Hive-RSI-Lab/hifi-receiver/docs/known-unknowns.md

# Known unknowns: every fact the boards rely on

Generated by `python3 tools/known_unknowns.py` from the first-spin
review (docs/review-2/). `--check` fails while any fact that could stop
a board is neither verified nor resolved; run it before ordering.

**0 open** that could stop a board, of 255 facts.

## Open: could stop a board

| Key | Board | Refs | Fact | Status | Source / how | Date | Stops board |
|---|---|---|---|---|---|---|---|

## Closed or not board-stopping

| Key | Board | Refs | Fact | Status | Source / how | Date | Stops board |
|---|---|---|---|---|---|---|---|
| power:0 | both | U1 | CH224Q/A VHV abs max 32 V, OVR 32-34 V, operating 3.3-30 V | verified | WCH CH224 datasheet V2.0 sec 8.1.1/8.2.1 | 2026-10-28 | no |
| power:1 | lite-main | U1 | CH224A VBUS pin tolerant to 32 V (sec 7.1 says 3.8 V, table 8.1.1 says 32 V) | verified | WCH CH224 datasheet V2.0 (done.land mirror, fetched 2026-10-29): table 4-1 pin 8 VBUS 'needs to be shorted to VHV'; table 8.1.1 VIOHV (PG, VBUS) -0.5..32 V; reference schematic 6.1.1 ties VBUS to VHV. The 3.8 V in sect. 7.1 is in the CH224K-substitution notes and repeats the CFG1 figure: a copy error. Lite runs VBUS at 20 V (37 % under 32 V). | 2026-10-28 | yes |
| power:2 | both | U1 | CH224Q/A pinout VHV1 CFG2 2 CFG3 3 DP4 DM5 CC2 6 CC1 7 VBUS8 CFG1 9 PG10 EP GND | verified | WCH CH224 V2.0 table 4-1; netlists match | 2026-10-28 | yes |
| power:3 | both | R1, R2 | Rset 120k=20 V, 210k=28 V | verified | WCH CH224 V2.0 table 5-1 | 2026-10-28 | yes |
| power:4 | both | U1 | CH224 single-resistor mode selected by CFG1 resistor even when CFG2/CFG3 read low at boot (I2C pull-ups to unpowered +3V3) | resolved | CH224 V2.0 reference schematic 6.1.1 is this exact circuit: Rset on CFG1 with an MCU's I2C on CFG2/CFG3. Contingency on both boards: the I2C links are 0R (Lite R2/R3); depopulated, CFG2/CFG3 float on their internal pull-ups, which 6.1.1 names as the plain single-resistor case. | 2026-10-28 | yes |
| power:5 | both | U1 | CH224 behaviour when requested PDO (20 V / 28 V EPR) not offered (fallback voltage) | unverified | not in datasheet | 2026-10-28 | no |
| power:6 | lite-main | U1, Q4 | CH224A PG asserts only after contract voltage reached and deasserts during hard reset / renegotiation; PG sink current >=1 mA | resolved | Fail-safe by direction: if PG never asserts or can't sink Q4's ~0.35 mA (2.6 V/10k base + VBUS/220k), PVDD simply stays off (no amp, no damage) and firmware reports it (GPIO4 reads PG, GPIO39 reads PVDD). Firmware also drops PVDD before any renegotiation (firmware-requirements L4). Rework: short Q4's emitter pad to the adjacent GND pour. | 2026-10-28 | yes |
| power:7 | both | U1 | CH224 needs no external Rd on CC | verified | WCH CH224 V2.0 fig 6.1.1 reference schematic (no Rd) | 2026-10-28 | yes |
| power:8 | core | Q1 | AO4485 VDS -40 V, VGS +-20 V, Vth -1.7/-1.9/-2.5 V, Ciss 2500 pF, SOA fig 9/10 | verified | AOS AO4485 Rev1.1 Mar 2024 p1-4 | 2026-10-28 | yes |
| power:9 | lite-main | Q1 | UMW AO4485 clone (C5125949) matches AOS ratings/SOA | resolved | With R6 220k + C19 4.7 uF the turn-on peak is 5.8 W for a ~28 ms ramp (sim tb_lite_fw_on_20v_FIX), against the AOS AO4485 single-pulse SOA of about 25 W at 5 ms and 20 W at 10 ms that the power review read (POWER-2/4): >3x margin, so a clone with up to a third less SOA still passes. Steady state 5 A x 15 mohm = 0.38 W. | 2026-10-28 | yes |
| power:10 | both | D1 | SMBJ20A VBR 22.2-24.5 V, Vc 32.4 V; SMBJ30A VBR 33.3-36.8 V, Vc 48.4 V (MDD) | verified | Lite D1 is now SMBJ22A (BORN, LCSC C151920; 2026-10-30): BORN SMBJ series datasheet (datasheet.lcsc.com, productCode=C151920) electrical table row SMBJ22A: VRWM 22 V, VBR 24.4-26.9 V @ 1 mA, Vc 35.5 V @ 16.9 A, IR 1 uA @ VRWM. PD 20 V +5 % = 21 V sits 1 V under VRWM. Core D1 SMBJ30A unchanged (MDD table, VBR 33.3-36.8 V, Vc 48.4 V). | 2026-10-28 | no |
| power:11 | lite-main | U2 | TPS54302 VIN abs 30 V rec 28 V, VFB 0.596 V, tmin_on 110 ns, EN float = on, UVLO 4.1 V | verified | TI SLVSDG6C sec 5.1/5.5/5.6 | 2026-10-28 | yes |
| power:12 | lite-main | U2 | TPS54302 pinout GND1 SW2 VIN3 FB4 EN5 BOOT6 | verified | TI SLVSDG6C pin table; netlist matches | 2026-10-28 | yes |
| power:13 | core | U4 | SY8303 IN/EN abs 40 V, VREF 0.6 V, FS 105/R kHz, min on 80 ns, EN must not float; pinout FB1 FS2 GND3,4 IN5 LX6 BS7 EN8 | verified | Silergy AN_SY8303 Rev0.9A p2-3; netlist matches | 2026-10-28 | yes |
| power:14 | both | U3, U5 | SY8089A1 abs 6 V, rec 2.5-5.5 V, VREF 0.6 V, pinout EN1 GND2 LX3 IN4 FB5 | verified | Silergy AN_SY8089A1 Rev0.0 p2-3 | 2026-10-28 | yes |
| power:15 | both | U4, U6 | LP5907 VIN abs 6 V rec 5.5 V, Cout 0.7-10 uF, SOT-23-5 IN1 GND2 EN3 NC4 OUT5 | verified | TI SNVS798Q sec 6 | 2026-10-28 | yes |
| power:16 | lite-main | U8 | TPA3118 PVCC abs 30 V, rec 4.5-26 V | verified | TI SLOS708G (per LCSC/TI); not re-read in this pass beyond rating | 2026-10-28 | no |
| power:17 | core | U15, U16 | TPA3221 PVDD abs 37 V rec 7-32 V, UVP 6.4 V, no OVP, VDD 5 V bypass mode, no sequencing needed | verified | TI SLASEE9C sec 6.1/6.3/6.5/8.4.1 | 2026-10-28 | yes |
| power:18 | core | U3 | INA186 VCM -0.2..40 V, IN abs 42 V, VS 1.7-5.5 V, DCK pinout REF1 GND2 VS3 IN+4 IN-5 OUT6 | verified | TI SBOS318B sec 5/6.1/6.3 | 2026-10-28 | yes |
| power:19 | core | U17 | TCA9555 had internal I/O pull-ups (IIL -100 uA max); U17 is now a TCA9539 (no pull-ups, 0x74) | verified | TI SCPS200E sec 5, 7.5; SCPS202C | 2026-10-28 | yes |
| power:20 | core | Q2 | 2N7002 (JSCJ) Vth 1.0-2.5 V | verified | JSCJ 2N7002 datasheet | 2026-10-28 | no |
| power:21 | core | D2 | BZT52C33 (BORN) Vz 31-35 V @2 mA; pad 1 = cathode in SOD-123 footprint | verified | BORN BZT52 datasheet table; aiee.pretty SOD-123 silk bar at pad 1 | 2026-10-28 | no |
| power:22 | both | L5, L6, L9, L10 | SWPA4030S4R7MT Isat 2.9 A Irms 2.0 A; SWPA6045S100MT Isat 3.2 A Irms 2.45 A; SWPA4020S2R2NT Isat 3.4 A Irms 1.85 A | verified | Sunlord SWPA4030S spec Rev11 app. A; Sunlord SWPA catalog | 2026-10-28 | no |
| power:23 | both | C7, C8, C13, C14, C10, C3 | MLCC DC-bias: CL21A226MAQNNNE ~50 % at 5 V; CL31A106KBHNNNE ~35-40 % of nominal at 28 V | unverified | engineering estimate; Samsung curves not retrieved | 2026-10-28 | no |
| power:24 | core | C18 | 1 uF 0402 C52923 voltage rating on +5V | unverified | not checked | 2026-10-28 | no |
| power:25 | lite-main | J1 | HRO TYPE-C-31-M-12 rated 20 V / 5 A total VBUS | unverified | LCSC attributes only (datasheet stubbed) | 2026-10-28 | no |
| power:26 | core | J1 | GCT USB4085-GF-A rated 48 V / 5 A, VBUS pins THT | verified | GCT USB4085 drawing rev B (gct.co/files/drawings/usb4085.pdf, fetched 2026-10-30) sheet 1: 48 V DC, 5.00 A collectively for the VBUS pins, 6.25 A for GND, 1.25 A for A5/B5, 240 W. At 28 V / 5 A: 42 % voltage margin, 0 % current margin at the full 5 A PD contract (the governor holds about 1.1 A average). | 2026-10-28 | no |
| power:27 | both |  | USB PD source slew <=30 mV/us; sink cSnkBulkPd <=100 uF; attach always at vSafe5V | unverified | USB PD spec values from memory, not re-read | 2026-10-28 | no |
| power:28 | both |  | 0.3 mm via current ~1-1.5 A; IPC-2152 10 mil 1 oz external ~1 A at 10 C | unverified | brief guideline / IPC-2152 charts from memory | 2026-10-28 | no |
| power:29 | core |  | Core is ordered with 1 oz inner copper, not JLC's 0.5 oz default (35 um in the stackup; R6-M1, fab/ORDERING.md) | verified | core.kicad_pcb stackup | 2026-10-28 | no |
| power:30 | core | Q1, Q3, D5, R404 | PVDD switch Q1 turns off in ~2 ms when Q2 releases (Q3 unit 2 follower + D5 + R404), so a PD hard reset no longer sees PVDD's 940 uF through a still-on Q1: hard_reset source peak 0.7 A (was 14 A), Q1 Tj 120 C (was 426 C) | verified | hwde sim_inrush (branch 261029-050227, 311fc6d) on an electrically equal two-SOT-23 copy of the circuit: hwde's sim reads a dual transistor as unknown, so it can't model the SOT-363 itself | 2026-10-29 | yes |
| audio:0 | lite-main | U8 | TPA3118D2 DAP pin map (MODSEL1 SDZ2 FAULTZ3 RINP4 RINN5 PLIMIT6 GVDD7 GAIN8 ... BSPR30 OUTPR29) matches netlist | verified | TI SLOS708G pin functions p.3-4 | 2026-10-29 | yes |
| audio:1 | lite-main | U8, R50, R51 | TPA3118D2 gain 26 dB master = 20k to GND, 100k to GVDD; Zi 30 kohm +/-20 % | verified | SLOS708G table 1 p.14, 7.3.2 | 2026-10-29 | yes |
| audio:2 | lite-main | U8 | TPA3118D2 MODSEL low = BD, AM2..0=000 = 400 kHz, MUTE low = enabled, PLIMIT=GVDD no limit | verified | SLOS708G pin table, 6.6, 7.3.4 | 2026-10-29 | yes |
| audio:3 | lite-main | U8, R54 | TPA3118D2 SDZ input current at 3.3 V drive (only 50 uA max given) | resolved | R54 100k -> 10k: SDZ sits at 3.2 V - 50 uA x 10k = 2.7 V worst case (TI SLOS708G IIH max 50 uA) against VIH 2.0 V: 0.7 V margin. | 2026-10-29 | yes |
| audio:4 | lite-main | U8, J4 | TPA3118D2 is non-inverting INP->OUTP (absolute polarity at J4) | unverified | SLOS708G does not state polarity | 2026-10-29 | no |
| audio:5 | lite-main | U8, L1, L2, L3, L4 | TPA3118D2 OCP 7.5 A typ; min filter L under short 1 uH | verified | SLOS708G 6.3, 6.6 | 2026-10-29 | yes |
| audio:6 | lite-main | L1, L2, L3, L4 | XR0850-100M: 10 uH, 30 mohm, Isat 8 A, Irated 6.5 A; Isat definition (% drop) unknown | unverified | LCSC C48391614 listing; maker datasheet not read | 2026-10-29 | no |
| audio:7 | lite-main | C68, C69, C70, C71 | CL31B105KBHNNNE 1 uF 50 V X7R 1206 capacitance at 10 V DC (assumed -15 %) | unverified | LCSC C1848 listing; DC-bias curve not read | 2026-10-29 | no |
| audio:8 | lite-main | U7 | ES8388 QFN-28 pin map (LOUT1 12, ROUT1 11, LOUT2 15, ROUT2 14, LIN1 24, RIN1 23, LIN2 22, RIN2 21, VMID 20, ADCVREF 19, VREF 10, CE 26) matches netlist | verified | Everest ES8388 rev 5.0 p.5-6 | 2026-10-29 | yes |
| audio:9 | lite-main | U7 | ES8388 I2C address 0x10 with CE=GND | verified | ES8388 rev 5.0 sec. 5.2 (001000x) | 2026-10-29 | yes |
| audio:10 | lite-main | U7 | ES8388 ADC full scale AVDD/3.3 Vrms, input impedance 20 kohm; DAC out full scale AVDD/3.3 Vrms | verified | ES8388 rev 5.0 analog tables | 2026-10-29 | no |
| audio:11 | lite-main | U7 | ES8388 ADC input select (Reg10 LINSEL) independent of output-mix select (Reg38 LMIXSEL) | verified | ES8388 rev 5.0 6.2.2, 6.3.16 | 2026-10-29 | no |
| audio:12 | lite-main | U7 | ES8388 input pin abs-max and internal bias voltage of LIN2/RIN2 | unverified | not in rev 5.0 text | 2026-10-29 | no |
| audio:13 | both | J2, J5 | Pioneer DDJ-FLX4 MASTER out 2.1 Vrms rated into 10 kohm, output impedance <=1 kohm; true max level above rated unknown | verified | Pioneer DJ launch spec / B&H listing (web, 2026-10-29) | 2026-10-29 | no |
| audio:14 | core | U15, U16 | TPA3221 DDV pin map (VDD1 GAIN2 OTW3 FAULT4 IN1P8 IN1M9 RESET10 HEAD11 OSCM12 OSCP13 FREQ14 IN2P15 IN2M16 CMUTE17 AVDD21 GVDD22 BST/OUT/PVDD) matches symbol names | verified | TI SLASEE9C fig 5-1, table 5-1 | 2026-10-29 | yes |
| audio:15 | core | U15, U16 | TPA3221 gain/controller table: 20k/100k controller 24 dB, 75k/47k peripheral 24 dB; RIN 24 kohm | verified | SLASEE9C table 8-1, 6.5 | 2026-10-29 | yes |
| audio:16 | core | U15, U16, R216, R217, R315 | TPA3221 controller needs 47k pull-up OSCM to AVDD and 47k pull-down OSCP; peripheral FREQ_ADJ to AVDD; same-polarity OSC = peripheral 1 | verified | SLASEE9C 8.3.2, 8.3.4, 6.3 | 2026-10-29 | yes |
| audio:17 | core | U15, U16, U11 | TPA3221 inverts input to output | verified | SLASEE9C 9.2.1.2, 6.5 | 2026-10-29 | no |
| audio:18 | core | U15, U16 | TPA3221 LDO-bypass VDD/AVDD/GVDD 4.5-5.5 V; IGVDD 16 mA | verified | SLASEE9C 6.3, 6.5 | 2026-10-29 | yes |
| audio:19 | core | U15, U16 | TPA3221 OC limit 10 A typ (no min/max); min L at IOC 5 uH | verified | SLASEE9C 6.5, 6.3 | 2026-10-29 | yes |
| audio:20 | core | U15, U16 | TPA3221 thermal pad location for DDV (datasheet text says both top and bottom) | verified | TI SLASEE9C (rev. May 2025) section 5 and the pin table: the DDV PowerPAD is on the top side, 'connect to grounded heatsink'; RthJA 44.8 C/W without one (DFM-3, THERMAL-1). The 'pad on bottom' feature bullet contradicts the drawing and pin table. Handled by the lid-pressed heatsink (docs/review-2/dispositions.json THERMAL-1). | 2026-10-29 | yes |
| audio:21 | core | U15, U16 | TPA3221 single-ended gain equals differential gain (IN_M AC-grounded) | unverified | SLASEE9C table 8-1 input-level columns are inconsistent | 2026-10-29 | no |
| audio:22 | core | L1, L2, L3, L4, L5, L6, L7, L8 | PSPMAA0805-100M-ANP: 10 uH, 30 mohm, Isat 10 A, Irated 6 A; Isat definition unknown | unverified | LCSC C2962885 listing | 2026-10-29 | no |
| audio:23 | core |  | CL21B105KBFNNNE 1 uF 50 V X7R 0805 at 14 V DC (assumed -40 %) | unverified | LCSC C28323 listing; DC-bias curve not read | 2026-10-29 | no |
| audio:24 | core | U10 | ES9018K2M package QFN-28 5x5 0.5 mm, EP 3.25; PCB footprint matches | verified | ESS ES9018K2M ds v3.7 p.36-37; core.kicad_pcb U10 pads | 2026-10-29 | yes |
| audio:25 | core | U10 | ES9018K2M pin map (DACR 9, DACRB 10, DACL 13, DACLB 14, AVCC 15/16, VCCA 17, DVCC 18, DVDD 21, DATA2/1/CLK 25/26/27, RESETB 28) matches netlist | verified | ES9018K2M v3.7 p.4 | 2026-10-29 | yes |
| audio:26 | core | U10 | ES9018K2M I2C 0x48 (ADDR=0) | verified | ES9018K2M v3.7 p.27 | 2026-10-29 | yes |
| audio:27 | core | U10, Y1 | ES9018K2M max MCLK 50 MHz with internal DVDD | verified | ES9018K2M v3.7 p.9, p.31 note 2 | 2026-10-29 | no |
| audio:28 | core | U10, U11 | ES9018K2M voltage-mode output: 3.05 Vpp/leg, 1.65 V offset, 806 ohm +/-11 % | verified | ES9018K2M v3.7 p.31 | 2026-10-29 | yes |
| audio:29 | core | U10 | ES9018K2M register setup (I2S 32-bit, ASRC, soft_start, volume) works with ESP32 I2S at 50 MHz MCLK | resolved | Firmware's (C7): the register set is written over I2C after boot and can be changed by OTA; the hardware (I2S at 49.152 MHz MCLK, 1.7 % under the limit) fits ESS's documented modes. | 2026-10-29 | yes |
| audio:30 | core | U11 | OPA1678 single-supply 4.5-36 V, VCM (V-)+0.5..(V+)-2, VO within 0.8 V of rails | verified | TI SBOS855E 6.3, 6.7 | 2026-10-29 | no |
| audio:31 | core | U12 | PCM5102A pins FLT/DEMP/FMT low, SCK=GND 3-wire PLL, XSMT mute, caps 2.2 uF | verified | TI SLAS859C pin table, fig 33 | 2026-10-29 | yes |
| audio:32 | core | U12 | PCM5102A DIN on ESP32 IO12 (MTDI strap) is not pulled high at boot | resolved | PCM5102A DIN is a plain high-impedance CMOS input (TI SLAS859 pin table: no internal pull); with its +-10 uA max leakage against the ESP32's ~45k IO12 pull-down at reset, IO12 sits at <=0.45 V, under VIL 0.825 V: the strap reads low (3.3 V flash). | 2026-10-29 | yes |
| audio:33 | core | U13 | ES7243E pin map and I2C address 0x10 (0010 AD2 AD1 AD0) | verified | Everest ES7243E rev 5.0 pin table, I2C section | 2026-10-29 | yes |
| audio:34 | core | U13 | ES7243E can run with MCLK pin grounded, clock from SCLK (MCLK_SEL) | resolved | ES7243E BCLK-as-MCLK (register 0x02 bit 7) is set by firmware (C10). If it didn't work, only the line-in/self-measurement ADC would be lost; streaming to the DAC and amps doesn't use it. Bring-up checks the ADC first thing. | 2026-10-29 | yes |
| audio:35 | core | U13 | ES7243E full scale 1 Vrms, input 8 kohm at 0 dB PGA (per pin vs differential unclear) | unverified | ES7243E rev 5.0 analog table | 2026-10-29 | no |
| audio:36 | core | U14 | TS5A23157 pin map, function table (IN H = NO), VIH 0.7*V+, range 0..V+ | verified | TI SCDS165F pin functions, 6.5, table 1 | 2026-10-29 | yes |
| audio:37 | core | Q6 | S8050 Q6 SOT-23 pin order B/E/C matches symbol | verified | Parts review (docs/review-2/parts.md, 2026-10-29): every SOT-23 transistor checked datasheet pin -> symbol -> pad; S8050 (C2146) B=1, E=2, C=3 matches. | 2026-10-29 | yes |
| audio:38 | core | U1 | CH224 PD fallback to 20 V when 28 V EPR is unavailable (sets amp headroom) | unverified | power reviewer | 2026-10-29 | no |
| audio:39 | both |  | Loopback taps not yet in the schematics (reviewed from remote.md design text) | unverified | remote.md 'The board measures its own output' | 2026-10-29 | no |
| digital:0 | core | U17 | TCA9555 has 100k internal pull-ups and all P-ports are inputs at POR; no RESET pin | verified | TI SCPS200E s5, Fig 23, pin table | 2026-10-28 | yes |
| digital:1 | core | U17 | TCA9539 is pin-compatible with TCA9555 except pin 3 = RESET; no pull-ups; address 0x74-0x77 | verified | TI SCPS202C pin table, s8.3.2, Table 2 | 2026-10-28 | no |
| digital:2 | core | Y1, Y2 | YSO110TR OE: enable >=70% VDD or floating, disable <=30% VDD, start-up 3 ms max; internal OE pull-up value | resolved | R45 is now 2.2k: OE stays under 30 % VDD (0.99 V) against any internal OE pull-up of 5.1k or more (oscillator OE pull-ups are typically ~100k); the TCA9539 that drives it has no pull-up and resets with EN. Bring-up scopes IO0 at EN rise. | 2026-10-28 | yes |
| digital:3 | both | U5, U7 | ESP32 straps latched at system reset; GPIO0=0 & GPIO2=0 = download; tH >= 1 ms | verified | ESP32-WROVER-E datasheet v2.4 s4 Tables 4-6 | 2026-10-28 | yes |
| digital:4 | core | U13 | ES7243E default slave (reg0x00 MSC=0); MCLK can be derived from BCLK (reg0x02 bit7); I2C address 0x10 with AD2..0 = 0 | verified | Everest ES7243E datasheet rev 2.0 (June 2019) s4, s7 reg 0x00/0x02 | 2026-10-28 | no |
| digital:5 | core | U10 | ES9018K2M I2C address 0x48 (ADDR=0), DATA_CLK=BCK, DATA1=LRCK, DATA2=SDATA, MCLK > 192*FSR | verified | ESS ES9018K2M datasheet v3.7 (2021-04-22) | 2026-10-28 | yes |
| digital:6 | both | U1 | CH224Q/CH224A 7-bit I2C address 0x22 or 0x23; I2C active in single-resistor (CFG1) mode; CFG2/CFG3 internal pull-ups, 3.3/5 V tolerant | verified | WCH CH224 datasheet v2.1 s5.2.3, pin table | 2026-10-28 | no |
| digital:7 | both | U6, U8 | CH340C at 3.3 V: V3 tied to VCC; D+/D- direct, no series resistor | verified | WCH CH340 datasheet V3D pin table and s5 | 2026-10-28 | no |
| digital:8 | core | U9 | LAN8720A straps: PHYAD0 PD (addr 0), REGOFF PD (regulator on), nINTSEL PU (REF_CLK in), MODE[2:0] PU = 111; tpurstd 25 ms; CLKIN +/-50 ppm, 150 ps p-p jitter | verified | Microchip DS00002165B pin tables, Table 5-8, REF_CLK IN timing | 2026-10-28 | yes |
| digital:9 | both | U5, U7 | ESP32 GPIO36/39 80 ns pull-down glitch on ADC power-up | verified | ESP32 errata v3.1 s3.12 [GPIO-3.11] | 2026-10-28 | no |
| digital:10 | core | U15, U16 | TPA3221 RESET VIH 1.9 V / VIL 0.8 V, so the 1.65 V TCA9555 divider is undefined | verified | TI SLASEE9C (May 2025) electrical characteristics | 2026-10-28 | no |
| digital:11 | core | U17 | LCSC part number for TCA9539PWR | unverified |  | 2026-10-28 | no |
| digital:12 | both | U5, U7 | squeezelite.bin 2.69 MB / recovery.bin 1.38 MB (IDF 4.4.8 build) image sizes | unverified | firmware/README.md l.65 on origin/hive/261028-165619-70c34f28b3 (claim, not rebuilt by me) | 2026-10-28 | no |
| digital:13 | core | U10 | ES9018K2M GPIO2 can be a static output (reg 8 gpio2_cfg 4'd7/4'd15), tri-stated while RESETB low; VOH >= DVCC-0.2 at 100 uA | verified | ESS ES9018K2M datasheet v3.7 (2021-04-22) Register #8, Standby Mode, DC characteristics | 2026-10-28 | no |
| digital:14 | core | U14 | TS5A23157 VIH = 0.7*V+ (3.5 V at 5 V supply) | verified | TI SCDS165F (Jan 2019) electrical characteristics, 5-V supply | 2026-10-28 | no |
| digital:15 | core | U10 | ES9018K2M register access over I2C requires MCLK running | unverified | community reports; not stated in ds v3.7 | 2026-10-28 | no |
| digital:16 | both | U6, U8 | CH340B SOP-16 pinout: 7 = RST# (internal pull-up), 8 = NC, 15 = TNOW output; otherwise = CH340C; no crystal | verified | WCH CH340 datasheet V3D s4, s5.1 | 2026-10-28 | yes |
| digital:17 | both | U6, U8 | C81010 is CH340B SOP-16 (stock 4627); C84681 CH340C stock 109248 | verified | LCSC wmsc product API 2026-10-28 | 2026-10-28 | no |
| digital:18 | both | Q2, Q3, Q4, Q5 | Auto-program circuit (DevKitC cross-coupled NPNs) wired correctly on both boards | verified | lite-main.net, core.net vs Espressif DevKitC schematic topology | 2026-10-28 | yes |
| digital:19 | both | C22, C32 | ESP32 EN recommended RC 10k/1uF; VIL_nRST 0.6 V, VIH_nRST 0.75 VDD, tSTBL/tRST 50 us | verified | ESP32 Series datasheet v5.3 Table 2-4, Table 5-3 | 2026-10-28 | no |
| digital:20 | lite-main | U5 | Lite firmware pin map (dac_config, buttons, IR, LED, PD_PG 4, PVDD_EN 18, SDZ 21, FAULTZ 23, ADC GPIO34) matches lite-main.net | verified | firmware branch 261028-165619 hifi_board.h + patch Kconfig vs lite-main.net | 2026-10-29 | yes |
| digital:21 | lite-main | U7, U5 | squeezelite-esp32 ee1720c supports ES8388 model and MCLK on GPIO0 from APLL (use_apll=true) | verified | github sle118/squeezelite-esp32@ee1720c components/squeezelite/output_i2s.c l.302, l.363-370; README l.206-210 | 2026-10-29 | yes |
| digital:22 | lite-main | U7 | ES8388 7-bit I2C address 0x10 with CE=GND | verified | Everest ES8388 datasheet rev 5.0 (July 2018) sect. 5.2: 2-wire chip address 001000x, x = AD0 (the CE pin): 0x10 with CE (pin 26) on GND, as Lite wires it. Fetched 2026-10-29. | 2026-10-29 | yes |
| digital:23 | lite-main | U8 | TPA3118 SDZ VIH 2 V, IIH <= 50 uA, slew <= 10 V/ms | verified | TI SLOS708G s6.1, s6.3 | 2026-10-29 | yes |
| digital:24 | lite-main | U9 | IRM-3638T supply range 2.7-5.5 V | unverified | LCSC C42421366 has no datasheet link; inferred from IRM-H638T (C91447, 2.7-5.5 V) | 2026-10-29 | no |
| digital:25 | both | U5, U7 | WROVER-E N8R8 flash/PSRAM 3.3 V; MTDI internal pull-down, so VDD_SDIO 3.3 V | verified | ESP32-WROVER-E ds v2.4 Table 1, Table 4; ESP32 ds v5.3 s3.2 | 2026-10-29 | yes |
| digital:26 | core | U7, U9 | ESP32 EMAC fixed pins TXD0 19, TX_EN 21, TXD1 22, RXD0 25, RXD1 26, CRS_DV 27, REF_CLK GPIO0 (in) match core.net | verified | squeezelite README@ee1720c l.506-518; ESP32-WROVER-E ds v2.4 pin table (EMAC_RX_DV on IO27) | 2026-10-29 | yes |
| digital:27 | core | U7 | squeezelite-esp32 supports LAN8720 RMII, pca9535-class expanders (buttons, rotary, outputs), generic I2S + dac_controlset; no line-in capture; one I2S data output | verified | squeezelite-esp32@ee1720c README l.21-23, 204-228, 323-341, 504-526; output_i2s.c; gpio_exp.c l.114 | 2026-10-29 | no |
| digital:28 | core | J3 | squeezelite display_config accepts cs=-1 | unverified | README l.261 shows cs as mandatory | 2026-10-29 | no |
| digital:29 | core | U17 | squeezelite eth rst on an expander GPIO is not supported | verified | README@ee1720c l.341 | 2026-10-29 | no |
| digital:30 | core | J3 | Front-panel FFC carries IR_IN, I2C, EXP_INT, ENC_A/B: panel contents (extra IR receiver, I2C devices/pull-ups) unknown | verified | boards/ultra-front/README.md: the panel carries one TCA9535 (0x27) for the knob, buttons, LCD reset and RGB LED, its own IR receiver on IR_OUT (10 k pull-up there), INT open-drain with a 10 k pull-up there, ENC_A/B with 10 k + 10 nF; I2C pull-ups are on the core. | 2026-10-29 | no |
| digital:31 | core | U12 | PCM5102A PLL BCK ratios 32/48/64 fs with SCK grounded | unverified | TI SLAS859 (not re-read this session) | 2026-10-29 | no |
| digital:32 | both | U5, U7 | WROVER-E antenna region about 7 mm at the pin-1 end of the 31.4 mm module; Espressif clearance rules (overhang, or <=1 mm inset and >=15 mm cleared along the edge; 15 mm to the housing) | verified | ESP32-WROVER-E ds v2.4 Fig 5/s10.1; ESP Hardware Design Guidelines ESP32 (release master) s1.4.8 Fig 23, 25 | 2026-10-29 | yes |
| digital:33 | both | U5, U7 | core has copper under the antenna on all 4 layers; lite has none (ANT_KEEPOUT) | verified | pcbnew 10.0.6 zone-fill sampling of lite-main.kicad_pcb and core.kicad_pcb | 2026-10-29 | yes |
| digital:34 | core | U7 | ESP32 EMAC RMII input setup/hold times | unverified | not published in ESP32 datasheet v5.3 | 2026-10-29 | no |
| digital:35 | core | U9 | LAN8720A RMII output clock-to-out min about 2 ns | unverified | DS00002165B RMII timing table (not re-extracted) | 2026-10-29 | no |
| digital:36 | core | J3 | Front-panel I2C load (devices, pull-ups, capacitance) on J3 | verified | boards/ultra-front/README.md: one I2C device on the panel (TCA9535 at 0x27), no pull-ups there (the core's), over a 30-50 mm FFC: a few pF added to the bus. | 2026-10-29 | no |
| digital:37 | both | U1 | CH224 CFG2/CFG3 internal pull-up rail voltage | unverified | CH224 ds v2.1 says 3.3/5 V input tolerant, rail not stated | 2026-10-29 | no |
| digital:38 | core | U19 | PLR237/T8BK supply range and output level at 3.3 V | verified | Everlight PLR237/T8BK DPL-0000262/263 Rev.1 (everlighteurope.com, fetched 2026-10-30) p1-2: operates at 2.4-5.5 V, recommended Vcc 3.0-5.5 V, TTL-compatible output (Vout max Vcc+0.3), so at OPT_VCC = 3.3 V the output swings to 3.3 V into the ES9018K2M GPIO; 10 % margin at the 3.0 V floor. | 2026-10-29 | no |
| digital:39 | core | U18 | IRM-H638T 2.7-5.5 V, 1.2 mA | verified | LCSC C91447 product data (Everlight DMO-0000008) | 2026-10-29 | no |
| digital:40 | core | U2 | USBLC6-2SC6 pinout 1/6 I/O1, 3/4 I/O2, 2 GND, 5 VBUS | unverified | ST USBLC6-2 datasheet (not re-read; matches the common pinout) | 2026-10-29 | no |
| digital:41 | core | Y1, Y2 | YXC OT322550MJBA4SL 50 MHz +/-10 ppm CMOS 1.8-3.3 V, pin 1 OE, pin 3 OUT | verified | LCSC C717684 + YXC YSO110TR datasheet p1-2 | 2026-10-29 | yes |
| thermal:0 | core | U15, U16 | TPA3221DDV (C475500) thermal slug is on the TOP of the package | verified | True of the TPA3221 (SLASEE9C sec 5). The board now carries the TPA3220DDW (C2879306), whose pad is on the bottom (SLASEN3B sec 6, pin table), so the top-slug problem is gone (task 261029-075354). | 2026-10-28 | yes |
| thermal:1 | core | U15 | TPA3221 RthetaJA 44.8 C/W (JEDEC 2s2p, no heatsink), RthetaJC(top) 1.1, psiJB 14.7, 5.5 C/W to 85 C heatsink | verified | TI SLASEE9C 6.4 p6 | 2026-10-28 | yes |
| thermal:2 | core | U15 | TPA3221 OTW 115/125/135 C, OTE 145/155/165 C, OTE latched (RESET toggle) | verified | TI SLASEE9C 6.5 p9, 8.4.5.5 | 2026-10-28 | yes |
| thermal:3 | core | U15, U16 | Thermal resistance of a 19x12x25 mm finned heatsink in the (not yet designed) core enclosure ~20-25 C/W | resolved | Moot: there is no heatsink since the TPA3220 swap (task 261029-075354). The board's ~26 C/W is the figure, and bring-up C3 measures it. OTW (P11), FAULT (P10) and the ISENSE governor (C2) still bound a hot amp. | 2026-10-28 | yes |
| thermal:4 | core | U15, L1, L2, L3, L4 | TPA3221 chip loss split from fig 6-9 system loss (inductor share ~1.5 W at 20 W out) | resolved | Covered by the same OTW/governor backstop (thermal:3); the governor limit (30 W in per chip) holds chip loss to ~3 W whatever the split. | 2026-10-28 | yes |
| thermal:5 | lite-main | U8 | TPA3118D2 DAP RthetaJA 22 C/W on TPA3118D2EVM; psiJB 4.7; thermal trip 150+ C, 15 C hysteresis, OTP latched | verified | TI SLOS708G 6.4, 6.6, 7.3.8 table | 2026-10-29 | yes |
| thermal:6 | lite-main | U8 | TPA3118D2EVM is a 2-layer board with ~32 thermal vias | verified | TI SLOU342A sec 3.2 figs 4-5 (layer count); via count read from the image, approximate | 2026-10-29 | no |
| thermal:7 | lite-main | U8 | TPA3118D2 DAP exposed pad 2.46-3.04 x 3.16-3.74 mm fits the 3.81x3.71 land; paste 4x1.4x1.4 mm | verified | TI SLOS708G DAP0032C drawing; lite-main.kicad_pcb | 2026-10-29 | yes |
| thermal:8 | lite-main | U8 | Lite U8 thetaJA in the box 25-30 C/W (16 vias, 1 oz 2-layer) | resolved | Margin holds even at hwde's pessimistic 47 C/W: 1.75 W at 1/8 power into 4 ohm gives Tj = 45 + 82 = 127 C, 23 K under the 150 C trip (reviewer's own estimate 94-106 C). Above that, the firmware governor (firmware-requirements L1) and the chip's own latched OTP with FAULTZ recovery (L2) protect it: the failure mode is a mute, not damage. Bring-up measures the case temperature at 1/8 power. | 2026-10-29 | yes |
| thermal:9 | lite-main | U8 | TPA3118D2 chip loss 1.75 W at 1/8 P 4 ohm, 20 V | unverified | SLOS708G fig 16 is at 24 V; 20 V interpolated | 2026-10-29 | no |
| thermal:10 | core | U15 | TPA3221 idle: PVDD 11 mA AD at 28 V, GVDD 16 mA, AVDD 10 mA | verified | SLASEE9C 6.5 p7, fig 6-16 | 2026-10-29 | no |
| thermal:11 | core | U15, U16 | Core box air temperature (enclosure not designed) | resolved | The Plus/Ultra enclosure is designed (enclosure/, vents over and under each amp). With the TPA3220 the board sheds the amps' heat into that air. 45 C box air is the design case, and bring-up C3 measures it. The OTW/governor backstop applies. | 2026-10-29 | yes |
| thermal:12 | lite-main |  | Lite box internal air rise 22 K at 1/8 P (G = 0.16 W/K) | unverified | my wall/vent model, +/-30 %; measure with a probe | 2026-10-29 | no |
| thermal:13 | lite-main | U2 | TPS54302 RthetaJA 118.9 C/W, TJ 125 C | verified | TI SLVSDG6C 5.4 | 2026-10-29 | no |
| thermal:14 | core | U4 | SY8303 thetaJA 60.2 C/W, TJ 150 C, Vin 4.5-40 V, RDS 110/70 mohm | verified | Silergy SY8303 datasheet (LCSC C97054) abs max, elec. char. | 2026-10-29 | no |
| thermal:15 | both | U3, U5 | SY8089 thetaJA 120 C/W, TJ op 125 C | verified | Silergy SY8089A1 datasheet (LCSC C479074) | 2026-10-29 | no |
| thermal:16 | both | U4, U6 | LP5907 DBV RthetaJA 193.4 C/W, TJ op 125 C | verified | TI SNVS798Q 5.4 | 2026-10-29 | no |
| thermal:17 | both | U4, U6 | LP5907 +3V3A load currents (ES8388 ~25 mA; ES9018K2M/ES7243E ~50 mA) | unverified | not computed from codec datasheets in this review | 2026-10-29 | no |
| thermal:18 | core | U4 | SY8303 5 V load 0.35 A avg / 0.6 A peak | unverified | my estimate; power reviewer's budget | 2026-10-29 | no |
| thermal:19 | both | Q1 | AO4485 RDS(on) 12.5 mohm @-10 V (UMW C5125949); 15 max @25 C, 23 max @125 C (AOS C51499); RthetaJA 75 C/W steady | verified | LCSC C5125949 record; AOS AO4485 DS | 2026-10-29 | no |
| thermal:20 | lite-main | Q1 | Lite Q1 VGS = -6.25 V at 20 V (R5 100k / R6 220k) | verified | root.py values, divider calc | 2026-10-29 | no |
| thermal:21 | core | Q1 | Core Q1 VGS = -14 V at 28 V (R4/R5 100k, D4 15 V) | verified | blocks.py values | 2026-10-29 | no |
| thermal:22 | core | R1 | R1 RLP25FEGR010 2512 rated 3 W | verified | LCSC C393070 (TA-I) | 2026-10-29 | no |
| thermal:23 | lite-main | L1, L2, L3, L4 | XR0850-100M Irms 6.5 A at dT~40 C, Isat 8 A, DCR 30 mohm, part temp <=125 C | verified | XR XR0850 DS notes 3,5 (LCSC C48391614) | 2026-10-29 | no |
| thermal:24 | core | L1, L2, L3, L4 | PSPMAA0805-100M Irms 6 A at dT~40 C, Isat 10 A, DCR 30 mohm | verified | PROD PSPMAA DS / LCSC C2962885 | 2026-10-29 | no |
| thermal:25 | core | L1, L2, L3, L4 | Output inductor core loss at 600 kHz AD-mode ripple | unverified | not in datasheet | 2026-10-29 | no |
| thermal:26 | lite-main | C58 | C58 MA35V470M10X13 3.8 A@100 kHz, 16 mohm, 2000 h@105 C | verified | JIERR DS / LCSC C46550472 | 2026-10-29 | no |
| thermal:27 | lite-main | C59 | C59 RVT 220 uF 35 V 195 mA@120 Hz, 2000 h@105 C, ESR not specified | verified | KNSCHA RVT spec (LCSC C2836441) | 2026-10-29 | no |
| thermal:28 | core | C5, C6, C311 | C5/C6 Rubycon 50PX470MEFC10X20: 600 mA@120 Hz, x1.20 at >=10 kHz, tan d 0.10, 2000 h@105 C | verified | Rubycon PX DS (LCSC C88733) | 2026-10-29 | no |
| thermal:29 | both | C58, C5, C6 | PVDD ripple current estimate (Iout,rms x sqrt(1-0.75 m^2) per BTL channel; 0.5 only at full swing) and its split between ceramics and bulk (docs/review-6/c5c6_ripple.py) | unverified | approximation; SPICE of the amp's PVDD current not run | 2026-10-29 | no |
| thermal:30 | lite-main | D1 | SMBJ20A leakage at 21 V and 60 C | resolved | Fixed in the design 2026-10-30: D1 SMBJ22A (VRWM 22 V), so the 21 V worst-case rail is below standoff and IR <= 1 uA at 25 C (BORN table); the SMBJ20A's above-VRWM leakage question no longer arises. | 2026-10-29 | no |
| thermal:31 | both | U5, U7 | ESP32-WROVER-E-N8R8 -40..85 C ambient | verified | LCSC C2973667 record (Espressif) | 2026-10-29 | no |
| thermal:32 | both | U6, U8 | CH340C operating -20..70 C | verified | WCH CH340 DS operating temperature table (LCSC C84681) | 2026-10-29 | no |
| thermal:33 | lite-main |  | PETG Tg ~80 C, PLA softening 55-60 C | unverified | general material data, not a filament datasheet | 2026-10-29 | no |
| thermal:34 | core | U15, U16 | Heatsink part fitting 19x12 mm with RthetaSA <=20 C/W | resolved | Resolved (task 261029-075354, issue #47): U15/U16 are now the pin-identical pad-down TPA3220DDW (C2879306; TI SLASEN3B table 5 'TPA3221 ... Top ... Y'). Its EP is soldered to GND on a 7.3 x 4.43 mm land with 15 x 0.3 mm vias into In1/B.Cu, so nothing is fitted by hand. On-board RthJA is about 26 C/W (JEDEC 23.5), so 1/8 power into 8 ohm runs at Tj about 84 C. Into 4 ohm, the C2 governor holds the chip near 2.5 W (16 W in, 60 s). LCSC stock is 0, so it is bought into the JLC inventory from Mouser/DigiKey (fab/prebuy.csv). See docs/review-2/heatsink-options.md. | 2026-10-29 | yes |
| thermal:35 | core | U15 | TPA3220DDW pin-compatible pad-down alternative | verified | SLASEE9C table 4 (pin-compatible Y, pad bottom); LCSC C2879306 stock 0 on 2026-10-28 | 2026-10-29 | no |
| thermal:36 | core | U15, U16 | TPA3220 RthetaJA 23.5 C/W (JEDEC 2s2p, pad soldered), RthetaJC(bot) 1.1, RthetaJB 4.5, psiJB 4.5; OTW 115/125/135 C, OTE 145/155/165 C | verified | TI SLASEN3B 7.4, 7.5 | 2026-10-29 | yes |
| thermal:37 | core | U15, U16 | On core (1 oz / 0.5 oz) the TPA3220's RthetaJA is about 26 C/W. In the vented Plus/Ultra box (air ~58 C at 30 C room, hwde check_thermal) each chip holds ~2.0 W at Tj 110 C: Plus (one channel per chip) 9.6 W/ch into 4 ohm and 14.8 W/ch into 6 ohm sustained, Ultra both zones 4.4 W/ch into 4 ohm; the C2 governor holds it (Plus 19 W, Ultra 9/17 W over 60 s) | unverified | estimate: JEDEC 23.5 C/W +10 % for thinner copper and a shared board (docs/review-2/heatsink-options.md); bring-up C3 measures it; OTW/FAULT and the governor backstop it | 2026-10-29 | no |
| dfm:0 | both | J2, J3, J4, J5 | XDJK-0271-1650 pin hole positions match EasyEDA land pattern (pins 1/3 rows 0.8 mm apart) | resolved | Pins 1/3 are now 1.6 x 2.4 mm plated slots centred between the two readings of the drawing (0.28 mm to spare at the pin corners either way), legs 2.0 x 3.0 as drawn, on both boards. | 2026-10-28 | yes |
| dfm:1 | both | J2, J3, J4, J5 | XDJK-0271-1650 needs 2 post holes 2.0x3.0 | verified | Lian Xin A-AV2-7A1 '2-2X3' | 2026-10-28 | yes |
| dfm:2 | core | U15, U16 | TPA3221 DDV thermal pad is on top and needs a grounded heatsink | verified | True of the TPA3221, which the board no longer uses. U15/U16 are the TPA3220DDW, with the pad on the bottom (SLASEN3B pin table: 'PowerPad ... Placed on bottom side of device'). It is soldered to GND with no heatsink (task 261029-075354). | 2026-10-28 | yes |
| dfm:3 | core | U18 | IRM-H638T pinout 1 GND,2 GND,3 OUT,4 Vcc; top-looking lens | verified | Everlight DMO-0000008 rev3 p1,p6 | 2026-10-28 | no |
| dfm:4 | core | U18 | Plus enclosure lid height above U18 | unverified | no core enclosure in enclosure/ | 2026-10-28 | no |
| dfm:5 | both | J1 | USB4105 footprint matches GCT USB4105 rev B4 layout (pegs, tabs, pads, 4.18/3.68) | verified | GCT USB4105 drawing rev B4 18/12/23 + KiCad lib | 2026-10-28 | yes |
| dfm:6 | core | J1 | USB4085 recommended layout: 0.40 drill/0.65 pad, 0.85 pitch, rows 1.35, shell 8.65, edge 1.74 from rear slots | verified | GCT USB4085 rev B 28/02/23 sheet 2 | 2026-10-28 | yes |
| dfm:7 | core | J1 | USB4085 new footprint as drawn by the worker | verified | GCT USB4085 drawing rev B (gct.co/files/drawings/usb4085.pdf, fetched 2026-10-30) sheet 2 against core.kicad_pcb J1, pad by pad: A row A1 A4..A9 A12 and B row B12 B9..B4 B1 (B12 under A1) 1.35 apart at 0.85 pitch, within 0.005 mm of the drawing; shell slots 0.6x2.1 / 0.6x1.4 in 0.9x2.4 / 0.9x1.7 at +-4.325, the long pair 0.98 from the A row and the short pair 3.38 behind it; the board edge (x 34.587) sits exactly 1.74 mm from the short pair's centres (x 36.327), as drawn. Not mirrored: A1 left with the mouth down, as the drawing's component-side view. Nets as sheet 1: VBUS A4 A9 B4 B9, GND A1 A12 B1 B12 and shell, CC1 A5, CC2 B5, D+ A6 B6, D- A7 B7, SBU open. Only the pads differ, 0.70 for 0.65, on purpose (DFM-6). | 2026-10-28 | yes |
| dfm:8 | lite-main | J1 | HRO TYPE-C-31-M-12 layout: pads 1.15 long y-1.64..-0.50 from pegs, pegs 0.60 at +-2.89, slots 0.6x1.7/0.6x1.4 4.18 apart, edge 5.79 from pegs | verified | HRO drawing rev A 2020-12-08 | 2026-10-28 | yes |
| dfm:9 | lite-main | J1 | HRO TYPE-C-31-M-12 new footprint as drawn by the worker, and its CPL rotation | resolved | Lite J1 HRO TYPE-C-31-M-12 (C165948): footprint from EasyEDA (lib_pull 2026-10-29), its VBUS/GND pads redrawn as plain 0.6 x 1.3 mm rectangles (EasyEDA's 0.1 mm stroke left a 0.1 mm VBUS-GND gap) and its signal pads trimmed to 1.13 mm at the tail end (the USB4105's inner edge); shell legs 0.8 mm slots as HRO draws them. CPL: hwde cpl_verify against the LCSC model passes in the dfm gate (2026-10-29), no offset warning. | 2026-10-28 | yes |
| dfm:10 | core | J1 | JLC can assemble USB4085 (THT) - hand/selective solder, per-joint fee | unverified | JLC THT assembly service; part listed Plugin/Extended stock 2623 (parts_search 2026-10-29) | 2026-10-28 | no |
| dfm:11 | both | U6, U8 | CH340B EasyEDA model pin1/centre same as CH340C -> CPL rotation unchanged | verified | EasyEDA C81010 vs C84681 models fetched 2026-10-29 | 2026-10-28 | yes |
| dfm:12 | both |  | JLC capabilities (via, annulus, slot, mask bridge, silk, edge, panel) | verified | jlcpcb.com/capabilities/pcb-capabilities fetched 2026-10-28 | 2026-10-28 | no |
| dfm:13 | both |  | Min mask web Lite 0.20 / core 0.176 vs JLC 0.10 | verified | own Gerber read sims/dfm/gerb.py | 2026-10-28 | no |
| dfm:14 | both |  | ENIG surcharge for these sizes | unverified | JLC quote page not fetched | 2026-10-28 | no |
| dfm:15 | core | U19 | PLR237/T8BK footprint: 3x0.80 at 2.54, 2x1.10 at 5.08 (2.63), 2x1.70 posts at 5.60 (2.61) | verified | Everlight DPL-0000263 rev1 p5 | 2026-10-28 | yes |
| dfm:16 | core | U19 | TOSLINK port faces the top edge and NC row is nearer the front (physical pin orientation) | verified | Everlight PLR237/T8BK DPL-0000262/263 Rev.1 (everlighteurope.com, fetched 2026-10-30) p5 (third-angle views: the top view above, the port at the left of the right view): the posts are 5.88 from the port face, then 2.61 to the NC row and 2.63 to the signal row. On core U19 (rot 180) the port faces the top edge (the rear panel), the post holes and NC row sit between it and the signal row, and the port face lands at y 121.397, 0.70 mm inside the edge, as enclosure/core.board.json has it. | 2026-10-28 | yes |
| dfm:17 | core | J2 | HR911105A footprint matches HanRun layout (pegs 3.25, shield 1.63, signal 0.89, LED 1.02, 11.43/15.49/13.25 spacing) | verified | HanRun HR911105A rev A/2 p3 | 2026-10-28 | yes |
| dfm:18 | core | J6 | KF301-5.0 rating 300V/16A UL, 22-14 AWG | verified | KEFA KF301-5.0 rev A | 2026-10-28 | no |
| dfm:19 | both | J4 | DB128V-5.08 rating 300V/16A UL, 12-22AWG, hole 1.6 | verified | Dorabo DB128V-5.08 T0-1 | 2026-10-28 | no |
| dfm:20 | both | U9 | IRM-3638T pinout 1 OUT 2 GND 3 Vcc | verified | Everlight DMO-0000371 rev4 p1 | 2026-10-28 | yes |
| dfm:21 | both | SW1 | TS-1187A pad pattern x+-3.0 y+-1.875, A-B and C-D common, H1.5 | verified | XKB TS-1187A-X-X-X A0 | 2026-10-28 | yes |
| dfm:22 | both | SW1 | EC11 layout A-C-B 2.5 pitch, D-E 5.0, rows 7.5/7.0 from shaft | verified | Alps EC11 catalogue p279 | 2026-10-28 | no |
| dfm:23 | lite-main | U9 | IRM-3638T lens faces the front edge on Lite | unverified | enclosure README claim; no dimension page | 2026-10-28 | no |
| dfm:24 | core | J3 | FFC FPC-05F-20PH20 land pattern vs maker drawing and pin-1/contact side | verified | XunPu drawing FPC-05F-NPH20 rev A (file.huaqiu.com/web2/M00/4C/A2/pYYBAGKwU4iATiB-AADmFDwz97g598.pdf, the series drawing for this part, fetched 2026-11-02) recommended land pattern against core J3 and ultra-front J1, which are the same footprint: pads 0.30 x 1.25 at 0.50 pitch (board 0.3 x 1.25, 0.5); tabs 2.00 x 2.50 (board 2 x 2.5); outer tab edge to pad 1's centre 2.69 (board 7.44 - 4.75); 0.70 from the pad row to the tabs (board 0.705). The drawing numbers the FFC's circuit 1 only, not the socket's pins, but the socket has no polarity of its own: pin N is position N, and parts:64 covers the mapping through the cable. | 2026-10-28 | no |
| dfm:25 | both |  | JLC THT per-joint fee and extended-part loading fee | unverified | not fetched | 2026-10-28 | no |
| dfm:26 | core | U10, U19 | ES9018K2M stock 706, PLR237/T8BK stock 236 (2026-10-29) | verified | parts_search live 2026-10-29 | 2026-10-28 | no |
| dfm:27 | lite-main | H1, H2, H3, H4, J1, J2, J3, J4, U9, SW1, SW2, SW3, D2 | Enclosure board snapshot matches current Lite PCB for holes/connectors/switches/LED/IR | verified | own diff of enclosure/lite-main.board.json vs lite-main.kicad_pcb, 2026-10-29 | 2026-10-28 | no |
| dfm:28 | lite-main | J2, J3 | RCA barrel axes 6.5/20.5 mm above board | unverified | enclosure hand correction; drawing gives 14 between axes only | 2026-10-28 | no |
| dfm:29 | lite-main | J2, J3 | Lid clearance over tallest part (RCA 27 mm vs 36 mm) | verified | enclosure README + Lian Xin drawing 27 mm | 2026-10-28 | no |
| dfm:30 | core |  | Plus/Ultra DNP sets consistent between BOM.csv and CPL.csv | verified | own diff of core/fab and core/fab/ultra BOM/CPL | 2026-10-28 | yes |
| dfm:31 | lite-main |  | Lite CPL rotations/pin1 match JLC EasyEDA models (134/134, incl. D1,D2,C58,C59 by role) | verified | hwde cpl_verify 2026-10-29, sims/dfm/cpl_lite.json | 2026-10-28 | yes |
| dfm:32 | core |  | core CPL rotations/pin1 match JLC EasyEDA models: Plus 230/230, Ultra 271/272 (U19 no model) | verified | hwde cpl_verify offline 2026-10-29, sims/dfm/cpl_plus.json, cpl_ultra.json | 2026-10-28 | yes |
| dfm:33 | core | U19 | U19 PLR237/T8BK CPL rotation | resolved | U19 is a through-hole part, so a wrong CPL rotation can't change how it's fitted: its footprint isn't symmetric (three 0.91 mm pins in one row, two 1.10 mm pins in the other, 1.70 mm posts on one side only), and the part goes in one way. dfm:16 covers that way against Everlight's drawing. CPL has rotation 180, the same as the board. In JLC's preview it may still draw wrong, as there's no EasyEDA model for C17223620; that's a preview matter only. | 2026-10-28 | no |
| dfm:34 | both | J1, U6, U8 | CPL for new J1 (C165948 / C7095263) and CH340B after the swap | verified | hwde dfm gate's cpl_verify against each part's LCSC/EasyEDA model passes on both boards after the swaps (2026-10-29): Lite J1 C165948, U6 C81010; core J1 C7095263, U8 C81010, U17 C131972, U18 C42421366, Y1 C7431354. | 2026-10-28 | yes |
| dfm:35 | core | J1, U15, U16 | JLC POFV on core: fills the 0.2 and 0.3 mm holes (vias and U15/U16's thermal-pad holes) and leaves J1's 0.4 mm pin holes open | resolved | fab/ORDERING.md gives the order remark that names the diameters to fill and says to leave J1's 0.4 mm pin holes open; all 910 vias measure over 0.45 mm from other holes and within JLC's 0.2-0.5 mm range. JLC's engineering review confirms at order time; a filled J1 hole would show there, not after the build. | 2026-11-01 | yes |
| parts:0 | lite-main | Q2, Q3, Q4 | MMBT3904 C20526 (JSCJ) SOT-23 pinout B=1 E=2 C=3 matches symbol and footprint pad positions (not mirrored) | verified | JSCJ MMBT3904 datasheet Rev 2.1 p1 (pin list), p3 (pad layout 0.6x0.8, 1.9 pitch, 2.02 rows) | 2026-10-28 | yes |
| parts:1 | core | Q3, Q4, Q5, Q6 | S8050 C2146 (JSCJ J3Y) SOT-23 pinout B=1 E=2 C=3 matches symbol and footprint | verified | JSCJ S8050 datasheet Rev 2.0 p1, p3 | 2026-10-28 | yes |
| parts:2 | core | Q2 | 2N7002 C8545 (JSCJ) SOT-23 pinout G=1 S=2 D=3 matches symbol and footprint | verified | JSCJ 2N7002 datasheet (J, Sep 2016) p1 | 2026-10-28 | yes |
| parts:3 | lite-main | Q1 | AO4485 C5125949 (UMW) SOP-8 S=1-3 G=4 D=5-8 matches symbol/footprint; pads CCW from top | verified | UMW AO4485 datasheet sect. 3 Pinning information p1 | 2026-10-28 | yes |
| parts:4 | core | Q1 | AO4485 C51499 (AOS) SOIC-8 S=1-3 G=4 D=5-8 matches symbol/footprint | verified | Alpha & Omega AO4485 datasheet p1 (SOIC-8 top view) | 2026-10-28 | yes |
| parts:5 | both | Q1, Q2, Q3, Q4, Q5, Q6 | LCSC numbers C20526/C2146/C8545/C5125949/C51499 are the intended parts in SOT-23 / SOIC-8 | verified | JLC/LCSC live search via hwde parts_search.py, MPN+package fields | 2026-10-28 | yes |
| parts:6 | lite-main | U2 | TPS54302DDCR (C311983) pinout 1 GND 2 SW 3 VIN 4 FB 5 EN 6 BOOT matches symbol/nets; EN may float (internal pull-up current) | verified | TI SLVSDG6C (rev Mar 2026) Table 4-1 p3, sect 7.3 | 2026-10-28 | yes |
| parts:7 | lite-main | U2 | TPS54302 footprint pads cover the DDC leads (rows 2.3 vs TI 2.7) | verified | TI SLVSDG6C p30 DDC0006A land pattern vs lite-main.kicad_pcb | 2026-10-28 | no |
| parts:8 | both | U3, U5 | SY8089A1AAC (C479074) pinout 1 EN 2 GND 3 LX 4 IN 5 FB matches; footprint = Silergy recommended pad layout | verified | Silergy AN_SY8089A1 Rev 0.0 p2 pinout, p9 recommended pad layout | 2026-10-28 | yes |
| parts:9 | both | U4, U6 | LP5907MFX-3.3/NOPB (C80670) is the 3.3 V DBV part; pinout 1 IN 2 GND 3 EN 4 N/C 5 OUT matches; footprint = DBV0005A land | verified | TI SNVS798Q Table 4-2 p3; orderable addendum (LP5907MFX-3.3/NOPB SOT-23 DBV); DBV0005A land p49 | 2026-10-28 | yes |
| parts:10 | core | U4 | SY8303AIC (C97054) pinout 1 FB 2 FS 3,4 GND 5 IN 6 LX 7 BS 8 EN matches; EN driven (not floating); FS 100k ~1.05 MHz | verified | Silergy AN_SY8303 Rev 0.9A p2 | 2026-10-28 | yes |
| parts:11 | core | U4 | SY8303 TSOT23-8 footprint vs vendor land pattern | unverified | Silergy gives outline only (AN_SY8303 p8); footprint checked against outline + IPC nominal, pads cover leads | 2026-10-28 | no |
| parts:12 | both | U1 | CH224A (ESSOP10) and CH224Q (DFN10) share pin numbers 0 GND,1 VHV,2 CFG2/SCL,3 CFG3/SDA,4 DP,5 DM,6 CC2,7 CC1,8 VBUS,9 CFG1,10 PG; symbol and nets match | verified | WCH CH224DS1-EN V2.0 Table 4-1 p3 | 2026-10-28 | yes |
| parts:13 | core | U1 | CH224Q DFN10 footprint pad positions/numbering and EP match package drawing (pitch 0.4, EP 1.5x0.9 vs 1.4x0.9) | verified | WCH CH224DS1-EN V2.0 sect 9.2 p18 | 2026-10-28 | yes |
| parts:14 | lite-main | U1 | CH224A ESSOP10 footprint rows/pitch/numbering match; EP size not dimensioned by WCH | verified | WCH CH224DS1-EN V2.0 sect 9.1 p17 | 2026-10-28 | no |
| parts:15 | both | U1 | CH224 VBUS pin tolerates VHV-level voltage (32 V) when shorted to VHV - datasheet sect 7.1 contradicts with 3.8 V | verified | Same as power:1: CH224 V2.0 table 4-1 and table 8.1.1 rate VBUS to 32 V; sect. 7.1's 3.8 V is a copy error in the CH224K-substitution notes. | 2026-10-28 | yes |
| parts:16 | both | R1, R2, U1 | CH224 Rset: 120k -> 20 V (Lite), 210k -> 28 V (core) | verified | WCH CH224DS1-EN V2.0 Table 5-1 p5 | 2026-10-28 | yes |
| parts:17 | both | U1 | LCSC C42459160 = CH224A ESSOP-10; C46061833 = CH224Q DFN-10-EP(2x2) | verified | LCSC search cache + live parts_search 2026-10-29 | 2026-10-28 | yes |
| parts:18 | lite-main | U8, C64, C65, C66, C67 | TPA3118D2DAPR (C46497) 32 pins + PowerPAD match symbol/nets; bootstrap caps on correct BS/OUT pairs (20-21, 24-23, 26-27, 30-29) | verified | TI SLOS708G Pin Functions p3-4 | 2026-10-28 | yes |
| parts:19 | lite-main | U8 | TPA3118 DAP footprint pads/rows/EP vs DAP0032C land (rows 7.44 vs 7.5, EP 3.81x3.71 vs 3.04x3.74 SMD opening) | verified | TI SLOS708G p46-47 (4223691/A) | 2026-10-28 | yes |
| parts:20 | lite-main | U8, R50, R51 | TPA3118 gain strap R51 100k to GVDD / R50 20k to GND = master 26 dB | verified | TI SLOS708G Table 1 | 2026-10-28 | no |
| parts:21 | core | U15, U16 | TPA3221DDVR (C475500) 44 pins match symbol/nets; 33 nF bootstraps on correct BST/OUT pairs | verified | TI SLASEE9C Table 5-1 p3-4 | 2026-10-28 | yes |
| parts:22 | core | U15, U16 | TPA3221 DDV footprint vs DDV0044D land (1.6x0.4 rows 7.6 vs 1.45x0.4 rows 7.5; pitch 0.635) | verified | The TPA3220DDW footprint keeps the same 44 pads (1.6 x 0.4 mm, rows 7.6 mm, 0.635 mm pitch). It adds pad 45, a 7.3 x 4.43 mm EP, which matches TI's DDW0044D land (SLASEN3B p42 example board layout), with 15 x 0.3 mm vias and 63 % paste in 4 windows (task 261029-075354). | 2026-10-28 | yes |
| parts:23 | core | U15, U16 | TPA3221 DDV PowerPAD is on top and must be attached to a grounded heatsink; no heatsink appears in core BOM/BOM-full | resolved | Resolved (task 261029-075354, issue #47): U15/U16 are now the pin-identical pad-down TPA3220DDW (C2879306; TI SLASEN3B table 5 'TPA3221 ... Top ... Y'). Its EP is soldered to GND on a 7.3 x 4.43 mm land with 15 x 0.3 mm vias into In1/B.Cu, so nothing is fitted by hand. On-board RthJA is about 26 C/W (JEDEC 23.5), so 1/8 power into 8 ohm runs at Tj about 84 C. Into 4 ohm, the C2 governor holds the chip near 2.5 W (16 W in, 60 s). LCSC stock is 0, so it is bought into the JLC inventory from Mouser/DigiKey (fab/prebuy.csv). See docs/review-2/heatsink-options.md. | 2026-10-28 | yes |
| parts:24 | lite-main | U7 | ES8388 (C365736) 28 pins + EP match symbol; QFN 4x4 pitch 0.45 matches footprint | verified | Everest ES8388 Rev 5.0 (Jul 2018) p5-6 pin table, p35 package | 2026-10-28 | yes |
| parts:25 | core | U10 | ES9018K2M (C2688377) 28 pins + EP match symbol; footprint = ESS example land; ADDR=GND -> 0x48; GPIO1 is a valid SPDIF input | verified | ESS ES9018K2M datasheet v3.7 (2021-04-22) p3-4, p9, p17, p36-37 | 2026-10-28 | yes |
| parts:26 | core | U13 | ES7243E (C2929446) 20 pins + EP match symbol; footprint fits 3x3 0.4 package | verified | Everest ES7243E Rev 2.0 (Jun 2019) p4, p28 | 2026-10-28 | yes |
| parts:27 | core | U13 | ES7243E with MCLK pin grounded works only after firmware sets reg 0x02 bit7 MCLK_SEL=1 (BCLK as MCLK) | unverified | Everest ES7243E Rev 2.0 p13 (register 0x02); firmware not reviewed here | 2026-10-28 | no |
| parts:28 | core | U13 | ES7243E I2C address: AD2 shares the SDOUT pin, so address is 0x10 or 0x14 depending on undocumented power-up state | unverified | Everest ES7243E Rev 2.0 p6 (chip address 0010 AD2 AD1 AD0); firmware should probe both | 2026-10-28 | no |
| parts:29 | core | U12 | PCM5102APWR (C107671) 20 pins match; SCK grounded selects BCK PLL; footprint vs PW0020A land | verified | TI SLAS859C Pin Functions p5, sect 9.3.5.3, PW0020A land | 2026-10-28 | yes |
| parts:30 | core | U9 | LAN8720A-CP-TR (C45223) 24 pins + EP match; floating straps give REF_CLK-in, regulator on, PHYAD 0 | verified | Microchip/SMSC LAN8720A Rev 1.4 Table 2.8, strap sections 3.7.4/3.8.1 (REGOFF/nINTSEL), ch 6 package | 2026-10-28 | yes |
| parts:31 | core | U10, Y1 | ES9018K2M internal DVDD is legal at MCLK = 50.000 MHz (limit stated as > 50 MHz) | unverified | ESS ES9018K2M v3.7 p7; 0 % margin - see PARTS-3 | 2026-10-28 | no |
| parts:32 | core | U17 | TCA9555PWR (C465732) 24-pin PW pinout matches symbol; footprint fits PW land | verified | TI SCPS200E Pin Functions p3 | 2026-10-28 | no |
| parts:33 | core | U17 | TCA9555 P-ports have internal ~100k pull-ups at power-on (inputs); TCA9535 is the same part without them | verified | TI SCPS200E sect 5, p6 IIL, p16 Figure | 2026-10-28 | yes |
| parts:34 | core | U17 | TCA9535PWR C130204 is pin/footprint/address compatible with TCA9555PWR | verified | TI SCPS200E sect 5 (identical except pull-ups); LCSC search 2026-10-29 TSSOP-24, 12371 in stock | 2026-10-28 | no |
| parts:35 | core | Y1, Y2 | 50 MHz oscillator C717684 pinout 1 OE/Tri-state, 2 GND, 3 OUT, 4 VDD and 3225 land | verified | YXC YSO110TR datasheet (LCSC copy for C717684) p2-3 | 2026-10-28 | yes |
| parts:36 | core | Y2, R45 | Y2 OE internal pull-up value (enable when floating) and whether 10k pull-down holds it below 30 % VDD | resolved | See digital:2 (R45 2.2k). | 2026-10-28 | yes |
| parts:37 | core | Y1, Y2 | OT322550MJBA4SL suffix = 3.3 V CMOS with OE on pin 1 | unverified | YXC series datasheet has no P/N decoder; relying on LCSC description | 2026-10-28 | no |
| parts:38 | both | U5, U7 | ESP32-WROVER-E-N8R8 38 pins + GND pad match symbol and footprint; land = Espressif Fig 15 (inner pad edge, EP position 7.5/16.16 mm) | verified | Espressif ESP32-WROVER-E/IE datasheet v2.4 Table 3 p11-12, Fig 15 p44 | 2026-10-28 | yes |
| parts:39 | both | U5, U7 | ESP32 strapping pins IO2/IO5/IO12/IO15 are not driven at reset on either board; IO0 on core is (PARTS-4) | verified | Espressif v2.4 sect 4 Table 4; netlists | 2026-10-28 | yes |
| parts:40 | both | U6, U8 | CH340C (C84681) 16 pins match; V3 tied to VCC at 3.3 V; NC pin 7 floating as required | verified | WCH CH340DS1 V3C sect 4 p3-4 | 2026-10-28 | yes |
| parts:41 | both | U6, U8 | CH340B (C81010) is a drop-in for CH340C with current nets (pins 7 RST# PU, 8 NC, 15 TNOW all unconnected) | verified | WCH CH340DS1 V3C and CN ed. 3D pin table | 2026-10-28 | yes |
| parts:42 | both | J1 | USB4105-GF-A-120 (C5184243) footprint pads/slots/pegs and pin order match GCT recommended layout | verified | GCT USB4105 drawing rev B3 sheet 1 | 2026-10-28 | yes |
| parts:43 | lite-main | J1 | HRO TYPE-C-31-M-12 (C165948) fits the existing USB-C footprint with identical pin order; rated 20 V | verified | HRO TYPE-C-31-M-12 drawing rev A (2020-12-08) | 2026-10-28 | no |
| parts:44 | core | J1 | GCT USB4085-GF-A (C7095263) needs a new THT footprint and 16-pin symbol | verified | GCT USB4085 drawing rev B sheets 1-2 | 2026-10-28 | yes |
| parts:45 | both | D1, D2, D4 | SMBJ20A/SMBJ30A/BZT52C33/BZT52C15 pad 1 = cathode, on the higher-potential net | verified | Lite D1 now SMBJ22A C151920: its EasyEDA model (parts/easyeda/C151920.json) has the same SMB_L4.6-W3.6-LS5.3-RD pads as C364296 with pin 1 = K, so the footprint, the cathode-bar silk and pad 1 on VBUS are unchanged. Core D1 SMBJ30A, D2/D4 BZT52C33/C15 as before (MDD SMBJ30A p1, BORN BZT52Cxx p1). | 2026-10-28 | yes |
| parts:46 | both | D2, D3 | KT-0603R LED pin 1 = anode, pin 2 = cathode; footprint and symbol agree | verified | Kento KT-0603R datasheet p2; EasyEDA C2286 | 2026-10-28 | no |
| parts:47 | core | U2 | USBLC6-2SC6 (UMW C2687116) pinout 1 IO1 2 GND 3 IO2 4 IO2 5 VBUS 6 IO1 | verified | UMW USBLC6-2SC6 datasheet sect 4 | 2026-10-28 | yes |
| parts:48 | core | U3 | INA186A1 DCK pinout 1 REF 2 GND 3 VS 4 IN+ 5 IN- 6 OUT; IN+ on bus side of R1 | verified | TI SBOS318B Table 5-1 | 2026-10-28 | no |
| parts:49 | lite-main | U9 | IRM-3638T pinout 1 OUT 2 GND 3 Vcc | verified | Everlight IRM-36xxT DMO-0000371 Rev.4 p1 (LCSC has no datasheet for C42421366) | 2026-10-28 | no |
| parts:50 | core | U18 | IRM-H638T/TR2 pin numbers 1 GND 2 GND 3 OUT 4 Vcc match; physical side of OUT vs Vcc relative to lens not given in drawing | unverified | Everlight DMO-0000008 Rev 3 p6 | 2026-10-28 | no |
| parts:51 | core | U19 | PLR237 symbol/footprint pad-1 physical position vs Everlight pin 1 (Vout) | verified | Everlight PLR237/T8BK DPL-0000262/263 Rev.1 (everlighteurope.com, fetched 2026-10-30) p5 bottom view, port at the top: 3-2-1 left to right, so facing the port pin 1 (Vout) is on the right. On the board, port up, that is the left-hand pad (x 137.447), footprint pad 3 = /OPT_SPDIF; the right-hand pad (x 142.527), footprint pad 1 = OPT_VCC, sits under Everlight pin 3 (Vcc). The symbol's numbering is the reverse of Everlight's, and so is the footprint's: the copper is right. | 2026-10-28 | yes |
| parts:52 | core | U19 | PLR237/T8BK fits the T10BK footprint | resolved | The library footprint had the T8BK's two 1.70 mm post holes, but the routed board still carried the old T10BK copy without them (0 NPTH on U19 in core.kicad_pcb). kicad/gen/u19_posts.py (2026-10-30) adds them as NPTH 1.70 at (+-2.80, +3.92) per Everlight PLR237/T8BK DPL-0000262/263 Rev.1 (everlighteurope.com, fetched 2026-10-30) p5, moves the GND via that sat in one, and refills the zones; DRC 0. The front offset is the T8BK's: 5.88 from the posts puts the port face at local +9.80, the courtyard's edge, and enclosure/core.board.json already places it there. | 2026-10-28 | yes |
| parts:53 | core | U11 | OPA1678IDR (C192421) SOIC-8 pinout matches | verified | TI SBOS855E Pin Functions: OPA1678 p4 | 2026-10-28 | no |
| parts:54 | core | U14 | TS5A23157DGSR (C11133) MSOP-10 pinout matches; footprint fits DGS | verified | TI SCDS165F Pin Functions p3 | 2026-10-28 | no |
| parts:55 | core | J2 | HR911105A (C12074) pin functions (TD+/-, RD+/-, CTs 4/5, NC 7, CHS 8, LEDs 9-12) and row orientation match | verified | HanRun HR911105A REV A/2 p1-2 | 2026-10-28 | yes |
| parts:56 | core | SW1 | EC11E1834403 (C361165) fits the 2.54-pitch EC11E1820402 footprint (Alps pitch 2.5, holes 1.2 vs 1.0) | verified | Alps EC11 catalogue (LCSC copy) EC11E vertical drawing | 2026-10-28 | no |
| parts:57 | core | SW1 | EC11 mounting-tab slot positions (footprint +/-6.25, 1.7x2.8 drill) vs Alps bracket | verified | Alps EC11E catalogue, update 2510, drawing 3 (tech.alpsalpine.com/cms.media/product_catalog_ec_01_ec11e_en_611f078659.pdf, fetched 2026-11-02), mounting holes against core SW1 and ultra-front SW4, the same footprint: tabs 12.5 apart (board +-6.25); tab holes 1.5 x 2.6 (board 1.70 x 2.80 slots, 0.2 larger); rows 7.5 and 7 from the tab line (board 7.5 and 7.0, tabs at local y -0.25); pins 1 mm holes at 2.5 pitch (board 1.2 holes at 2.54, 5.08 against 5). A C B order matches. The shaft is on the tab line, so it's at local (0, -0.25), not the footprint origin; the library model agrees. | 2026-10-28 | no |
| parts:58 | both | SW1, SW2, SW3 | TS-1187A (C318884) A-B and C-D internally joined; footprint pads 1-4 = A-D at exact vendor positions | verified | XKB TS-1187A-X-X-X drawing rev A0 (LCSC copy) | 2026-10-28 | no |
| parts:59 | both | L1, L2, L3, L4, L5, L6, L7, L8, L9, L10 | Inductor footprints cover the electrodes of XR0850, PSPMAA0805, SWPA6045S, SWPA4020S, SWPA4030S | verified | Xiangru XR0850 SFA 2024-06-21; PROD PSPMAA catalogue land table; Sunlord SWPA catalogue p2 | 2026-10-28 | no |
| parts:60 | both | C58, C59, C5, C6, C311 | Polarized caps C58/C59 (Lite) and C5/C6/C311 (core) have + pad on PVDD | verified | footprint silk (chamfer / + mark) vs netlist | 2026-10-28 | yes |
| parts:61 | core | R1, R18, R19, U3 | R1 10 mOhm shunt sense traces are Kelvin (R18/R19 tap at R1 pads) | unverified | not traced in core.kicad_pcb; power/layout review | 2026-10-28 | no |
| parts:62 | both | J2, J3, J4, J5 | XDJK-0271-1650 RCA footprint hole pattern (asymmetric signal pins) matches vendor drawing | verified | Lianxin A-AV2-7A1 drawing (LCSC copy C7527522); EasyEDA C7527522 | 2026-10-28 | yes |
| parts:63 | both | J2, J3, J4, J5 | Which RCA signal pin feeds the upper vs lower jack | unverified | Lianxin drawing does not label it | 2026-10-28 | no |
| parts:64 | core | J3 | FFC J3 contact side and cable type vs the (absent) front board | resolved | boards/ultra-front (on main 2026-10-30) has the same FPC-05F-20PH20 (C2856803) as its J1, at rotation 0, pin N on the same signal as core J3 pin N (checked pad by pad in both .kicad_pcb). In the Ultra box J3 (core x 20) and J1 (front-board X 14 + 6) line up, and the cable leaves J3 forward, turns down, runs forward under the front board and up into J1: three bends about the same axis keep the conductor order and turn the contact face from J3's side to the side away from J1's contacts. With the same part at both ends that holds whichever side the part's contacts are on, so the cable is a 20-pin 0.5 mm type B (opposite-side contacts), pin N to pin N, as enclosure/README.md and boards/ultra-front/README.md say. | 2026-10-28 | yes |
| parts:65 | core | U15, U16 | Correction: a pad-down TPA3221 exists at 28 V. heatsink-options.md's first pass said the pad-down relatives stop at 26 V (TPA3116/3118). TI's TPA3220 is the TPA3221 with its pad on the bottom, rated 7-32 V (37 V abs), 89 W into 4 ohm at 1 % | verified | TI SLASEN3B rev B (Aug 2018) sec 1, 5 (device comparison: TPA3221, top pad, pin-compatible Y), 7.1, 7.3, 7.6 | 2026-10-29 | no |
| parts:66 | core | U15, U16 | TPA3220DDW pins 1-44 match the TPA3221DDV's one for one; the bottom PowerPAD is GND (pad 45 on the EP land, DDW0044D 7.3 x 4.43 mm) | verified | TI SLASEN3B pin table p3-4 vs SLASEE9C table 5-1; DDW0044D example board layout p42; EasyEDA C2879306 model EP 4.43 x 7.30 | 2026-10-29 | yes |
| parts:67 | core | U15, U16 | TPA3220DDWR (C2879306) stock on 2026-10-29: LCSC 0, JLC 0 (free -2); Mouser 595-TPA3220DDWR 6,566 ($3.74 at 100); DigiKey 296-51851-1-ND 2,032. Needs a pre-buy into the JLC inventory (fab/ORDERING.md) | verified | JLC selectSmtComponentList and LCSC product detail APIs, Octopart listing, 2026-10-29 | 2026-10-29 | yes |
