Hive-RSI-Lab/hifi-receiver/.hive/goals.md

# Goals

The person, posted in #ai-ee at 2026-10-14 04:49Z (relayed by autobox 2026-10-28), verbatim:

"i want a new board: something similar to the Wiim ultra where it has a really good DAC like i think it has  some sabre dac or something, and then RCA outputs for two subs, and banana plugs for L and R for the two Vienna acoustics speakers. It should  have a really high output power to be able to drive the speakers really hard, way higher power than this version so we can add more speakers too. It should have RCA input so  i can connect my FLX4 DJ deck as an input. I want to be able to control it via a mobile or maybe a website app or something, and stream to it via spotify and other services over WIFI. I want to be able to connect it to the wifi and ethernet also. So it needs to be an all in one, hi-fi high res system, configurable via app/web app and then also with maybe a remote and buttons for easy use. I want ease of use maximized, and it to be fully supported by JLC assembly. This is meant to be a product where it arrives, i plug it in, and then connect it to a laptop or the network ideally or something so it can talk to the server for bringup and internal testing, and then plug in the speakers and it just works. This is a test of the fully autonomous full pipeline AI design, bringup, test and all system. Also work with the onshape session to make an enclosure for it that can be 3D printed and make user manuals, etc. Should be a complete product. Add any other functionality you deem useful. Keep the cost at a minimum. It's meant to be a cheap Hi-Fi option. Cut functions you dont think we need like if we dont need ethernet, etc. Also, maybe it can be USB-C powered? Is 140W enough? Idk you figure it out. USB-C power would be cool though so you dont need to worry about the AC side of things. Also bluetooth streaming. Devise core functionalities and various expected prices and go for there. I'm targetting quite cheap BOM, so ideally max cheapness. You can also made several ones actually with increasing number of features, so a super cheap barebones version, and then a medium and then a fully fledged one that's like the WiiM ultra or something. I think you have enough info at this point, it's all over to you. Take care of everything yourself."

The person, Slack 2026-10-28 13:05Z: "H0 and i decided it would be good to move hwde onto H0.  I want it to get and design the whole audio amp system thing remember? You can give justthe original briefs i gave ai-ee"
13:06Z: "its the most recent thing. not the amp we manufactured, it's the receiver WiiM copy thing with different tiersetc"

The person, Hive chat 2026-10-28, verbatim:

14:55Z: "no need to wait for stuff like that to merge we just build no need to follow protocols"
14:56Z: "Done = fab files complete. We can build a fw module later or whatever and do those and figure out spotify etc access"
15:43Z: "OK. Make sure as new fixes land in the hwde module, that the  boards get updated etc"
16:55Z (supersedes 14:56Z on firmware): "you know what, resume all the fw stuff etc the board design needs to happen in tandem and be informed by fw and sw constraints. Build the whole product go"
16:57Z: "remember how the hive works: you and agents etc can build and file new modules, spawn other agents recursively to build those out etc"

The person, Hive chat 2026-10-29 (10-28 evening, their time), verbatim, on their part in bring-up:

01:47Z: "it should all be autonomous without me mind you (except obviously plugging it in etc)"
02:04Z: "Like essentially the flow on my end has to ideally be plug it in to power, connect some diagnostic USB or something to a laptop, or just have it connect to the internet, run some script on my laptop that configures wifi etc, and then i just leave it plugged in at home and the hive talks to it, brings it up, revs the FW, tests things, etc, all on its own. Like yea at some point i will proob need to use a scope etc, but whatever can be done for minimal increased cost and complexity to have the board monitor irself and its waveforms is best"
02:05Z: "Like my involvement is literally: i give the spec, you design a product that will def work with appropriate contingencies, etc, as needed, then i order it, it arrives, i plug it in, do the minimal possible on my end, and leave it and then you ping me when it's ready for use"
02:06Z: "This should be the flow for all board designs"

The person, Hive chat 2026-10-29 (thread 261029-172840, after asking "what is done and what still needs to get done" and hearing Lite would likely be ready to order first), verbatim:

17:41Z: "Donesnt matter they all need to be done and working"
17:45Z: "Vienna acoustics Mozart or something but it needs to work with speakers in general i think these are 6OHM."
17:45Z: "Not sure which ill order and when but well see"
