Hive-RSI-Lab/hifi-receiver/docs/review-3/layout.md

# Review round 2 (review-3): LAYOUT (layout, EMC, thermal, JLC manufacturability)

Boards: lite-main (2-layer), core (4-layer, Plus and Ultra placements), ultra-front. Machine-readable findings: `layout.json`, generated by `sims/layout/build_report.py` from `sims/layout/findings.py`. Tests: `sims/layout/` (start with `refill.sh`; it makes refilled copies in /tmp and never writes to boards/).

Count: 1 blocker (repeat), 1 major (new), 9 minor (5 new, 4 repeat), 5 notes.

## Findings

| id | board | sev | repeat of | finding | fix |
|---|---|---|---|---|---|
| R3-LAYOUT-12 | core | **blocker** | DFM-1/DFM-2 | Round 1's RCA fix never reached the board. J4 (SUB OUT) and J5 (LINE IN, where the FLX4 plugs in) are the old instance: 3 round 1.6 mm holes on the -1.95/-1.15 rows, no 2.0 x 3.0 leg holes. The library `.kicad_mod` was fixed. `core.drl` has no 2.0 mm tool. Unchanged since 9da177c. The jack cannot be inserted. | Update J4/J5 from the library (legs at ±7.65/+1.60, 1.6 x 2.4 slots at y -1.55), re-route, regenerate Gerbers/drill. Set `lib_footprint_mismatch` to error. `fp_vs_lib.py` now catches this. |
| R3-LAYOUT-1 | core | **major** | new | The TPA3220 input nodes after the DC-blocking caps are 45-56 mm long and single-ended (U15's caps C218/C220 sit next to U16, at x≈80). They run 7-31 mm over the PVDD plane 0.24 mm away and pass 3 mm from U16's OUT/BST pads. The M partners are 7-10 mm long, so the pair does not cancel pickup. ~2 pF to switching copper sits at a ~10-20 kohm node with 18-24 dB gain behind it. | Move C218/C220 (and C316/C318) to ≤5 mm from the IN pins, beside C219/C221, so the long run is the low-impedance AMP_IN_L/R side. Route P/M as a pair on F.Cu over In1 GND, ≥3 mm from OUT/BST, off the PVDD area. Bench: idle noise ≤100 uV A-wt. |
| R3-LAYOUT-2 | core | minor | new | I2S, RMII and analog lines on B.Cu reference In2's split +3V3/PVDD/VBUS plane, not GND (BCK 79 of 105 mm over +3V3, 3-15 plane-edge crossings; LIN_L/R, DACL_N, MAIN_R 13-25 mm over +3V3). EMI and Wi-Fi-burst coupling. | Make In2 GND under the x 100-140 / y 130-180 corridor, or add +3V3-GND stitching caps at the crossings; move the analog lines to F.Cu. |
| R3-LAYOUT-13 | lite | minor | THERMAL-3 | TPA3118 at the governor ceiling (13 W/ch, 4 ohm, 62 C box): chip loss ~2.9 W, Tj 126-149 C against the 150 C latched OTE (theta 22-30 C/W). Music power: Tj 76-84 C. | Firmware: 4 ohm governor 13 -> 9 W/ch. Layout (next touch): ~30 EP vias. Bench: 30 min pink noise at the limit, case ≤ 123 C. |
| R3-LAYOUT-14 | both | minor | new | USB-C ESD: Lite D+/D- have no TVS (54 mm to the CH340B); CC1/CC2 go direct to the CH224A/Q on both boards. VBUS TVS present. | Lite: USBLC6-2SC6 (C2687116) at J1, as core has. CC: accept, or DNP TVS footprints. |
| R3-LAYOUT-15 | core | minor | new | SY8303 input loop goes through In2 (pin 5 via, C10 4.0 mm away), ~3-5 nH; estimated 33 V IN spike vs 40 V abs max. | 100 nF ≥50 V cap directly across pins 5/4 on F.Cu. Bench: IN spike ≤35 V at 28 V/2 A. |
| R3-LAYOUT-7 | lite | minor | new | TPS54302 Cin loop: C5 100 nF 1.9 mm from VIN, its GND return through 2 vias (4.4 mm); C3 10 µF at 3.6/6.1 mm. TI EVM: same-layer loop. | Optional F.Cu GND bridge from C5 to pin 1. |
| R3-LAYOUT-6 | lite | minor | new | I2S on B.Cu has 10-12 mm runs with no F.Cu GND above; USB D± 74 mm. Amp inputs 100 % referenced. | Optional F.Cu GND stitching over the run. |
| R3-LAYOUT-8 | lite | minor | THERMAL-4/DFM-9 | TPA3118 EP paste windows sit over the 16 open 0.3 mm vias (wicking, voids). | Filled/capped vias at order, or windows off the via grid. |
| R3-LAYOUT-16 | core | minor | DFM-9 | TPA3220 EP: 63 % paste, windows over the open vias. | As above; thermal margin covers it. |
| R3-LAYOUT-9 | both | minor | DIGITAL-18/19 | The antenna keep-outs are clean, but the side clearance is 2.25 mm (Lite) and 0.85 mm (core) against Espressif's 15 mm. | Accept; WROVER-IE contingency. |
| R3-LAYOUT-3 | core | note | THERMAL-1 | TPA3220 pad-down passes: ~1.0 W/chip at the governed limit gives Tj 92-93 C (≤100 C upper bound) against OTW 115 C min. | None (optional: more EP vias). |
| R3-LAYOUT-4 | core | note | AMP-9 | TPA3220 C2879306 stock 0 (need 10). All other lines are in stock. | Keep the pre-buy; re-run `jlc_stock.py` on the order day. |
| R3-LAYOUT-5 | all | note | new | CPL rotation and pin 1: 0 failures over 766 rows, by two independent fits. U19 has no EasyEDA model (hand-placed THT). | None. |
| R3-LAYOUT-10 | all | note | new | DRC with refill and schematic parity is clean on all 3 boards, but the courtyard and library-mismatch checks are set to ignore (that is how R3-LAYOUT-12 slipped through). | Set `lib_footprint_mismatch` to error. |
| R3-LAYOUT-11 | lite | note | new | hwde check_current passes on constraints that understate the currents (PVDD 0.8 A, VBUS 0.4 A, outputs 1 A; real ~2.4/2.7/2.2 A). | Raise them and re-run. |

## Blocks checked, against the reference, with margin

**JLC placement (CPL).** `cpl_pin1.py` is independent of hwde's `cpl_verify.py`. It fits the LCSC EasyEDA model pads, turned by the CPL rotation, onto same-numbered board pads.
- Results: Lite 145/145, Plus 293/293, Ultra 292/293 (U19: no model, THT), front 36/36. Worst pad error 0.135 mm (Lite U6 SOP-16).
- hwde `cpl_verify` agrees where it was not rate-limited (Lite 145/145, Plus 293/293).
- Pin-name check: no vendor GND pin lands on a non-GND net. The flagged pins are intentional straps: MODSEL/AMx (U8), ADDR, HEAD, V-, PCM5102A/ES7243E config pins.
- All parts are top-side and there are no bottom placements. Margin: 0 failures.

**JLC stock (`jlc_stock.py`, JLC API, 2026-10-30).**
- Lite: 53 lines, 19 extended, all in stock (tightest: L1-L4 C48391614, 1676 against 21 needed).
- Plus/Ultra: 82/80 lines, 39 extended. One fails: TPA3220 0 (R3-LAYOUT-4). Thinnest otherwise: ES9018K2M 705, Y1 49.152 MHz 497, PLR237/T8BK 236.
- Front: 18 lines, 6 extended, all in stock.

**DRC.** kicad-cli 10.0.6 with `--refill-zones --schematic-parity --severity-all`: 0/0/0 on all three boards.

**Footprint vs library (`fp_vs_lib.py`).** Lite 30/30 and front 36/36 match. On core, J4/J5 mismatch (R3-LAYOUT-12).

**Land patterns vs TI.**

| Part | TI reference | Ours | Verdict |
|---|---|---|---|
| TPA3118 DAP0032C | EP 3.74 x 3.04, pads 1.5 x 0.45, 7.5 span | EP 3.81 x 3.71; pads 1.73 x 0.343 (narrower), 7.44 span; EP-to-pin gap 1.0 mm | OK |
| TPA3220 DDW0044D | EP 7.3 x 4.43, pads 1.45 x 0.4, pitch 0.635, 7.5 span | EP 7.30 x 4.43, pads 1.6 x 0.4, 7.6 span | Matches |

**Thermal (`thermal_calc.py`).**
- Lite TPA3118, theta 22 (TI 2-layer EVM, SLOS708G 6.4) to 30 C/W:
  - 1/8 clip, 6 ohm, 52 C box: 1.07 W, Tj 76-84 C. Margin 66 K to the 150 C OTE.
  - Governed limit: see R3-LAYOUT-13.
- core TPA3220, theta 30 C/W (23.5 JEDEC 2s2p x1.1 for 0.5 oz inner x1.15 for the second chip):
  - Governed limit: ≤1.05 W, Tj 93 C. Margin 22 K to OTW min 115 C (SLASEN3B 7.5). The 4-layer In1 GND plane covers 93 % of the board.
- core Q1 AO4485: F.Cu PVDD patch plus 12 vias into the 2833 mm² In2 PVDD pour (round-1 THERMAL-7 fix holds).

**Buck hot loops.** See R3-LAYOUT-7 and R3-LAYOUT-15.
- Lite SY8089: C11 100 nF at 1.7/2.6 mm and C10 10 uF at 3.5/4.4 mm from IN/GND. Within the datasheet's "close to IN and GND".
- core SY8089 U5: C15 10 uF at 5.2/3.7 mm. Acceptable at 5 V in.
- SW nodes are short on all bucks.

**Amp decoupling and bootstrap.** Not redone here; see R3-AMP-1/2 (core) in amp.md. On Lite, the amp inputs are 4-12 mm long and 100 % over GND (`gnd_ref.py`).

**Ground strategy.**
- Lite (2-layer): B.Cu GND covers 82 % and F.Cu 68 %. The amp/power section (right) and the codec/ESP32 (left) are separated by B.Cu track channels and join near J1 (top) and at the bottom, so class-D return current does not cross under the ES8388. The amp inputs are differential.
- core: In1 is a solid GND plane (93 %). F.Cu signals are well referenced. B.Cu signals reference the split In2 (R3-LAYOUT-2).

**ESD (`esd_scan.py`).**
- VBUS TVS ≤5.6 mm from the jack on both boards. core D± has a USBLC6.
- RCA inputs have 15k (Lite) and 4.7k (core) series resistors. Speakers go through the LC filter. Ethernet goes through HR911105A magnetics.
- Gaps: R3-LAYOUT-14.

**Antenna.** Keep-out clean on both boards. See R3-LAYOUT-9.

**Enclosure.** `enclosure/core.board.json` holes are derived from the board (H3 116.45/3.55 = board 151.04/217.15). They match.

## Round-1 fixes checked

| id | holds | how |
|---|---|---|
| DFM-1 | **no** | core J4/J5 stale footprint → R3-LAYOUT-12 |
| DFM-2 | **no** (core) / yes (Lite) | same |
| DFM-4, DFM-6, DFM-12 | yes | IRM-3638T 3.0 mm from the edge; USB4085 0.70/0.40; U19 posts at ±2.8 |
| DFM-9, DFM-10 | no (accepted) | EP paste over vias; no fiducials (JLC accepts single boards) |
| THERMAL-1 | yes | superseded by the pad-down TPA3220, R3-LAYOUT-3 |
| THERMAL-3 | partly | marginal at the 4 ohm governed ceiling, R3-LAYOUT-13 |
| THERMAL-4, -7, -9 | yes | see json |
| DIGITAL-18, -19 | yes | keep-outs clean |

## Field issues searched and what our boards do

- **JLC CPL rotation flips (SOT-23/SOIC):** immune. EasyEDA-imported footprints; 0/766 failures.
- **PowerPAD/QFN voiding with open vias under the paste:** has it (minor, R3-LAYOUT-8/16). The thermal margin absorbs it.
- **Class-D noise and EMI from long inputs near the power stage (TI SLASEN3B 11.1):** core has it (R3-LAYOUT-1). Lite is immune.
- **TPA3118 thermal shutdown on 2-layer boards at sustained power:** Lite is marginal only at the 4 ohm governed limit (R3-LAYOUT-13).
- **ESP32 antenna detuned by copper beside it:** mild on both boards (R3-LAYOUT-9).
- **Library fix not pushed to the board:** core has it (R3-LAYOUT-12).
- Known unknown: the forum and GitHub search (E2E, Louder-ESP32, squeezelite-esp32 boards) was not completed this round. The issues above come from vendor documents and our own measurements.
