Hive-RSI-Lab/hifi-receiver/docs/review-2/dfm.md

# DFM / mechanical / JLC assembly review (domain `dfm`)

Reviewer: independent DFM/assembly pass, 2026-10-28. Both boards. Read-only on `boards/`.
Scripts used are kept in `docs/review-2/sims/dfm/` (footprint dump, Gerber read, EP/via check).
JLC capability numbers below are from https://jlcpcb.com/capabilities/pcb-capabilities fetched 2026-10-28.
Written block by block; complete as of 2026-10-29.

## Summary

| ID | Sev | Board | What |
|---|---|---|---|
| DFM-1 | **blocker** | core | J4/J5 stacked-RCA footprint has no holes for the jack's two body posts (Lite's copy has them). The jack can't seat and its pins can't reach through. |
| DFM-2 | major | both | RCA post holes are 1.7 x 2.4 against the drawing's 2.0 x 3.0, and the EasyEDA pin rows (0.8 mm offset between pins 1 and 3) don't match my reading of the drawing. Check against a sample before ordering. |
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
