Hive-RSI-Lab/hifi-receiver/boards/core/renders/place1/core_top.png

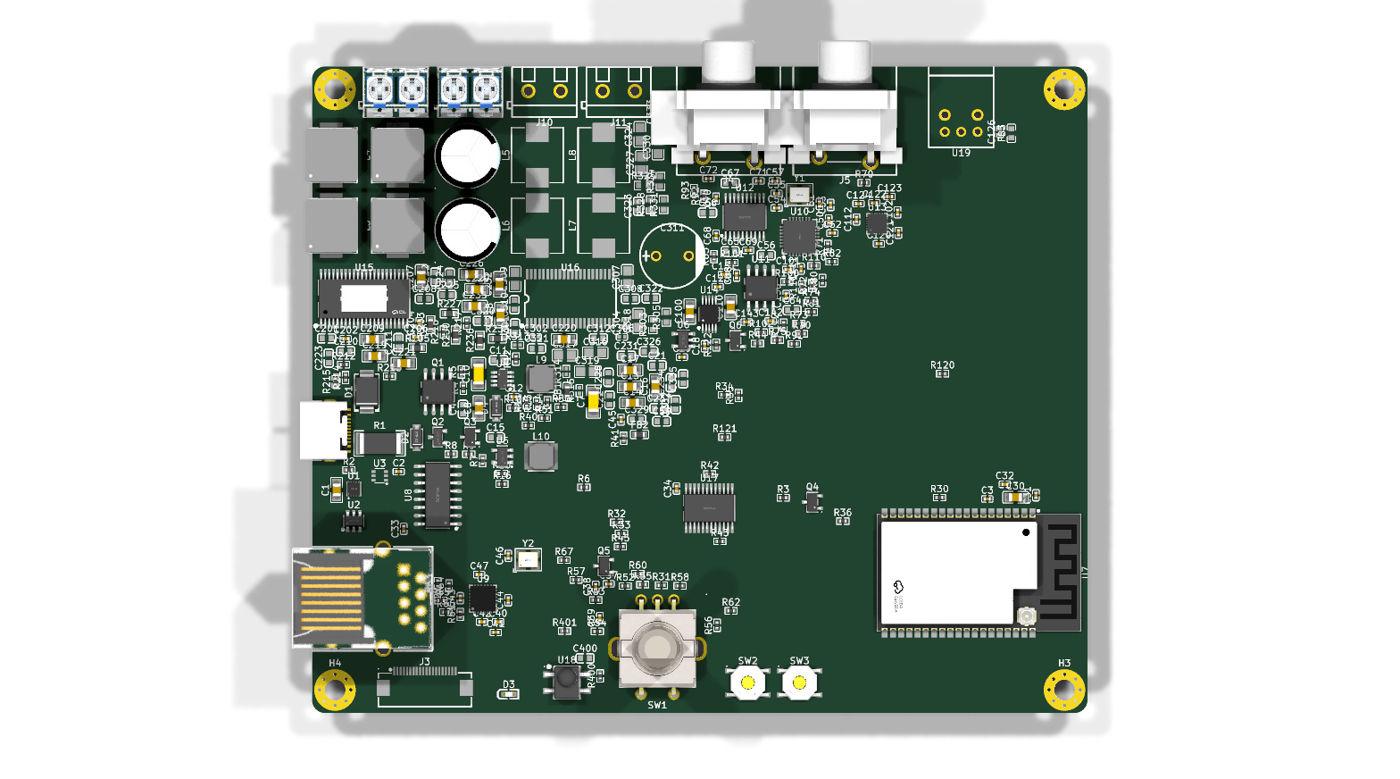
boards/core/renders/place1/core_top.png
