Hive-RSI-Lab/hifi-receiver/boards/core/renders/seed/core_top.png

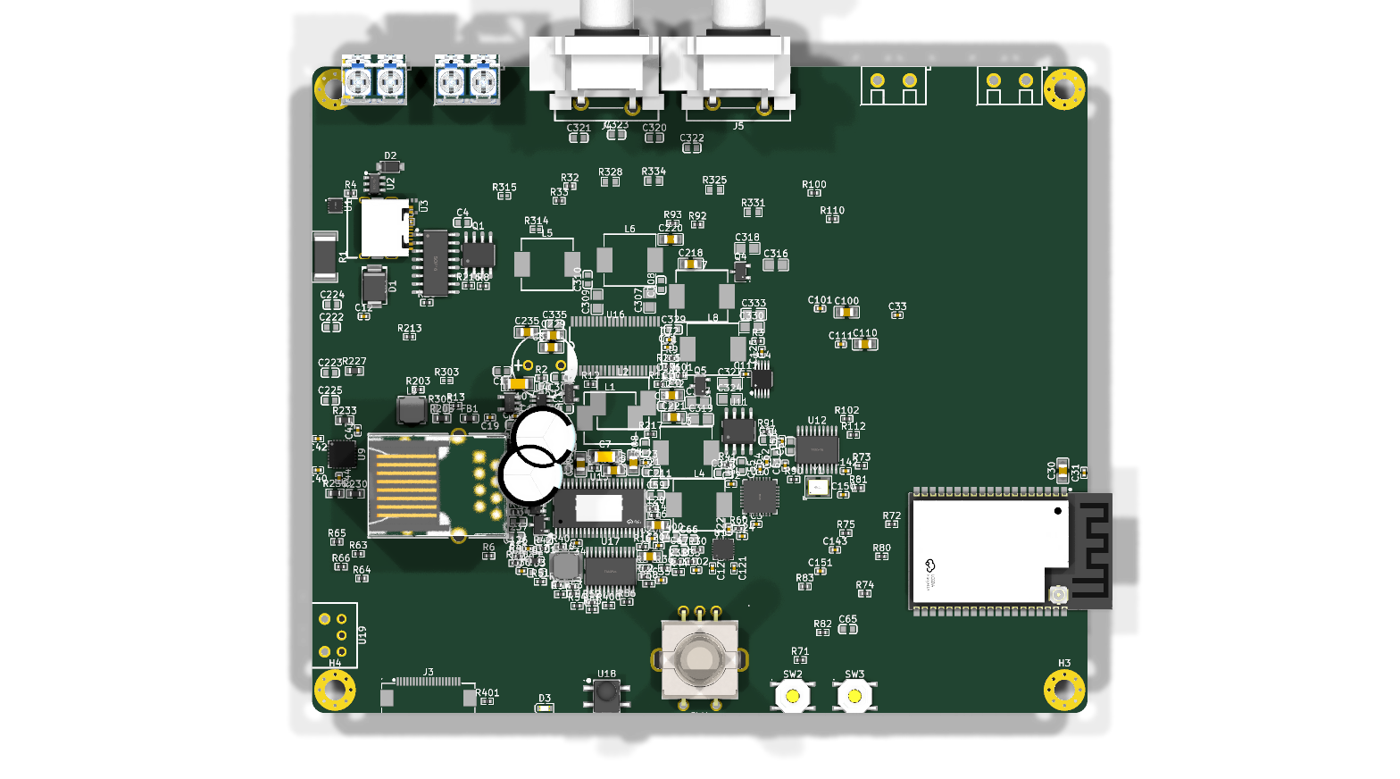
boards/core/renders/seed/core_top.png
