Hive-RSI-Lab/hifi-receiver/boards/core/reports/renders/core_bottom.png

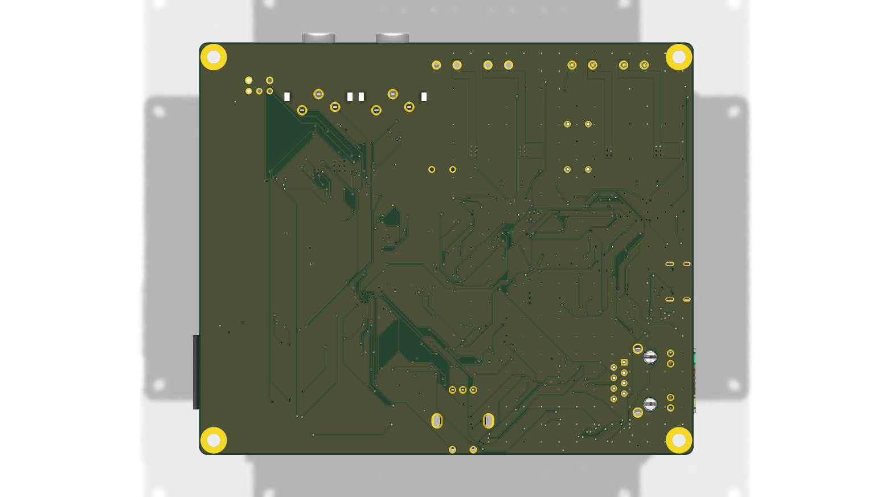
boards/core/reports/renders/core_bottom.png
