Hive-RSI-Lab/hifi-receiver/boards/lite-main/reports/renders/review-bottom-mid.png

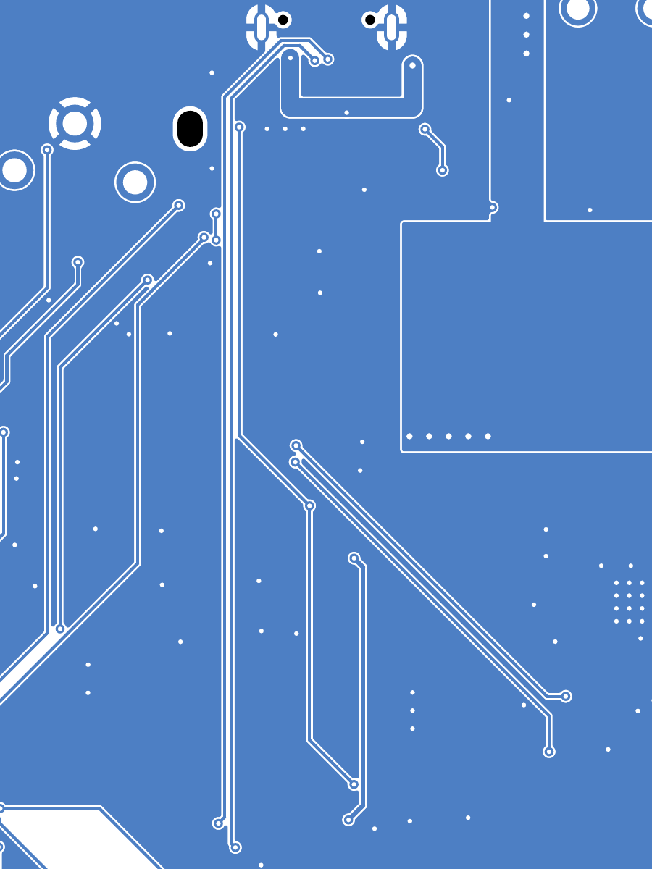
boards/lite-main/reports/renders/review-bottom-mid.png
