Hive-RSI-Lab/hifi-receiver/boards/lite-main/reports/renders/review-bottom.png

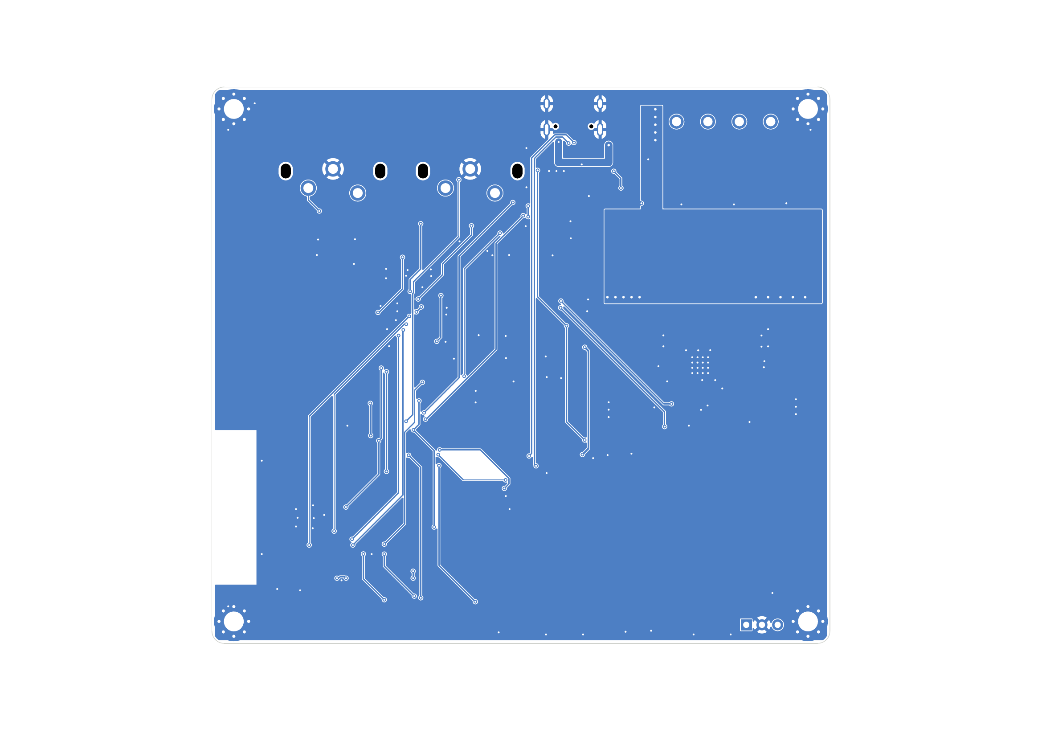
boards/lite-main/reports/renders/review-bottom.png
