Hive-RSI-Lab/hifi-receiver/boards/lite-main/reports/renders/review-top-amp.png

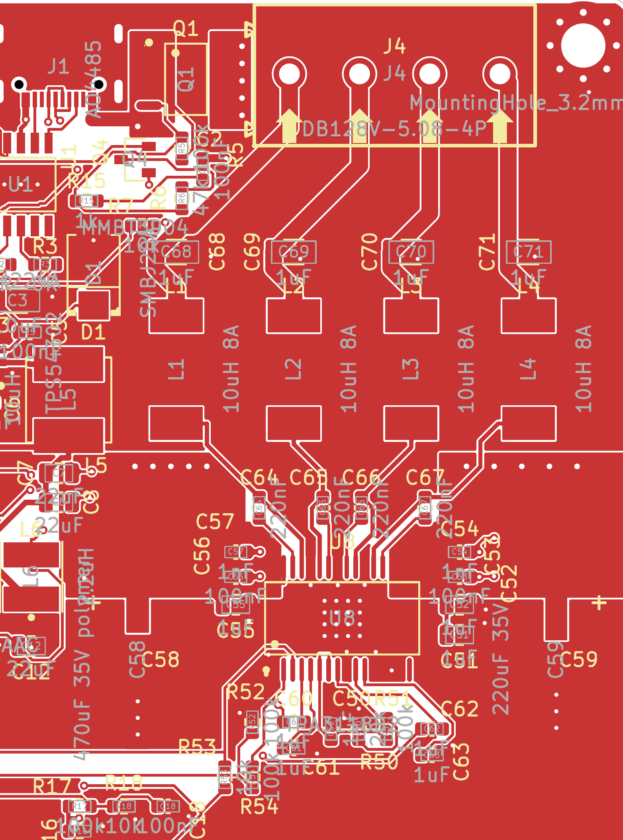
boards/lite-main/reports/renders/review-top-amp.png
