Hive-RSI-Lab/hifi-receiver/boards/lite-main/reports/renders/review-top-antenna.png

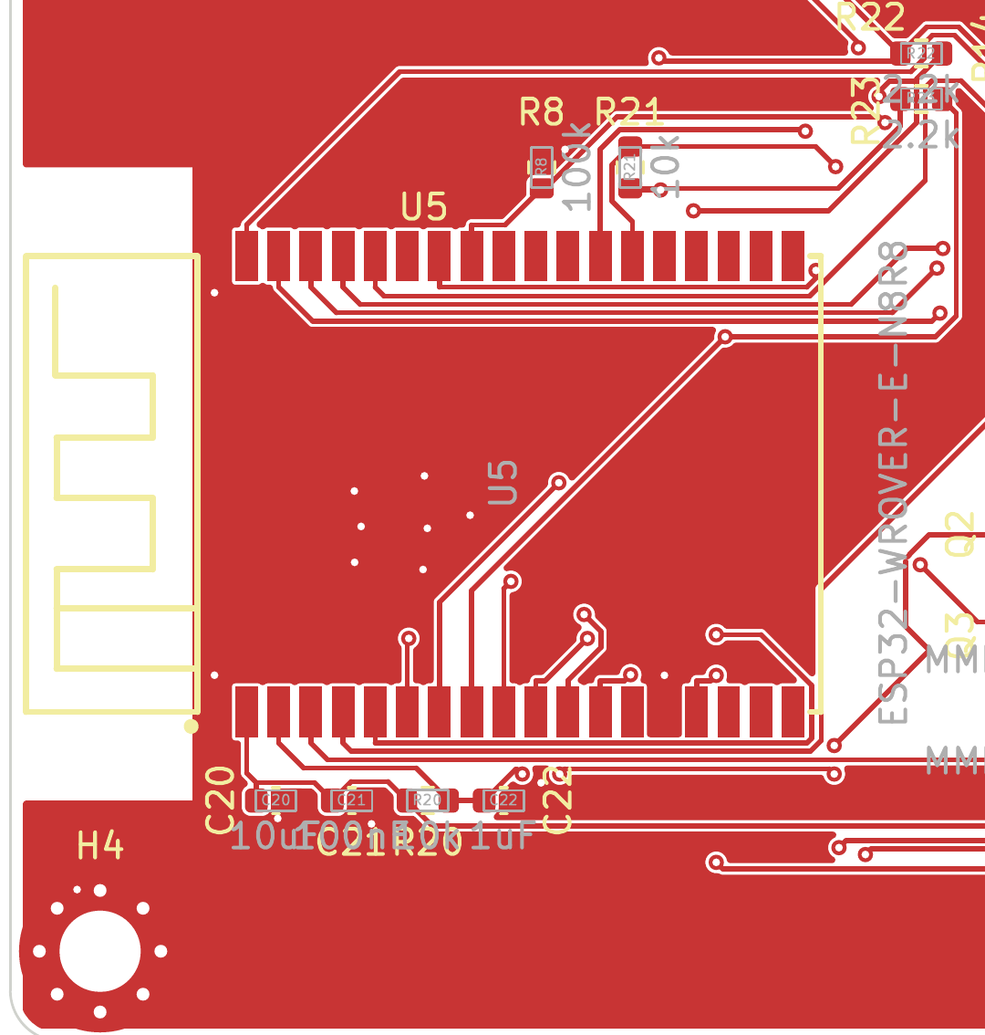
boards/lite-main/reports/renders/review-top-antenna.png
