Hive-RSI-Lab/hifi-receiver/boards/ultra-front/reports/renders/ultra-front_bottom.png

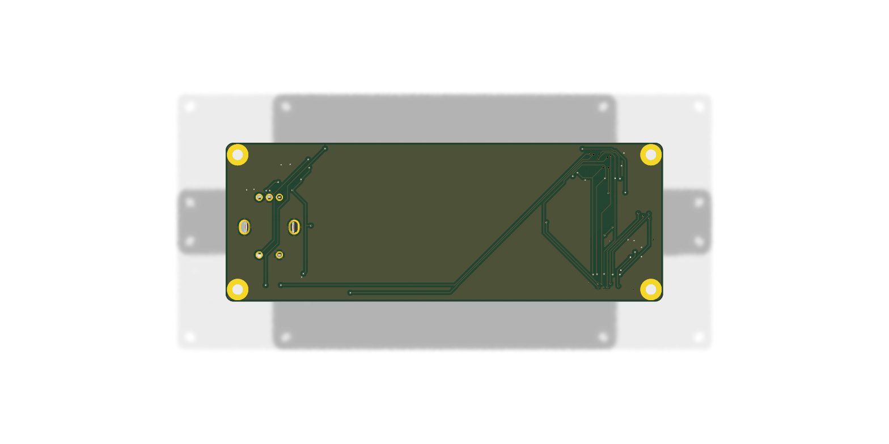
boards/ultra-front/reports/renders/ultra-front_bottom.png
