Hive-RSI-Lab/hifi-receiver/boards/ultra-front/reports/renders/ultra-front_iso.png

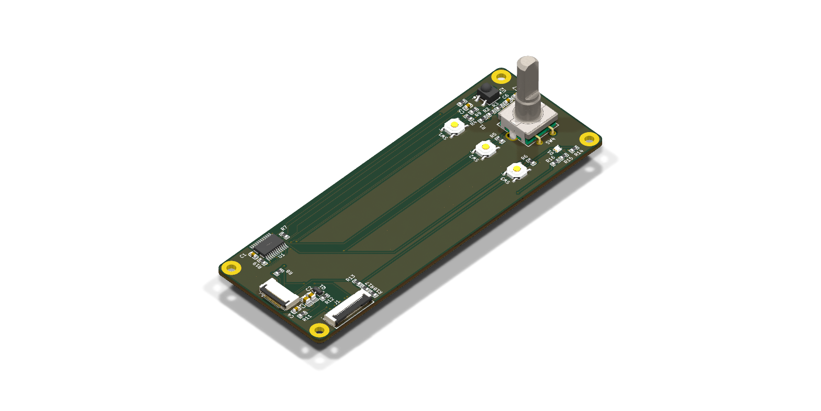
boards/ultra-front/reports/renders/ultra-front_iso.png
