Hive-RSI-Lab/hifi-receiver/enclosure/out/lite/port-N.png

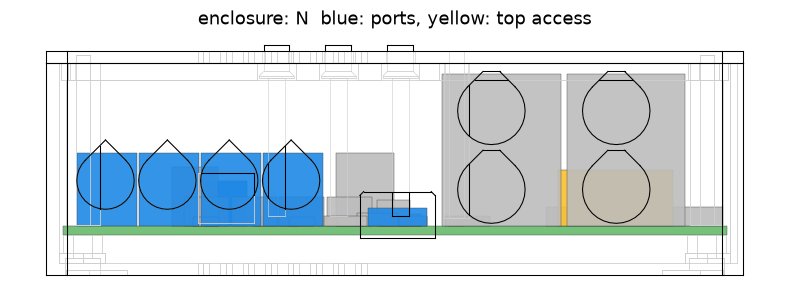
enclosure/out/lite/port-N.png
