Hive-RSI-Lab/hifi-receiver/enclosure/out/lite/port-S.png

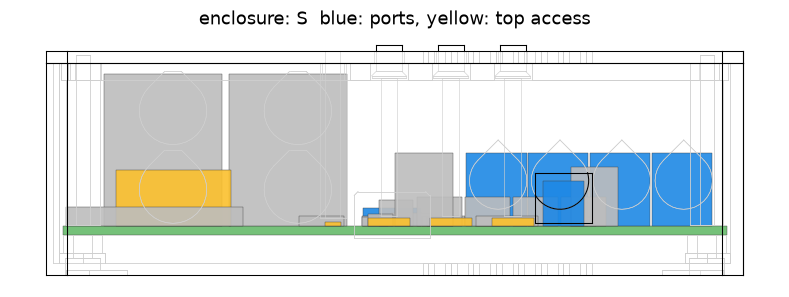
enclosure/out/lite/port-S.png
