Hive-RSI-Lab/hifi-receiver/enclosure/out/lite/top.png

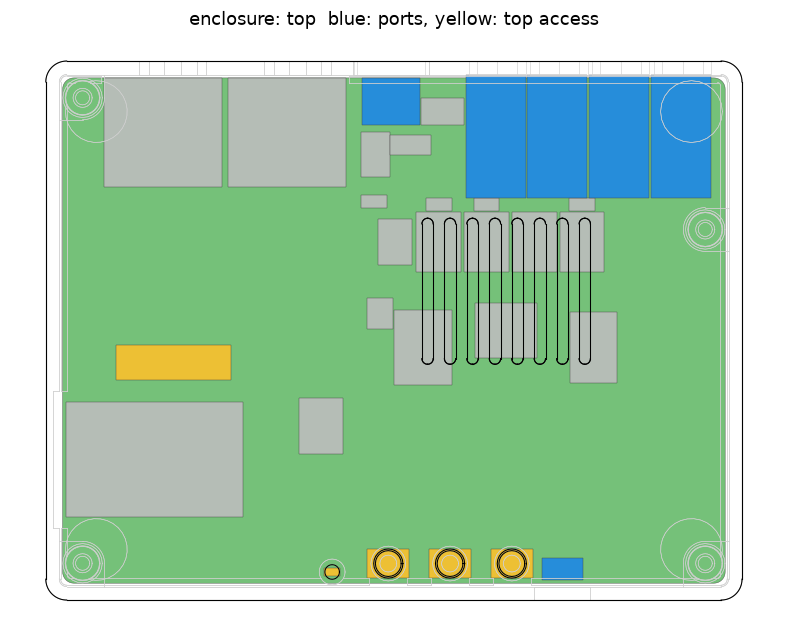
enclosure/out/lite/top.png
