Hive-RSI-Lab/hifi-receiver/enclosure/out/plus/iso.png

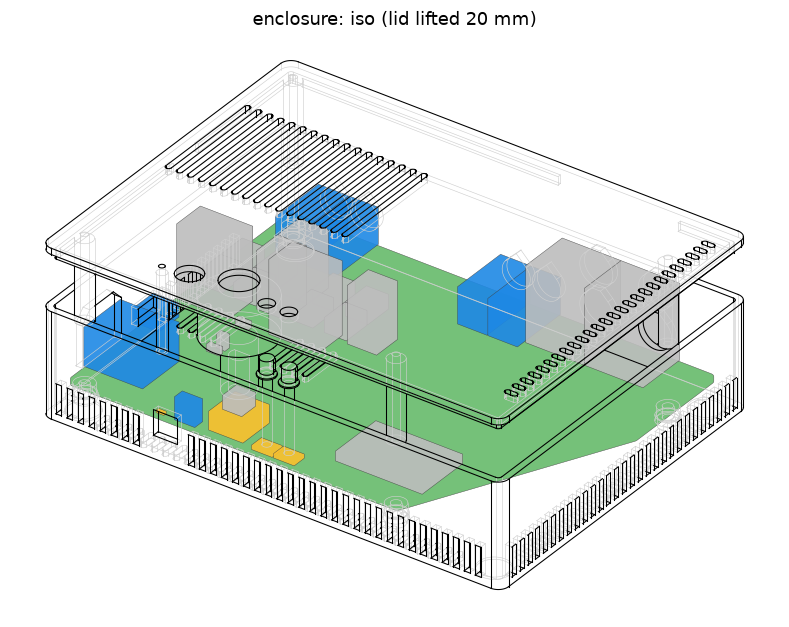
enclosure/out/plus/iso.png
