Hive-RSI-Lab/hifi-receiver/enclosure/out/plus/port-N.png

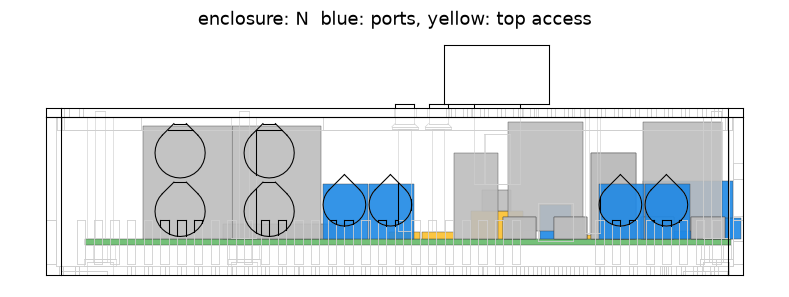
enclosure/out/plus/port-N.png
