Hive-RSI-Lab/hifi-receiver/enclosure/out/plus/port-S.png

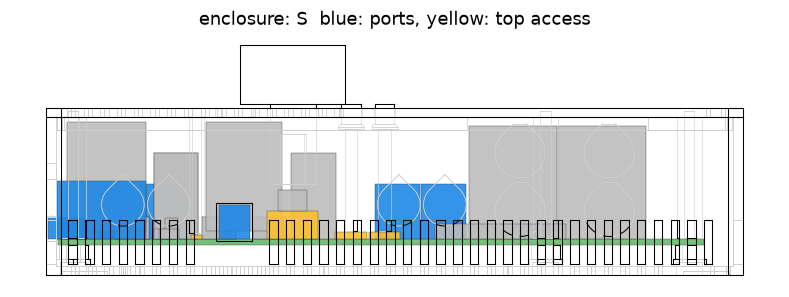
enclosure/out/plus/port-S.png
