Hive-RSI-Lab/hifi-receiver/enclosure/out/plus/port-W.png

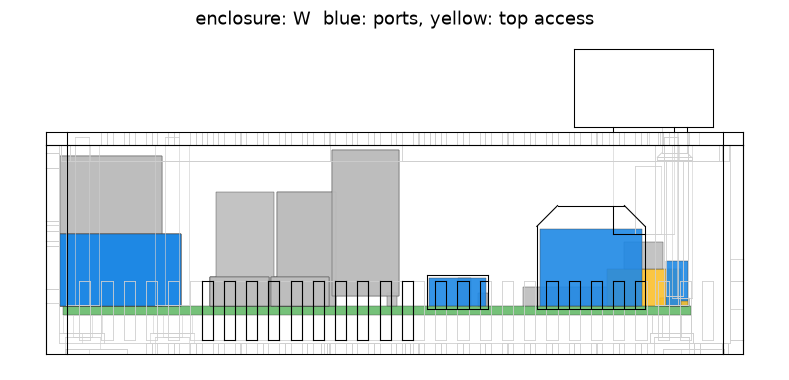
enclosure/out/plus/port-W.png
