Hive-RSI-Lab/hifi-receiver/enclosure/out/plus/top.png

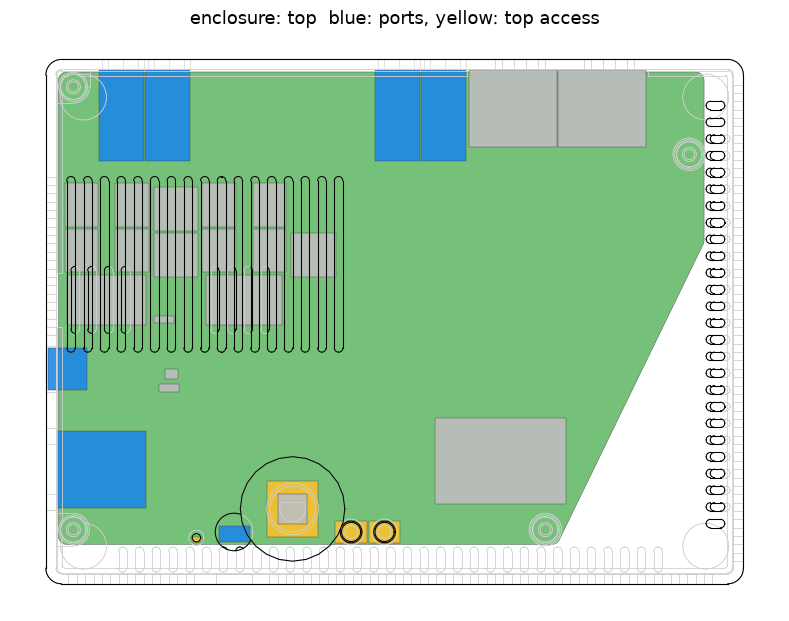
enclosure/out/plus/top.png
