Hive-RSI-Lab/hifi-receiver/enclosure/out/ultra/iso.png

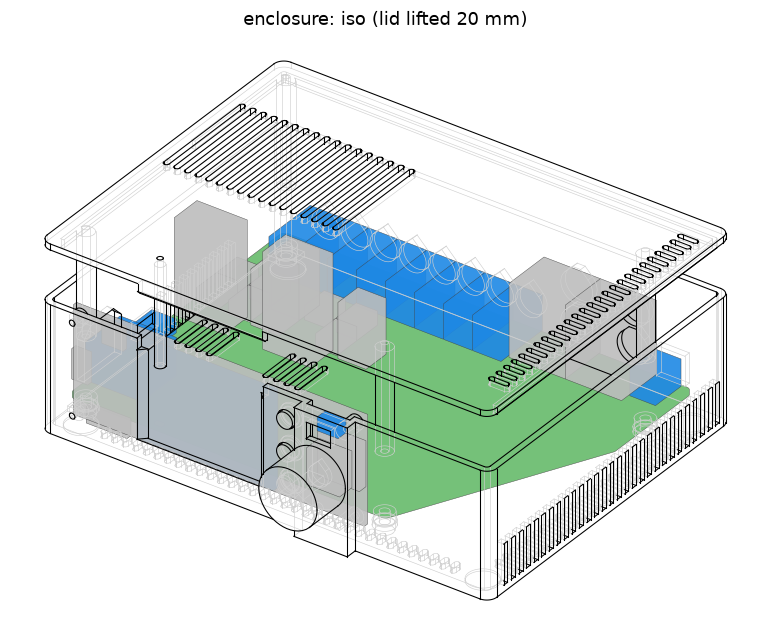
enclosure/out/ultra/iso.png
