Hive-RSI-Lab/hifi-receiver/enclosure/out/ultra/port-N.png

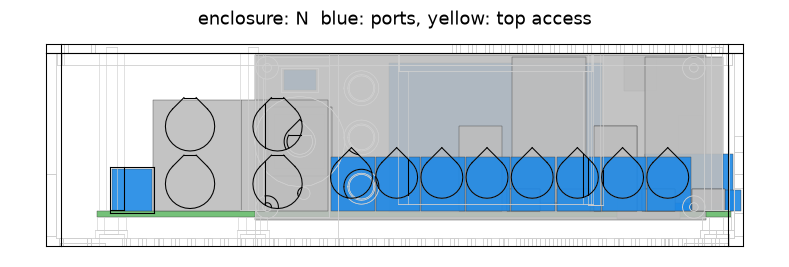
enclosure/out/ultra/port-N.png
