Hive-RSI-Lab/hifi-receiver/enclosure/out/ultra/port-S.png

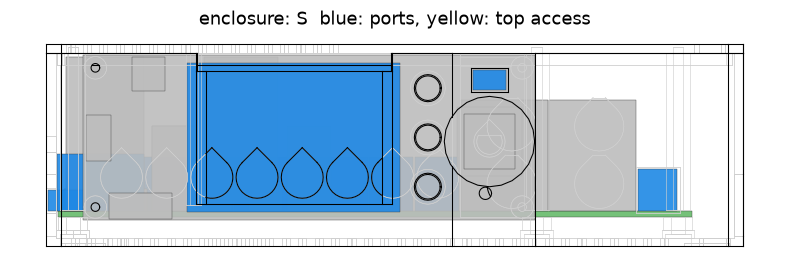
enclosure/out/ultra/port-S.png
