Hive-RSI-Lab/hifi-receiver/enclosure/out/ultra/port-W.png

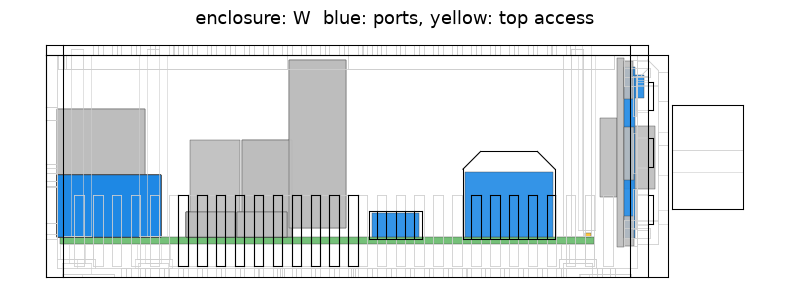
enclosure/out/ultra/port-W.png
