Hive-RSI-Lab/hifi-receiver/enclosure/out/ultra/top.png

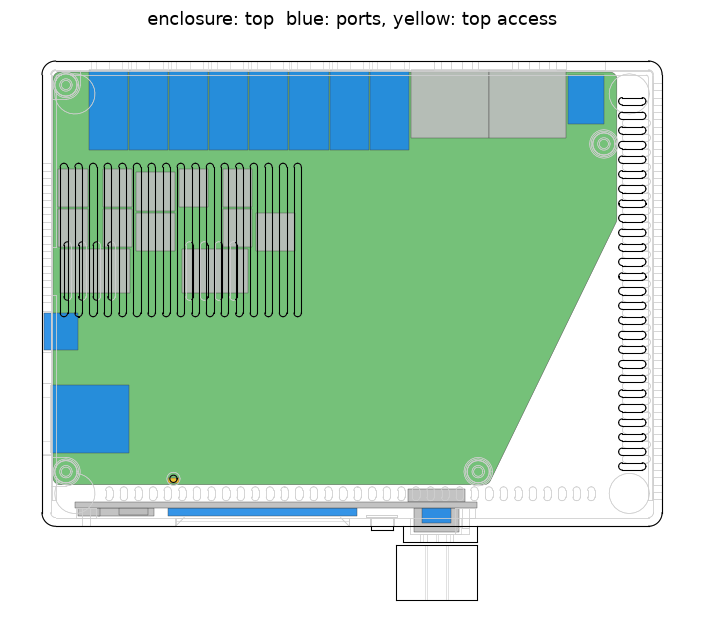
enclosure/out/ultra/top.png
