Hive-RSI-Lab/hifi-receiver/boards/ultra-front/fab/BOM-full.csv

Comment | Designator | Qty Per Board | Footprint | MPN | LCSC | Assembly Class | Instructions
100nF | C1,C4 | 2 | C0603 | CC0603KRX7R9BB104 | C14663 | smt_placed
10uF | C2,C3 | 2 | C0805 | CL21A106KAYNNNE | C15850 | smt_placed
4.7uF | C5 | 1 | C0603 | CL10A475KO8NNNC | C19666 | smt_placed
10nF | C6,C7 | 2 | C0603 | 0603B103K500NT | C57112 | smt_placed
TJ-S1615SW6TGLCCYRGB-A5 | D1 | 1 | LED-SMD_4P-L1.6-W1.5-TR | TJ-S1615SW6TGLCCYRGB-A5 | C273610 | smt_placed
PESD5V0S2BT | D2,D3 | 2 | SOT-23_L2.9-W1.3-P1.90-LS2.4-BR | PESD5V0S2BT,215 | C49338 | smt_placed
FPC-05F-20PH20 | J1 | 1 | FPC-SMD_20P-P0.50_XUNPU_FPC-05F-20PH20 | FPC-05F-20PH20 | C2856803 | smt_placed
FPC-05FB-12PH20 | J2 | 1 | FPC-SMD_12P-P0.50_XUNPU_FPC-05FB-12PH20 | FPC-05FB-12PH20 | C2856829 | smt_placed
AO3400A | Q1 | 1 | SOT-23-3_L2.9-W1.3-P1.90-LS2.4-BR | AO3400A | C20917 | smt_placed
10k | R1,R2,R3,R4,R5,R6,R7,R8,R9,R19 | 10 | R0603 | 0603WAF1002T5E | C25804 | smt_placed
100R | R10,R12 | 2 | R0603 | 0603WAF1000T5E | C22775 | smt_placed
100k | R11 | 1 | R0603 | 0603WAF1003T5E | C25803 | smt_placed
120R | R13,R17,R18 | 3 | R0603 | 0603WAF1200T5E | C22787 | smt_placed
1k | R14 | 1 | R0603 | 0603WAF1001T5E | C21190 | smt_placed
680R | R15,R16 | 2 | R0603 | 0603WAF6800T5E | C23228 | smt_placed
TS-1187A-B-A-B | SW1,SW2,SW3 | 3 | SW-SMD_4P-L5.1-W5.1-P3.70-LS6.5-TL_H1.5 | TS-1187A-B-A-B | C318884 | smt_placed
TCA9535PWR | U1 | 1 | TSSOP-24_L7.8-W4.4-P0.65-LS6.4-BL | TCA9535PWR(UMW) | C22396388 | smt_placed
IRM-H638T/TR2 | U2 | 1 | SENSOR-SMD_IRM-H638T-TR2-TL | IRM-H638T/TR2 | C91447 | smt_placed
EC11E1834403 | SW4 | 1 | SW-TH_EC11E1820402 | EC11E1834403 | C361165 | tht | Through-hole - JLC THT assembly (or hand-solder after reflow); not on the SMT line.
 | H1,H2,H3,H4 | 4 |  |  |  | board_feature | Realised in copper - nothing to buy or place.
