Hive-RSI-Lab/hifi-receiver/docs/review-4/sims/als/out/bom_mute.csv

Comment | Designator | Footprint | LCSC Part #
22uF | C7,C8,C12,C25,C90 | C_0805_2012Metric | C45783
MMBT3904 | Q2,Q3,Q4,Q11,Q12 | SOT-23-3_L2.9-W1.3-P1.90-LS2.4-BR | C20526
2N7002 | Q13,Q14,Q15 | SOT-23-3_L2.9-W1.3-P1.90-LS2.4-BR | C8545
120k | R1,R80 | R_0603_1608Metric | C25808
22k | R16,R81 | R_0603_1608Metric | C31850
47k | R37,R39,R82 | R_0603_1608Metric | C25819
