Hive-RSI-Lab/hifi-receiver/boards/core/fab/BOM-full.csv

Comment | Designator | Qty Per Board | Footprint | MPN | LCSC | Assembly Class | Instructions
1uF | C1,C226,C229,C232,C235,C324,C327,C330,C333 | 9 | C0805 | 1uF | C28323 | smt_placed
100nF | C2,C31,C33,C34,C41,C42,C43,C44,C45,C46,C51,C53,C54,C55,C57,C58,C120,C121,C125,C132,C202,C302 | 22 | C0402 | 100nF | C1525 | smt_placed
10nF | C3,C12,C37,C38,C39 | 5 | C0402 | 10nF | C15195 | smt_placed
220nF | C4 | 1 | C0603 | TCC0603X7R224K500CT | C344195 | smt_placed
470uF/50V | C5,C6,C311 | 3 | CAP-TH_BD10.0-P5.00-D1.0-FD | 470uF/50V | C88733 | smt_placed
10uF | C7,C10 | 2 | C1206 | 10uF | C13585 | smt_placed
4.7uF | C8,C100,C110 | 3 | C0805 | 4.7uF | C1779 | smt_placed
100nF | C9 | 1 | C0402 | 100nF | C307331 | smt_placed
100nF | C11,C208,C210,C308,C310 | 5 | C0603 | 100nF | C14663 | smt_placed
22uF | C13,C14,C16,C17,C30 | 5 | C0805 | 22uF | C45783 | smt_placed
10uF | C15,C21,C22,C59,C201,C301 | 6 | C0603 | 10uF | C19702 | smt_placed
1uF | C18,C19,C32,C40,C47,C50,C52,C68,C69,C70,C122,C123,C124,C131,C137,C204,C206,C304,C306 | 19 | C0402 | 1uF | C52923 | smt_placed
4.7uF | C56,C101,C102,C111,C112,C400 | 6 | C0603 | 4.7uF | C19666 | smt_placed
100uF | C64 | 1 | C1206 | 100uF | C15008 | smt_placed
2.2uF | C65,C66,C67 | 3 | C0603 | 2.2uF | C23630 | smt_placed
1nF | C71,C72,C142,C143,C150,C151 | 6 | C0402 | 1nF | C1523 | smt_placed
470pF | C130,C136 | 2 | C0603 | 470pF | C1620 | smt_placed
1uF | C207,C209,C307,C309 | 4 | C1206 | TCC1206X7R105K101HT | C282823 | smt_placed
33nF | C211,C222,C223,C224,C225,C312,C320,C321,C322,C323 | 10 | C0603 | 33nF | C21117 | smt_placed
10uF | C218,C219,C220,C221,C316,C317,C318,C319 | 8 | C0805 | 10uF | C15850 | smt_placed
470nF | C228,C231,C234,C237,C326,C329,C332,C335 | 8 | C0603 | CC0603KRX7R9BB474 | C513577 | smt_placed
SMBJ30A | D1 | 1 | SMB_L4.6-W3.6-LS5.3-RD | SMBJ30A | C113998 | smt_placed
BZT52C33 | D2 | 1 | SOD-123_L2.7-W1.6-LS3.7-RD | BZT52C33 | C266574 | smt_placed
KT-0603R | D3 | 1 | LED-SMD_L1.6-W0.8-R-RD | KT-0603R | C2286 | smt_placed
BZT52C15 | D4 | 1 | SOD-123_L2.7-W1.6-LS3.7-RD | BZT52C15 | C173427 | smt_placed
BAS16L | D5 | 1 | SOD-882_L1.0-W0.6-RD | BAS16L | C99382 | smt_placed
NUP2105L | D6,D9 | 2 | SOT-23-3_L2.9-W1.3-P1.90-LS2.4-BL-2 | NUP2105LT1G | C14486 | smt_placed
PESD5V0S2BT | D7,D8 | 2 | SOT-23_L2.9-W1.3-P1.90-LS2.4-BR | PESD5V0S2BT,215 | C49338 | smt_placed
120R | FB1,FB2 | 2 | L0603 | 120R | C14709 | smt_placed
USB4085-GF-A | J1 | 1 | USC-C-SMD_USB4085-GF-A | USB4085-GF-A | C7095263 | smt_placed
HR911105A | J2 | 1 | RJ45-TH_HR911105A | HR911105A | C12074 | smt_placed
SUB OUT | J4 | 1 | CONN-TH_XDJK-0271-1650 | XDJK-0271-1650 | C7527522 | smt_placed
LINE IN | J5 | 1 | CONN-TH_XDJK-0271-1650 | XDJK-0271-1650 | C7527522 | smt_placed
24.243 red | J20,J26 | 2 | CONN-TH_24.243.1_RED | 24.243.1 | C7437321 | smt_placed
24.243 black | J21,J27 | 2 | CONN-TH_24.243.2 | 24.243.2 | C7437322 | smt_placed
10uH | L1,L2,L3,L4,L5,L6,L7,L8 | 8 | IND-SMD_L8.5-W8.0_PCC-M0854M | 10uH | C2962885 | smt_placed
4.7uH | L9 | 1 | IND-SMD_L4.0-W4.0 | 4.7uH | C57269 | smt_placed
2.2uH | L10 | 1 | IND-SMD_L4.0-W4.0_LQH44PN2R2MP0L | 2.2uH | C36409 | smt_placed
AO4485 | Q1 | 1 | SOIC-8_L5.0-W4.0-P1.27-LS6.0-BL | AO4485 | C51499 | smt_placed
2N7002 | Q2 | 1 | SOT-23-3_L2.9-W1.3-P1.90-LS2.4-BR | 2N7002 | C8545 | smt_placed
MMDT3904 | Q3 | 1 | SOT-363_L2.0-W1.3-P0.65-LS2.1-TL | MMDT3904 | C83572 | smt_placed
S8050 | Q4,Q5,Q6,Q7 | 4 | SOT-23-3_L3.0-W1.7-P0.95-LS2.9-BR | S8050 | C2146 | smt_placed
10m | R1 | 1 | R2512 | 10m | C393070 | smt_placed
210k | R2 | 1 | R0402 | 210k | C2998176 | smt_placed
1k | R3,R6 | 2 | R0402 | 1k | C11702 | smt_placed
470k | R4,R5 | 2 | R0402 | 470k | C25790 | smt_placed
100k | R7,R10,R11,R12,R15,R40,R41,R42,R43,R44,R102,R112,R120,R132,R134,R138,R149,R150,R213,R214,R215,R404 | 22 | R0402 | 100k | C25741 | smt_placed
10k | R8,R9,R20,R30,R31,R32,R33,R36,R50,R51,R52,R53,R54,R55,R56,R57,R58,R67,R70,R121,R122,R131,R135,R137 | 24 | R0402 | 10k | C25744 | smt_placed
15k | R13 | 1 | R0402 | 15k | C25756 | smt_placed
2k | R14,R72,R74,R80,R82 | 5 | R0402 | 2k | C4109 | smt_placed
22k | R16 | 1 | R0402 | 22k | C25768 | smt_placed
10R | R17,R18,R19 | 3 | R0402 | 10R | C25077 | smt_placed
2.2k | R34,R35,R45 | 3 | R0402 | 2.2k | C25879 | smt_placed
33R | R60,R71 | 2 | R0402 | 33R | C25105 | smt_placed
12k | R61 | 1 | R0402 | 12k | C25752 | smt_placed
1.5k | R62 | 1 | R0402 | 1.5k | C25867 | smt_placed
49.9R | R63,R64,R65,R66 | 4 | R0402 | 49.9R | C25120 | smt_placed
1.3k | R73,R75,R81,R83 | 4 | R0402 | 1.3k | C25866 | smt_placed
470R | R90,R91,R92,R93,R401 | 5 | R0402 | 470R | C25117 | smt_placed
4.7k | R100,R101,R110,R111 | 4 | R0402 | 4.7k | C25900 | smt_placed
150k | R130,R136 | 2 | R0603 | 150k | C22807 | smt_placed
47k | R133,R216,R217,R314 | 4 | R0402 | 47k | C25792 | smt_placed
4.7R | R203,R205,R227,R230,R233,R236,R303,R305,R325,R328,R331,R334 | 12 | R0603 | 4.7R | C23164 | smt_placed
20k | R212 | 1 | R0402 | 20k | C25765 | smt_placed
75k | R313 | 1 | R0402 | 75k | C25798 | smt_placed
0R | R315 | 1 | R0402 | 0R | C17168 | smt_placed
100R | R400 | 1 | R0402 | 100R | C25076 | smt_placed
EC11 | SW1 | 1 | SW-TH_EC11E1820402 | EC11 | C361165 | smt_placed
BTN1 | SW2 | 1 | SW-SMD_4P-L5.1-W5.1-P3.70-LS6.5-TL_H1.5 | TS-1187A-B-A-B | C318884 | smt_placed
BTN2 | SW3 | 1 | SW-SMD_4P-L5.1-W5.1-P3.70-LS6.5-TL_H1.5 | TS-1187A-B-A-B | C318884 | smt_placed
CH224Q | U1 | 1 | DFN-10_L2.0-W2.0-P0.40-BL-EP | CH224Q | C46061833 | smt_placed
USBLC6-2SC6 | U2 | 1 | SOT-23-6_L2.9-W1.6-P0.95-LS2.8-BL | USBLC6-2SC6 | C2687116 | smt_placed
INA186A1 | U3 | 1 | SC-70-6_L2.2-W1.3-P0.65-LS2.1-BR | INA186A1 | C2058311 | smt_placed
SY8303AIC | U4 | 1 | TSOT-23-8_L2.9-W1.6-P0.65-LS2.8-BR | SY8303AIC | C97054 | smt_placed
SY8089A1AAC | U5 | 1 | TSOT-23-5_L2.9-W1.6-P0.95-LS2.8-BR | SY8089A1AAC | C479074 | smt_placed
LP5907-3.3 | U6 | 1 | SOT-23-5_L3.0-W1.7-P0.95-LS2.8-BR | LP5907-3.3 | C80670 | smt_placed
ESP32-WROVER-E-N8R8 | U7 | 1 | WIFI-SMD_ESP32-WROVER-IE8MB | ESP32-WROVER-E-N8R8 | C2973667 | smt_placed
CH340B | U8 | 1 | SOP-16_L10.0-W3.9-P1.27-LS6.0-BL | CH340B | C81010 | smt_placed
LAN8720A | U9 | 1 | QFN-24_L4.0-W4.0-P0.50-BL-EP2.6 | LAN8720A | C45223 | smt_placed
ES9018K2M | U10 | 1 | QFN-28_L5.0-W5.0-P0.50-BL-EP3.3 | ES9018K2M | C2688377 | smt_placed
OPA1678 | U11 | 1 | SOIC-8_L5.0-W4.0-P1.27-LS6.0-BL | OPA1678 | C192421 | smt_placed
PCM5102A | U12 | 1 | TSSOP-20_L6.5-W4.4-P0.65-LS6.4-BL | PCM5102A | C107671 | smt_placed
ES7243E | U13 | 1 | QFN-20_L3.0-W3.0-P0.40-BL-EP1.7 | ES7243E | C2929446 | smt_placed
TS5A23157 | U14,U20 | 2 | MSOP-10_L3.0-W3.0-P0.50-LS5.0-BL | TS5A23157 | C11133 | smt_placed
TPA3220 | U15,U16 | 2 | HTSSOP-44-1EP_L14.0-W6.1-P0.64-LS8.1-EP7.3x4.43 | TPA3220 | C2879306 | smt_placed
TCA9539 | U17 | 1 | TSSOP-24_L7.8-W4.4-P0.65-LS6.4-BL | TCA9539 | C131972 | smt_placed
IRM-3638T | U18 | 1 | OPTO-TH_IRM-3638T | IRM-3638T | C42421366 | smt_placed
TLV803S | U21 | 1 | SOT-23-3_L2.9-W1.3-P1.90-LS2.4-BR | TLV803SDBZR | C132016 | smt_placed
49.152MHz | Y1 | 1 | OSC-SMD_4P-L3.2-W2.5-BL | 49.152MHz | C7431354 | smt_placed
50MHz | Y2 | 1 | OSC-SMD_4P-L3.2-W2.5-BL | 50MHz | C717684 | smt_placed
100nF | C126 | 1 | C0402 | 100nF | C1525 | dnp | DO NOT POPULATE - this land ships empty.
120R | FB3 | 1 | L0603 | 120R | C14709 | dnp | DO NOT POPULATE - this land ships empty.
FFC 20P | J3 | 1 | FPC-SMD_20P-P0.50_XUNPU_FPC-05F-20PH20 | FFC 20P | C2856803 | dnp | DO NOT POPULATE - this land ships empty.
24.243 red | J22,J24 | 2 | CONN-TH_24.243.1_RED | 24.243.1 | C7437321 | dnp | DO NOT POPULATE - this land ships empty.
24.243 black | J23,J25 | 2 | CONN-TH_24.243.2 | 24.243.2 | C7437322 | dnp | DO NOT POPULATE - this land ships empty.
33R | R402,R403 | 2 | R0402 | 33R | C25105 | dnp | DO NOT POPULATE - this land ships empty.
PLR237/T8BK | U19 | 1 | OPTO-TH_PLR237-T10BK | PLR237/T8BK | C17223620 | dnp | DO NOT POPULATE - this land ships empty.
 | H1,H2,H3,H4 | 4 |  |  |  | board_feature | Realised in copper - nothing to buy or place.
