Hive-RSI-Lab/hifi-receiver/enclosure/out/lite/a1mini/lite-lid-buttons.3mf

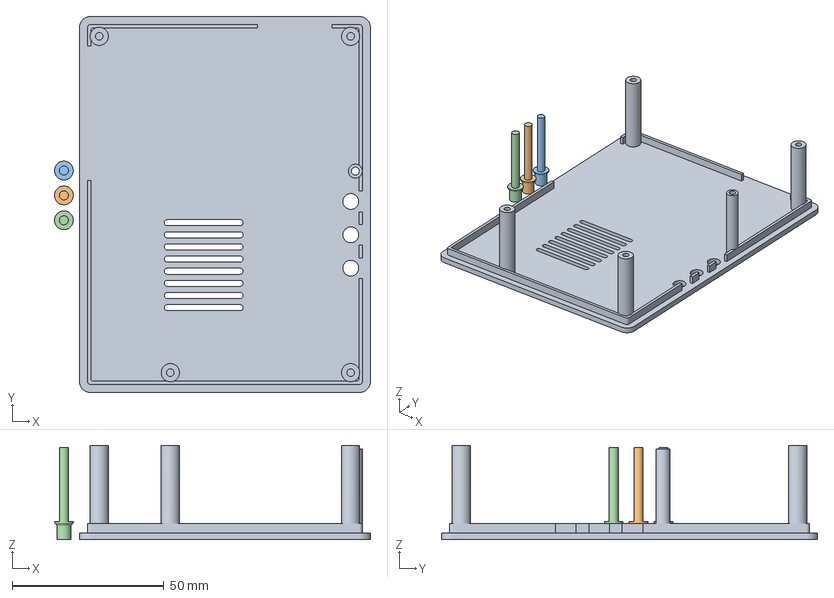
[picture p35: CAD file, 2026-11-05]
enclosure/out/lite/a1mini/lite-lid-buttons.3mf
104.2 x 124.0 x 31.0 mm
lid.stl
btn_SW1.stl
btn_SW2.stl
btn_SW3.stl
