Hive-RSI-Lab/hifi-receiver/enclosure/out/lite/base.stl

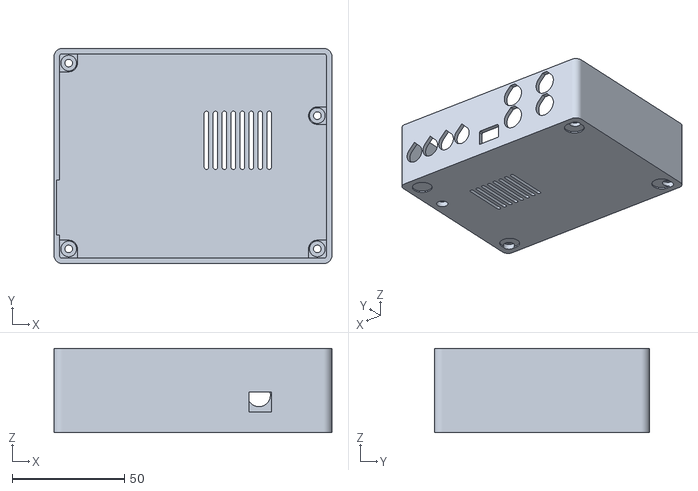
[picture p36: CAD file, 2026-11-05]
enclosure/out/lite/base.stl
124.0 x 96.0 x 37.6
