Hive-RSI-Lab/hifi-receiver/enclosure/out/plus/enclosure.step

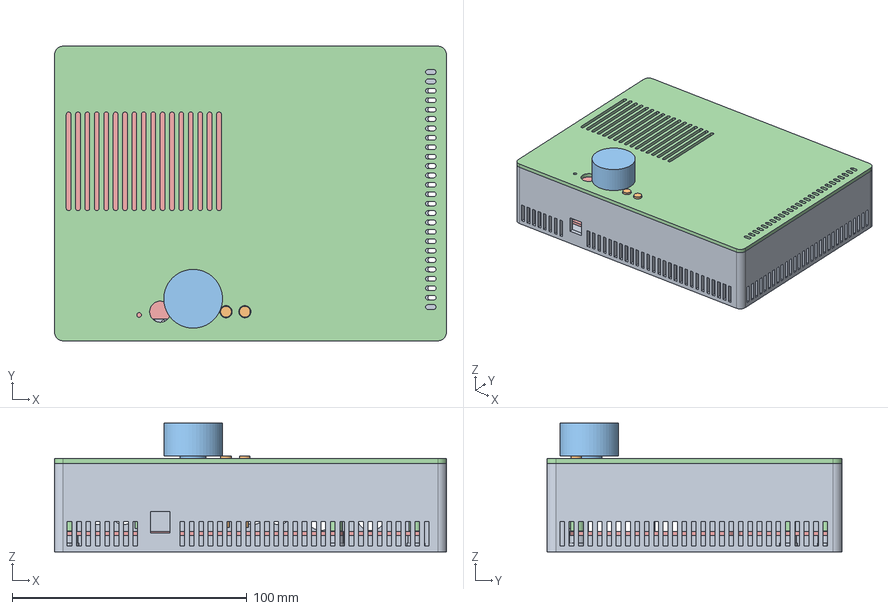
[picture p37: CAD file, 2026-11-01]
enclosure/out/plus/enclosure.step
166.8 x 125.4 x 54.8 mm
base
btn_SW2
btn_SW3
knob
lid
board
