Hive-RSI-Lab/hifi-receiver/enclosure/out/ultra/enclosure.step

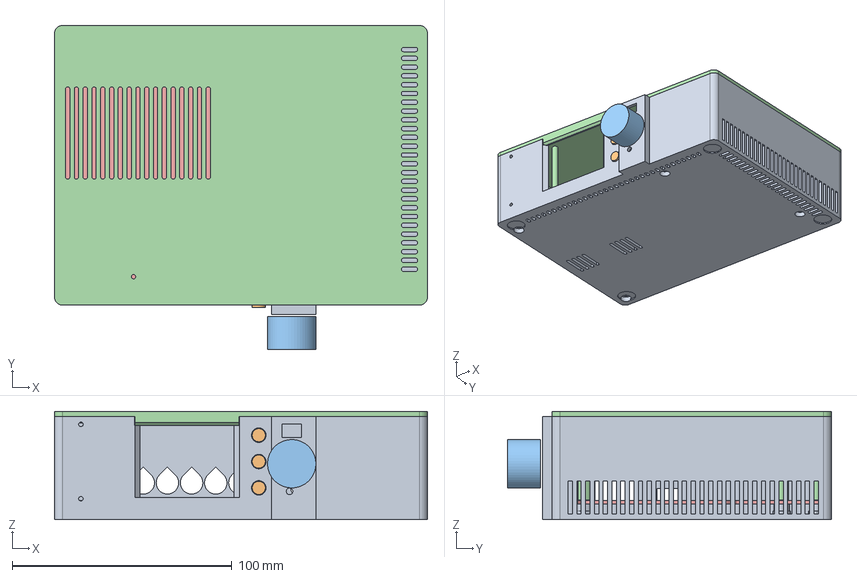
[picture p38: CAD file, 2026-11-01]
enclosure/out/ultra/enclosure.step
169.8 x 147.6 x 49.2 mm
base
btn_FSW1
btn_FSW2
btn_FSW3
knob
lid
board
