Hive-RSI-Lab/hifi-receiver/enclosure/out/lite/enclosure.step

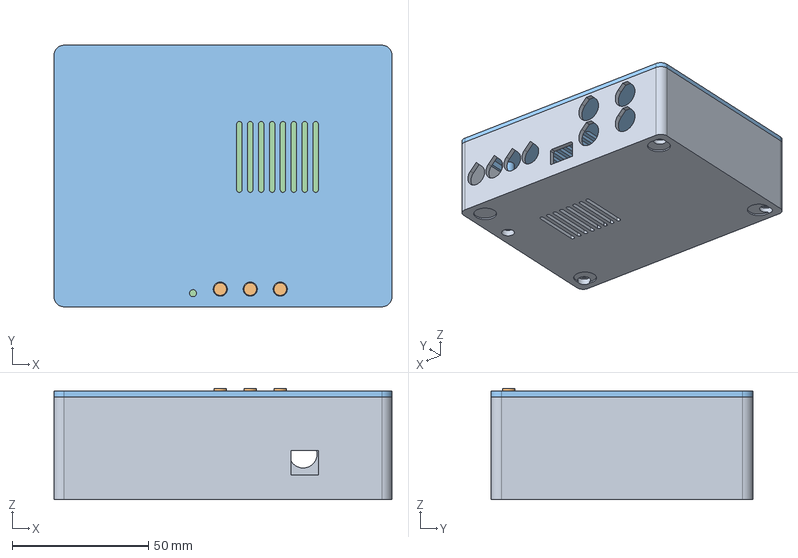
[picture p39: CAD file, 2026-11-05]
enclosure/out/lite/enclosure.step
124.0 x 96.0 x 40.8 mm
base
btn_SW1
btn_SW2
btn_SW3
lid
board
