Hive-RSI-Lab/hifi-receiver/enclosure/out/plus/lid.stl

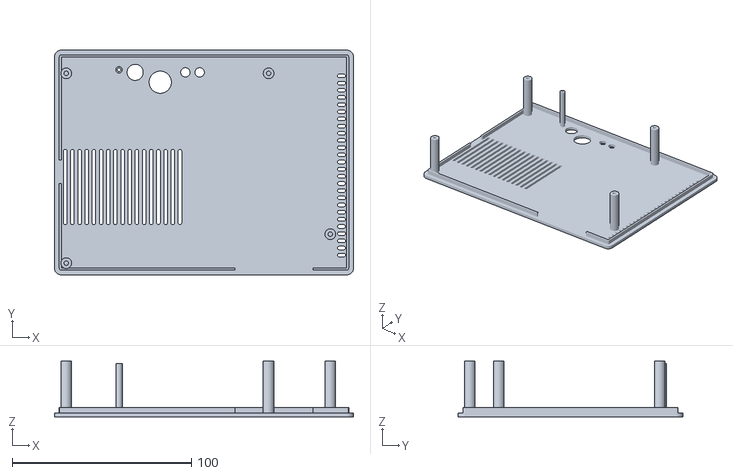
[picture p40: CAD file, 2026-11-01]
enclosure/out/plus/lid.stl
166.8 x 125.4 x 31.0
