Hive-RSI-Lab/hifi-receiver/enclosure/out/ultra/base.stl

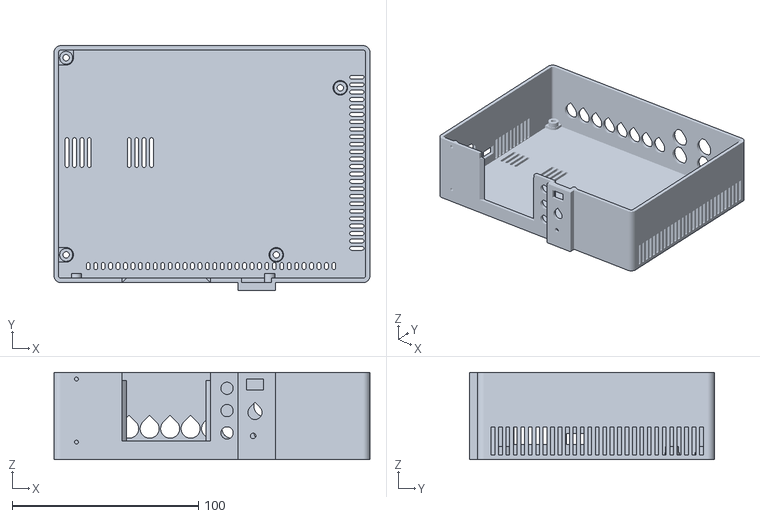
[picture p41: CAD file, 2026-11-01]
enclosure/out/ultra/base.stl
169.8 x 131.6 x 47.0
