Hive-RSI-Lab/hifi-receiver/enclosure/out/lite/lid.stl

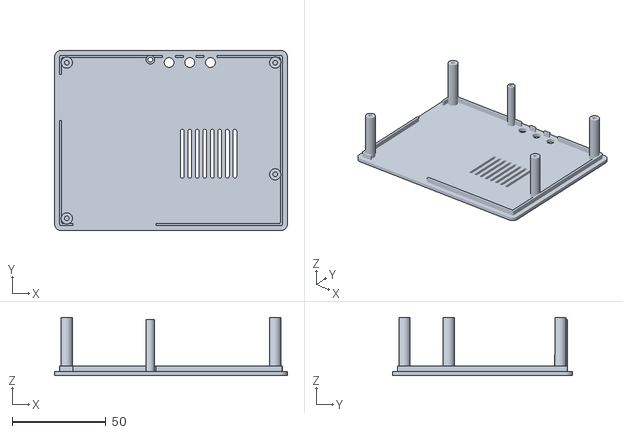
[picture p42: CAD file, 2026-11-05]
enclosure/out/lite/lid.stl
124.0 x 96.0 x 31.0
