Hive-RSI-Lab/hifi-receiver/enclosure/out/plus/base.stl

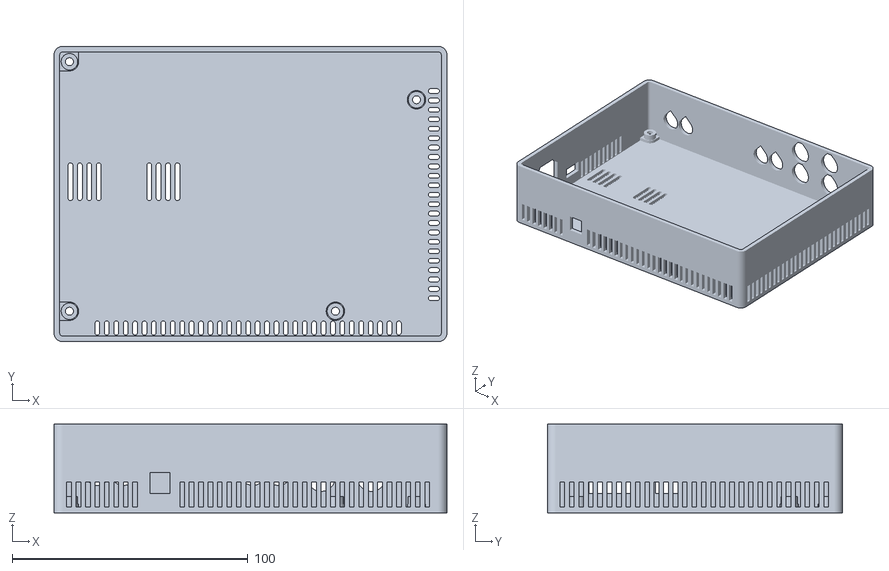
[picture p43: CAD file, 2026-11-01]
enclosure/out/plus/base.stl
166.8 x 125.4 x 37.6
