Hive-RSI-Lab/hifi-receiver/enclosure/out/ultra/lid.stl

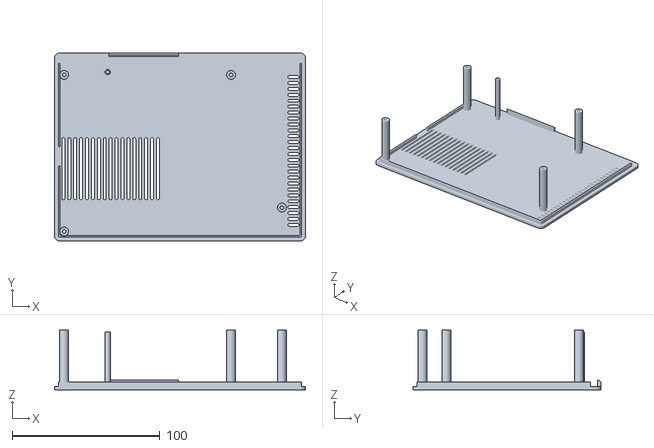
[picture p44: CAD file, 2026-11-01]
enclosure/out/ultra/lid.stl
169.8 x 127.4 x 40.4
