Hive-RSI-Lab/hifi-receiver/enclosure/out/lite/btn_SW1.stl

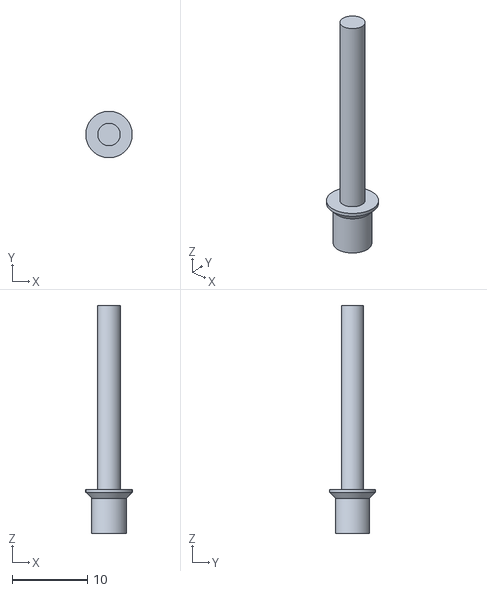
[picture p45: CAD file, 2026-10-30]
enclosure/out/lite/btn_SW1.stl
6.20 x 6.20 x 30.4
