Hive-RSI-Lab/hifi-receiver/enclosure/out/ultra/btn_FSW2.stl

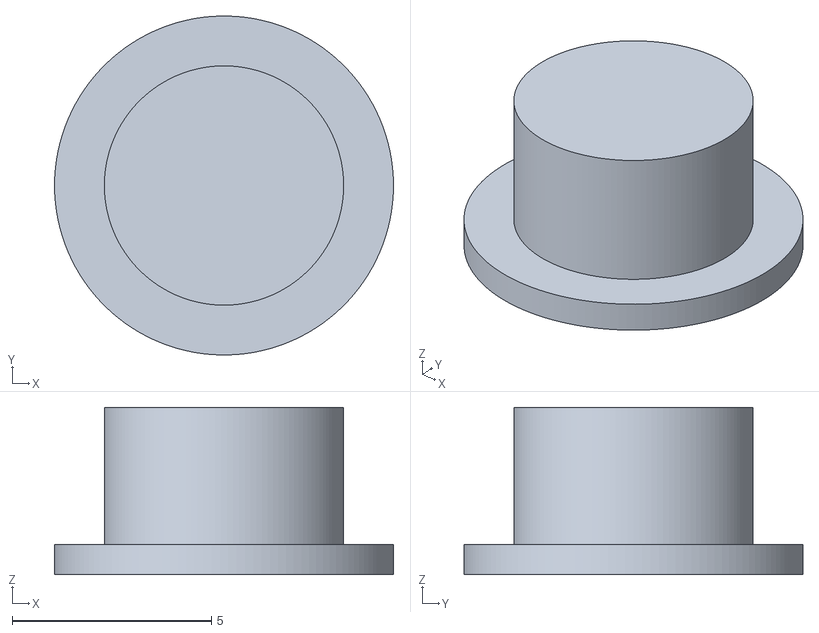
[picture p46: CAD file, 2026-10-30]
enclosure/out/ultra/btn_FSW2.stl
8.50 x 8.50 x 4.19
