Hive-RSI-Lab/hifi-receiver/enclosure/out/plus/knob.stl

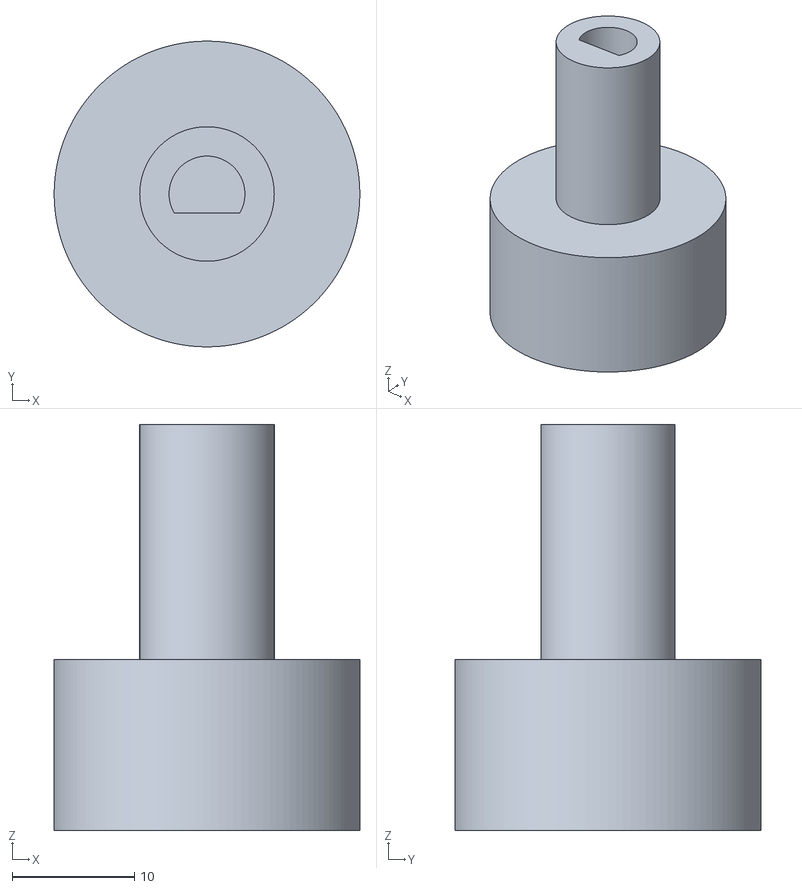
[picture p47: CAD file, 2026-10-29]
enclosure/out/plus/knob.stl
25.0 x 25.0 x 33.2
