Hive-RSI-Lab/hifi-receiver/enclosure/out/ultra/knob.stl

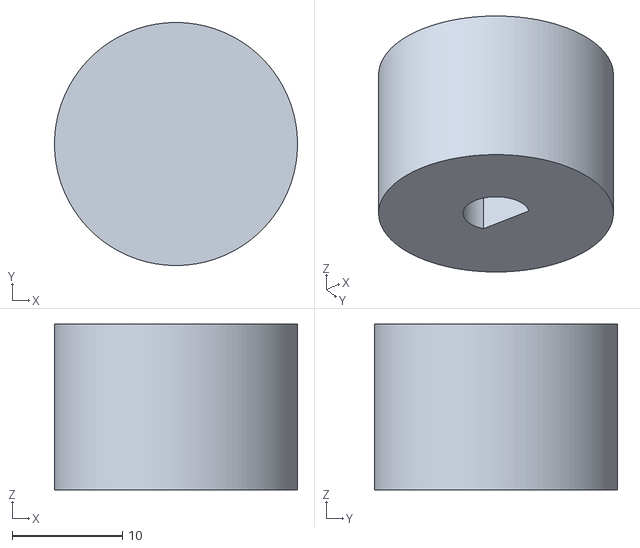
[picture p48: CAD file, 2026-10-29]
enclosure/out/ultra/knob.stl
22.0 x 22.0 x 15.0
