Hive-RSI-Lab/hifi-receiver/(list of files, cad)

Other CAD files:
enclosure/out/lite/a1mini/lite-base.3mf
enclosure/out/plus/btn_SW3.stl
enclosure/out/lite/btn_SW3.stl
enclosure/out/plus/btn_SW2.stl
enclosure/out/ultra/btn_FSW1.stl
enclosure/out/lite/btn_SW2.stl
enclosure/out/ultra/btn_FSW3.stl
