Hive-RSI-Lab/hifi-receiver/boards/core/renders/manual/core_top.png

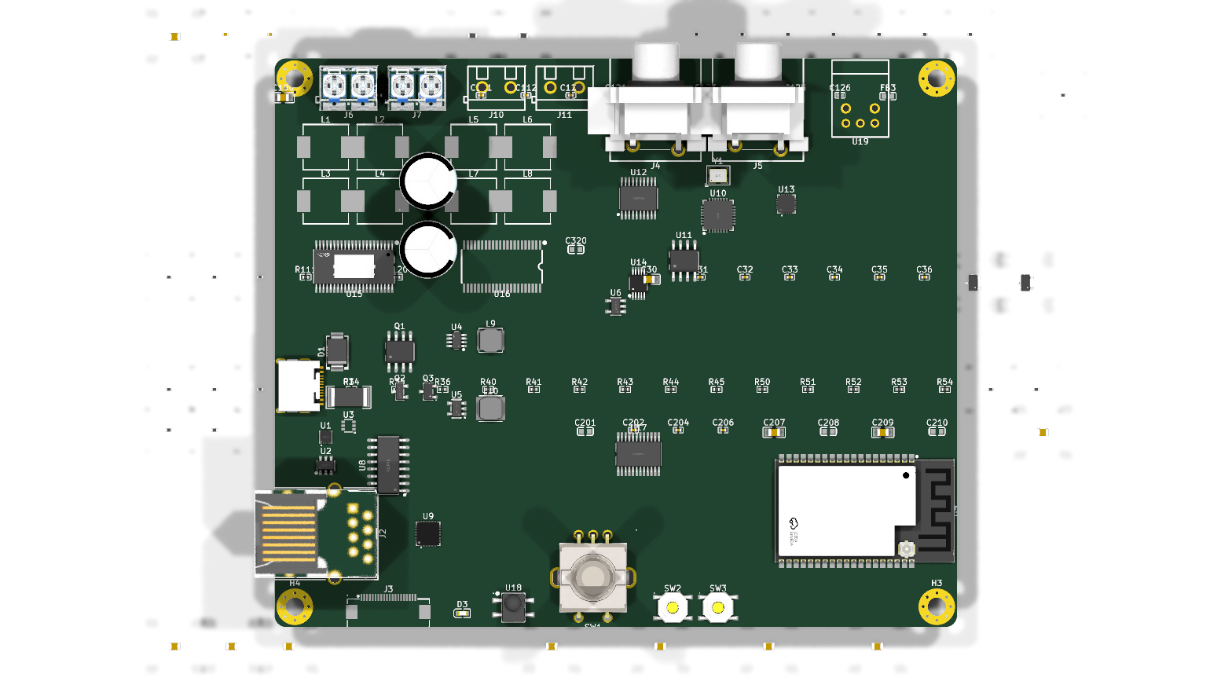
boards/core/renders/manual/core_top.png
