Hive-RSI-Lab/hifi-receiver/.hive/lessons.md

# Lessons

What was tried and why it didn't stay. Read before working here.

- 2026-10-30: "hifi's score runs on the forge: a 'score' CI job using the KiCad and hwde CI already installs" (PR #128, e84b8eee) was reverted: the tests went red after it merged: verify: pass | dfm: pass | ultra-front: gates erc, drc_routed, verify, dfm | erc: pass | drc_routed: pass | verify: pass | dfm: pass | test: FAIL (1): core verify
