Hive-RSI-Lab/hifi-receiver/boards/ultra-front/reports/renders/ultra-front-B.Cu.pdf

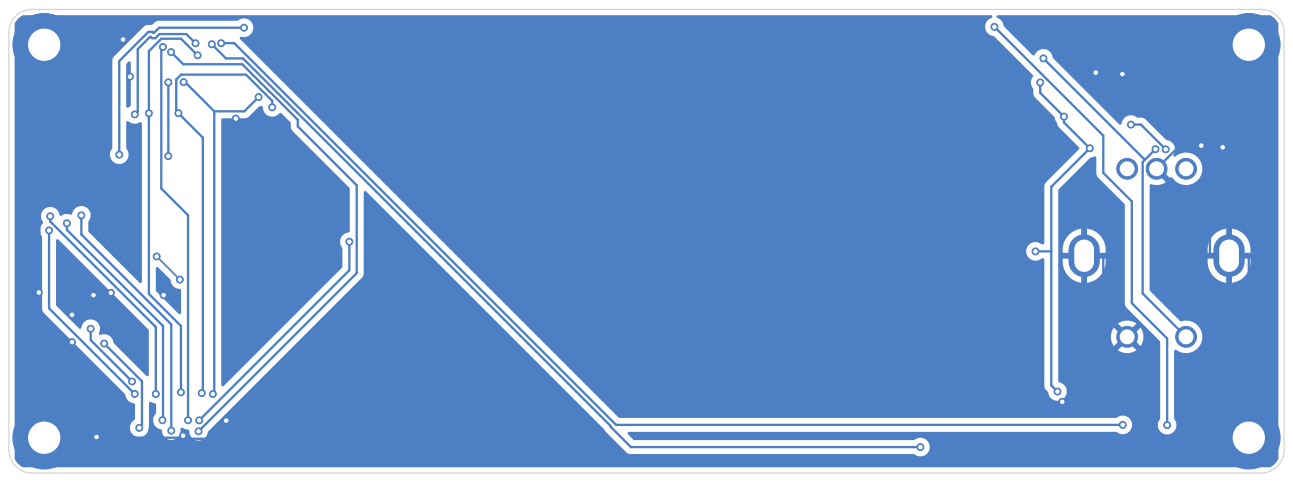
[picture p50: page 1]
