Hive-RSI-Lab/hifi-receiver/boards/ultra-front/reports/renders/ultra-front-F.Cu.pdf

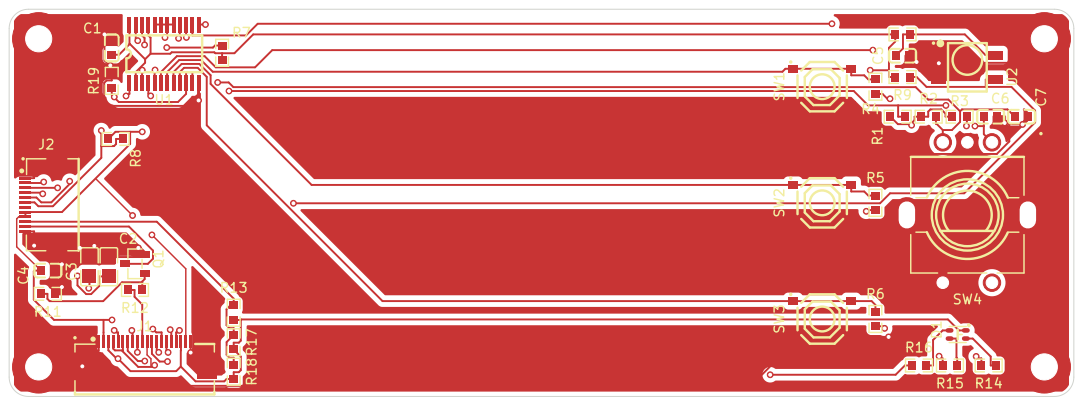
[picture p51: page 1]
