Hive-RSI-Lab/hifi-receiver/(list of files, drawings)

Other design files:
boards/core/parts/easyeda/C14486.json
boards/core/parts/easyeda/C15008.json
boards/core/parts/easyeda/C132016.json
boards/core/parts/easyeda/C282823.json
boards/core/parts/easyeda/C344195.json
boards/core/parts/easyeda/C513577.json
boards/core/parts/easyeda/C7437321.json
boards/core/parts/easyeda/C7437322.json
boards/lite-main/parts/easyeda/C8545.json
boards/lite-main/parts/easyeda/C110694.json
boards/lite-main/parts/easyeda/C2883765.json
boards/ultra-front/parts/easyeda/C49338.json
docs/review-3/sims/layout/easyeda-cache/C1523.json
docs/review-3/sims/layout/easyeda-cache/C1525.json
docs/review-3/sims/layout/easyeda-cache/C1588.json
docs/review-3/sims/layout/easyeda-cache/C1620.json
docs/review-3/sims/layout/easyeda-cache/C1622.json
docs/review-3/sims/layout/easyeda-cache/C1653.json
docs/review-3/sims/layout/easyeda-cache/C1671.json
docs/review-3/sims/layout/easyeda-cache/C1779.json
docs/review-3/sims/layout/easyeda-cache/C1848.json
docs/review-3/sims/layout/easyeda-cache/C2146.json
docs/review-3/sims/layout/easyeda-cache/C2286.json
docs/review-3/sims/layout/easyeda-cache/C4109.json
docs/review-3/sims/layout/easyeda-cache/C4184.json
docs/review-3/sims/layout/easyeda-cache/C4190.json
docs/review-3/sims/layout/easyeda-cache/C4216.json
docs/review-3/sims/layout/easyeda-cache/C8545.json
docs/review-3/sims/layout/easyeda-cache/C11133.json
docs/review-3/sims/layout/easyeda-cache/C11702.json
docs/review-3/sims/layout/easyeda-cache/C12074.json
docs/review-3/sims/layout/easyeda-cache/C13585.json
docs/review-3/sims/layout/easyeda-cache/C14663.json
docs/review-3/sims/layout/easyeda-cache/C14709.json
docs/review-3/sims/layout/easyeda-cache/C14858.json
docs/review-3/sims/layout/easyeda-cache/C15195.json
docs/review-3/sims/layout/easyeda-cache/C15849.json
docs/review-3/sims/layout/easyeda-cache/C15850.json
docs/review-3/sims/layout/easyeda-cache/C17168.json
docs/review-3/sims/layout/easyeda-cache/C19666.json
docs/review-3/sims/layout/easyeda-cache/C19702.json
docs/review-3/sims/layout/easyeda-cache/C20526.json
docs/review-3/sims/layout/easyeda-cache/C20917.json
docs/review-3/sims/layout/easyeda-cache/C21117.json
docs/review-3/sims/layout/easyeda-cache/C21120.json
docs/review-3/sims/layout/easyeda-cache/C21189.json
docs/review-3/sims/layout/easyeda-cache/C21190.json
docs/review-3/sims/layout/easyeda-cache/C22775.json
docs/review-3/sims/layout/easyeda-cache/C22787.json
docs/review-3/sims/layout/easyeda-cache/C22797.json
docs/review-3/sims/layout/easyeda-cache/C22807.json
docs/review-3/sims/layout/easyeda-cache/C22809.json
docs/review-3/sims/layout/easyeda-cache/C22961.json
docs/review-3/sims/layout/easyeda-cache/C23164.json
docs/review-3/sims/layout/easyeda-cache/C23228.json
docs/review-3/sims/layout/easyeda-cache/C23630.json
docs/review-3/sims/layout/easyeda-cache/C25076.json
docs/review-3/sims/layout/easyeda-cache/C25077.json
docs/review-3/sims/layout/easyeda-cache/C25105.json
docs/review-3/sims/layout/easyeda-cache/C25117.json
docs/review-3/sims/layout/easyeda-cache/C25120.json
docs/review-3/sims/layout/easyeda-cache/C25741.json
docs/review-3/sims/layout/easyeda-cache/C25744.json
docs/review-3/sims/layout/easyeda-cache/C25752.json
docs/review-3/sims/layout/easyeda-cache/C25756.json
docs/review-3/sims/layout/easyeda-cache/C25765.json
docs/review-3/sims/layout/easyeda-cache/C25768.json
docs/review-3/sims/layout/easyeda-cache/C25790.json
docs/review-3/sims/layout/easyeda-cache/C25792.json
docs/review-3/sims/layout/easyeda-cache/C25798.json
docs/review-3/sims/layout/easyeda-cache/C25803.json
docs/review-3/sims/layout/easyeda-cache/C25804.json
docs/review-3/sims/layout/easyeda-cache/C25808.json
docs/review-3/sims/layout/easyeda-cache/C25819.json
docs/review-3/sims/layout/easyeda-cache/C25866.json
docs/review-3/sims/layout/easyeda-cache/C25867.json
docs/review-3/sims/layout/easyeda-cache/C25879.json
docs/review-3/sims/layout/easyeda-cache/C25900.json
docs/review-3/sims/layout/easyeda-cache/C28323.json
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
