Hive-RSI-Lab/hifi-receiver/boards/core/kicad/core.kicad_pcb

## KiCad design boards/core/kicad/core.kicad_pcb (2026-11-05)

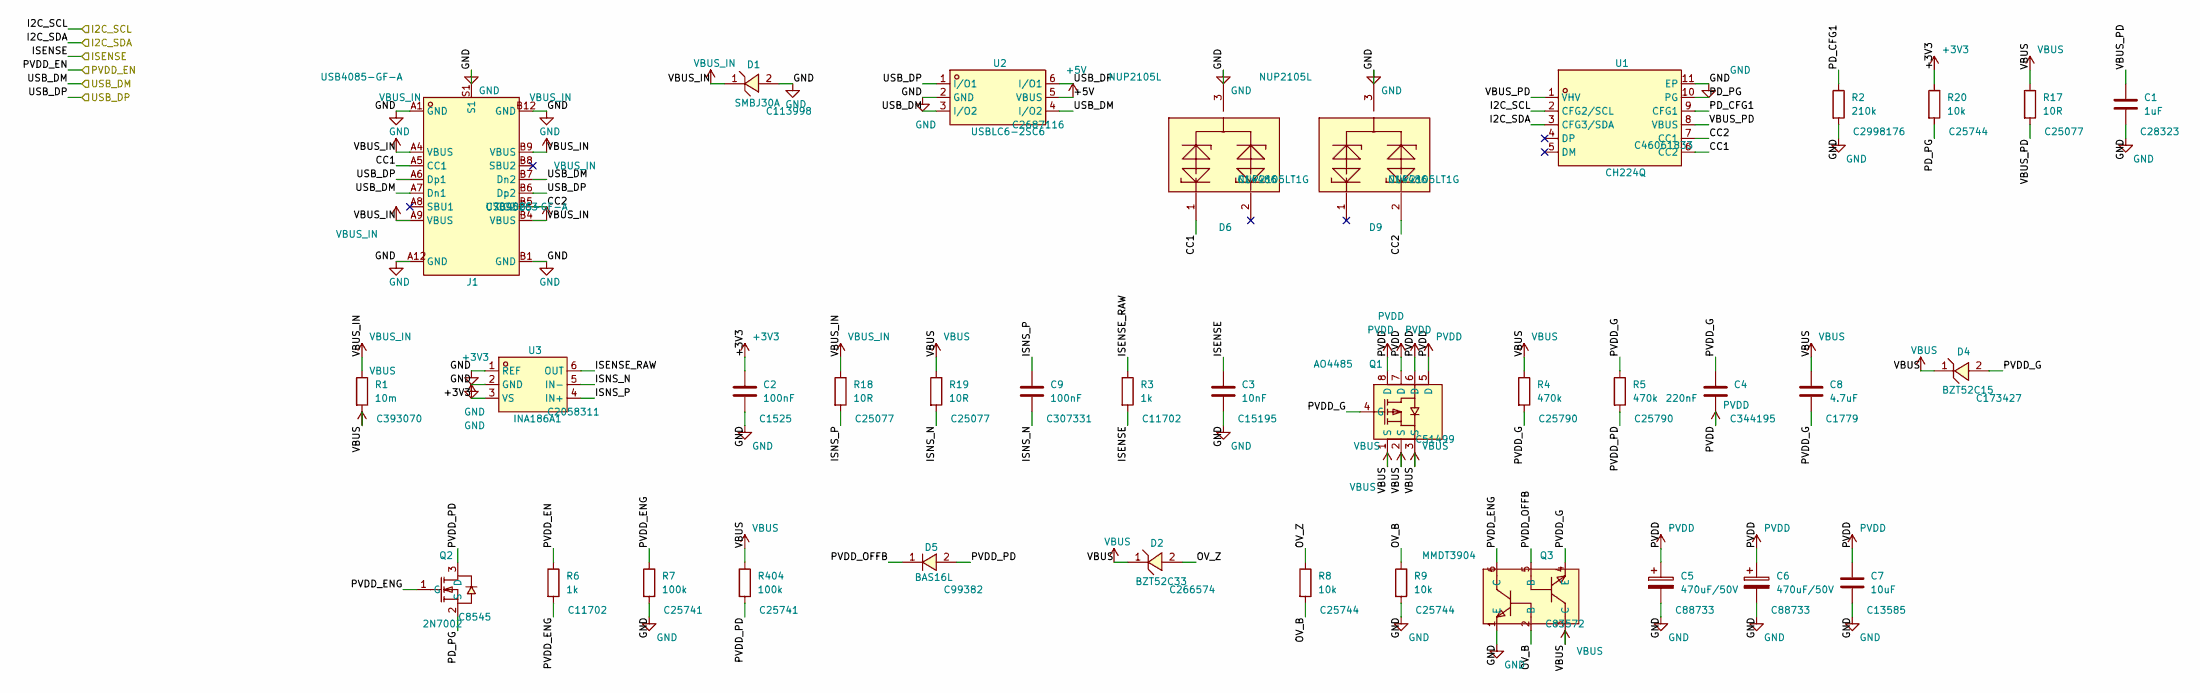
[picture p52: schematic power_in.kicad_sch, core: USB-C PD input, current sense, PVDD switch]

Parts:
C1: 1uF; C0805; LCSC C28323
C2: 100nF; C0402; LCSC C1525
C3: 10nF; C0402; LCSC C15195
C4: 220nF; C0603; LCSC C344195
C5, C6: 470uF/50V; CAP-TH_BD10.0-P5.00-D1.0-FD; LCSC C88733
C7: 10uF; C1206; LCSC C13585
C8: 4.7uF; C0805; LCSC C1779
C9: 100nF; C0402; LCSC C307331
D1: SMBJ30A; SMB_L4.6-W3.6-LS5.3-RD; LCSC C113998
D2: BZT52C33; SOD-123_L2.7-W1.6-LS3.7-RD; LCSC C266574
D4: BZT52C15; SOD-123_L2.7-W1.6-LS3.7-RD; LCSC C173427
D5: BAS16L; SOD-882_L1.0-W0.6-RD; LCSC C99382
D6, D9: NUP2105L; SOT-23-3_L2.9-W1.3-P1.90-LS2.4-BL-2; MPN NUP2105LT1G; LCSC C14486
J1: USB4085-GF-A; USC-C-SMD_USB4085-GF-A; MPN USB4085-GF-A; LCSC C7095263
Q1: AO4485; SOIC-8_L5.0-W4.0-P1.27-LS6.0-BL; LCSC C51499
Q2: 2N7002; SOT-23-3_L2.9-W1.3-P1.90-LS2.4-BR; LCSC C8545
Q3: MMDT3904; SOT-363_L2.0-W1.3-P0.65-LS2.1-TL; LCSC C83572
R1: 10m; R2512; LCSC C393070
R2: 210k; R0402; LCSC C2998176
R3, R6: 1k; R0402; LCSC C11702
R4, R5: 470k; R0402; LCSC C25790
R7, R404: 100k; R0402; LCSC C25741
R8, R9, R20: 10k; R0402; LCSC C25744
R17, R18, R19: 10R; R0402; LCSC C25077
U1: CH224Q; DFN-10_L2.0-W2.0-P0.40-BL-EP; LCSC C46061833
U2: USBLC6-2SC6; SOT-23-6_L2.9-W1.6-P0.95-LS2.8-BL; LCSC C2687116
U3: INA186A1; SC-70-6_L2.2-W1.3-P0.65-LS2.1-BR; LCSC C2058311

Connections:
+3V3: C2.1, R20.1, U3.3 (VS); also elsewhere on the board
+5V: U2.5 (VBUS); also elsewhere on the board
/I2C_SCL: U1.2 (CFG2/SCL); also elsewhere on the board
/I2C_SDA: U1.3 (CFG3/SDA); also elsewhere on the board
/ISENSE: C3.1, R3.2; also elsewhere on the board
/PVDD_EN: R6.1; also elsewhere on the board
/USB_DM: J1.A7 (Dn1), J1.B7 (Dn2), U2.3 (I/O2), U2.4 (I/O2); also elsewhere on the board
/USB_DP: J1.A6 (Dp1), J1.B6 (Dp2), U2.1 (I/O1), U2.6 (I/O1); also elsewhere on the board
/power_in/CC1: D6.1, J1.A5 (CC1), U1.6 (CC2)
/power_in/CC2: D9.2, J1.B5 (CC2), U1.7 (CC1)
/power_in/ISENSE_RAW: R3.1, U3.6 (OUT)
/power_in/ISNS_N: C9.2, R19.2, U3.5 (IN-)
/power_in/ISNS_P: C9.1, R18.2, U3.4 (IN+)
/power_in/OV_B: Q3.2 (B), R8.2, R9.1
/power_in/OV_Z: D2.2, R8.1
/power_in/PD_CFG1: R2.1, U1.9 (CFG1)
/power_in/PD_PG: Q2.2 (S), R20.2, U1.10 (PG)
/power_in/PVDD_ENG: Q2.1 (G), Q3.6 (C), R6.2, R7.1
/power_in/PVDD_G: C4.1, C8.2, D4.2 (A), Q1.4 (G), Q3.4 (E), R4.2, R5.1
/power_in/PVDD_OFFB: D5.1 (K), Q3.5 (B)
/power_in/PVDD_PD: D5.2 (A), Q2.3 (D), R5.2, R404.2
/power_in/VBUS_PD: C1.1, R17.2, U1.1 (VHV), U1.8 (VBUS)
GND: C1.2, C2.2, C3.2, C5.2, C6.2, C7.2, D1.2 (A), D6.3, D9.3, J1.A1 (GND), J1.A12 (GND), J1.B1 (GND), J1.B12 (GND), J1.S1, Q3.1 (E), R2.2, R7.2, R9.2, U1.11 (EP), U2.2 (GND), U3.1 (REF), U3.2 (GND); also elsewhere on the board
PVDD: C4.2, C5.1, C6.1, C7.1, Q1.5 (D), Q1.6 (D), Q1.7 (D), Q1.8 (D); also elsewhere on the board
VBUS: C8.1, D2.1, D4.1 (K), Q1.1 (S), Q1.2 (S), Q1.3 (S), Q3.3 (C), R1.2, R4.1, R17.1, R19.1, R404.1; also elsewhere on the board
VBUS_IN: D1.1 (C), J1.A4 (VBUS), J1.A9 (VBUS), J1.B4 (VBUS), J1.B9 (VBUS), R1.1, R18.1

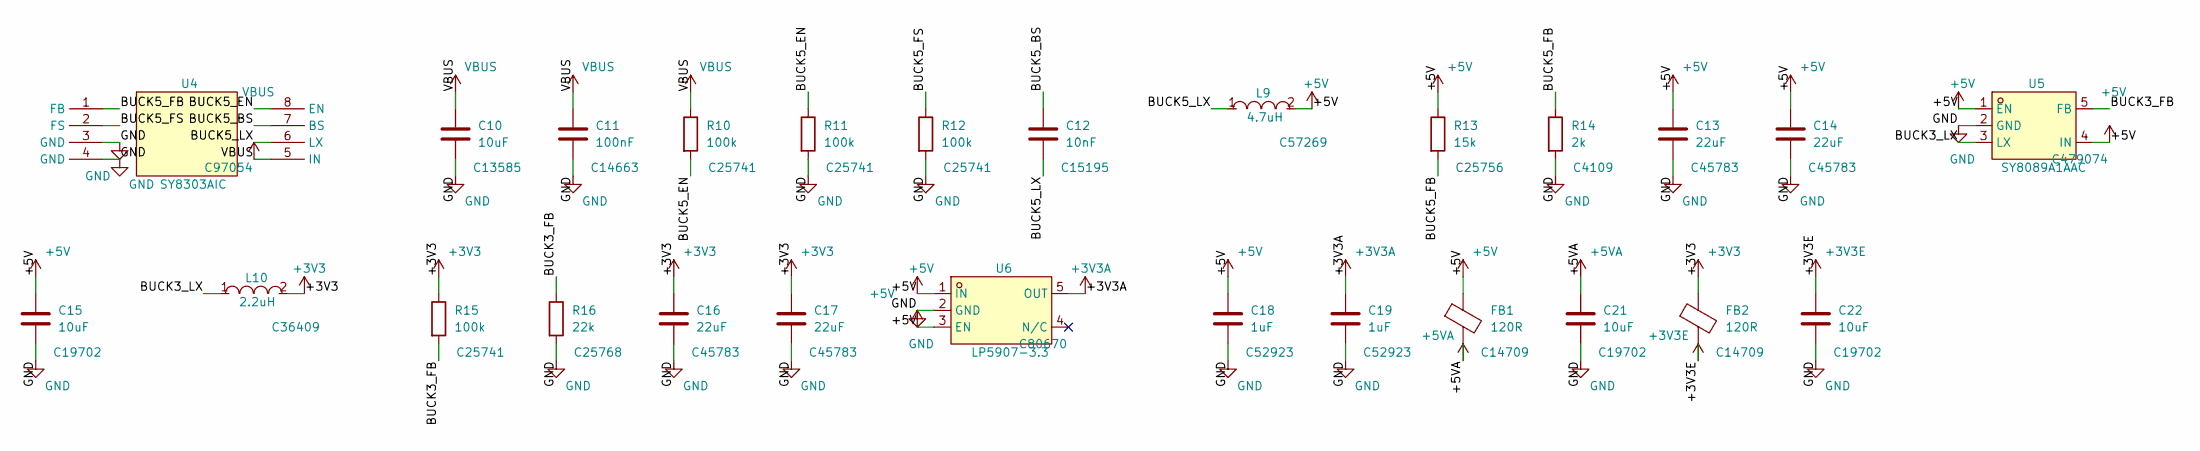
[picture p53: schematic rails.kicad_sch, core: 5 V buck, 3.3 V buck, analog LDO]

Parts:
C10: 10uF; C1206; LCSC C13585
C11: 100nF; C0603; LCSC C14663
C12: 10nF; C0402; LCSC C15195
C13, C14, C16, C17: 22uF; C0805; LCSC C45783
C15, C21, C22: 10uF; C0603; LCSC C19702
C18, C19: 1uF; C0402; LCSC C52923
FB1, FB2: 120R; L0603; LCSC C14709
L9: 4.7uH; IND-SMD_L4.0-W4.0; LCSC C57269
L10: 2.2uH; IND-SMD_L4.0-W4.0_LQH44PN2R2MP0L; LCSC C36409
R10, R11, R12, R15: 100k; R0402; LCSC C25741
R13: 15k; R0402; LCSC C25756
R14: 2k; R0402; LCSC C4109
R16: 22k; R0402; LCSC C25768
U4: SY8303AIC; TSOT-23-8_L2.9-W1.6-P0.65-LS2.8-BR; LCSC C97054
U5: SY8089A1AAC; TSOT-23-5_L2.9-W1.6-P0.95-LS2.8-BR; LCSC C479074
U6: LP5907-3.3; SOT-23-5_L3.0-W1.7-P0.95-LS2.8-BR; LCSC C80670

Connections:
+3V3: C16.1, C17.1, FB2.1, L10.2, R15.1; also elsewhere on the board
+3V3A: C19.1, U6.5 (OUT); also elsewhere on the board
+3V3E: C22.1, FB2.2; also elsewhere on the board
+5V: C13.1, C14.1, C15.1, C18.1, FB1.1, L9.2, R13.1, U5.1 (EN), U5.4 (IN), U6.1 (IN), U6.3 (EN); also elsewhere on the board
+5VA: C21.1, FB1.2; also elsewhere on the board
/rails/BUCK3_FB: R15.2, R16.1, U5.5 (FB)
/rails/BUCK3_LX: L10.1, U5.3 (LX)
/rails/BUCK5_BS: C12.1, U4.7 (BS)
/rails/BUCK5_EN: R10.2, R11.1, U4.8 (EN)
/rails/BUCK5_FB: R13.2, R14.1, U4.1 (FB)
/rails/BUCK5_FS: R12.1, U4.2 (FS)
/rails/BUCK5_LX: C12.2, L9.1, U4.6 (LX)
GND: C10.2, C11.2, C13.2, C14.2, C15.2, C16.2, C17.2, C18.2, C19.2, C21.2, C22.2, R11.2, R12.2, R14.2, R16.2, U4.3 (GND), U4.4 (GND), U5.2 (GND), U6.2 (GND); also elsewhere on the board
VBUS: C10.1, C11.1, R10.1, U4.5 (IN); also elsewhere on the board

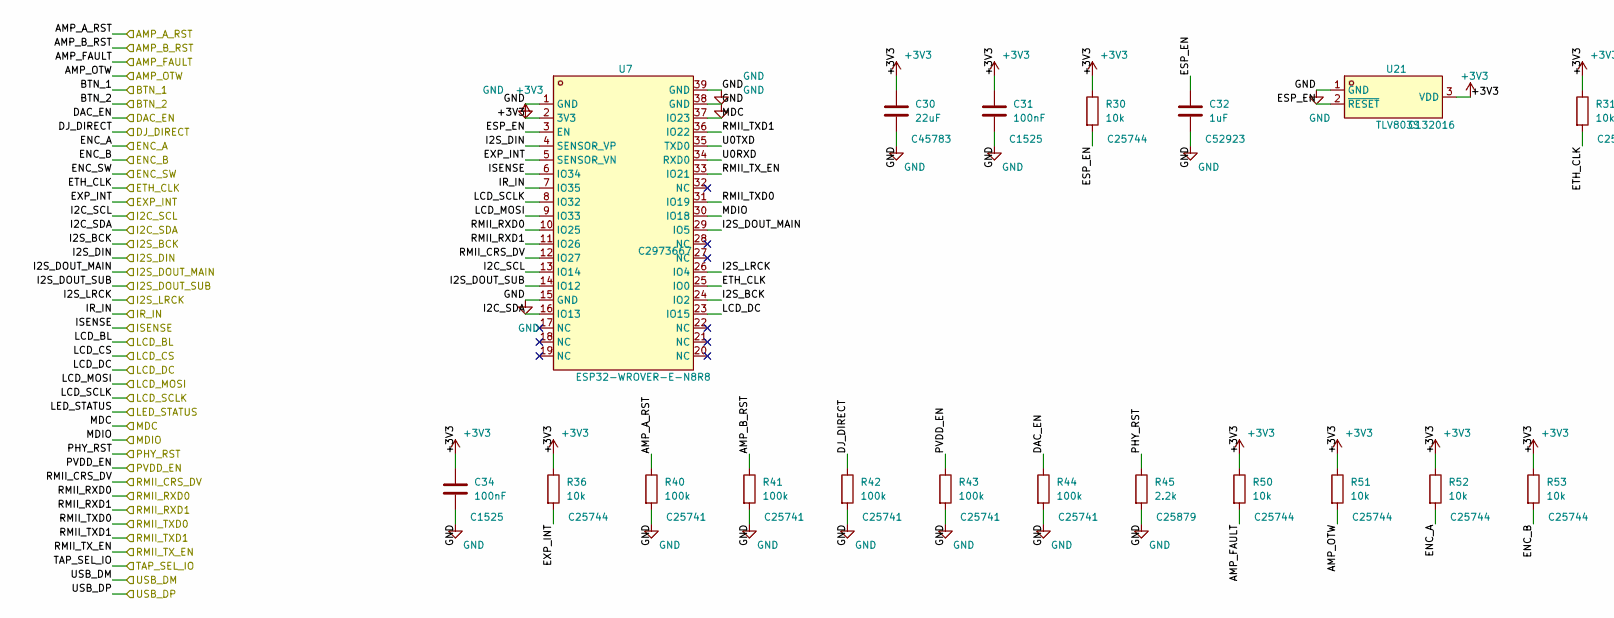
[picture p54: schematic mcu.kicad_sch, core: ESP32-WROVER-E, USB-UART, I/O expander, part in row 1, column 1]

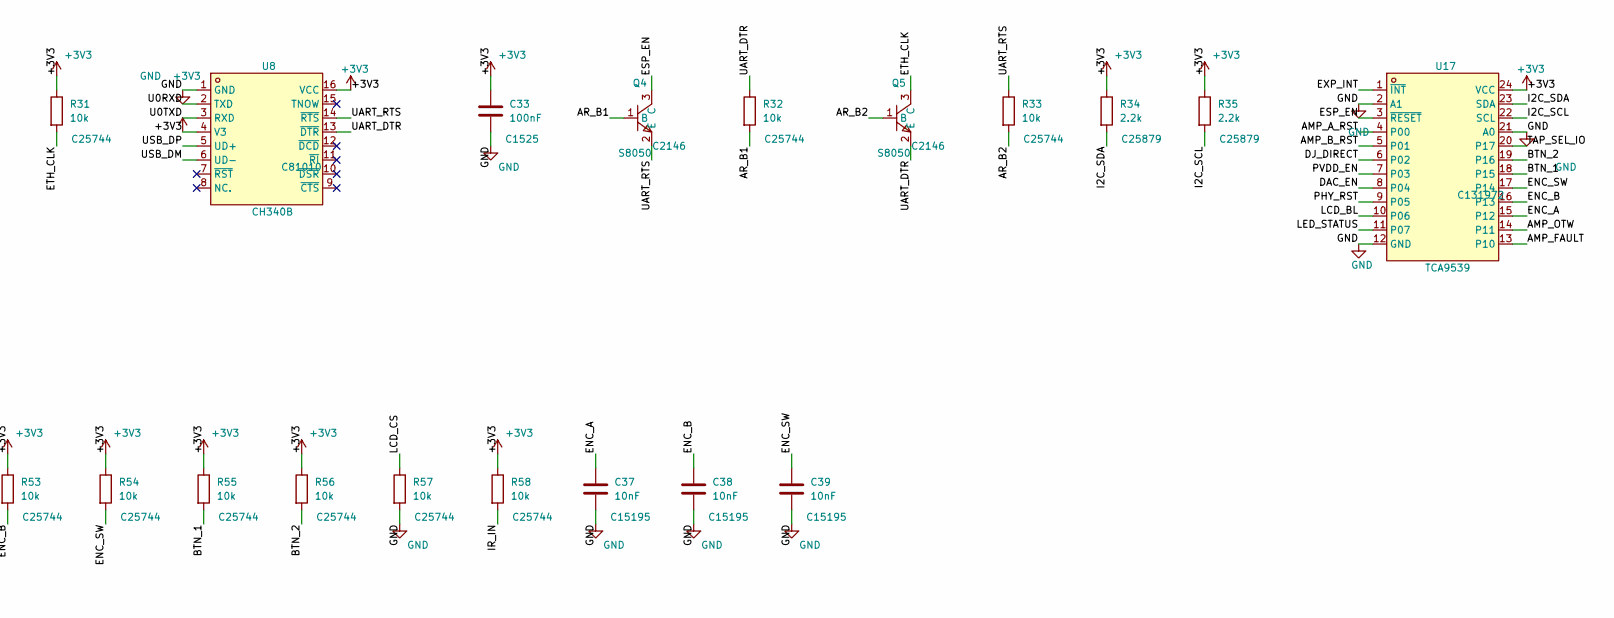
[picture p55: schematic mcu.kicad_sch, core: ESP32-WROVER-E, USB-UART, I/O expander, part in row 1, column 2]

Parts:
C30: 22uF; C0805; LCSC C45783
C31, C33, C34: 100nF; C0402; LCSC C1525
C32: 1uF; C0402; LCSC C52923
C37, C38, C39: 10nF; C0402; LCSC C15195
Q4, Q5: S8050; SOT-23-3_L3.0-W1.7-P0.95-LS2.9-BR; LCSC C2146
R30, R31, R32, R33, R36, R50, R51, R52, R53, R54, R55, R56, R57, R58: 10k; R0402; LCSC C25744
R34, R35, R45: 2.2k; R0402; LCSC C25879
R40, R41, R42, R43, R44: 100k; R0402; LCSC C25741
U7: ESP32-WROVER-E-N8R8; WIFI-SMD_ESP32-WROVER-IE8MB; LCSC C2973667
U8: CH340B; SOP-16_L10.0-W3.9-P1.27-LS6.0-BL; LCSC C81010
U17: TCA9539; TSSOP-24_L7.8-W4.4-P0.65-LS6.4-BL; LCSC C131972
U21: TLV803S; SOT-23-3_L2.9-W1.3-P1.90-LS2.4-BR; LCSC C132016

Connections:
+3V3: C30.1, C31.1, C33.1, C34.1, R30.1, R31.1, R34.1, R35.1, R36.1, R50.1, R51.1, R52.1, R53.1, R54.1, R55.1, R56.1, R58.1, U7.2 (3V3), U8.4 (V3), U8.16 (VCC), U17.24 (VCC), U21.3 (VDD); also elsewhere on the board
/AMP_A_RST: R40.1, U17.4 (P00); also elsewhere on the board
/AMP_B_RST: R41.1, U17.5 (P01); also elsewhere on the board
/AMP_FAULT: R50.2, U17.13 (P10); also elsewhere on the board
/AMP_OTW: R51.2, U17.14 (P11); also elsewhere on the board
/BTN_1: R55.2, U17.18 (P15); also elsewhere on the board
/BTN_2: R56.2, U17.19 (P16); also elsewhere on the board
/DAC_EN: R44.1, U17.8 (P04); also elsewhere on the board
/DJ_DIRECT: R42.1, U17.6 (P02); also elsewhere on the board
/ENC_A: C37.1, R52.2, U17.15 (P12); also elsewhere on the board
/ENC_B: C38.1, R53.2, U17.16 (P13); also elsewhere on the board
/ENC_SW: C39.1, R54.2, U17.17 (P14); also elsewhere on the board
/ETH_CLK: Q5.3 (C), R31.2, U7.25 (IO0); also elsewhere on the board
/EXP_INT: R36.2, U7.5 (SENSOR_VN), U17.1 (~INT); also elsewhere on the board
/I2C_SCL: R35.2, U7.13 (IO14), U17.22 (SCL); also elsewhere on the board
/I2C_SDA: R34.2, U7.16 (IO13), U17.23 (SDA); also elsewhere on the board
/I2S_BCK: U7.24 (IO2); also elsewhere on the board
/I2S_DIN: U7.4 (SENSOR_VP); also elsewhere on the board
/I2S_DOUT_MAIN: U7.29 (IO5); also elsewhere on the board
/I2S_DOUT_SUB: U7.14 (IO12); also elsewhere on the board
/I2S_LRCK: U7.26 (IO4); also elsewhere on the board
/IR_IN: R58.2, U7.7 (IO35); also elsewhere on the board
/ISENSE: U7.6 (IO34); also elsewhere on the board
/LCD_BL: U17.10 (P06); also elsewhere on the board
/LCD_CS: R57.1; also elsewhere on the board
/LCD_DC: U7.23 (IO15); also elsewhere on the board
/LCD_MOSI: U7.9 (IO33); also elsewhere on the board
/LCD_SCLK: U7.8 (IO32); also elsewhere on the board
/LED_STATUS: U17.11 (P07); also elsewhere on the board
/MDC: U7.37 (IO23); also elsewhere on the board
/MDIO: U7.30 (IO18); also elsewhere on the board
/PHY_RST: R45.1, U17.9 (P05); also elsewhere on the board
/PVDD_EN: R43.1, U17.7 (P03); also elsewhere on the board
/RMII_CRS_DV: U7.12 (IO27); also elsewhere on the board
/RMII_RXD0: U7.10 (IO25); also elsewhere on the board
/RMII_RXD1: U7.11 (IO26); also elsewhere on the board
/RMII_TXD0: U7.31 (IO19); also elsewhere on the board
/RMII_TXD1: U7.36 (IO22); also elsewhere on the board
/RMII_TX_EN: U7.33 (IO21); also elsewhere on the board
/TAP_SEL_IO: U17.20 (P17); also elsewhere on the board
/USB_DM: U8.6 (UD-); also elsewhere on the board
/USB_DP: U8.5 (UD+); also elsewhere on the board
/mcu/AR_B1: Q4.1 (B), R32.2
/mcu/AR_B2: Q5.1 (B), R33.2
/mcu/ESP_EN: C32.1, Q4.3 (C), R30.2, U7.3 (EN), U17.3 (~RESET), U21.2 (~RESET)
/mcu/U0RXD: U7.34 (RXD0), U8.2 (TXD)
/mcu/U0TXD: U7.35 (TXD0), U8.3 (RXD)
/mcu/UART_DTR: Q5.2 (E), R32.1, U8.13 (~DTR)
/mcu/UART_RTS: Q4.2 (E), R33.1, U8.14 (~RTS)
GND: C30.2, C31.2, C32.2, C33.2, C34.2, C37.2, C38.2, C39.2, R40.2, R41.2, R42.2, R43.2, R44.2, R45.2, R57.2, U7.1 (GND), U7.15 (GND), U7.38 (GND), U7.39 (GND), U8.1 (GND), U17.2 (A1), U17.12 (GND), U17.21 (A0), U21.1 (GND); also elsewhere on the board

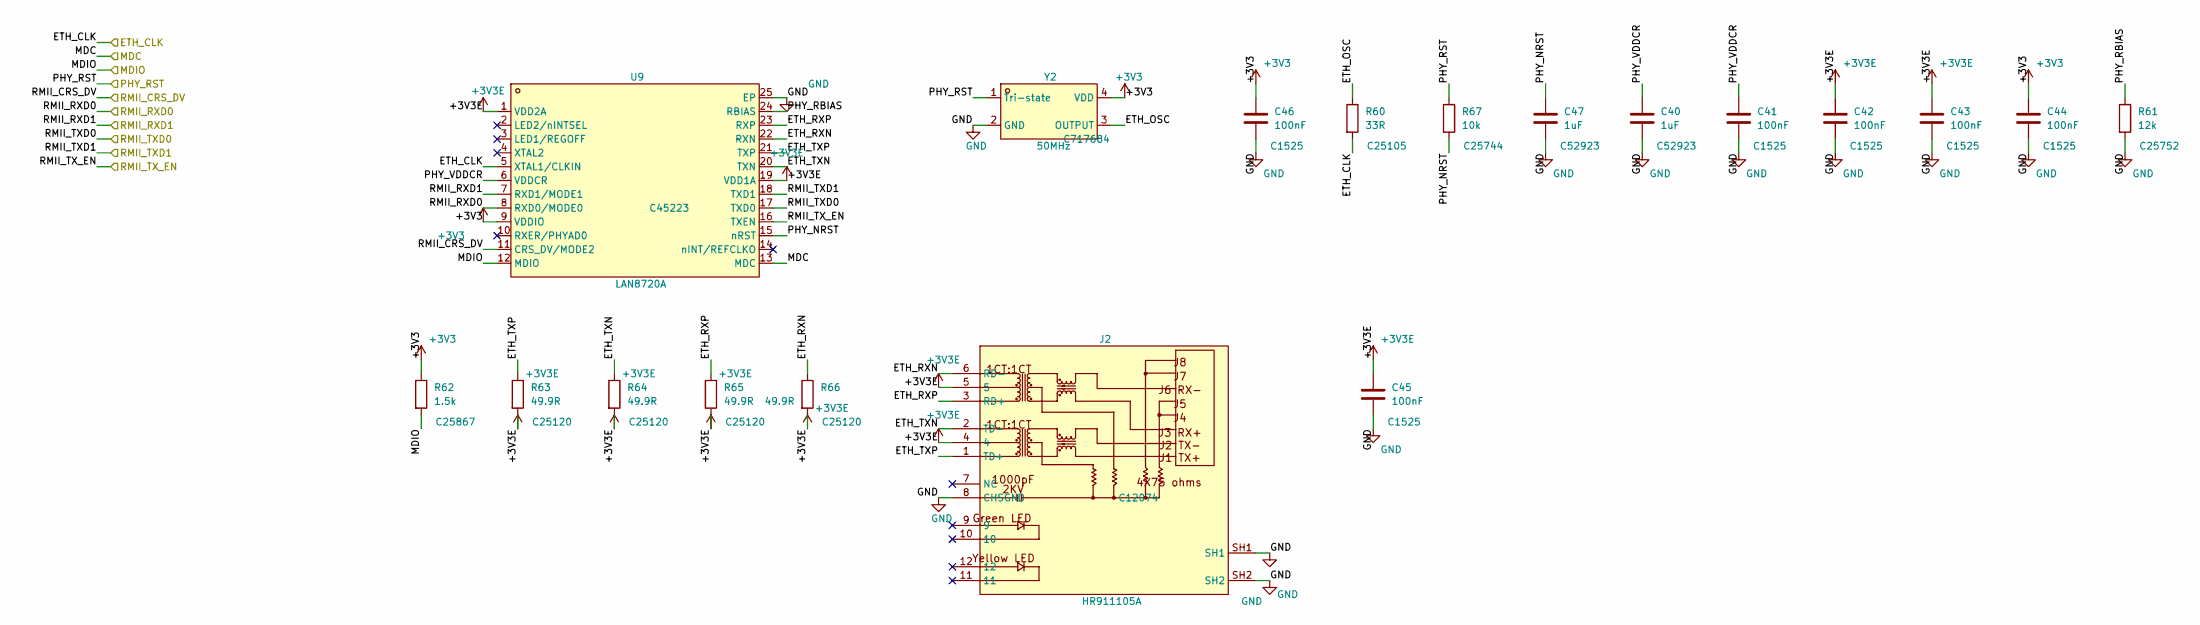
[picture p56: schematic ethernet.kicad_sch, core: LAN8720A 100 Mb Ethernet]

Parts:
C40, C47: 1uF; C0402; LCSC C52923
C41, C42, C43, C44, C45, C46: 100nF; C0402; LCSC C1525
J2: HR911105A; RJ45-TH_HR911105A; LCSC C12074
R60: 33R; R0402; LCSC C25105
R61: 12k; R0402; LCSC C25752
R62: 1.5k; R0402; LCSC C25867
R63, R64, R65, R66: 49.9R; R0402; LCSC C25120
R67: 10k; R0402; LCSC C25744
U9: LAN8720A; QFN-24_L4.0-W4.0-P0.50-BL-EP2.6; LCSC C45223
Y2: 50MHz; OSC-SMD_4P-L3.2-W2.5-BL; LCSC C717684

Connections:
+3V3: C44.1, C46.1, R62.1, U9.9 (VDDIO), Y2.4 (VDD); also elsewhere on the board
+3V3E: C42.1, C43.1, C45.1, J2.4, J2.5, R63.2, R64.2, R65.2, R66.2, U9.1 (VDD2A), U9.19 (VDD1A); also elsewhere on the board
/ETH_CLK: R60.2, U9.5 (XTAL1/CLKIN); also elsewhere on the board
/MDC: U9.13 (MDC); also elsewhere on the board
/MDIO: R62.2, U9.12 (MDIO); also elsewhere on the board
/PHY_RST: R67.1, Y2.1 (Tri-state); also elsewhere on the board
/RMII_CRS_DV: U9.11 (CRS_DV/MODE2); also elsewhere on the board
/RMII_RXD0: U9.8 (RXD0/MODE0); also elsewhere on the board
/RMII_RXD1: U9.7 (RXD1/MODE1); also elsewhere on the board
/RMII_TXD0: U9.17 (TXD0); also elsewhere on the board
/RMII_TXD1: U9.18 (TXD1); also elsewhere on the board
/RMII_TX_EN: U9.16 (TXEN); also elsewhere on the board
/ethernet/ETH_OSC: R60.1, Y2.3 (OUTPUT)
/ethernet/ETH_RXN: J2.6 (RD-), R66.1, U9.22 (RXN)
/ethernet/ETH_RXP: J2.3 (RD+), R65.1, U9.23 (RXP)
/ethernet/ETH_TXN: J2.2 (TD-), R64.1, U9.20 (TXN)
/ethernet/ETH_TXP: J2.1 (TD+), R63.1, U9.21 (TXP)
/ethernet/PHY_NRST: C47.1, R67.2, U9.15 (nRST)
/ethernet/PHY_RBIAS: R61.1, U9.24 (RBIAS)
/ethernet/PHY_VDDCR: C40.1, C41.1, U9.6 (VDDCR)
GND: C40.2, C41.2, C42.2, C43.2, C44.2, C45.2, C46.2, C47.2, J2.8 (CHSGND), J2.SH1, J2.SH2, R61.2, U9.25 (EP), Y2.2 (GND); also elsewhere on the board

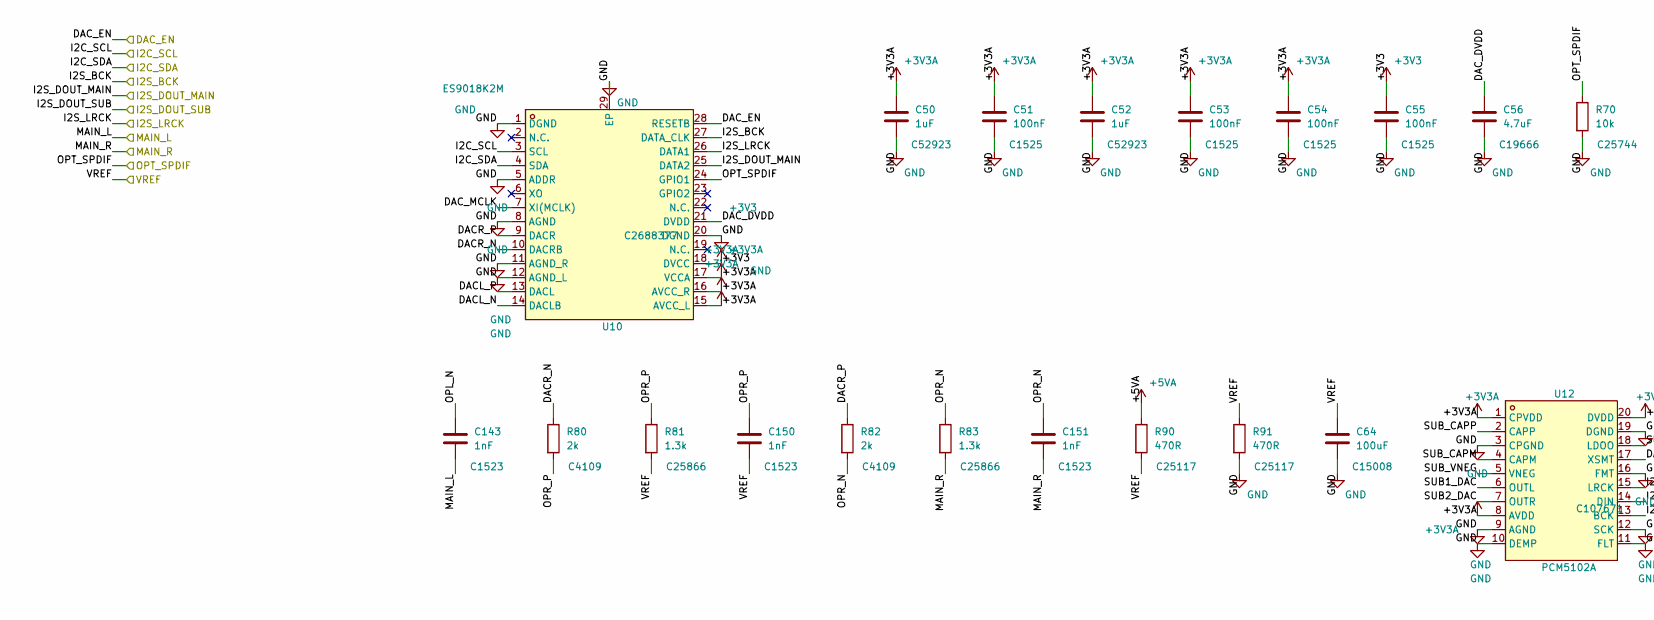
[picture p57: schematic dac.kicad_sch, core: ES9018K2M Sabre mains DAC, PCM5102A sub DAC, part in row 1, column 1]

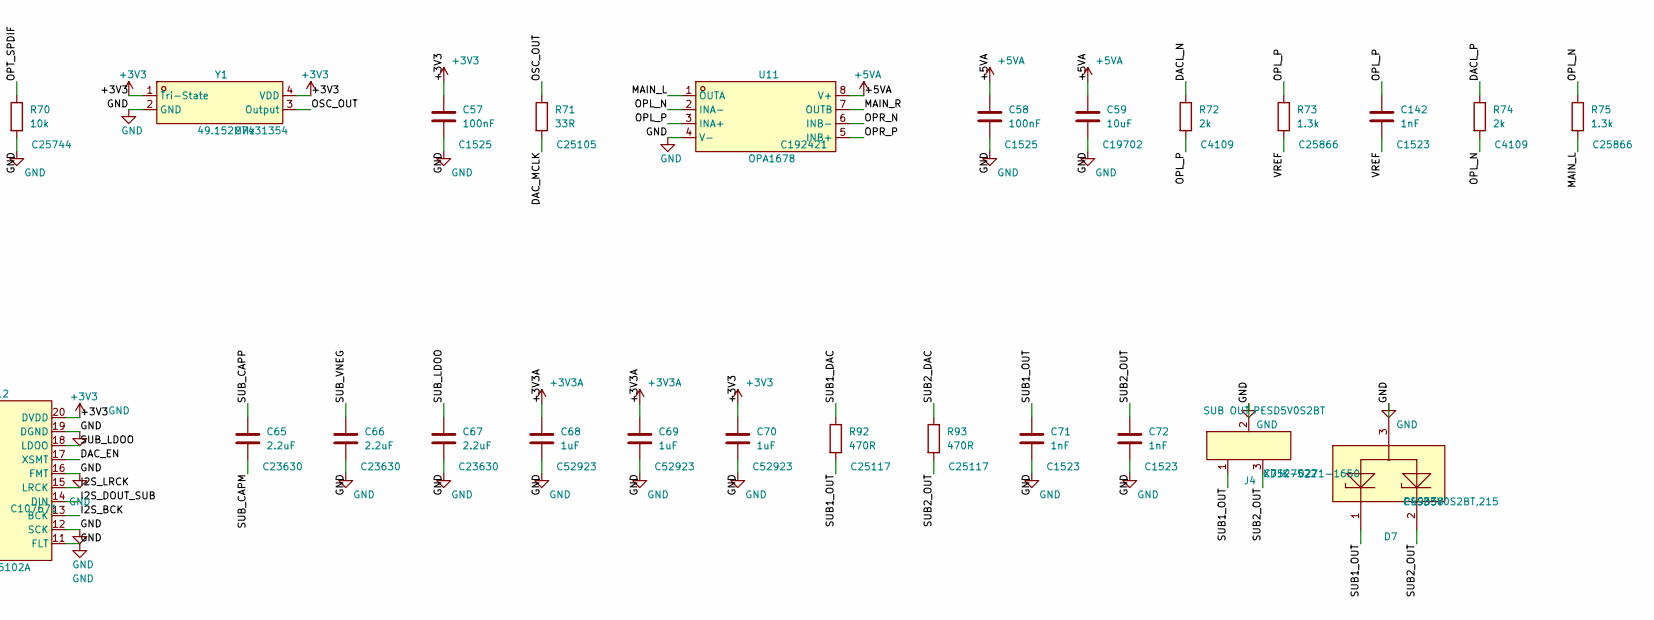
[picture p58: schematic dac.kicad_sch, core: ES9018K2M Sabre mains DAC, PCM5102A sub DAC, part in row 1, column 2]

Parts:
C50, C52, C68, C69, C70: 1uF; C0402; LCSC C52923
C51, C53, C54, C55, C57, C58: 100nF; C0402; LCSC C1525
C56: 4.7uF; C0603; LCSC C19666
C59: 10uF; C0603; LCSC C19702
C64: 100uF; C1206; LCSC C15008
C65, C66, C67: 2.2uF; C0603; LCSC C23630
C71, C72, C142, C143, C150, C151: 1nF; C0402; LCSC C1523
D7: PESD5V0S2BT; SOT-23_L2.9-W1.3-P1.90-LS2.4-BR; MPN PESD5V0S2BT,215; LCSC C49338
J4: SUB OUT; CONN-TH_XDJK-0271-1650; MPN XDJK-0271-1650; LCSC C7527522
R70: 10k; R0402; LCSC C25744
R71: 33R; R0402; LCSC C25105
R72, R74, R80, R82: 2k; R0402; LCSC C4109
R73, R75, R81, R83: 1.3k; R0402; LCSC C25866
R90, R91, R92, R93: 470R; R0402; LCSC C25117
U10: ES9018K2M; QFN-28_L5.0-W5.0-P0.50-BL-EP3.3; LCSC C2688377
U11: OPA1678; SOIC-8_L5.0-W4.0-P1.27-LS6.0-BL; LCSC C192421
U12: PCM5102A; TSSOP-20_L6.5-W4.4-P0.65-LS6.4-BL; LCSC C107671
Y1: 49.152MHz; OSC-SMD_4P-L3.2-W2.5-BL; LCSC C7431354

Connections:
+3V3: C55.1, C57.1, C70.1, U10.18 (DVCC), U12.20 (DVDD), Y1.1 (Tri-State), Y1.4 (VDD); also elsewhere on the board
+3V3A: C50.1, C51.1, C52.1, C53.1, C54.1, C68.1, C69.1, U10.15 (AVCC_L), U10.16 (AVCC_R), U10.17 (VCCA), U12.1 (CPVDD), U12.8 (AVDD); also elsewhere on the board
+5VA: C58.1, C59.1, R90.1, U11.8 (V+); also elsewhere on the board
/DAC_EN: U10.28 (RESETB), U12.17 (XSMT); also elsewhere on the board
/I2C_SCL: U10.3 (SCL); also elsewhere on the board
/I2C_SDA: U10.4 (SDA); also elsewhere on the board
/I2S_BCK: U10.27 (DATA_CLK), U12.13 (BCK); also elsewhere on the board
/I2S_DOUT_MAIN: U10.25 (DATA2); also elsewhere on the board
/I2S_DOUT_SUB: U12.14 (DIN); also elsewhere on the board
/I2S_LRCK: U10.26 (DATA1), U12.15 (LRCK); also elsewhere on the board
/MAIN_L: C143.2, R75.2, U11.1 (OUTA); also elsewhere on the board
/MAIN_R: C151.2, R83.2, U11.7 (OUTB); also elsewhere on the board
/OPT_SPDIF: R70.1, U10.24 (GPIO1); also elsewhere on the board
/VREF: C64.1, C142.2, C150.2, R73.2, R81.2, R90.2, R91.1; also elsewhere on the board
/dac/DACL_N: R72.1, U10.14 (DACLB)
/dac/DACL_P: R74.1, U10.13 (DACL)
/dac/DACR_N: R80.1, U10.10 (DACRB)
/dac/DACR_P: R82.1, U10.9 (DACR)
/dac/DAC_DVDD: C56.1, U10.21 (DVDD)
/dac/DAC_MCLK: R71.2, U10.7 (XI(MCLK))
/dac/OPL_N: C143.1, R74.2, R75.1, U11.2 (INA-)
/dac/OPL_P: C142.1, R72.2, R73.1, U11.3 (INA+)
/dac/OPR_N: C151.1, R82.2, R83.1, U11.6 (INB-)
/dac/OPR_P: C150.1, R80.2, R81.1, U11.5 (INB+)
/dac/OSC_OUT: R71.1, Y1.3 (Output)
/dac/SUB1_DAC: R92.1, U12.6 (OUTL)
/dac/SUB1_OUT: C71.1, D7.1, J4.1, R92.2
/dac/SUB2_DAC: R93.1, U12.7 (OUTR)
/dac/SUB2_OUT: C72.1, D7.2, J4.3, R93.2
/dac/SUB_CAPM: C65.2, U12.4 (CAPM)
/dac/SUB_CAPP: C65.1, U12.2 (CAPP)
/dac/SUB_LDOO: C67.1, U12.18 (LDOO)
/dac/SUB_VNEG: C66.1, U12.5 (VNEG)
GND: C50.2, C51.2, C52.2, C53.2, C54.2, C55.2, C56.2, C57.2, C58.2, C59.2, C64.2, C66.2, C67.2, C68.2, C69.2, C70.2, C71.2, C72.2, D7.3, J4.2, R70.2, R91.2, U10.1 (DGND), U10.5 (ADDR), U10.8 (AGND), U10.11 (AGND_R), U10.12 (AGND_L), U10.20 (DGND), U10.29 (EP), U11.4 (V-), U12.3 (CPGND), U12.9 (AGND), U12.10 (DEMP), U12.11 (FLT), U12.12 (SCK), U12.16 (FMT), U12.19 (DGND), Y1.2 (GND); also elsewhere on the board

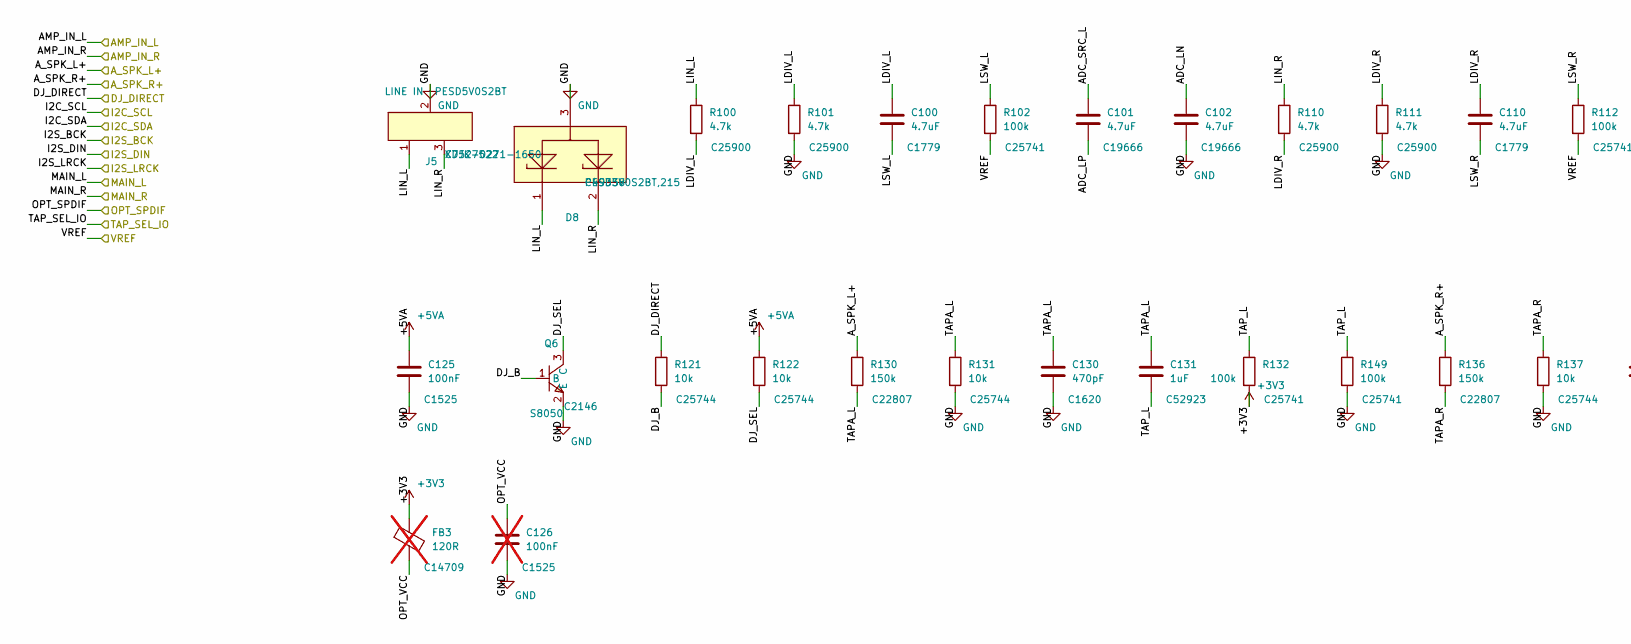
[picture p59: schematic linein.kicad_sch, core: RCA line in, ES7243E ADC, DJ-direct switch, TOSLINK, part in row 1, column 1]

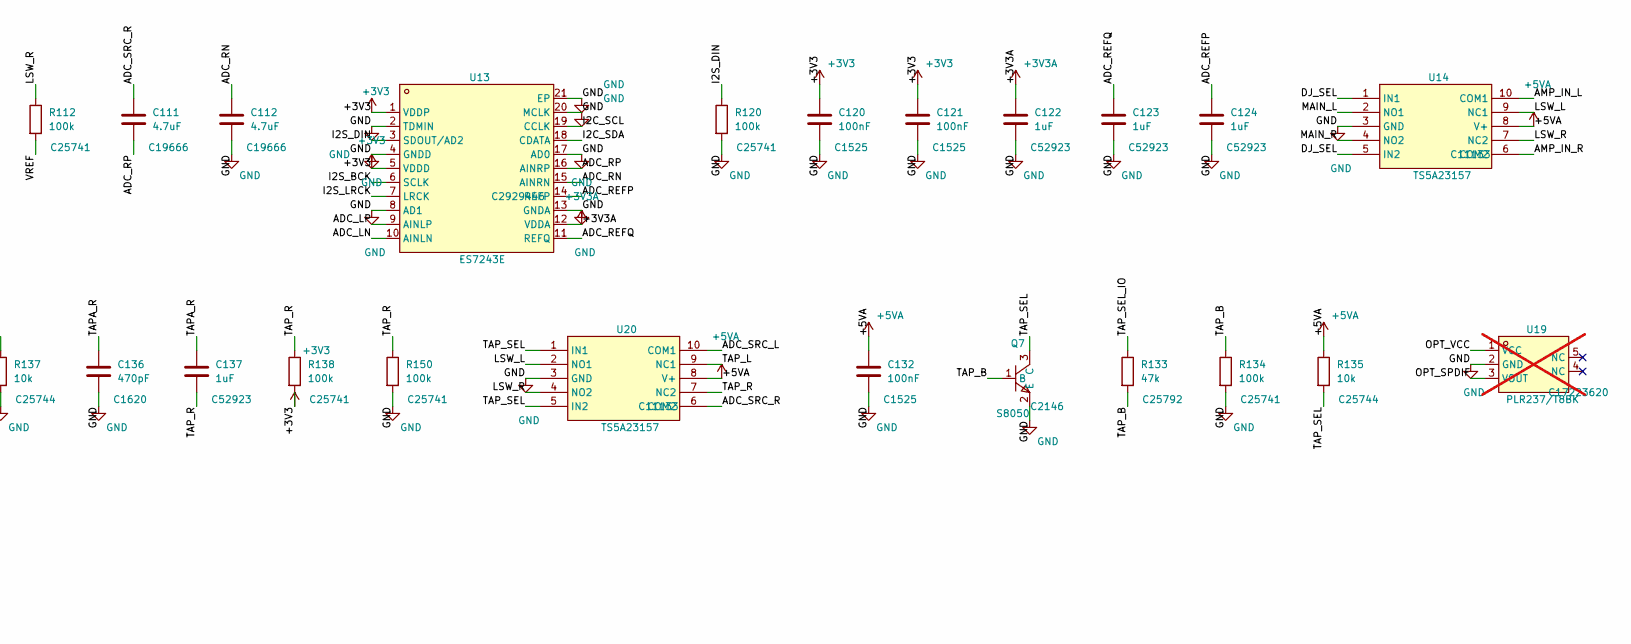
[picture p60: schematic linein.kicad_sch, core: RCA line in, ES7243E ADC, DJ-direct switch, TOSLINK, part in row 1, column 2]

Parts:
C100, C110: 4.7uF; C0805; LCSC C1779
C101, C102, C111, C112: 4.7uF; C0603; LCSC C19666
C120, C121, C125, C132: 100nF; C0402; LCSC C1525
C122, C123, C124, C131, C137: 1uF; C0402; LCSC C52923
C126: 100nF; C0402; LCSC C1525; not fitted
C130, C136: 470pF; C0603; LCSC C1620
D8: PESD5V0S2BT; SOT-23_L2.9-W1.3-P1.90-LS2.4-BR; MPN PESD5V0S2BT,215; LCSC C49338
FB3: 120R; L0603; LCSC C14709; not fitted
J5: LINE IN; CONN-TH_XDJK-0271-1650; MPN XDJK-0271-1650; LCSC C7527522
Q6, Q7: S8050; SOT-23-3_L3.0-W1.7-P0.95-LS2.9-BR; LCSC C2146
R100, R101, R110, R111: 4.7k; R0402; LCSC C25900
R102, R112, R120, R132, R134, R138, R149, R150: 100k; R0402; LCSC C25741
R121, R122, R131, R135, R137: 10k; R0402; LCSC C25744
R130, R136: 150k; R0603; LCSC C22807
R133: 47k; R0402; LCSC C25792
U13: ES7243E; QFN-20_L3.0-W3.0-P0.40-BL-EP1.7; LCSC C2929446
U14, U20: TS5A23157; MSOP-10_L3.0-W3.0-P0.50-LS5.0-BL; LCSC C11133
U19: PLR237/T8BK; OPTO-TH_PLR237-T10BK; LCSC C17223620; not fitted

Connections:
+3V3: C120.1, C121.1, FB3.1, R132.2, R138.2, U13.1 (VDDP), U13.5 (VDDD); also elsewhere on the board
+3V3A: C122.1, U13.12 (VDDA); also elsewhere on the board
+5VA: C125.1, C132.1, R122.1, R135.1, U14.8 (V+), U20.8 (V+); also elsewhere on the board
/AMP_IN_L: U14.10 (COM1); also elsewhere on the board
/AMP_IN_R: U14.6 (COM2); also elsewhere on the board
/A_SPK_L+: R130.1; also elsewhere on the board
/A_SPK_R+: R136.1; also elsewhere on the board
/DJ_DIRECT: R121.1; also elsewhere on the board
/I2C_SCL: U13.19 (CCLK); also elsewhere on the board
/I2C_SDA: U13.18 (CDATA); also elsewhere on the board
/I2S_BCK: U13.6 (SCLK); also elsewhere on the board
/I2S_DIN: R120.1, U13.3 (SDOUT/AD2); also elsewhere on the board
/I2S_LRCK: U13.7 (LRCK); also elsewhere on the board
/MAIN_L: U14.2 (NO1); also elsewhere on the board
/MAIN_R: U14.4 (NO2); also elsewhere on the board
/OPT_SPDIF: U19.3 (VOUT); also elsewhere on the board
/TAP_SEL_IO: R133.1; also elsewhere on the board
/VREF: R102.2, R112.2; also elsewhere on the board
/linein/ADC_LN: C102.1, U13.10 (AINLN)
/linein/ADC_LP: C101.2, U13.9 (AINLP)
/linein/ADC_REFP: C124.1, U13.14 (REFP)
/linein/ADC_REFQ: C123.1, U13.11 (REFQ)
/linein/ADC_RN: C112.1, U13.15 (AINRN)
/linein/ADC_RP: C111.2, U13.16 (AINRP)
/linein/ADC_SRC_L: C101.1, U20.10 (COM1)
/linein/ADC_SRC_R: C111.1, U20.6 (COM2)
/linein/DJ_B: Q6.1 (B), R121.2
/linein/DJ_SEL: Q6.3 (C), R122.2, U14.1 (IN1), U14.5 (IN2)
/linein/LDIV_L: C100.1, R100.2, R101.1
/linein/LDIV_R: C110.1, R110.2, R111.1
/linein/LIN_L: D8.1, J5.1, R100.1
/linein/LIN_R: D8.2, J5.3, R110.1
/linein/LSW_L: C100.2, R102.1, U14.9 (NC1), U20.2 (NO1)
/linein/LSW_R: C110.2, R112.1, U14.7 (NC2), U20.4 (NO2)
/linein/OPT_VCC: C126.1, FB3.2, U19.1 (VCC)
/linein/TAPA_L: C130.1, C131.1, R130.2, R131.1
/linein/TAPA_R: C136.1, C137.1, R136.2, R137.1
/linein/TAP_B: Q7.1 (B), R133.2, R134.1
/linein/TAP_L: C131.2, R132.1, R149.1, U20.9 (NC1)
/linein/TAP_R: C137.2, R138.1, R150.1, U20.7 (NC2)
/linein/TAP_SEL: Q7.3 (C), R135.2, U20.1 (IN1), U20.5 (IN2)
GND: C102.2, C112.2, C120.2, C121.2, C122.2, C123.2, C124.2, C125.2, C126.2, C130.2, C132.2, C136.2, D8.3, J5.2, Q6.2 (E), Q7.2 (E), R101.2, R111.2, R120.2, R131.2, R134.2, R137.2, R149.2, R150.2, U13.2 (TDMIN), U13.4 (GNDD), U13.8 (AD1), U13.13 (GNDA), U13.17 (AD0), U13.20 (MCLK), U13.21 (EP), U14.3 (GND), U19.2 (GND), U20.3 (GND); also elsewhere on the board
