Hive-RSI-Lab/hifi-receiver/boards/core/kicad/core.kicad_pcb

## KiCad design boards/core/kicad/core.kicad_pcb (continued)

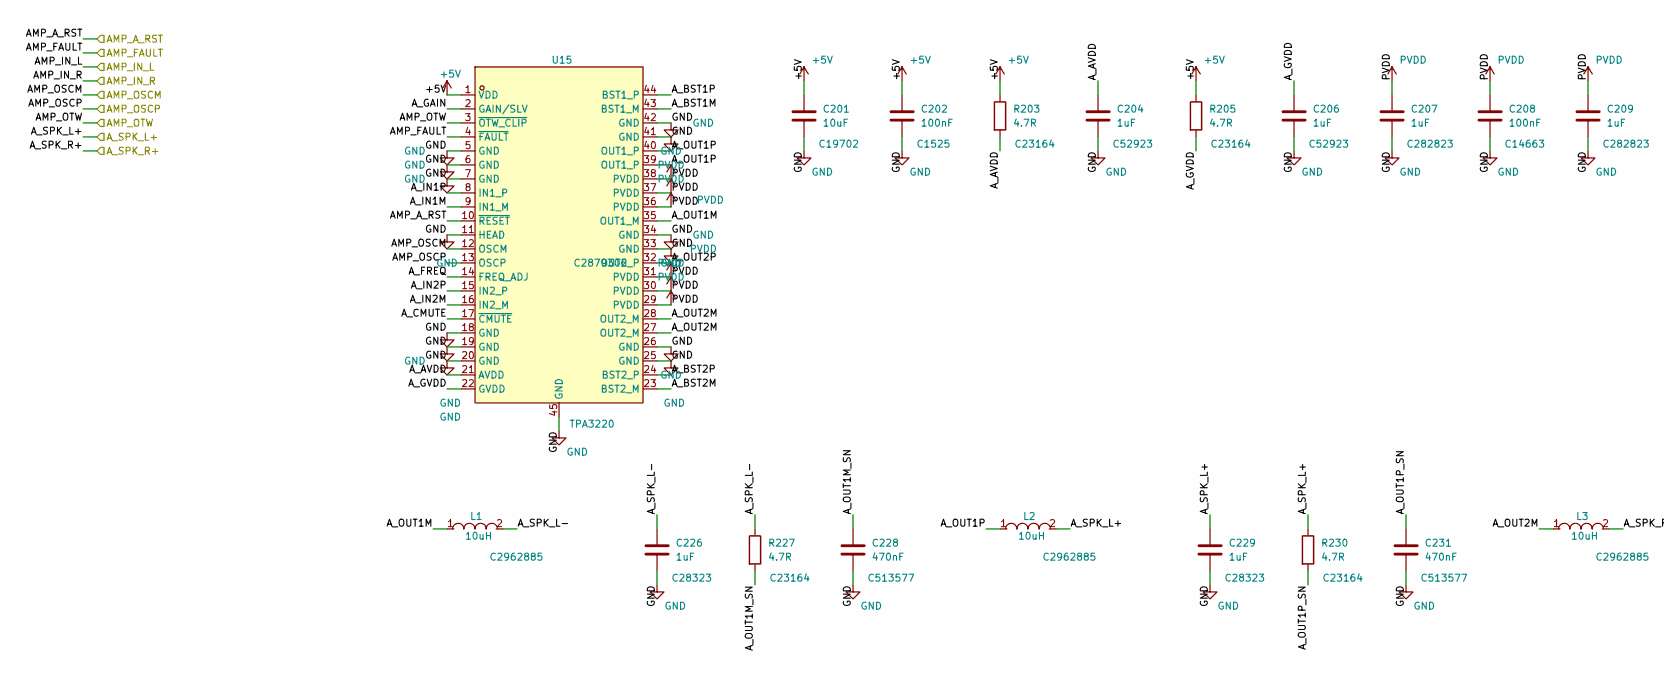
[picture p61: schematic amp_a.kicad_sch, core: TPA3221 zone A, part in row 1, column 1]

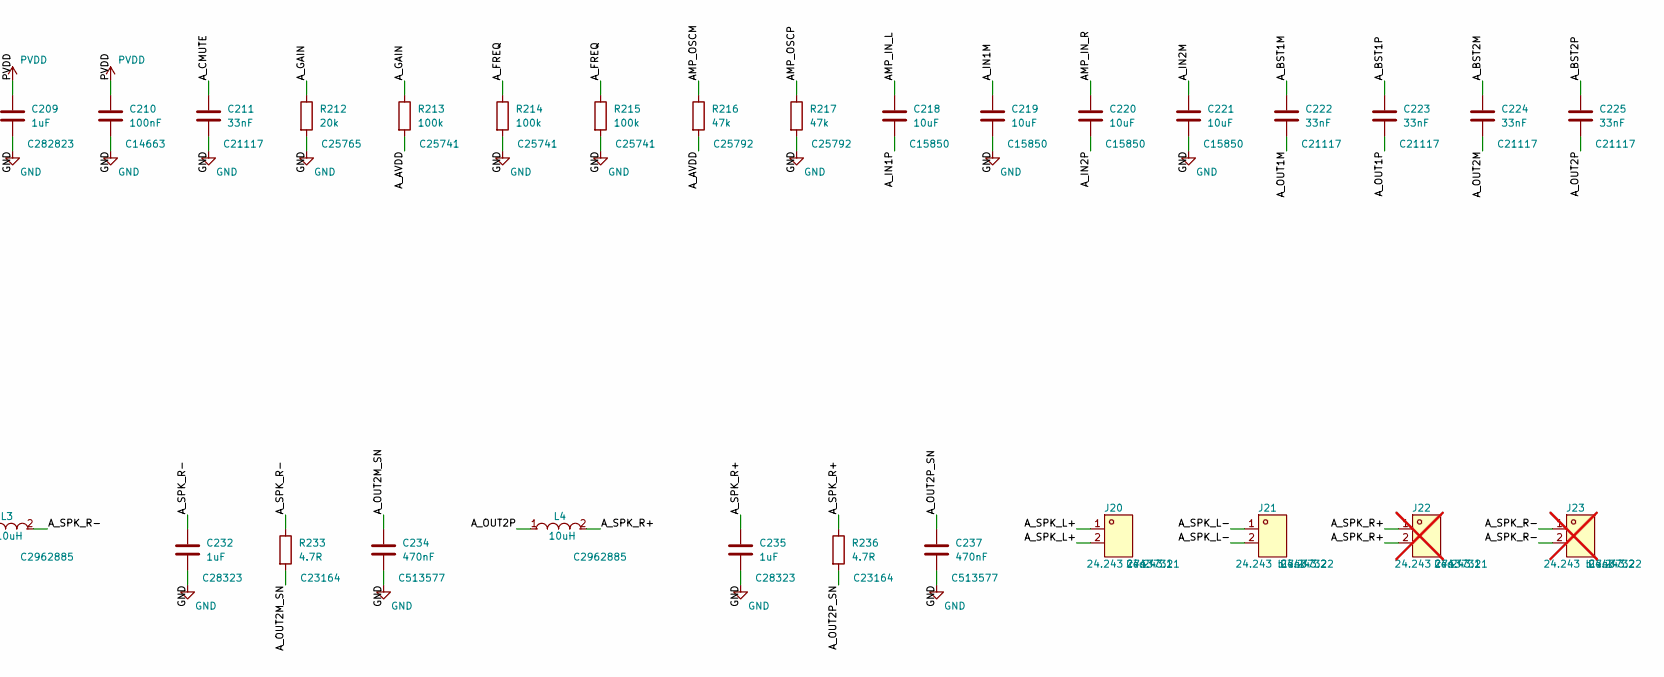
[picture p62: schematic amp_a.kicad_sch, core: TPA3221 zone A, part in row 1, column 2]

Parts:
C201: 10uF; C0603; LCSC C19702
C202: 100nF; C0402; LCSC C1525
C204, C206: 1uF; C0402; LCSC C52923
C207, C209: 1uF; C1206; LCSC C282823
C208, C210: 100nF; C0603; LCSC C14663
C211, C222, C223, C224, C225: 33nF; C0603; LCSC C21117
C218, C219, C220, C221: 10uF; C0805; LCSC C15850
C226, C229, C232, C235: 1uF; C0805; LCSC C28323
C228, C231, C234, C237: 470nF; C0603; LCSC C513577
J20: 24.243 red; CONN-TH_24.243.1_RED; MPN 24.243.1; LCSC C7437321
J21: 24.243 black; CONN-TH_24.243.2; MPN 24.243.2; LCSC C7437322
J22: 24.243 red; CONN-TH_24.243.1_RED; MPN 24.243.1; LCSC C7437321; not fitted
J23: 24.243 black; CONN-TH_24.243.2; MPN 24.243.2; LCSC C7437322; not fitted
L1, L2, L3, L4: 10uH; IND-SMD_L8.5-W8.0_PCC-M0854M; LCSC C2962885
R203, R205, R227, R230, R233, R236: 4.7R; R0603; LCSC C23164
R212: 20k; R0402; LCSC C25765
R213, R214, R215: 100k; R0402; LCSC C25741
R216, R217: 47k; R0402; LCSC C25792
U15: TPA3220; HTSSOP-44-1EP_L14.0-W6.1-P0.64-LS8.1-EP7.3x4.43; LCSC C2879306

Connections:
+5V: C201.1, C202.1, R203.1, R205.1, U15.1 (VDD); also elsewhere on the board
/AMP_A_RST: U15.10 (~RESET); also elsewhere on the board
/AMP_FAULT: U15.4 (~FAULT); also elsewhere on the board
/AMP_IN_L: C218.1; also elsewhere on the board
/AMP_IN_R: C220.1; also elsewhere on the board
/AMP_OSCM: R216.1, U15.12 (OSCM); also elsewhere on the board
/AMP_OSCP: R217.1, U15.13 (OSCP); also elsewhere on the board
/AMP_OTW: U15.3 (~OTW_CLIP); also elsewhere on the board
/A_SPK_L+: C229.1, J20.1, J20.2, L2.2, R230.1; also elsewhere on the board
/A_SPK_R+: C235.1, J22.1, J22.2, L4.2, R236.1; also elsewhere on the board
/amp_a/A_AVDD: C204.1, R203.2, R213.2, R216.2, U15.21 (AVDD)
/amp_a/A_BST1M: C222.1, U15.43 (BST1_M)
/amp_a/A_BST1P: C223.1, U15.44 (BST1_P)
/amp_a/A_BST2M: C224.1, U15.23 (BST2_M)
/amp_a/A_BST2P: C225.1, U15.24 (BST2_P)
/amp_a/A_CMUTE: C211.1, U15.17 (~CMUTE)
/amp_a/A_FREQ: R214.1, R215.1, U15.14 (FREQ_ADJ)
/amp_a/A_GAIN: R212.1, R213.1, U15.2 (GAIN/SLV)
/amp_a/A_GVDD: C206.1, R205.2, U15.22 (GVDD)
/amp_a/A_IN1M: C219.1, U15.9 (IN1_M)
/amp_a/A_IN1P: C218.2, U15.8 (IN1_P)
/amp_a/A_IN2M: C221.1, U15.16 (IN2_M)
/amp_a/A_IN2P: C220.2, U15.15 (IN2_P)
/amp_a/A_OUT1M: C222.2, L1.1, U15.35 (OUT1_M)
/amp_a/A_OUT1M_SN: C228.1, R227.2
/amp_a/A_OUT1P: C223.2, L2.1, U15.39 (OUT1_P), U15.40 (OUT1_P)
/amp_a/A_OUT1P_SN: C231.1, R230.2
/amp_a/A_OUT2M: C224.2, L3.1, U15.27 (OUT2_M), U15.28 (OUT2_M)
/amp_a/A_OUT2M_SN: C234.1, R233.2
/amp_a/A_OUT2P: C225.2, L4.1, U15.32 (OUT2_P)
/amp_a/A_OUT2P_SN: C237.1, R236.2
/amp_a/A_SPK_L-: C226.1, J21.1, J21.2, L1.2, R227.1
/amp_a/A_SPK_R-: C232.1, J23.1, J23.2, L3.2, R233.1
GND: C201.2, C202.2, C204.2, C206.2, C207.2, C208.2, C209.2, C210.2, C211.2, C219.2, C221.2, C226.2, C228.2, C229.2, C231.2, C232.2, C234.2, C235.2, C237.2, R212.2, R214.2, R215.2, R217.2, U15.5 (GND), U15.6 (GND), U15.7 (GND), U15.11 (HEAD), U15.18 (GND), U15.19 (GND), U15.20 (GND), U15.25 (GND), U15.26 (GND), U15.33 (GND), U15.34 (GND), U15.41 (GND), U15.42 (GND), U15.45 (GND); also elsewhere on the board
PVDD: C207.1, C208.1, C209.1, C210.1, U15.29 (PVDD), U15.30 (PVDD), U15.31 (PVDD), U15.36 (PVDD), U15.37 (PVDD), U15.38 (PVDD); also elsewhere on the board

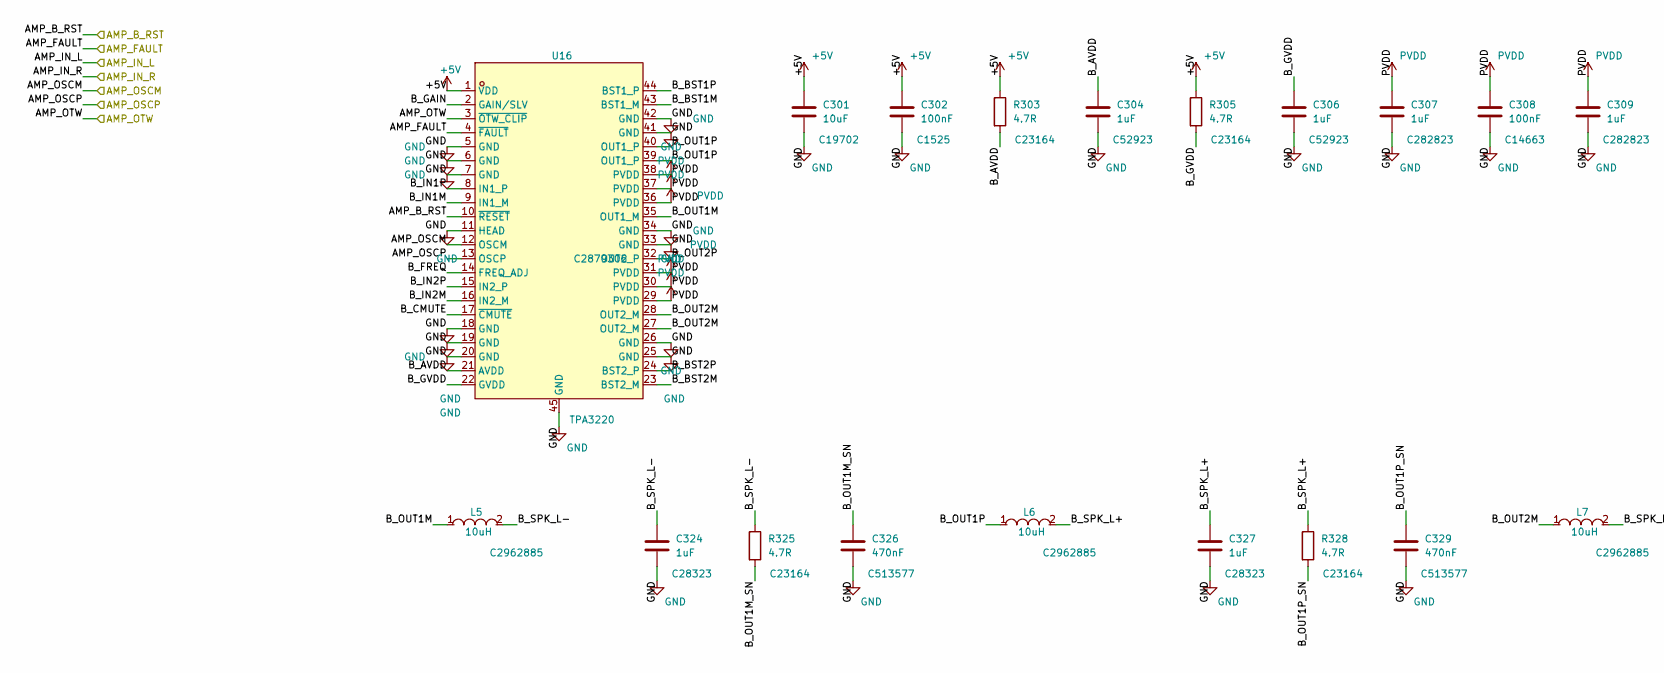
[picture p63: schematic amp_b.kicad_sch, core: TPA3221 zone B (Ultra), part in row 1, column 1]

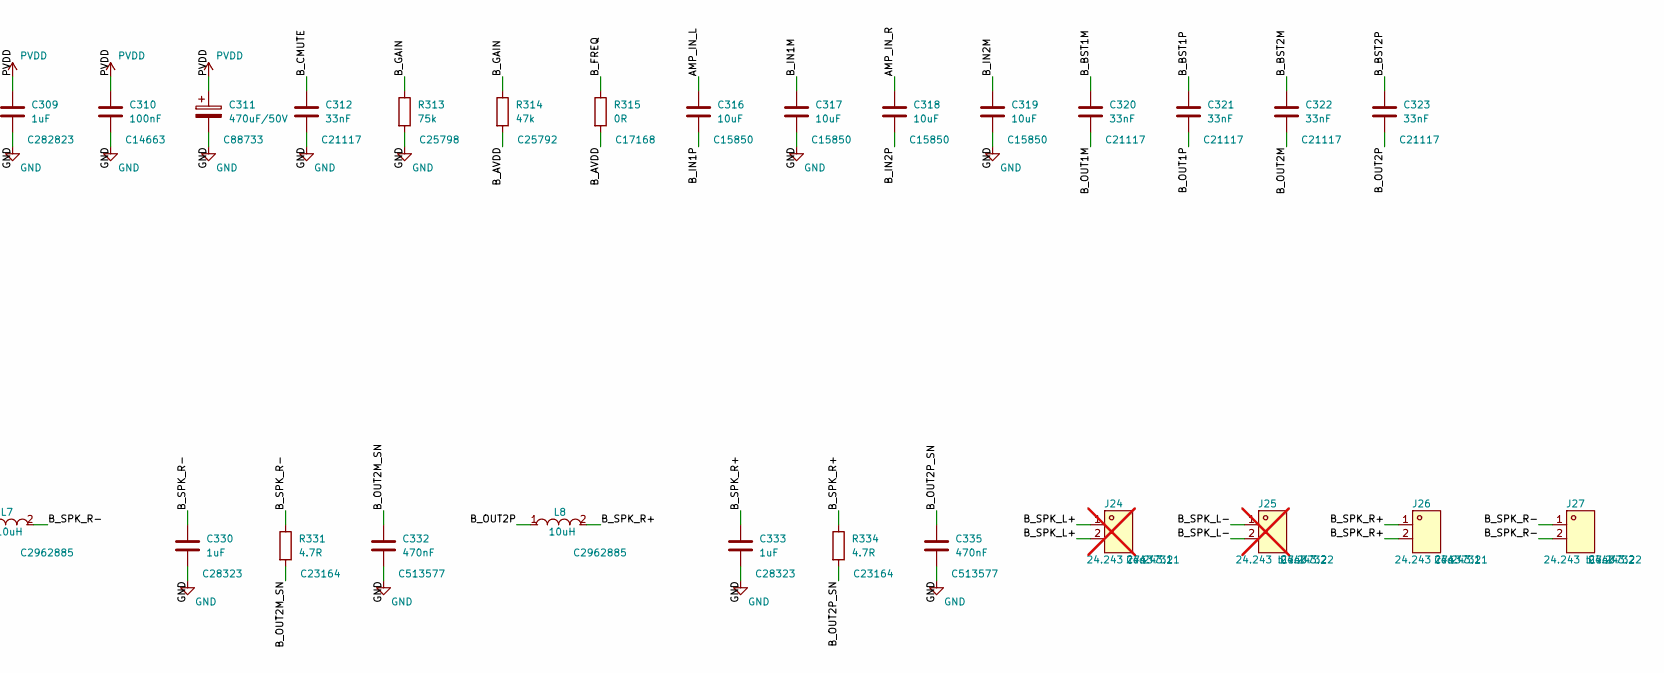
[picture p64: schematic amp_b.kicad_sch, core: TPA3221 zone B (Ultra), part in row 1, column 2]

Parts:
C301: 10uF; C0603; LCSC C19702
C302: 100nF; C0402; LCSC C1525
C304, C306: 1uF; C0402; LCSC C52923
C307, C309: 1uF; C1206; LCSC C282823
C308, C310: 100nF; C0603; LCSC C14663
C311: 470uF/50V; CAP-TH_BD10.0-P5.00-D1.0-FD; LCSC C88733
C312, C320, C321, C322, C323: 33nF; C0603; LCSC C21117
C316, C317, C318, C319: 10uF; C0805; LCSC C15850
C324, C327, C330, C333: 1uF; C0805; LCSC C28323
C326, C329, C332, C335: 470nF; C0603; LCSC C513577
J24: 24.243 red; CONN-TH_24.243.1_RED; MPN 24.243.1; LCSC C7437321; not fitted
J25: 24.243 black; CONN-TH_24.243.2; MPN 24.243.2; LCSC C7437322; not fitted
J26: 24.243 red; CONN-TH_24.243.1_RED; MPN 24.243.1; LCSC C7437321
J27: 24.243 black; CONN-TH_24.243.2; MPN 24.243.2; LCSC C7437322
L5, L6, L7, L8: 10uH; IND-SMD_L8.5-W8.0_PCC-M0854M; LCSC C2962885
R303, R305, R325, R328, R331, R334: 4.7R; R0603; LCSC C23164
R313: 75k; R0402; LCSC C25798
R314: 47k; R0402; LCSC C25792
R315: 0R; R0402; LCSC C17168
U16: TPA3220; HTSSOP-44-1EP_L14.0-W6.1-P0.64-LS8.1-EP7.3x4.43; LCSC C2879306

Connections:
+5V: C301.1, C302.1, R303.1, R305.1, U16.1 (VDD); also elsewhere on the board
/AMP_B_RST: U16.10 (~RESET); also elsewhere on the board
/AMP_FAULT: U16.4 (~FAULT); also elsewhere on the board
/AMP_IN_L: C316.1; also elsewhere on the board
/AMP_IN_R: C318.1; also elsewhere on the board
/AMP_OSCM: U16.12 (OSCM); also elsewhere on the board
/AMP_OSCP: U16.13 (OSCP); also elsewhere on the board
/AMP_OTW: U16.3 (~OTW_CLIP); also elsewhere on the board
/amp_b/B_AVDD: C304.1, R303.2, R314.2, R315.2, U16.21 (AVDD)
/amp_b/B_BST1M: C320.1, U16.43 (BST1_M)
/amp_b/B_BST1P: C321.1, U16.44 (BST1_P)
/amp_b/B_BST2M: C322.1, U16.23 (BST2_M)
/amp_b/B_BST2P: C323.1, U16.24 (BST2_P)
/amp_b/B_CMUTE: C312.1, U16.17 (~CMUTE)
/amp_b/B_FREQ: R315.1, U16.14 (FREQ_ADJ)
/amp_b/B_GAIN: R313.1, R314.1, U16.2 (GAIN/SLV)
/amp_b/B_GVDD: C306.1, R305.2, U16.22 (GVDD)
/amp_b/B_IN1M: C317.1, U16.9 (IN1_M)
/amp_b/B_IN1P: C316.2, U16.8 (IN1_P)
/amp_b/B_IN2M: C319.1, U16.16 (IN2_M)
/amp_b/B_IN2P: C318.2, U16.15 (IN2_P)
/amp_b/B_OUT1M: C320.2, L5.1, U16.35 (OUT1_M)
/amp_b/B_OUT1M_SN: C326.1, R325.2
/amp_b/B_OUT1P: C321.2, L6.1, U16.39 (OUT1_P), U16.40 (OUT1_P)
/amp_b/B_OUT1P_SN: C329.1, R328.2
/amp_b/B_OUT2M: C322.2, L7.1, U16.27 (OUT2_M), U16.28 (OUT2_M)
/amp_b/B_OUT2M_SN: C332.1, R331.2
/amp_b/B_OUT2P: C323.2, L8.1, U16.32 (OUT2_P)
/amp_b/B_OUT2P_SN: C335.1, R334.2
/amp_b/B_SPK_L+: C327.1, J24.1, J24.2, L6.2, R328.1
/amp_b/B_SPK_L-: C324.1, J25.1, J25.2, L5.2, R325.1
/amp_b/B_SPK_R+: C333.1, J26.1, J26.2, L8.2, R334.1
/amp_b/B_SPK_R-: C330.1, J27.1, J27.2, L7.2, R331.1
GND: C301.2, C302.2, C304.2, C306.2, C307.2, C308.2, C309.2, C310.2, C311.2, C312.2, C317.2, C319.2, C324.2, C326.2, C327.2, C329.2, C330.2, C332.2, C333.2, C335.2, R313.2, U16.5 (GND), U16.6 (GND), U16.7 (GND), U16.11 (HEAD), U16.18 (GND), U16.19 (GND), U16.20 (GND), U16.25 (GND), U16.26 (GND), U16.33 (GND), U16.34 (GND), U16.41 (GND), U16.42 (GND), U16.45 (GND); also elsewhere on the board
PVDD: C307.1, C308.1, C309.1, C310.1, C311.1, U16.29 (PVDD), U16.30 (PVDD), U16.31 (PVDD), U16.36 (PVDD), U16.37 (PVDD), U16.38 (PVDD); also elsewhere on the board

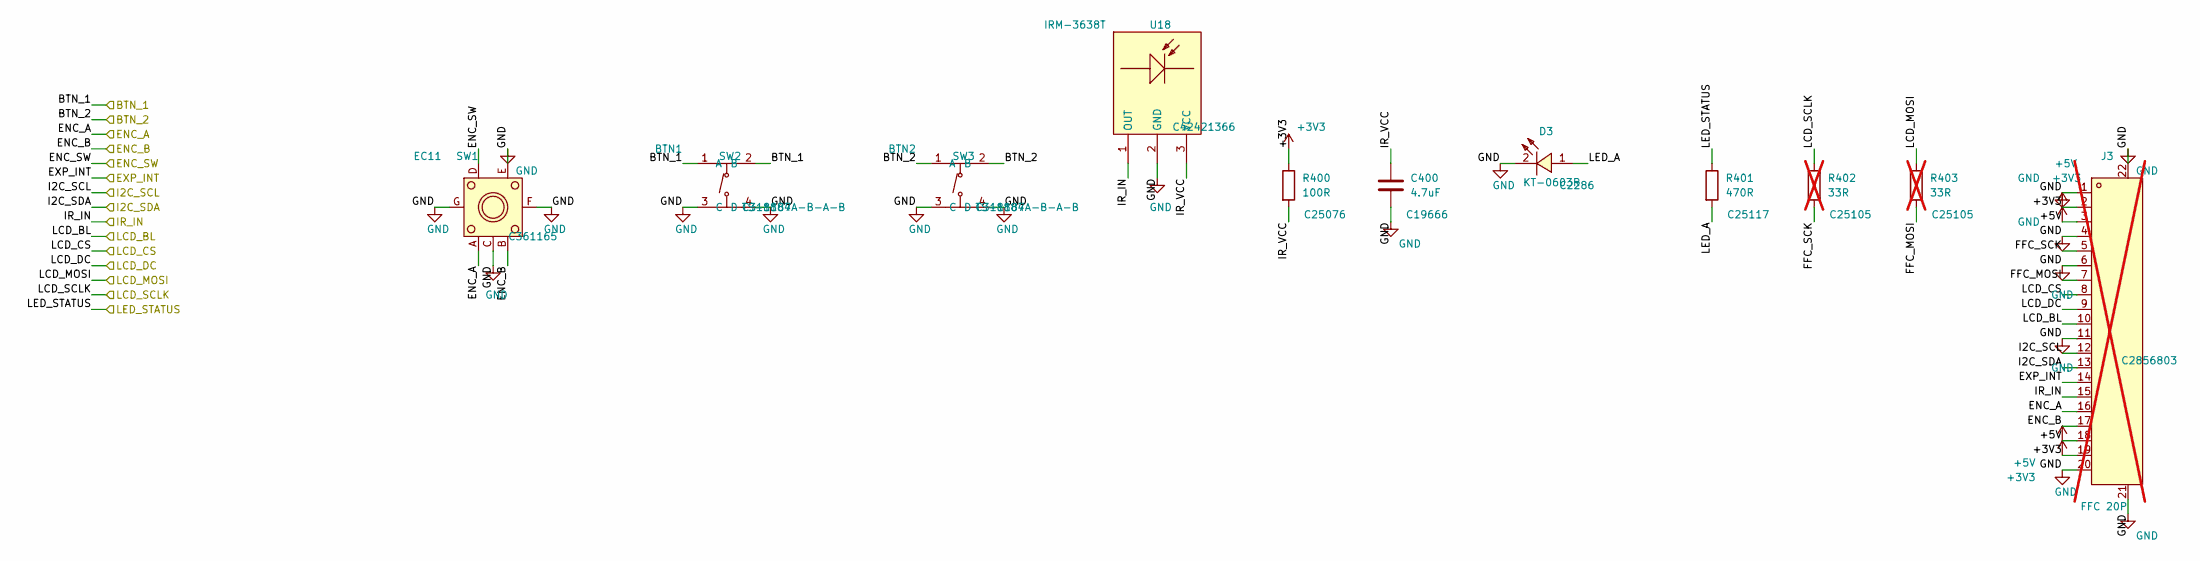
[picture p65: schematic ui.kicad_sch, core: knob, buttons, IR, status LED, front-board FFC]

Parts:
C400: 4.7uF; C0603; LCSC C19666
D3: KT-0603R; LED-SMD_L1.6-W0.8-R-RD; LCSC C2286
J3: FFC 20P; FPC-SMD_20P-P0.50_XUNPU_FPC-05F-20PH20; LCSC C2856803; not fitted
R400: 100R; R0402; LCSC C25076
R401: 470R; R0402; LCSC C25117
R402, R403: 33R; R0402; LCSC C25105; not fitted
SW1: EC11; SW-TH_EC11E1820402; LCSC C361165
SW2: BTN1; SW-SMD_4P-L5.1-W5.1-P3.70-LS6.5-TL_H1.5; MPN TS-1187A-B-A-B; LCSC C318884
SW3: BTN2; SW-SMD_4P-L5.1-W5.1-P3.70-LS6.5-TL_H1.5; MPN TS-1187A-B-A-B; LCSC C318884
U18: IRM-3638T; OPTO-TH_IRM-3638T; LCSC C42421366

Connections:
+3V3: J3.2, J3.19, R400.1; also elsewhere on the board
+5V: J3.3, J3.18; also elsewhere on the board
/BTN_1: SW2.1 (A), SW2.2 (B); also elsewhere on the board
/BTN_2: SW3.1 (A), SW3.2 (B); also elsewhere on the board
/ENC_A: J3.16, SW1.A; also elsewhere on the board
/ENC_B: J3.17, SW1.B; also elsewhere on the board
/ENC_SW: SW1.D; also elsewhere on the board
/EXP_INT: J3.14; also elsewhere on the board
/I2C_SCL: J3.12; also elsewhere on the board
/I2C_SDA: J3.13; also elsewhere on the board
/IR_IN: J3.15, U18.1 (OUT); also elsewhere on the board
/LCD_BL: J3.10; also elsewhere on the board
/LCD_CS: J3.8; also elsewhere on the board
/LCD_DC: J3.9; also elsewhere on the board
/LCD_MOSI: R403.1; also elsewhere on the board
/LCD_SCLK: R402.1; also elsewhere on the board
/LED_STATUS: R401.1; also elsewhere on the board
/ui/FFC_MOSI: J3.7, R403.2
/ui/FFC_SCK: J3.5, R402.2
/ui/IR_VCC: C400.1, R400.2, U18.3 (VCC)
/ui/LED_A: D3.1 (A), R401.2
GND: C400.2, D3.2 (K), J3.1, J3.4, J3.6, J3.11, J3.20, J3.21, J3.22, SW1.C, SW1.E, SW1.F, SW1.G, SW2.3 (C), SW2.4 (D), SW3.3 (C), SW3.4 (D), U18.2 (GND); also elsewhere on the board

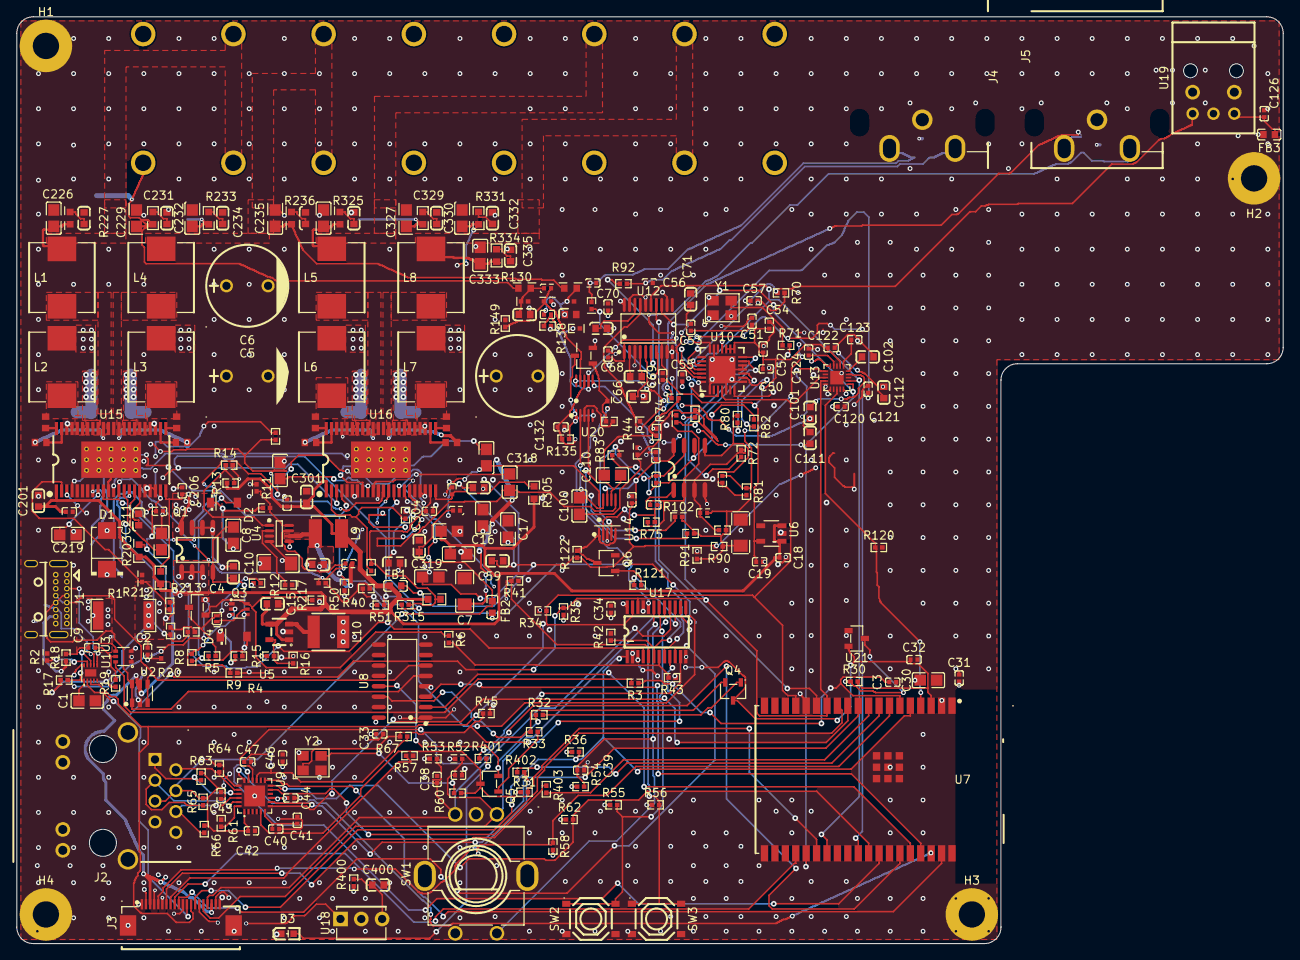
[picture p66: board core.kicad_pcb from above]

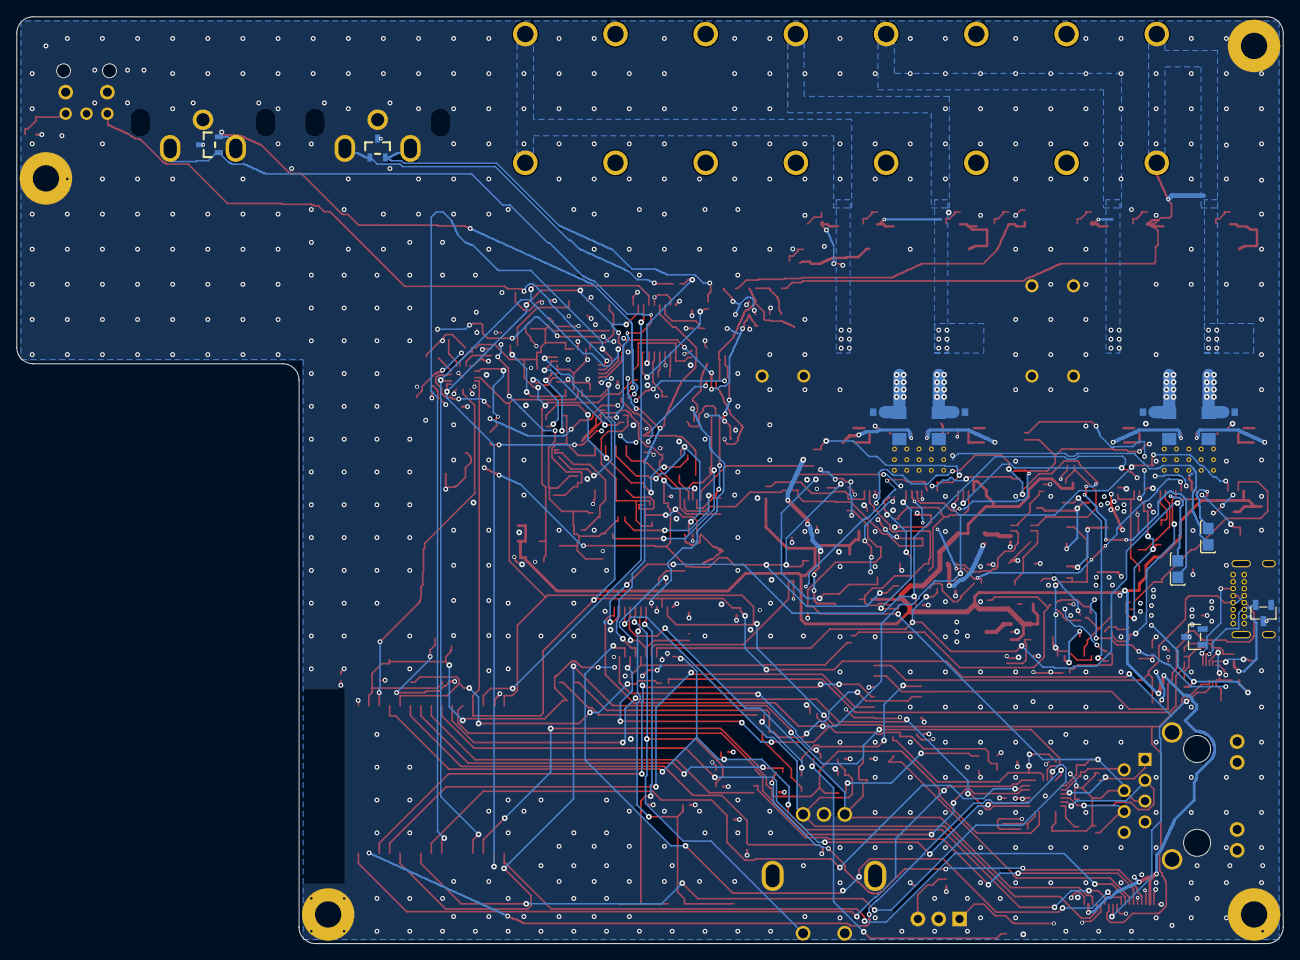
[picture p67: board core.kicad_pcb from below]

Board: 4 copper layers, 154.4 x 113.0 mm, 312 parts (14 on the bottom side), 190 nets.

Other parts of the board:
H1, H2, H3, H4: MountingHole_3.2mm_M3_Pad

Their connections:
GND: H1.1, H2.1, H3.1, H4.1; also elsewhere on the board
