Hive-RSI-Lab/hifi-receiver/boards/lite-main/kicad/lite-main.kicad_pcb

## KiCad design boards/lite-main/kicad/lite-main.kicad_pcb (2026-11-05)

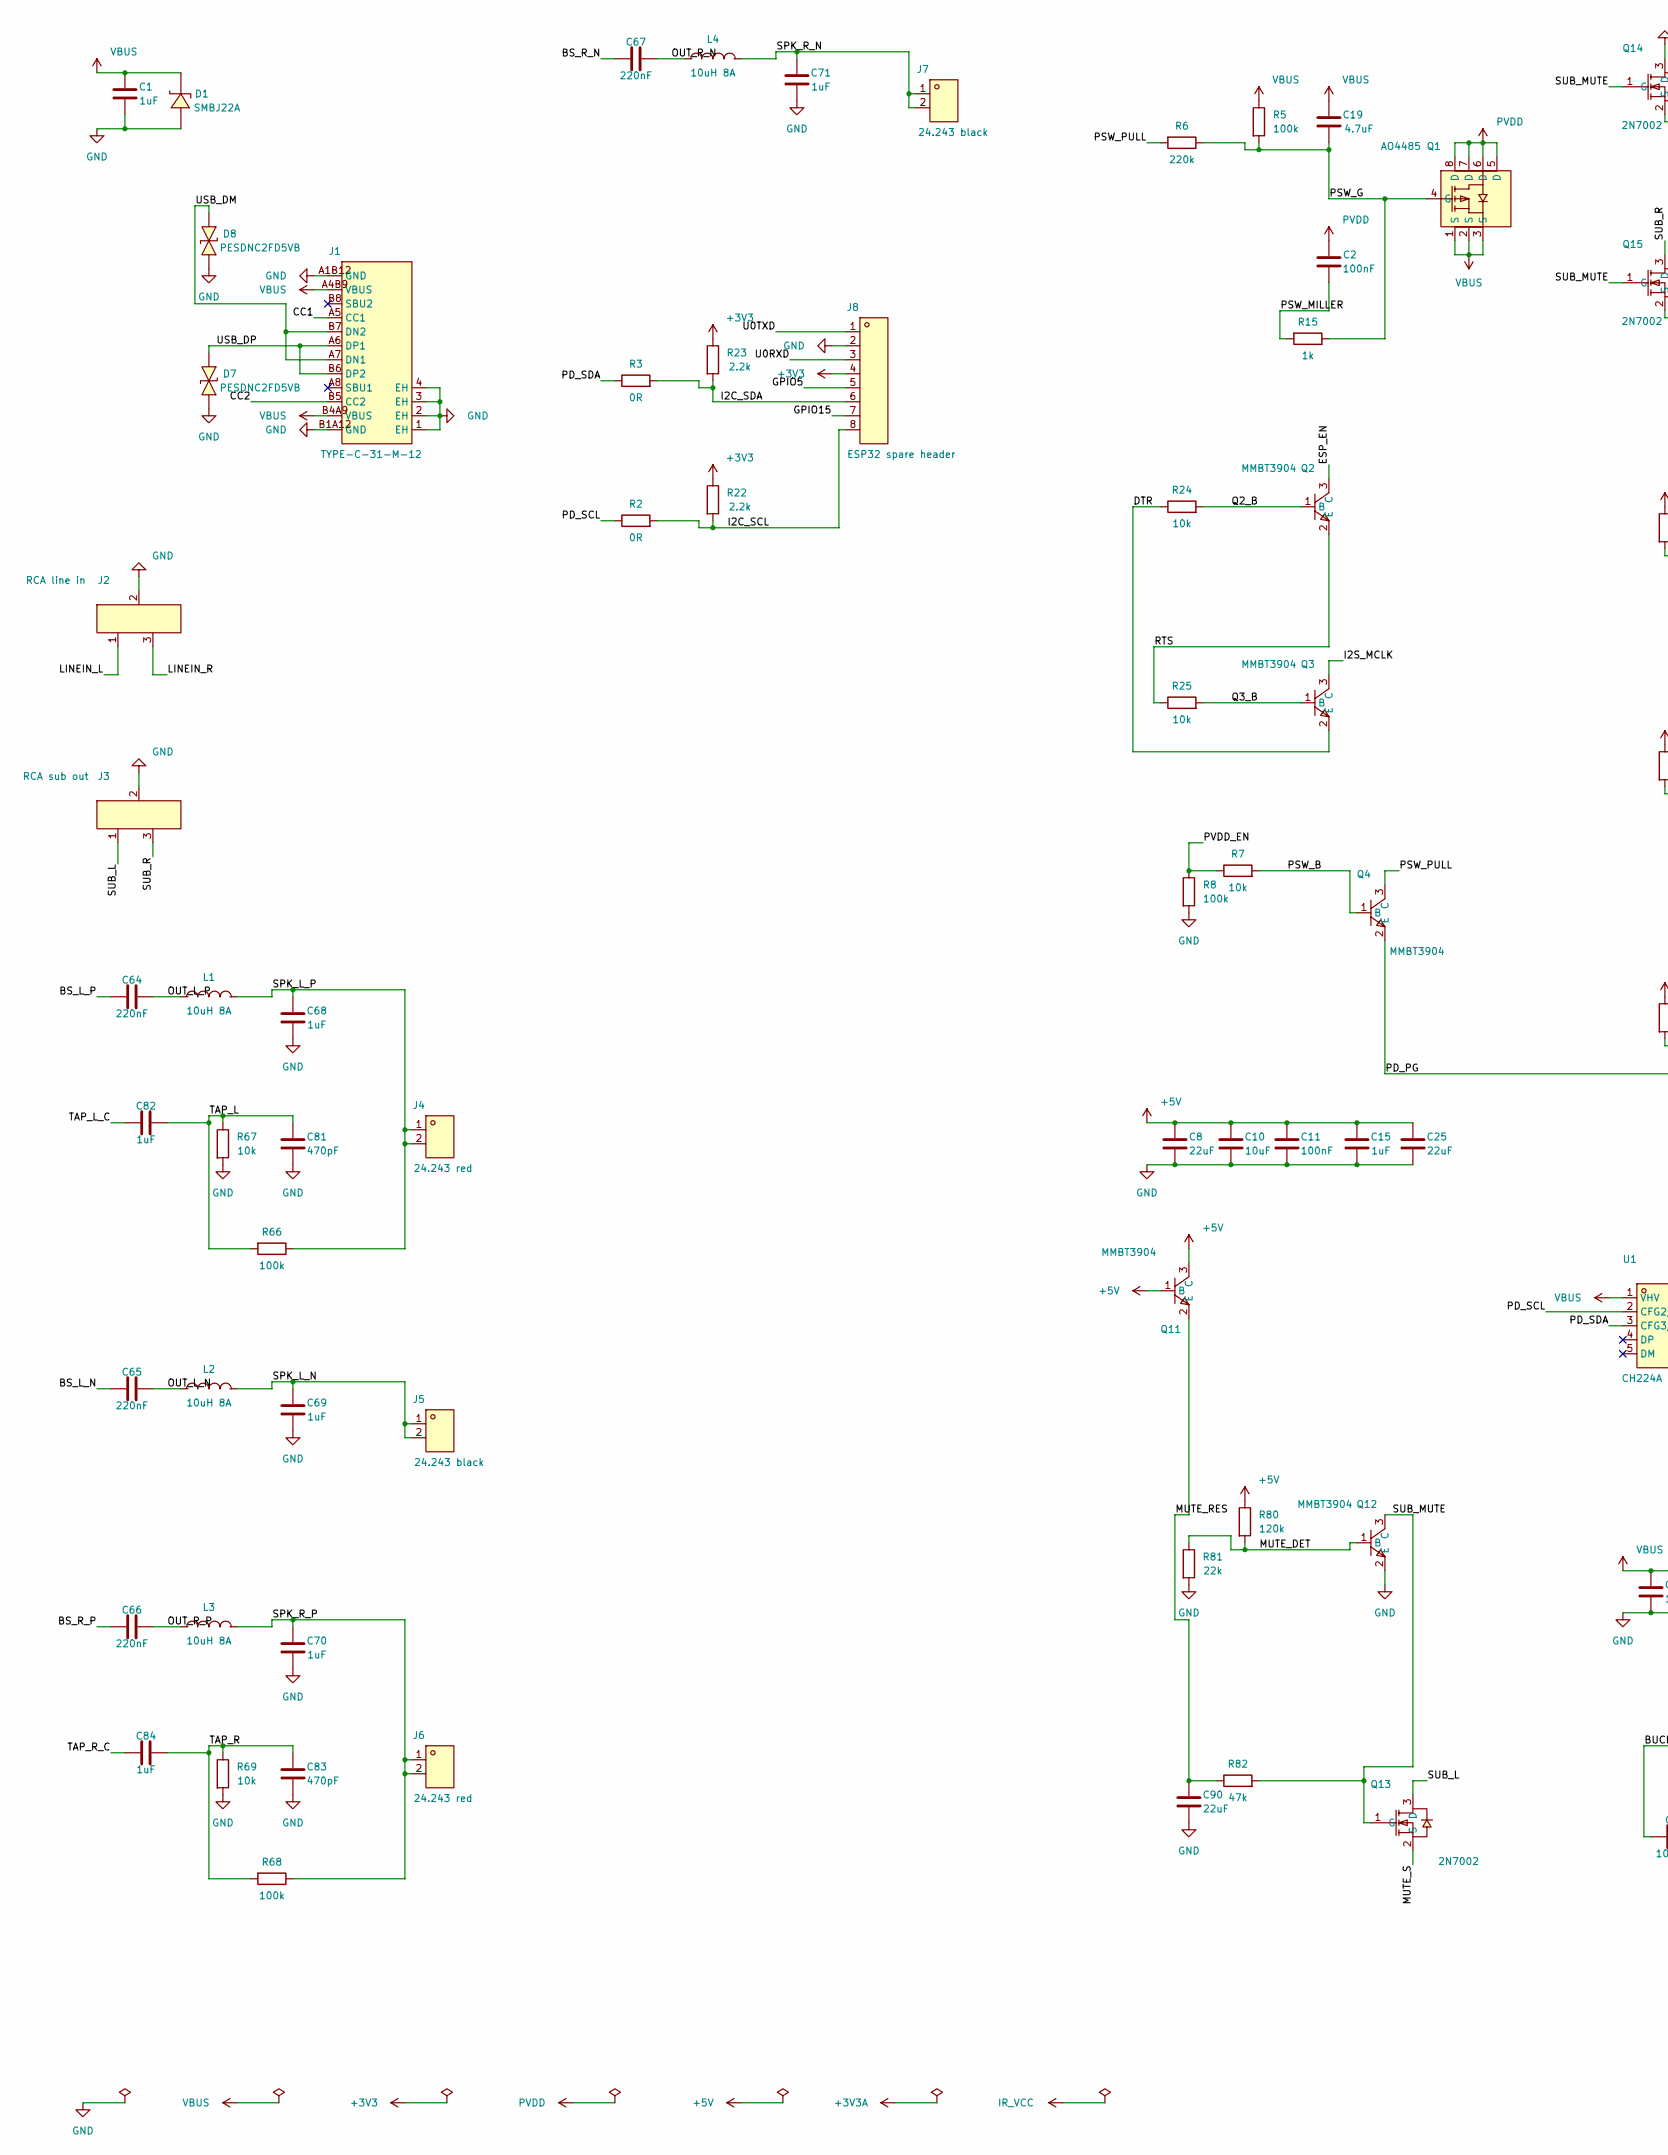
[picture p68: schematic lite-main.kicad_sch, lite-main: hifi-receiver-2 Lite, part in row 1, column 1]

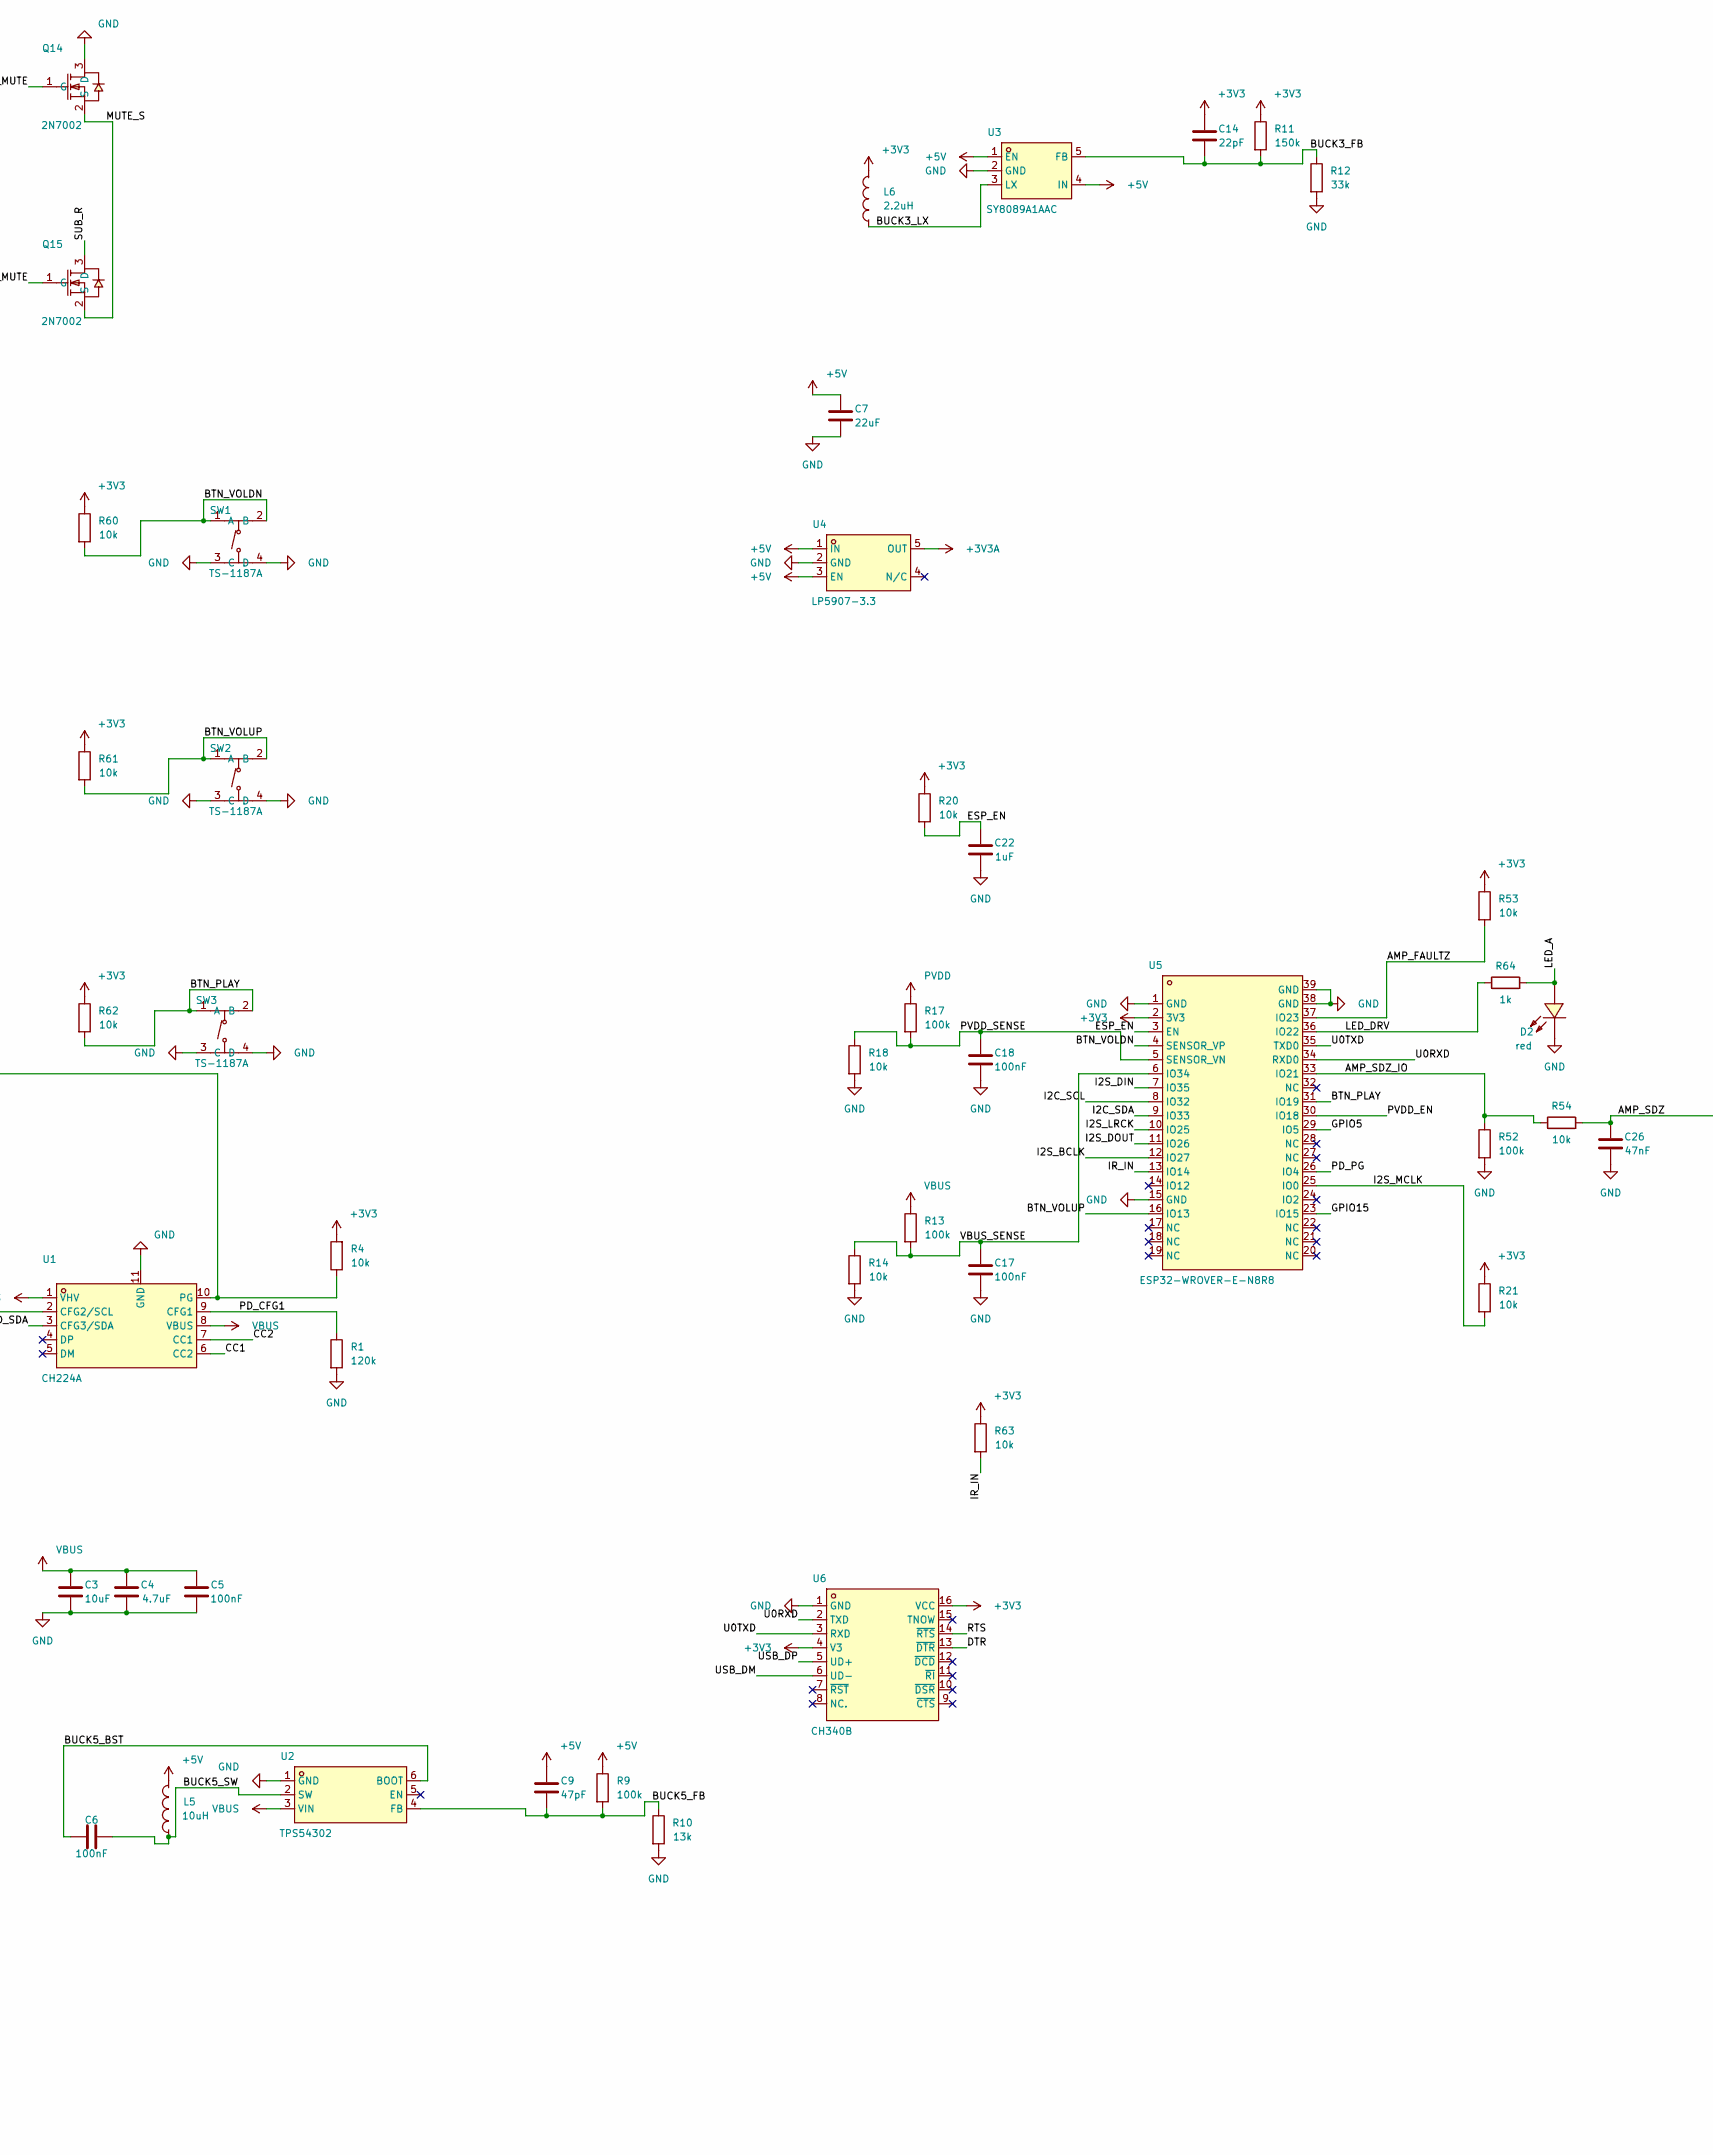
[picture p69: schematic lite-main.kicad_sch, lite-main: hifi-receiver-2 Lite, part in row 1, column 2]

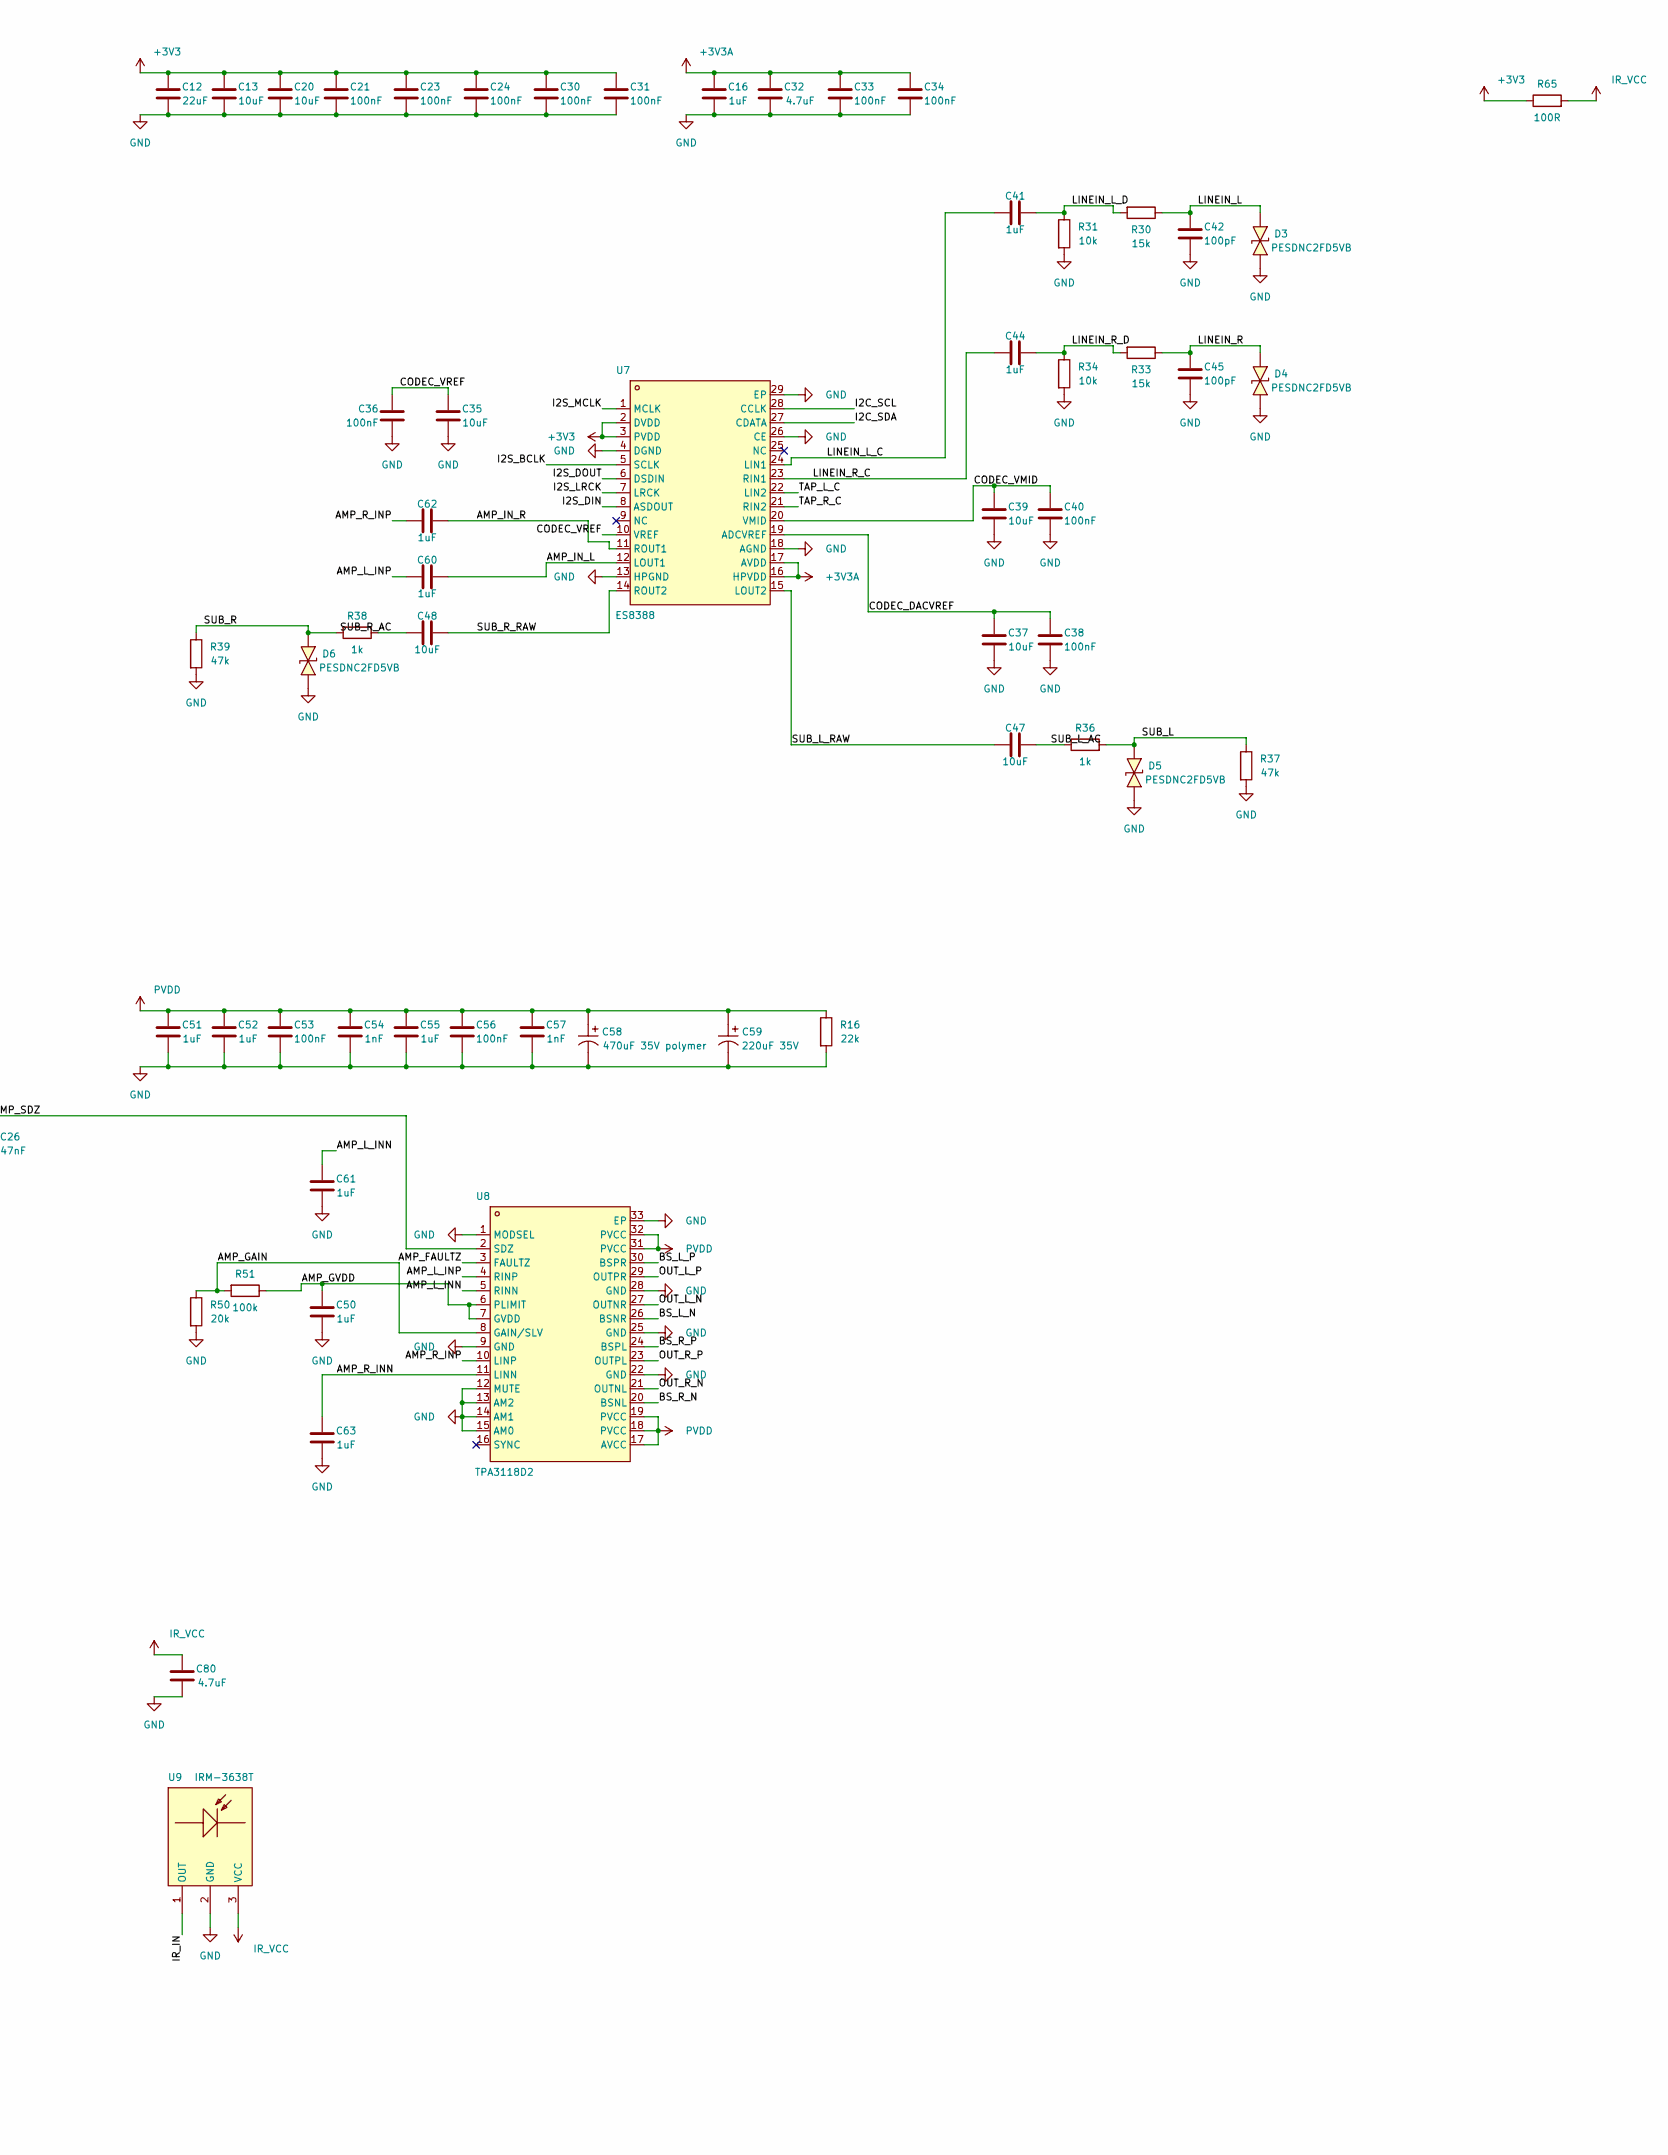
[picture p70: schematic lite-main.kicad_sch, lite-main: hifi-receiver-2 Lite, part in row 1, column 3]

Parts:
C1, C15, C16, C22, C41, C44, C50, C60, C61, C62, C63, C82, C84: 1uF; C_0603_1608Metric; LCSC C15849
C2, C5, C6, C11, C17, C18, C21, C23, C24, C30, C31, C33, C34, C36, C38, C40, C53, C56: 100nF; C_0603_1608Metric; LCSC C14663
C3: 10uF; C_1206_3216Metric; LCSC C13585
C4: 4.7uF; C_1206_3216Metric; LCSC C29823
C7, C8, C12, C25, C90: 22uF; C_0805_2012Metric; LCSC C45783
C9: 47pF; C_0603_1608Metric; LCSC C1671
C10, C13, C20, C35, C37, C39, C47, C48: 10uF; C_0603_1608Metric; LCSC C19702
C14: 22pF; C_0603_1608Metric; LCSC C1653
C19, C32, C80: 4.7uF; C_0603_1608Metric; LCSC C19666
C26: 47nF; C_0603_1608Metric; LCSC C1622
C42, C45: 100pF; C_0603_1608Metric; LCSC C14858
C51, C52, C55: 1uF; C_0805_2012Metric; LCSC C28323
C54, C57: 1nF; C_0603_1608Metric; LCSC C1588
C58: 470uF 35V polymer; CAP-SMD_BD10.0-L10.3-W10.3-FD-LS11.0; LCSC C46550472
C59: 220uF 35V; CAP-SMD_BD8.0-L8.3-W8.3-LS9.3-FD; LCSC C2836441
C64, C65, C66, C67: 220nF; C_0603_1608Metric; LCSC C21120
C68, C69, C70, C71: 1uF; C_1206_3216Metric; LCSC C1848
C81, C83: 470pF; C_0603_1608Metric; LCSC C1620
D1: SMBJ22A; SMB_L4.6-W3.6-LS5.3-RD; LCSC C151920
D2: red; LED-SMD_L1.6-W0.8-R-RD; LCSC C2286
D3, D4, D5, D6, D7, D8: PESDNC2FD5VB; DFN1006-2L-BI; LCSC C110694
J1: TYPE-C-31-M-12; USB-C_SMD-TYPE-C-31-M-12_1; LCSC C165948
J2: RCA line in; CONN-TH_XDJK-0271-1650; LCSC C7527522
J3: RCA sub out; CONN-TH_XDJK-0271-1650; LCSC C7527522
J4, J6: 24.243 red; CONN-TH_24.243.1_RED; LCSC C7437321
J5, J7: 24.243 black; CONN-TH_24.243.2; LCSC C7437322
J8: ESP32 spare header; HDR-SMD_8P-P2.54-V-M-LS4.8_R2; LCSC C2883765
L1, L2, L3, L4: 10uH 8A; IND-SMD_L8.0-W8.0_XR0850; LCSC C48391614
L5: 10uH; IND-SMD_L6.0-W6.0_SWPA6045S; LCSC C79272
L6: 2.2uH; IND-SMD_L4.0-W4.0_VLCF4020; LCSC C305171
Q1: AO4485; SOP-8_L4.9-W3.9-P1.27-LS6.0-BL; LCSC C5125949
Q2, Q3, Q4, Q11, Q12: MMBT3904; SOT-23-3_L2.9-W1.3-P1.90-LS2.4-BR; LCSC C20526
Q13, Q14, Q15: 2N7002; SOT-23-3_L2.9-W1.3-P1.90-LS2.4-BR; LCSC C8545
R1, R80: 120k; R_0603_1608Metric; LCSC C25808
R2, R3: 0R; R_0603_1608Metric; LCSC C21189
R4, R7, R14, R18, R20, R21, R24, R25, R31, R34, R53, R54, R60, R61, R62, R63, R67, R69: 10k; R_0603_1608Metric; LCSC C25804
R5, R8, R9, R13, R17, R51, R52, R66, R68: 100k; R_0603_1608Metric; LCSC C25803
R6: 220k; R_0603_1608Metric; LCSC C22961
R10: 13k; R_0603_1608Metric; LCSC C22797
R11: 150k; R_0603_1608Metric; LCSC C22807
R12: 33k; R_0603_1608Metric; LCSC C4216
R15, R36, R38, R64: 1k; R_0603_1608Metric; LCSC C21190
R16, R81: 22k; R_0603_1608Metric; LCSC C31850
R22, R23: 2.2k; R_0603_1608Metric; LCSC C4190
R30, R33: 15k; R_0603_1608Metric; LCSC C22809
R37, R39, R82: 47k; R_0603_1608Metric; LCSC C25819
R50: 20k; R_0603_1608Metric; LCSC C4184
R65: 100R; R_0603_1608Metric; LCSC C22775
SW1, SW2, SW3: TS-1187A; SW-SMD_4P-L5.1-W5.1-P3.70-LS6.5-TL_H1.5; LCSC C318884
U1: CH224A; ESSOP-10_L4.9-W3.9-P1.0-LS6.0-TL-EP; LCSC C42459160
U2: TPS54302; SOT-23-6_L2.9-W1.6-P0.95-LS2.8-BL; LCSC C311983
U3: SY8089A1AAC; TSOT-23-5_L2.9-W1.6-P0.95-LS2.8-BR; LCSC C479074
U4: LP5907-3.3; SOT-23-5_L3.0-W1.7-P0.95-LS2.8-BR; LCSC C80670
U5: ESP32-WROVER-E-N8R8; WIFI-SMD_ESP32-WROVER-IE8MB; LCSC C2973667
U6: CH340B; SOP-16_L10.0-W3.9-P1.27-LS6.0-BL; LCSC C81010
U7: ES8388; QFN-28_L4.0-W4.0-P0.45-BL-EP; LCSC C365736
U8: TPA3118D2; HTSSOP-32_L11.0-W6.1-P0.65-LS8.1-BL-EP; LCSC C46497
U9: IRM-3638T; OPTO-TH_IRM-3638T; LCSC C42421366

Connections:
+3V3: C12.1, C13.1, C14.1, C20.1, C21.1, C23.1, C24.1, C30.1, C31.1, J8.4, L6.2, R4.2, R11.1, R20.1, R21.1, R22.1, R23.1, R53.1, R60.1, R61.1, R62.1, R63.1, R65.1, U5.2 (3V3), U6.4 (V3), U6.16 (VCC), U7.2 (DVDD), U7.3 (PVDD)
+3V3A: C16.1, C32.1, C33.1, C34.1, U4.5 (OUT), U7.16 (HPVDD), U7.17 (AVDD)
+5V: C7.1, C8.1, C9.1, C10.1, C11.1, C15.1, C25.1, L5.2, Q11.1 (B), Q11.3 (C), R9.1, R80.1, U3.1 (EN), U3.4 (IN), U4.1 (IN), U4.3 (EN)
/AMP_FAULTZ: R53.2, U5.37 (IO23), U8.3 (FAULTZ)
/AMP_GAIN: R50.1, R51.2, U8.8 (GAIN/SLV)
/AMP_GVDD: C50.1, R51.1, U8.6 (PLIMIT), U8.7 (GVDD)
/AMP_IN_L: C60.1, U7.12 (LOUT1)
/AMP_IN_R: C62.1, U7.11 (ROUT1)
/AMP_L_INN: C61.1, U8.5 (RINN)
/AMP_L_INP: C60.2, U8.4 (RINP)
/AMP_R_INN: C63.1, U8.11 (LINN)
/AMP_R_INP: C62.2, U8.10 (LINP)
/AMP_SDZ: C26.1, R54.2, U8.2 (SDZ)
/AMP_SDZ_IO: R52.1, R54.1, U5.33 (IO21)
/BS_L_N: C65.1, U8.26 (BSNR)
/BS_L_P: C64.1, U8.30 (BSPR)
/BS_R_N: C67.1, U8.20 (BSNL)
/BS_R_P: C66.1, U8.24 (BSPL)
/BTN_PLAY: R62.2, SW3.1 (A), SW3.2 (B), U5.31 (IO19)
/BTN_VOLDN: R60.2, SW1.1 (A), SW1.2 (B), U5.4 (SENSOR_VP)
/BTN_VOLUP: R61.2, SW2.1 (A), SW2.2 (B), U5.16 (IO13)
/BUCK3_FB: C14.2, R11.2, R12.1, U3.5 (FB)
/BUCK3_LX: L6.1, U3.3 (LX)
/BUCK5_BST: C6.1, U2.6 (BOOT)
/BUCK5_FB: C9.2, R9.2, R10.1, U2.4 (FB)
/BUCK5_SW: C6.2, L5.1, U2.2 (SW)
/CC1: J1.A5 (CC1), U1.6 (CC2)
/CC2: J1.B5 (CC2), U1.7 (CC1)
/CODEC_DACVREF: C37.1, C38.1, U7.19 (ADCVREF)
/CODEC_VMID: C39.1, C40.1, U7.20 (VMID)
/CODEC_VREF: C35.1, C36.1, U7.10 (VREF)
/DTR: Q3.2 (E), R24.1, U6.13 (~DTR)
/ESP_EN: C22.1, Q2.3 (C), R20.2, U5.3 (EN)
/GPIO5: J8.5, U5.29 (IO5)
/GPIO15: J8.7, U5.23 (IO15)
/I2C_SCL: J8.8, R2.2, R22.2, U5.8 (IO32), U7.28 (CCLK)
/I2C_SDA: J8.6, R3.2, R23.2, U5.9 (IO33), U7.27 (CDATA)
/I2S_BCLK: U5.12 (IO27), U7.5 (SCLK)
/I2S_DIN: U5.7 (IO35), U7.8 (ASDOUT)
/I2S_DOUT: U5.11 (IO26), U7.6 (DSDIN)
/I2S_LRCK: U5.10 (IO25), U7.7 (LRCK)
/I2S_MCLK: Q3.3 (C), R21.2, U5.25 (IO0), U7.1 (MCLK)
/IR_IN: R63.2, U5.13 (IO14), U9.1 (OUT)
/LED_A: D2.1 (A), R64.2
/LED_DRV: R64.1, U5.36 (IO22)
/LINEIN_L: C42.1, D3.1, J2.1, R30.1
/LINEIN_L_C: C41.2, U7.24 (LIN1)
/LINEIN_L_D: C41.1, R30.2, R31.1
/LINEIN_R: C45.1, D4.1, J2.3, R33.1
/LINEIN_R_C: C44.2, U7.23 (RIN1)
/LINEIN_R_D: C44.1, R33.2, R34.1
/MUTE_DET: Q12.1 (B), R80.2, R81.1
/MUTE_RES: C90.1, Q11.2 (E), R82.1
/MUTE_S: Q13.2 (S), Q14.2 (S), Q15.2 (S)
/OUT_L_N: C65.2, L2.1, U8.27 (OUTNR)
/OUT_L_P: C64.2, L1.1, U8.29 (OUTPR)
/OUT_R_N: C67.2, L4.1, U8.21 (OUTNL)
/OUT_R_P: C66.2, L3.1, U8.23 (OUTPL)
/PD_CFG1: R1.1, U1.9 (CFG1)
/PD_PG: Q4.2 (E), R4.1, U1.10 (PG), U5.26 (IO4)
/PD_SCL: R2.1, U1.2 (CFG2/SCL)
/PD_SDA: R3.1, U1.3 (CFG3/SDA)
/PSW_B: Q4.1 (B), R7.2
/PSW_G: C19.2, Q1.4 (G), R5.2, R6.1, R15.1
/PSW_MILLER: C2.1, R15.2
/PSW_PULL: Q4.3 (C), R6.2
/PVDD_EN: R7.1, R8.1, U5.30 (IO18)
/PVDD_SENSE: C18.1, R17.2, R18.1, U5.5 (SENSOR_VN)
/Q2_B: Q2.1 (B), R24.2
/Q3_B: Q3.1 (B), R25.2
/RTS: Q2.2 (E), R25.1, U6.14 (~RTS)
/SPK_L_N: C69.1, J5.1, J5.2, L2.2
/SPK_L_P: C68.1, J4.1, J4.2, L1.2, R66.1
/SPK_R_N: C71.1, J7.1, J7.2, L4.2
/SPK_R_P: C70.1, J6.1, J6.2, L3.2, R68.1
/SUB_L: D5.1, J3.1, Q13.3 (D), R36.2, R37.1
/SUB_L_AC: C47.2, R36.1
/SUB_L_RAW: C47.1, U7.15 (LOUT2)
/SUB_MUTE: Q12.3 (C), Q13.1 (G), Q14.1 (G), Q15.1 (G), R82.2
/SUB_R: D6.1, J3.3, Q15.3 (D), R38.2, R39.1
/SUB_R_AC: C48.2, R38.1
/SUB_R_RAW: C48.1, U7.14 (ROUT2)
/TAP_L: C81.1, C82.1, R66.2, R67.1
/TAP_L_C: C82.2, U7.22 (LIN2)
/TAP_R: C83.1, C84.1, R68.2, R69.1
/TAP_R_C: C84.2, U7.21 (RIN2)
/U0RXD: J8.3, U5.34 (RXD0), U6.2 (TXD)
/U0TXD: J8.1, U5.35 (TXD0), U6.3 (RXD)
/USB_DM: D8.1, J1.A7 (DN1), J1.B7 (DN2), U6.6 (UD-)
/USB_DP: D7.1, J1.A6 (DP1), J1.B6 (DP2), U6.5 (UD+)
/VBUS_SENSE: C17.1, R13.2, R14.1, U5.6 (IO34)
GND: C1.2, C3.2, C4.2, C5.2, C7.2, C8.2, C10.2, C11.2, C12.2, C13.2, C15.2, C16.2, C17.2, C18.2, C20.2, C21.2, C22.2, C23.2, C24.2, C25.2, C26.2, C30.2, C31.2, C32.2, C33.2, C34.2, C35.2, C36.2, C37.2, C38.2, C39.2, C40.2, C42.2, C45.2, C50.2, C51.2, C52.2, C53.2, C54.2, C55.2, C56.2, C57.2, C58.2, C59.2, C61.2, C63.2, C68.2, C69.2, C70.2, C71.2, C80.2, C81.2, C83.2, C90.2, D1.2 (A), D2.2 (K), D3.2, D4.2, D5.2, D6.2, D7.2, D8.2, J1.1 (EH), J1.2 (EH), J1.3 (EH), J1.4 (EH), J1.A1B12 (GND), J1.B1A12 (GND), J2.2, J3.2, J8.2, Q12.2 (E), Q14.3 (D), R1.2, R8.2, R10.2, R12.2, R14.2, R16.2, R18.2, R31.2, R34.2, R37.2, R39.2, R50.2, R52.2, R67.2, R69.2, R81.2, SW1.3 (C), SW1.4 (D), SW2.3 (C), SW2.4 (D), SW3.3 (C), SW3.4 (D), U1.11 (GND), U2.1 (GND), U3.2 (GND), U4.2 (GND), U5.1 (GND), U5.15 (GND), U5.38 (GND), U5.39 (GND), U6.1 (GND), U7.4 (DGND), U7.13 (HPGND), U7.18 (AGND), U7.26 (CE), U7.29 (EP), U8.1 (MODSEL), U8.9 (GND), U8.12 (MUTE), U8.13 (AM2), U8.14 (AM1), U8.15 (AM0), U8.22 (GND), U8.25 (GND), U8.28 (GND), U8.33 (EP), U9.2 (GND); also elsewhere on the board
IR_VCC: C80.1, R65.2, U9.3 (VCC)
PVDD: C2.2, C51.1, C52.1, C53.1, C54.1, C55.1, C56.1, C57.1, C58.1, C59.1, Q1.5 (D), Q1.6 (D), Q1.7 (D), Q1.8 (D), R16.1, R17.1, U8.17 (AVCC), U8.18 (PVCC), U8.19 (PVCC), U8.31 (PVCC), U8.32 (PVCC)
VBUS: C1.1, C3.1, C4.1, C5.1, C19.1, D1.1 (K), J1.A4B9 (VBUS), J1.B4A9 (VBUS), Q1.1 (S), Q1.2 (S), Q1.3 (S), R5.1, R13.1, U1.1 (VHV), U1.8 (VBUS), U2.3 (VIN)

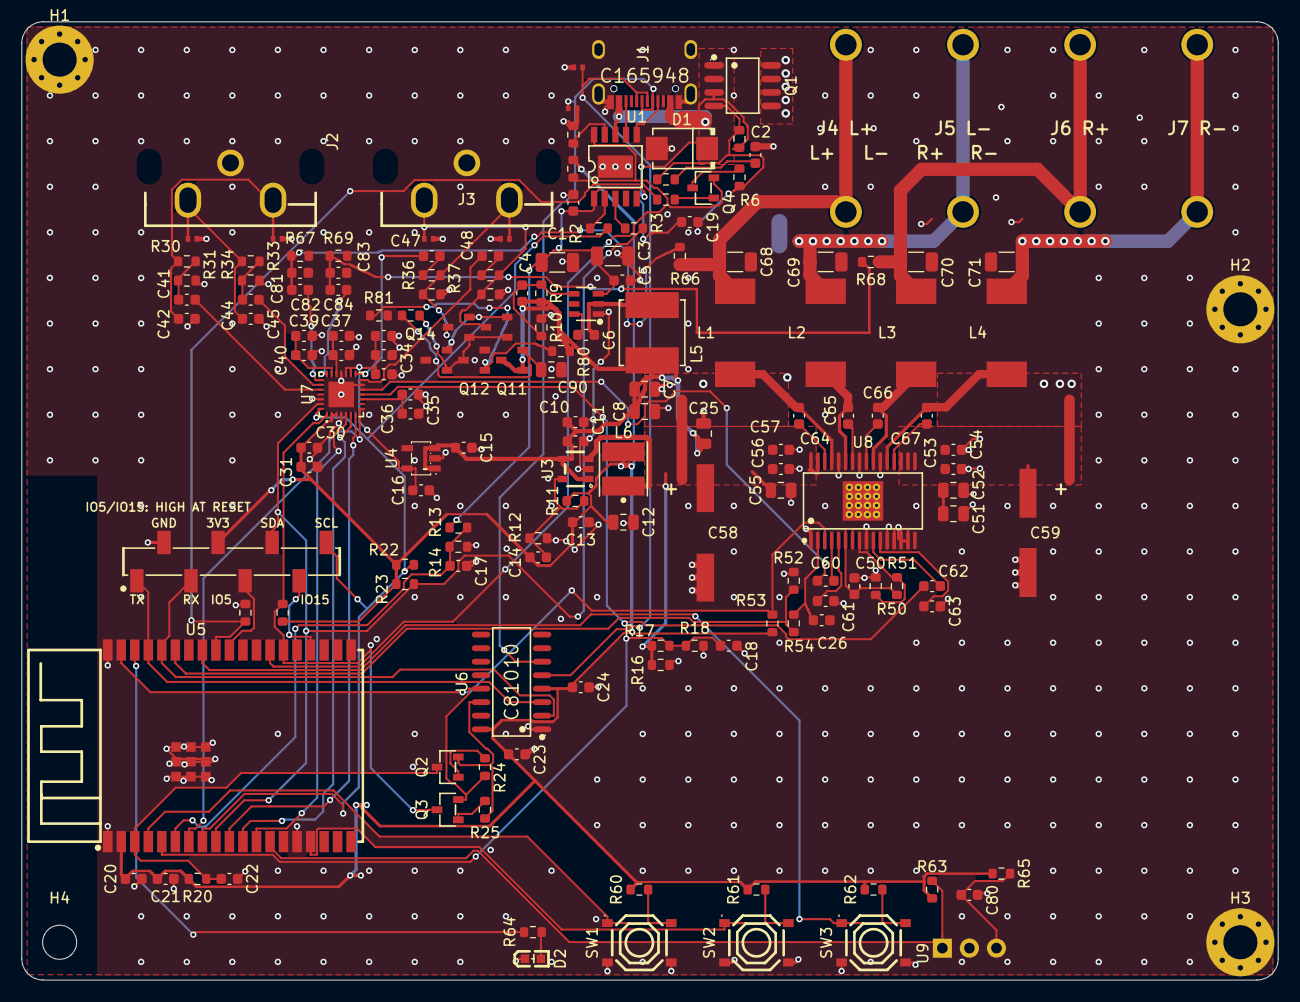
[picture p71: board lite-main.kicad_pcb from above]

Board: 2 copper layers, 118.0 x 90.0 mm, 168 parts (0 on the bottom side), 95 nets.

Other parts of the board:
H1, H2, H3: MountingHole_3.2mm_M3_Pad_Via
H4: MountingHole_3.2mm_M3

Their connections:
GND: H1.1, H2.1, H3.1; also elsewhere on the board
