Hive-RSI-Lab/hifi-receiver/boards/ultra-front/kicad/ultra-front.kicad_pcb

## KiCad design boards/ultra-front/kicad/ultra-front.kicad_pcb (2026-11-01)

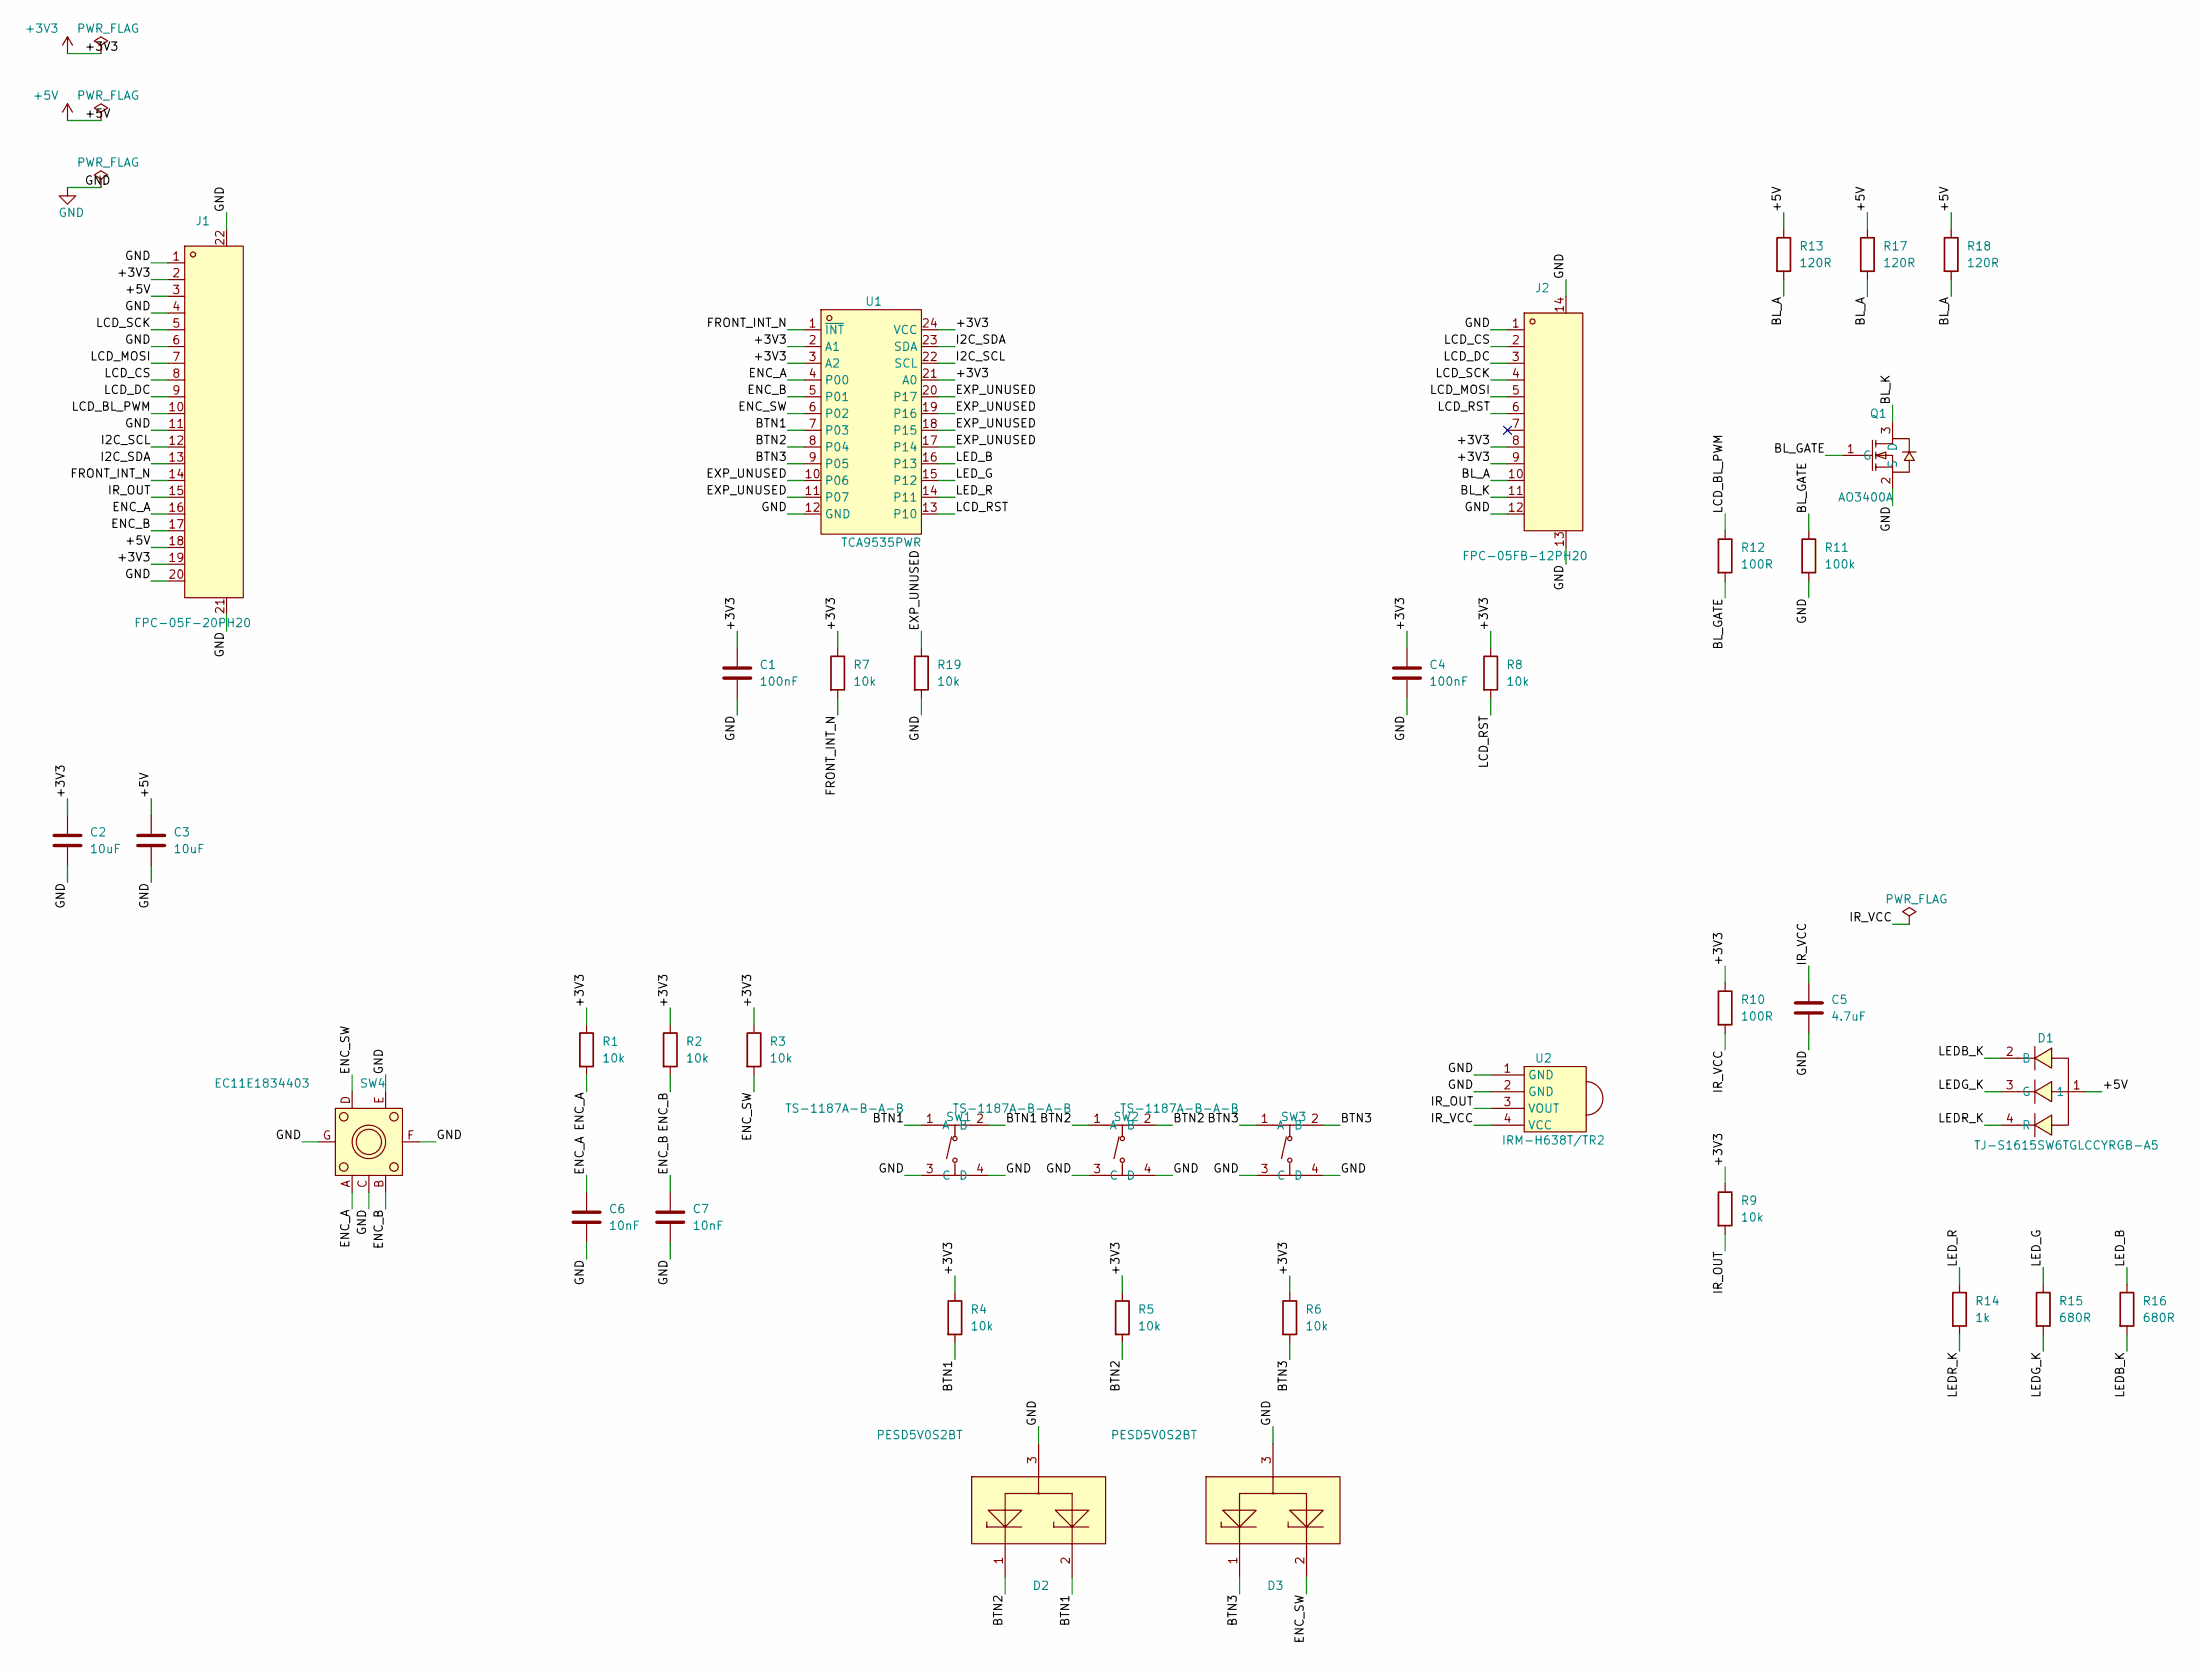
[picture p72: schematic ultra-front.kicad_sch, ultra-front: Ultra front panel]

Parts:
C1, C4: 100nF; C0603
C2, C3: 10uF; C0805
C5: 4.7uF; C0603
C6, C7: 10nF; C0603
D1: TJ-S1615SW6TGLCCYRGB-A5; LED-SMD_4P-L1.6-W1.5-TR
D2, D3: PESD5V0S2BT; SOT-23_L2.9-W1.3-P1.90-LS2.4-BR
J1: FPC-05F-20PH20; FPC-SMD_20P-P0.50_XUNPU_FPC-05F-20PH20
J2: FPC-05FB-12PH20; FPC-SMD_12P-P0.50_XUNPU_FPC-05FB-12PH20
Q1: AO3400A; SOT-23-3_L2.9-W1.3-P1.90-LS2.4-BR
R1, R2, R3, R4, R5, R6, R7, R8, R9, R19: 10k; R0603
R10, R12: 100R; R0603
R11: 100k; R0603
R13, R17, R18: 120R; R0603
R14: 1k; R0603
R15, R16: 680R; R0603
SW1, SW2, SW3: TS-1187A-B-A-B; SW-SMD_4P-L5.1-W5.1-P3.70-LS6.5-TL_H1.5
SW4: EC11E1834403; SW-TH_EC11E1820402
U1: TCA9535PWR; TSSOP-24_L7.8-W4.4-P0.65-LS6.4-BL
U2: IRM-H638T/TR2; SENSOR-SMD_IRM-H638T-TR2-TL

Connections:
+3V3: C1.1, C2.1, C4.1, J1.2, J1.19, J2.8, J2.9, R1.1, R2.1, R3.1, R4.1, R5.1, R6.1, R7.1, R8.1, R9.1, R10.1, U1.2 (A1), U1.3 (A2), U1.21 (A0), U1.24 (VCC)
+5V: C3.1, D1.1, J1.3, J1.18, R13.1, R17.1, R18.1
/BL_A: J2.10, R13.2, R17.2, R18.2
/BL_GATE: Q1.1 (G), R11.1, R12.2
/BL_K: J2.11, Q1.3 (D)
/BTN1: D2.2, R4.2, SW1.1 (A), SW1.2 (B), U1.7 (P03)
/BTN2: D2.1, R5.2, SW2.1 (A), SW2.2 (B), U1.8 (P04)
/BTN3: D3.1, R6.2, SW3.1 (A), SW3.2 (B), U1.9 (P05)
/ENC_A: C6.1, J1.16, R1.2, SW4.A, U1.4 (P00)
/ENC_B: C7.1, J1.17, R2.2, SW4.B, U1.5 (P01)
/ENC_SW: D3.2, R3.2, SW4.D, U1.6 (P02)
/EXP_UNUSED: R19.1, U1.10 (P06), U1.11 (P07), U1.17 (P14), U1.18 (P15), U1.19 (P16), U1.20 (P17)
/FRONT_INT_N: J1.14, R7.2, U1.1 (~INT)
/I2C_SCL: J1.12, U1.22 (SCL)
/I2C_SDA: J1.13, U1.23 (SDA)
/IR_OUT: J1.15, R9.2, U2.3 (VOUT)
/IR_VCC: C5.1, R10.2, U2.4 (VCC)
/LCD_BL_PWM: J1.10, R12.1
/LCD_CS: J1.8, J2.2
/LCD_DC: J1.9, J2.3
/LCD_MOSI: J1.7, J2.5
/LCD_RST: J2.6, R8.2, U1.13 (P10)
/LCD_SCK: J1.5, J2.4
/LEDB_K: D1.2 (B), R16.2
/LEDG_K: D1.3 (G), R15.2
/LEDR_K: D1.4 (R), R14.2
/LED_B: R16.1, U1.16 (P13)
/LED_G: R15.1, U1.15 (P12)
/LED_R: R14.1, U1.14 (P11)
GND: C1.2, C2.2, C3.2, C4.2, C5.2, C6.2, C7.2, D2.3, D3.3, J1.1, J1.4, J1.6, J1.11, J1.20, J1.21, J1.22, J2.1, J2.12, J2.13, J2.14, Q1.2 (S), R11.2, R19.2, SW1.3 (C), SW1.4 (D), SW2.3 (C), SW2.4 (D), SW3.3 (C), SW3.4 (D), SW4.C, SW4.E, SW4.F, SW4.G, U1.12 (GND), U2.1 (GND), U2.2 (GND); also elsewhere on the board
