Hive-RSI-Lab/hifi-receiver/boards/ultra-front/kicad/ultra-front.kicad_pcb

## KiCad design boards/ultra-front/kicad/ultra-front.kicad_pcb (continued)

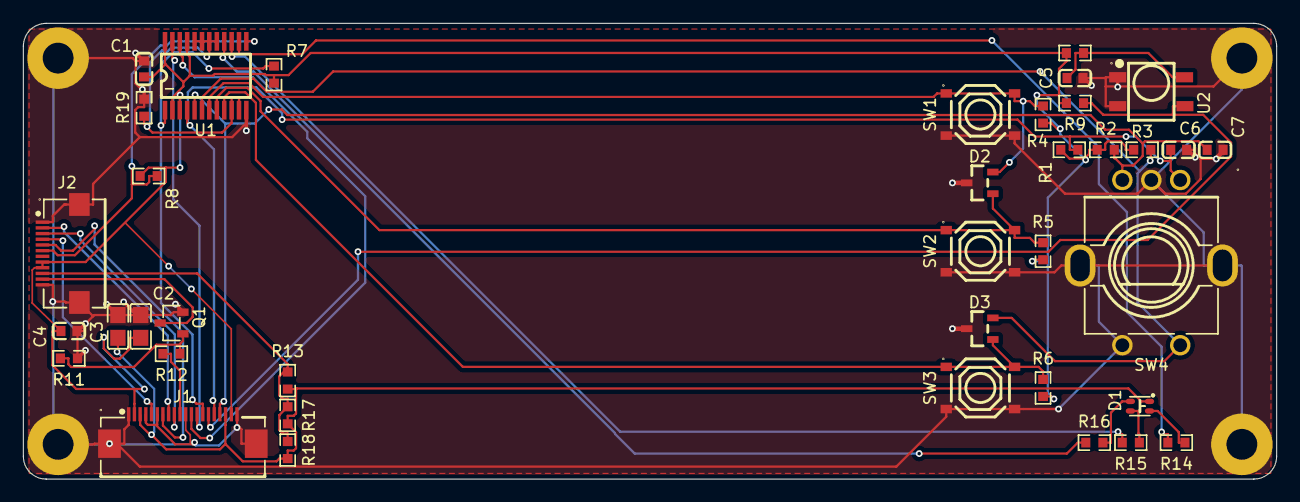
[picture p73: board ultra-front.kicad_pcb from above]

Board: 2 copper layers, 110.0 x 40.0 mm, 42 parts (0 on the bottom side), 30 nets.

Other parts of the board:
H1, H2, H3, H4: MountingHole_2.7mm_M2.5_Pad

Their connections:
GND: H1.1, H2.1, H3.1, H4.1; also elsewhere on the board
