Hive-RSI-Lab/hifi-receiver/firmware/components/hifi/core/hifi_power.c

#include "hifi_power.h"

#include <string.h>

#define ELAPSED(now, t) ((uint32_t) ((now) - (t)))

void hifi_power_cfg_lite(hifi_power_cfg_t *cfg) {
	*cfg = (hifi_power_cfg_t) {
		/* TPA3118: 4.5-26 V; the 20 V contract may sit at 19-21 V. The start
		 * floor is the PVDD switch's: its gate divider (R5 100k over R6 220k)
		 * gives Q1 only VBUS x 0.31 of gate drive, 2.2-2.3 V at 9 V, which a
		 * max-Vth AO4485 (2.5 V) doesn't turn on at, and 3.7 V at 15 V
		 * (docs/review-2/second-read.md), so 9 and 12 V contracts don't start
		 * the amp. Once on, a 15 V contract (14.25 V at -5 %) may sag under
		 * load and cable drop: the brownout floor is 13 V, over a 12 V
		 * contract's 12.6 V and still ~4 V of gate drive. 25 V leaves a volt
		 * under the amp's limit. */
		.v_start = 14.0f,
		.v_min = 13.0f,
		.v_max = 25.0f,
		.settle_ms = 200,
		/* lite-main's gate RC (R5||R6 with C19 4.7 uF) holds PVDD off for
		 * 80-160 ms after PVDD_EN and reaches 90 % 110-210 ms after it at
		 * 15-20 V (sims in docs/review-2/second-read.md): the amp waits about
		 * twice that */
		.soft_start_ms = 400,
		.recover_ms = 1000,
		.fault_blank_ms = 50,
		.fault_retry_ms = 1000,
		.fault_window_ms = 60000,
		.fault_latch = 3,
		.idle_off_ms = 10 * 60 * 1000,
		/* PVDD_SENSE (R17 100k over R18 10k, C18 100 nF) on GPIO39. Q1's
		 * drop is ~0.1 V at 5 A, the dividers' tolerances a few percent:
		 * under 85 % of VBUS the switch is open or not fully on. The gate RC
		 * has PVDD at 90 % by 210 ms; 1 s is the slowest it may take. A dip
		 * must last 50 ms to count (GPIO39 glitches with Wi-Fi, errata 3.11). */
		.pvdd_min_frac = 0.85f,
		.pvdd_timeout_ms = 1000,
		.pvdd_drop_ms = 50,
	};
}

void hifi_power_cfg_core(hifi_power_cfg_t *cfg) {
	hifi_power_cfg_lite(cfg);
	/* TPA3220: 7-32 V recommended (37 V absolute). core's firmware asks the
	 * CH224Q for 28 V (EPR) or 20 V and takes VBUS to be that once PG is
	 * good: the board has no VBUS divider to read. The floor keeps 9 and
	 * 12 V contracts out (too little for 4 ohm speakers at volume) */
	cfg->v_start = 14.0f;
	cfg->v_min = 13.0f;
	cfg->v_max = 30.0f;
	/* PVDD ramps through C4 on Q1's gate-drain. With zone B's C311 the bulk
	 * is 1410 uF and PVDD reaches 90 % 122-196 ms after PVDD_EN (review-3
	 * R3-POWER-2, docs/review-3/sims/power/pvdd/): the amps come out of
	 * reset at 500 ms, once it is charged, so no amp current flows through
	 * Q1 mid-ramp. Q1's gate sits at VBUS/2 (R4/R5), 7 V at the 14 V start
	 * floor */
	cfg->soft_start_ms = 500;
	/* a contract change (the firmware's own VREQ, EPR entry) settles 500 ms
	 * before PVDD closes (R3-POWER-5) */
	cfg->settle_ms = 500;
	/* core has no PVDD sense: the sequencer runs on time alone */
	cfg->pvdd_min_frac = 0;
}

void hifi_power_init(hifi_power_t *p, const hifi_power_cfg_t *cfg, uint32_t now_ms) {
	memset(p, 0, sizeof(*p));
	p->cfg = *cfg;
	p->state = HIFI_PWR_WAIT_PD;
	p->t_state = now_ms;
	p->user_enable = true;
	p->t_audio = now_ms;
}

const char *hifi_power_state_name(hifi_pwr_state_t s) {
	switch (s) {
	case HIFI_PWR_WAIT_PD: return "wait_pd";
	case HIFI_PWR_SOFT_START: return "soft_start";
	case HIFI_PWR_ON: return "on";
	case HIFI_PWR_UNDERVOLT: return "undervolt";
	case HIFI_PWR_OVERVOLT: return "overvolt";
	case HIFI_PWR_NO_PVDD: return "no_pvdd";
	}
	return "?";
}

static void enter(hifi_power_t *p, hifi_pwr_state_t s, uint32_t now) {
	p->state = s;
	p->t_state = now;
}

void hifi_power_amp_enable(hifi_power_t *p, bool enable) { p->user_enable = enable; }

void hifi_power_amp_reset(hifi_power_t *p) {
	p->latched = false;
	p->backoff = false;
	p->faults = 0;
	p->fault_n = 0;
	p->pvdd_fails = 0;
}

static void pvdd_fail(hifi_power_t *p, uint32_t now) {
	if (!p->pvdd_fails || ELAPSED(now, p->t_pvdd_fail) > p->cfg.fault_window_ms) {
		p->pvdd_fails = 0;
		p->t_pvdd_fail = now;
	}
	p->pvdd_fails++;
	enter(p, HIFI_PWR_NO_PVDD, now);
}

static void record_fault(hifi_power_t *p, uint32_t now) {
	p->faults++;
	p->fault_t[p->fault_n % 8] = now;
	p->fault_n++;
	int recent = 0;
	for (int i = 0; i < 8 && i < p->fault_n; i++) {
		if (ELAPSED(now, p->fault_t[i]) <= p->cfg.fault_window_ms) recent++;
	}
	if (recent >= p->cfg.fault_latch) p->latched = true;
	p->backoff = true;
	p->t_backoff = now;
}

const hifi_power_out_t *hifi_power_step(hifi_power_t *p, const hifi_power_in_t *in) {
	const hifi_power_cfg_t *c = &p->cfg;
	uint32_t now = in->now_ms;
	bool in_range = in->vbus_v >= c->v_start && in->vbus_v <= c->v_max;
	bool good = in->pg && in_range;

	if (good && !p->good_prev) p->t_good = now;
	p->good_prev = good;
	bool settled = good && ELAPSED(now, p->t_good) >= c->settle_ms;

	if (in->audio) p->t_audio = now;
	/* NaN (no sense) compares false: PVDD is taken as up */
	bool pvdd_low = c->pvdd_min_frac > 0 && in->pvdd_v < c->pvdd_min_frac * in->vbus_v;
	if (!pvdd_low) p->t_pvdd_ok = now;

	switch (p->state) {
	case HIFI_PWR_WAIT_PD:
		if (settled) enter(p, HIFI_PWR_SOFT_START, now);
		break;
	case HIFI_PWR_SOFT_START:
	case HIFI_PWR_ON:
		if (!in->pg) enter(p, HIFI_PWR_WAIT_PD, now);
		else if (in->vbus_v < c->v_min) enter(p, HIFI_PWR_UNDERVOLT, now);
		else if (in->vbus_v > c->v_max) enter(p, HIFI_PWR_OVERVOLT, now);
		else if (p->state == HIFI_PWR_SOFT_START) {
			if (ELAPSED(now, p->t_state) >= c->soft_start_ms && !pvdd_low) enter(p, HIFI_PWR_ON, now);
			else if (ELAPSED(now, p->t_state) >= c->pvdd_timeout_ms) pvdd_fail(p, now);
		} else if (ELAPSED(now, p->t_pvdd_ok) >= c->pvdd_drop_ms)
			pvdd_fail(p, now);
		break;
	case HIFI_PWR_UNDERVOLT:
	case HIFI_PWR_OVERVOLT:
	case HIFI_PWR_NO_PVDD:
		if (!in->pg && in->vbus_v < c->v_min) enter(p, HIFI_PWR_WAIT_PD, now);
		else if (p->state == HIFI_PWR_NO_PVDD && p->pvdd_fails >= c->fault_latch)
			break; /* latched: hifi_power_amp_reset() or a re-plug */
		else if (good && ELAPSED(now, p->t_good) >= c->recover_ms && ELAPSED(now, p->t_state) >= c->recover_ms)
			enter(p, HIFI_PWR_SOFT_START, now);
		break;
	}

	/* faults count only while the amp is out of shutdown and past blanking */
	if (p->amp_was_on && in->fault && ELAPSED(now, p->t_amp_on) >= c->fault_blank_ms) record_fault(p, now);
	if (p->backoff && !p->latched && ELAPSED(now, p->t_backoff) >= c->fault_retry_ms) p->backoff = false;

	bool idle = c->idle_off_ms && ELAPSED(now, p->t_audio) >= c->idle_off_ms;
	bool powered = p->state == HIFI_PWR_SOFT_START || p->state == HIFI_PWR_ON;
	bool amp = p->state == HIFI_PWR_ON && p->user_enable && !p->latched && !p->backoff && !idle;

	if (amp && !p->amp_was_on) p->t_amp_on = now;
	p->amp_was_on = amp;
	p->out.pvdd_en = powered;
	p->out.amp_on = amp;
	return &p->out;
}
