Hive-RSI-Lab/hifi-receiver/firmware/components/hifi/esp/hifi_bsp.h

/*
 * What each board gives the shared board code (hifi_main.c): its pins and
 * parts behind the power sequencer, the input routing, the self-test and
 * the API's info. One of board_lite.c (lite-main: ES8388 codec, GPIO
 * power path) or board_core.c (Plus and Ultra: Sabre DAC, I/O expander,
 * current sense, knob, sub DAC) is built, picked by the Kconfig board.
 */
#pragma once

#include <stdbool.h>
#include <stdint.h>

#include "hifi_api.h"
#include "hifi_gov.h"
#include "hifi_power.h"
#include "hifi_vol.h"

typedef struct {
	float vbus_v;   /* volts */
	float pvdd_v;   /* PVDD after the switch; NaN: the board has no PVDD sense */
	bool pg;        /* the PD contract is good */
	bool fault;     /* an amp says fault */
	bool otw;       /* an amp warns it is hot (core's OTW_CLIP); false where none */
	float vbus_i_a; /* NaN: the board has no current sense */
	/* the PD sink's registers, when this call read them (every 500 ms) */
	bool pd_read, sink_ok;
	uint8_t pd_status, pd_current;
} hifi_bsp_power_t;

/* At boot, before the tasks: pins, ADC, parts; the board's numbers. */
void hifi_bsp_init(hifi_power_cfg_t *pc, hifi_gov_cfg_t *gc);
/* After the shared tasks: the board's own (core: controls, the sub DAC). */
void hifi_bsp_start(void);

/* Every 10 ms from the power task. */
void hifi_bsp_power_in(uint32_t now_ms, hifi_bsp_power_t *p);
/* Drives PVDD and the amps in a safe order: amps into shutdown before PVDD
 * opens, out of it after PVDD is up. */
void hifi_bsp_power_out(const hifi_power_out_t *o);

/*
 * Puts the input (stream or DJ direct), the sub and, where the analog path
 * skips squeezelite, the volume onto the board's parts. Returns false
 * while they can't take it yet (the codec still starting): called again.
 */
bool hifi_bsp_route(hifi_input_t in, bool sub_on, float sub_db, const hifi_vol_t *vol, uint32_t now_ms);
/* The sub level the board sets for a request of db. */
float hifi_bsp_sub_db(float db);

void hifi_bsp_info(hifi_info_t *i);         /* caps and psram */
void hifi_bsp_snapshot(hifi_snapshot_t *s); /* sensors, zones, Ethernet */
void hifi_bsp_selftest(hifi_selftest_t *t); /* the board's own parts answer */
bool hifi_bsp_parts_ok(void);               /* the same, for the trial boot */

/* Zone B's amp (boards with HIFI_ZONES 2) */
void hifi_bsp_set_zone(bool on);

/* The API's LED test and backlight modes (hifi_ops_t: set_led, set_backlight),
 * on boards that define HIFI_HAS_LED_TEST and HIFI_HAS_BACKLIGHT */
int hifi_bsp_set_led(const char *mode);
int hifi_bsp_set_backlight(const char *mode);

/* An output block (hifi_dsp_process), after the governor: the core board
 * sends its sub DAC the sum of it. */
void hifi_bsp_audio(const uint8_t *buf, uint32_t frames, int bytes_per_frame);

/*
 * The line in through an ADC (core: the ES7243E on I2S0's input; boards
 * whose caps say line). hifi_main.c plays it through squeezelite's output,
 * which runs I2S0, so the ADC has its clock.
 */
/* Sets the ADC up; once I2S0 runs. False: there is none, or it didn't answer */
bool hifi_bsp_line_start(void);
/* Up to `frames` (128 at most) of the ADC's samples as 16-bit stereo,
 * inverted when asked (C5); 0 when none came within wait_ms */
int hifi_bsp_line_read(int16_t *buf, int frames, bool invert, uint32_t wait_ms);
/* DJ direct: the subs take the ADC's samples (hifi_bsp_sub_write) with a
 * few ms of delay, not squeezelite's output with its DMA's */
void hifi_bsp_sub_direct(bool on);
void hifi_bsp_sub_write(const int16_t *buf, int frames);
