Hive-RSI-Lab/hifi-receiver/bench/hifibench/ed25519.py

"""Ed25519 (RFC 8032) in plain Python: the Hive signs the commands it sends a
board over the relay (docs/remote.md, "Security"); the board checks them with
libsodium against the public key compiled into its firmware.

Slow (a few ms a signature) and not constant-time, which is fine for a bench
that signs a handful of commands from a machine it trusts. Only the RFC's
pure Ed25519, no context or prehash variants.
"""
from __future__ import annotations

import hashlib
import os

P = 2 ** 255 - 19
L = 2 ** 252 + 27742317777372353535851937790883648493
D = -121665 * pow(121666, P - 2, P) % P
SQRT_M1 = pow(2, (P - 1) // 4, P)


def _sha512(b: bytes) -> bytes:
    return hashlib.sha512(b).digest()


def _inv(x: int) -> int:
    return pow(x, P - 2, P)


# Points in extended coordinates (X, Y, Z, T), x = X/Z, y = Y/Z, xy = T/Z.
def _add(p, q):
    a = (p[1] - p[0]) * (q[1] - q[0]) % P
    b = (p[1] + p[0]) * (q[1] + q[0]) % P
    c = 2 * p[3] * q[3] * D % P
    d = 2 * p[2] * q[2] % P
    e, f, g, h = b - a, d - c, d + c, b + a
    return (e * f % P, g * h % P, f * g % P, e * h % P)


def _mul(s: int, p):
    q = (0, 1, 1, 0)
    while s > 0:
        if s & 1:
            q = _add(q, p)
        p = _add(p, p)
        s >>= 1
    return q


def _equal(p, q) -> bool:
    return (p[0] * q[2] - q[0] * p[2]) % P == 0 and (p[1] * q[2] - q[1] * p[2]) % P == 0


def _recover_x(y: int, sign: int) -> int | None:
    if y >= P:
        return None
    x2 = (y * y - 1) * _inv(D * y * y + 1)
    if x2 == 0:
        return None if sign else 0
    x = pow(x2, (P + 3) // 8, P)
    if (x * x - x2) % P:
        x = x * SQRT_M1 % P
    if (x * x - x2) % P:
        return None
    if (x & 1) != sign:
        x = P - x
    return x


_GY = 4 * _inv(5) % P
_GX = _recover_x(_GY, 0)
G = (_GX, _GY, 1, _GX * _GY % P)


def _compress(p) -> bytes:
    zi = _inv(p[2])
    x, y = p[0] * zi % P, p[1] * zi % P
    return int.to_bytes(y | ((x & 1) << 255), 32, "little")


def _decompress(s: bytes):
    if len(s) != 32:
        return None
    y = int.from_bytes(s, "little")
    sign = y >> 255
    y &= (1 << 255) - 1
    x = _recover_x(y, sign)
    if x is None:
        return None
    return (x, y, 1, x * y % P)


def _expand(seed: bytes) -> tuple[int, bytes]:
    if len(seed) != 32:
        raise ValueError("an Ed25519 secret key is 32 bytes")
    h = _sha512(seed)
    a = int.from_bytes(h[:32], "little")
    a &= (1 << 254) - 8
    a |= 1 << 254
    return a, h[32:]


def public_key(seed: bytes) -> bytes:
    a, _ = _expand(seed)
    return _compress(_mul(a, G))


def keygen() -> tuple[bytes, bytes]:
    """A new (seed, public key) pair."""
    seed = os.urandom(32)
    return seed, public_key(seed)


def sign(seed: bytes, msg: bytes) -> bytes:
    a, prefix = _expand(seed)
    A = _compress(_mul(a, G))
    r = int.from_bytes(_sha512(prefix + msg), "little") % L
    R = _compress(_mul(r, G))
    h = int.from_bytes(_sha512(R + A + msg), "little") % L
    s = (r + h * a) % L
    return R + int.to_bytes(s, 32, "little")


def verify(pub: bytes, msg: bytes, sig: bytes) -> bool:
    if len(pub) != 32 or len(sig) != 64:
        return False
    A = _decompress(pub)
    R = _decompress(sig[:32])
    if A is None or R is None:
        return False
    s = int.from_bytes(sig[32:], "little")
    if s >= L:
        return False
    h = int.from_bytes(_sha512(sig[:32] + pub + msg), "little") % L
    return _equal(_mul(s, G), _add(R, _mul(h, A)))
