Hive-RSI-Lab/hifi-receiver/firmware/components/hifi/esp/hifi_http.h

#pragma once

#include "esp_http_server.h"
#include "hifi_api.h"

/* Registers the /api/v1/ handlers and the web app's files on squeezelite's server. */
void hifi_http_start(httpd_handle_t server, const hifi_ops_t *ops);
