Hive-RSI-Lab/hifi-receiver/tools/tests/test_hwcheck.py

"""The score's own logic: needed functions, the spec. No gates run (test_pieces.py has the pieces)."""
import contextlib
import io
import os
import shutil
import sys
import tempfile
import unittest
import unittest.mock
from pathlib import Path

sys.path.insert(0, str(Path(__file__).resolve().parent.parent))
import hwcheck  # noqa: E402

SPEC = hwcheck.SPEC
POSTS = "board-mounted 4 mm binding posts"


def found(board, **kw):
    return hwcheck.board_cost(hwcheck.BOARDS / board, **kw)["found"]


class Needs(unittest.TestCase):
    def check_tier(self, tier, lines):
        """What the committed boards lack, less the speaker posts: until task
        261030-140102 puts binding posts on the boards, they may lack those."""
        return [m for m in (hwcheck.lacks(n, lines) for n in SPEC["tiers"][tier]["needs"])
                if m and not m.startswith(POSTS)]

    def test_committed_boards_carry_their_tier_functions(self):
        for tier in ("lite", "plus"):
            lines = [x for b in SPEC["tiers"][tier]["builds"]
                     if (hwcheck.BOARDS / b["board"] / "state.json").is_file()
                     for x in found(b["board"], **{k: v for k, v in b.items() if k != "board"})]
            if lines:
                self.assertEqual(self.check_tier(tier, lines), [], tier)

    def test_speaker_outputs_are_binding_posts(self):
        """Screw terminals don't count as the banana outputs the brief asks
        for, whatever the BOM line's comment says; an LCSC binding post or
        banana jack does."""
        def line(mpn, description, comment="SPK L banana"):
            return {"refs": ["J6"], "pads": 4, "text": {"comment": comment, "mpn": mpn, "value": comment,
                                                        "description": description, "role": comment}}
        screw = [line("KF301-5.0-2P", "1x2P 5mm Screw Terminal Blocks ROHS"),
                 line("DB128V-5.08-4P-GN-S", "16A 1x4P 5.08mm Screw Terminal Blocks ROHS")]
        posts = [line("BP-4MM-RED", "4mm Through Hole Banana and Tip Connectors - Binding Posts ROHS")]
        for tier in ("lite", "plus"):
            need = next(n for n in SPEC["tiers"][tier]["needs"] if n["what"].startswith(POSTS))
            for x in screw:
                self.assertIsNotNone(hwcheck.lacks(need, [x]), (tier, x["text"]["mpn"]))
            self.assertIsNone(hwcheck.lacks(need, posts), tier)

    def test_dropping_a_function_is_caught(self):
        if not (hwcheck.BOARDS / "lite-main" / "state.json").is_file():
            self.skipTest("no lite-main")
        lines = found("lite-main")
        no_amp = [x for x in lines if "TPA3118" not in x["text"]["mpn"]]
        self.assertEqual(len(no_amp), len(lines) - 1)
        self.assertEqual(self.check_tier("lite", no_amp), ["stereo class-D amplifier (0 of 1 parts)"])
        fewer = [dict(x, refs=x["refs"][:2]) if "TS-1187" in x["text"]["mpn"] else x for x in lines]
        self.assertEqual(self.check_tier("lite", fewer), ["3 front buttons (2 of 3 parts)"])

    def test_pads_count_contacts(self):
        need = {"what": "terminals", "match": "KF301", "pads": 4}
        line = {"refs": ["J6"], "pads": 2, "text": {"comment": "", "mpn": "KF301-5.0-2P", "value": "",
                                                    "description": "", "role": ""}}
        self.assertIsNotNone(hwcheck.lacks(need, [line]))
        self.assertIsNone(hwcheck.lacks(need, [line, dict(line, refs=["J7"])]))

    def test_role_only_where_asked(self):
        line = {"refs": ["J2"], "pads": 14, "text": {"comment": "FPC", "mpn": "FPC-05FB-12PH20", "value": "",
                                                     "description": "FPC", "role": "for the LCD tail"}}
        self.assertIsNone(hwcheck.lacks({"what": "screen", "match": "LCD", "in": ["role"]}, [line]))
        self.assertIsNotNone(hwcheck.lacks({"what": "screen", "match": "LCD"}, [line]))


class Test(unittest.TestCase):
    """cmd_test counts each failing gate, not each gated board; what is
    unverified is neither a pass nor a fail."""

    fw = ([], [])  # firmware_fw's (failures, couldn't-run reasons)

    def run_test(self, gates):
        saved = {k: getattr(hwcheck, k) for k in ("check_product", "run_unittests", "firmware_tests",
                                                    "boards", "run_gates", "cant_run",
                                                    "firmware_pins", "firmware_fw")}
        dirs = list(gates)
        hwcheck.check_product = lambda: ([], {})
        hwcheck.run_unittests = lambda: []
        hwcheck.firmware_tests = lambda: True
        hwcheck.firmware_pins = lambda: []
        hwcheck.firmware_fw = lambda all_boards=False: self.fw
        hwcheck.boards = lambda: dirs
        hwcheck.run_gates = lambda todo: {d: gates[d] for d in todo}
        self.cant = None

        def cant_run(tool, why):  # the real one execs the shell's not-found
            self.cant = (tool, why)
            raise SystemExit(127)
        hwcheck.cant_run = cant_run
        try:
            with contextlib.redirect_stdout(io.StringIO()):
                try:
                    return hwcheck.cmd_test(all_boards=True)
                except SystemExit as e:
                    return e.code
        finally:
            for k, v in saved.items():
                setattr(hwcheck, k, v)

    def test_boards_that_pass_pass(self):
        self.assertEqual(self.run_test({Path("a"): [], Path("b"): []}), 0)
        self.assertIsNone(self.cant)

    def test_a_failing_gate_fails(self):
        self.assertEqual(self.run_test({Path("a"): [], Path("b"): [("b dfm", 1)]}), 1)

    def test_an_unverified_gate_cant_run(self):
        u = ("b dfm: placement unverified: U1, U2 (HTTP 403)", hwcheck.UNVERIFIED)
        self.assertEqual(self.run_test({Path("a"): [], Path("b"): [u]}), 127)
        self.assertEqual(self.cant[0], "easyeda-models")
        self.assertIn("U1, U2", self.cant[1][0])

    def test_a_real_failure_beside_an_unverified_one_fails(self):
        u = ("b dfm: placement unverified: U1", hwcheck.UNVERIFIED)
        self.assertEqual(self.run_test({Path("a"): [("a drc_routed", 1)], Path("b"): [u]}), 1)
        self.assertIsNone(self.cant)


    def test_no_esp_idf_cant_run_rather_than_pass(self):
        self.fw = ([], ["ESP-IDF missing"])
        self.assertEqual(self.run_test({Path("a"): []}), 127)
        self.assertEqual(self.cant, ("esp-idf", ["ESP-IDF missing"]))

    def test_a_failed_boot_fails(self):
        self.fw = (["fw check-all hifi-lite"], [])
        self.assertEqual(self.run_test({Path("a"): []}), 1)

    def test_a_failed_constraint_beside_no_esp_idf_fails(self):
        self.fw = (["fw constraints hifi-lite"], ["ESP-IDF missing"])
        self.assertEqual(self.run_test({Path("a"): []}), 1)
        self.assertIsNone(self.cant)


class ChangedBoards(unittest.TestCase):
    """On main itself every board is gated, whatever stray files lie around."""

    def run_it(self, head, untracked):
        def git(*a):
            return {"rev-parse": head if a[1] == "HEAD" else "ref", "merge-base": "base\n",
                    "diff": "", "ls-files": untracked}[a[0]]
        env = {k: v for k, v in os.environ.items() if k not in ("HWCHECK_ALL", "HWCHECK_BASE")}
        with unittest.mock.patch.object(hwcheck, "git", git), unittest.mock.patch.dict(os.environ, env, clear=True):
            return hwcheck.changed_boards([hwcheck.BOARDS / "core"])[0]

    def test_main_with_stray_files_gates_every_board(self):
        self.assertEqual(self.run_it("base\n", ".ci/x\0"), [hwcheck.BOARDS / "core"])

    def test_branch_with_stray_files_gates_none(self):
        self.assertEqual(self.run_it("other\n", ".ci/x\0"), [])


class FirmwareFw(unittest.TestCase):
    """firmware_fw runs fw per tier when firmware changed, and says couldn't
    run, never pass, without fw, ESP-IDF or QEMU. Uses a fake fw: nothing here
    builds or boots anything."""

    GOOD = "idf       /x/esp-idf-v4.4.8\nqemu      /x/qemu-system-xtensa\n"

    def run_fw(self, doctor=GOOD, fail="", has_fw=True, changed=True, all_boards=False, env=None):
        with tempfile.TemporaryDirectory() as tmp:
            log = Path(tmp) / "calls"
            fake = Path(tmp) / "fw"
            fake.write_text(f"""#!/bin/sh
echo "$1 $2 $3 $4" >> {log}
case "$1 $2 $3 $4" in *"{fail or 'NOTHING'}"*) exit 1;; esac
[ "$1" = doctor ] && printf '%s' '{doctor}'
exit 0
""")
            fake.chmod(0o755)
            saved = (hwcheck.find_fw, hwcheck.firmware_changed)
            hwcheck.find_fw = lambda: str(fake) if has_fw else None
            seen = []

            def fw_changed(a=False):
                seen.append(a)
                return changed or a
            hwcheck.firmware_changed = fw_changed
            with unittest.mock.patch.dict(os.environ, env or {}):
                if not env:
                    os.environ.pop("HWCHECK_FW", None)
                try:
                    with contextlib.redirect_stdout(io.StringIO()) as out:
                        r = hwcheck.firmware_fw(all_boards)
                finally:
                    hwcheck.find_fw, hwcheck.firmware_changed = saved
            calls = log.read_text().splitlines() if log.exists() else []
        return r, calls, out.getvalue()

    def test_all_three_tiers_are_constrained_built_and_booted(self):
        r, calls, _ = self.run_fw()
        self.assertEqual(r, ([], []))
        for t in ("hifi-lite", "hifi-plus", "hifi-ultra"):
            self.assertIn(f"constraints firmware --target {t}", calls)
            self.assertTrue(any(c.startswith(f"check-all {t} --from") for c in calls), calls)

    def test_no_fw_cant_run(self):
        (bad, unv), calls, _ = self.run_fw(has_fw=False)
        self.assertEqual(bad, [])
        self.assertIn("not checked, built or booted", unv[0])

    def test_missing_idf_or_qemu_cant_run_and_builds_nothing(self):
        for doctor in ("idf       MISSING (fw setup)\nqemu      /x/q\n",
                       "idf       /x/esp-idf-v4.4.8\nqemu      MISSING (fw setup)\n",
                       ""):  # a crashed doctor says nothing: not a pass either
            (bad, unv), calls, _ = self.run_fw(doctor=doctor)
            self.assertEqual(bad, [])
            self.assertIn("not built or booted", unv[0])
            self.assertFalse([c for c in calls if c.startswith("check-all")], calls)

    def test_a_failed_target_is_named(self):
        (bad, unv), _, _ = self.run_fw(fail="check-all hifi-plus")
        self.assertEqual((bad, unv), (["fw check-all hifi-plus"], []))
        (bad, unv), _, _ = self.run_fw(fail="constraints firmware --target hifi-ultra")
        self.assertEqual((bad, unv), (["fw constraints hifi-ultra"], []))

    def test_unchanged_runs_nothing_but_all_does(self):
        r, calls, _ = self.run_fw(changed=False)
        self.assertEqual((r, calls), (([], []), []))
        _, calls, _ = self.run_fw(changed=False, all_boards=True)
        self.assertTrue(calls)

    def test_skip_runs_nothing_and_says_so(self):
        r, calls, out = self.run_fw(env={"HWCHECK_FW": "skip"})
        self.assertEqual((r, calls), (([], []), []))
        self.assertIn("NOT run here", out)


class Pins(unittest.TestCase):
    """The test checks the firmware's pins against its board."""

    def test_lite_s_pins_land_on_lite_main(self):
        with contextlib.redirect_stdout(io.StringIO()):
            self.assertEqual(hwcheck.firmware_pins(), [])

    def test_a_moved_pin_fails(self):
        piece = next(p for p in SPEC["pieces"] if p["name"] == "Lite firmware")
        with tempfile.TemporaryDirectory() as tmp:
            root = Path(tmp)
            for d in ("firmware", "boards/lite-main/kicad"):
                shutil.copytree(hwcheck.ROOT / d, root / d)
            h = root / "firmware/components/hifi/esp/hifi_board_lite.h"
            h.write_text(h.read_text().replace("ADC_PVDD ADC1_CHANNEL_3", "ADC_PVDD ADC1_CHANNEL_0"))
            bad = hwcheck.pieces.CHECKS["firmware"](root, piece)
        self.assertTrue(any("ADC_PVDD: GPIO36" in b for b in bad), bad)


class Unverified(unittest.TestCase):
    """unverified() tells a gate that couldn't fetch part models from one
    that failed or crashed."""

    def test_old_hwde_exit_1_with_only_fetch_failures(self):
        r = {"failing": [{"kind": "cpl_fetch_failed", "refs": ["U2", "U1"], "reason": "HTTP 403"}]}
        self.assertEqual(hwcheck.unverified(1, r, ""), "U1, U2 unverified (HTTP 403)")
        r["failing"].append({"kind": "cpl_rotation", "refs": ["U3"]})
        self.assertIsNone(hwcheck.unverified(1, r, ""))

    def test_exit_2_with_the_block(self):
        r = {"status": "error", "unverified": {"family": "placement", "refs": ["U5"], "reason": "rate limited"}}
        self.assertEqual(hwcheck.unverified(2, r, ""), "placement unverified: U5 (rate limited)")
        self.assertEqual(hwcheck.unverified(2, {"report": r}, ""), "placement unverified: U5 (rate limited)")

    def test_exit_2_with_only_the_gate_s_error_text(self):
        log = ('{"script": "gate", "status": "error", "error": "Traceback ...\\nRuntimeError: dfm report '
               'status is error: placement unverified, not failed: could not fetch the LCSC model for 3 '
               'part(s) (HTTP 403)\\n"}')
        self.assertTrue(hwcheck.unverified(2, {}, log).startswith("placement unverified, not failed: could not"))

    def test_a_crash_or_a_fail_is_not_unverified(self):
        self.assertIsNone(hwcheck.unverified(2, {}, "Traceback: KeyError"))
        self.assertIsNone(hwcheck.unverified(1, {"failing": [{"kind": "clearance"}]}, ""))
        self.assertIsNone(hwcheck.unverified(0, {}, ""))


class Facts(unittest.TestCase):
    """Each open fact that could stop a board costs the score open_fact, so 0 is order-ready."""

    def score(self, facts):
        saved = {k: getattr(hwcheck, k) for k in ("run_gates", "tier_cost", "piece_missing", "open_facts")}
        hwcheck.run_gates = lambda have: {d: [] for d in have}
        hwcheck.tier_cost = lambda tier, gates: (tier["budget"], [])
        hwcheck.piece_missing = lambda piece, ran: None
        hwcheck.open_facts = lambda: facts
        out = io.StringIO()
        try:
            with contextlib.redirect_stdout(out):
                self.assertEqual(hwcheck.cmd_score(), 0)
        finally:
            for k, v in saved.items():
                setattr(hwcheck, k, v)
        return float(out.getvalue().split()[-1]), out.getvalue()

    def test_nothing_open_is_zero(self):
        self.assertEqual(self.score([])[0], 0)

    def test_each_open_fact_counts(self):
        got, text = self.score(["thermal:0 [core]", "parts:2 [core]"])
        self.assertEqual(got, 2 * SPEC["open_fact"])
        self.assertIn("thermal:0 [core]", text)

    def test_open_facts_are_known_unknowns_check(self):
        rows = list(hwcheck.known_unknowns.rows())
        want = [r for r in rows if hwcheck.known_unknowns.is_open(r[2], r[3])]
        self.assertEqual(len(hwcheck.open_facts()), len(want))
        self.assertGreater(SPEC["open_fact"], 0)


class Spec(unittest.TestCase):
    def test_spec_is_whole(self):
        self.assertEqual(sorted(SPEC["tiers"]), sorted(hwcheck.TIERS))
        for name, tier in SPEC["tiers"].items():
            self.assertTrue(tier["builds"] and tier["needs"], name)
            # A tier's budget is a BOM cost, far below what a missing tier costs.
            self.assertTrue(0 < tier["budget"] < SPEC["tier_not_counted"], name)
        # A missing tier outweighs any tier's real cost, so landing one is a gain.
        self.assertGreater(SPEC["tier_not_counted"], 200)


if __name__ == "__main__":
    unittest.main()
