Hive-RSI-Lab/hifi-receiver/tools/bom_estimate.py

#!/usr/bin/env python3
"""Total docs/bom-estimate.csv per tier at 10 and 100 units, with a JLC
assembly estimate from hwde's jlc_pricing.yaml figures.

Usage: python3 tools/bom_estimate.py [docs/bom-estimate.csv]
       python3 tools/bom_estimate.py --unit lite 100   # one number, for a score

Parts are priced per board at the 10- and 100-board price break. Assembly is
the hwde table (setup 8, stencil 8, 3 per unique extended part, 0.0017 per SMT
joint) plus JLC's hand-soldered through-hole rate (0.0173 per joint) and
PCB price points for each tier's board(s). hwde measured its own PCB table as
1.9-3.1x low against JLC's real quotes, so the PCB line is reported both raw
and x2.5. Refresh prices with hwde's parts_search.py and re-run.
"""
import csv
import sys
from pathlib import Path

SETUP, STENCIL, FEEDER, SMT_JOINT, THT_JOINT = 8.0, 8.0, 3.0, 0.0017, 0.0173
PCB_CAL = 2.5
# board(s) per tier: (name, layers, w_mm, h_mm)
BOARDS = {
    "lite": [("lite-main", 2, 100, 90)],
    "plus": [("core", 4, 154.4, 113)],      # core's bounding box since the banana-socket row (#117/#124)
    "ultra": [("core", 4, 154.4, 113), ("ultra-front", 2, 110, 40)],
}
PCB_BASE = {2: {10: 2.00, 100: 24.90}, 4: {10: 9.90, 100: 76.90}}


def pcb(layers, w, h, qty):
    # hwde's 100x100 price points scaled by area past 1 dm^2. hwde's own
    # oversize_per_dm2 term (11 $/dm^2 per 4-layer board) runs >10x above its
    # own 100x100 point (0.77 $/board at 100), so it is not used here.
    return PCB_BASE[layers][qty] * max(1.0, w * h / 10000)
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
