Hive-RSI-Lab/hifi-receiver/(commit log)

2026-10-28 Define the tiered hi-fi receiver product (WiiM-Ultra-like, barebones/medium/full) and its architecture
    … script
    [bom-estimate.csv]
2026-10-28 hifi-receiver-2 has a check and a score: hwde gates pass on every board, and the first tier's BOM cost against its targ…
    …nd Lite's unit cost at 100 from its board's BOM
    tools/hwcheck.py test: docs/product.md has every tier's target price and BOM
    total (matching bom_estimate.py) and one first tier; every boards/* workspace
    passes hwde's erc, drc_routed, verify and dfm gates in a scratch copy.
    tools/hwcheck.py score: the first tier's board(s) re-pass the gates, then
    unit cost at 100 from fab/BOM.csv priced from parts/parts.json, pads from the
    .kicad_pcb and bom_estimate.py's assembly/PCB model; no number when a gate
    fails; 1000 until the board exists. docs/checks.md says how.
    [hwcheck.py]
2026-10-28 Lite board (lite-main): schematic, placement and routing work in progress with hive-hwde
    [bom-estimate.csv, lite-main.kicad_pcb, lite-main.kicad_sch]
2026-10-28 User manual and quick-start for the receiver, kept in step with the boards, firmware and app
    * User manual, quick-start and fact sources for the receiver (all tiers…
    …), drafted from product.md and ultra-front; TBDs for firmware/app/board details
    * Manual: match the web app's draft (tabs, Wi-Fi flow, EQ, subwoofer an…
    …d update controls, notices)
    * Manual: the web app as built (hifi-<model>.local, factory reset and r…
    …estart in About, Android home-screen shortcut, update-failed notice)
2026-10-28 lite-main: routed, drc_routed 0/0; front-facing IR receiver, PVDD sense on GPIO39
    [lite-main.kicad_pcb, lite-main.kicad_sch]
2026-10-28 lite-main: PVDD drain column on B.Cu, R16 out of the pour; re-routed, drc_routed 0/0
    [lite-main.kicad_pcb]
2026-10-28 lite-main: verify (one signed thermal waiver) and dfm pass; JLC fab package
    [BOM-full.csv, BOM.csv, C13585.json, C14663.json, C14858.json, C15849.json, C1588.json, C1653.json]
2026-10-28 lite-main: board review fixes (TVS at the VBUS pour, U3 input loop on top, EP paste windows, J4 polarity silk); re-routed; all gates pass
    [CPL.csv, lite-main-B_Cu.gbl, lite-main-B_Mask.gbs, lite-main-B_Paste.gbp, lite-main-B_Silkscreen.gbo, lite-main-Edge_Cuts.gm1, lite-main-F_Cu.gtl, lite-main-F_Mask.gts]
2026-10-28 Move the Lite workspace to boards/lite-main (the board name hwcheck scores); merge main; cost and docs to the as-built board
    [BOM-full.csv, BOM.csv, C13585.json, C14663.json, C14858.json, C15849.json, C1588.json, C1653.json]
2026-10-28 Plus/Ultra core board through hive-hwde: schematic, placement, routed 4-layer layout, all hwde gates pass, JLC fab package for Plus and Ultra
    [BOM-full.csv, BOM.csv, amp_a.kicad_sch, amp_b.kicad_sch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]
2026-10-28 goals.md carries the person's asks of 10-28: build the whole product, board and firmware in tandem
    …oard and firmware in tandem; keep boards current with hwde fixes)
2026-10-28 3D-printable enclosures for the receiver, Lite first, fitted to the boards as they're designed
    … fit check and renders
    [lite-base.step, lite-base.stl, lite-lid.step, lite-lid.stl]
2026-10-29 Bench scripts for receiver bring-up and test
    … power sweep, 1/8-power soak, staged bring-up, all tested against a mock board
2026-10-29 core: commit its EasyEDA model cache (parts/easyeda), as lite-main does, so its dfm gate runs without fetching
    [C107671.json, C11133.json, C113998.json, C11702.json, C12074.json, C13585.json, C14663.json, C14709.json]
2026-10-29 Every receiver board's BOM is checked against live JLC/LCSC stock, with in-stock alternates where short
    * Every board's BOM checked against live JLC/LCSC stock, with checked a…
    …lternates where short
    tools/bom_stock.py looks up every BOM line at JLC (free = stock less claimed)
    and LCSC and flags thin/short lines with the alternates in
    docs/bom-alternates.csv. docs/bom-stock.md has the 10-29 run: only J1
    USB4105 (C5184243) is short, on every board; Lite takes HRO TYPE-C-31-M-12
    C165948 as a drop-in at 20 V, core (28 V EPR) has no in-stock drop-in and
    stays hand-fit, with GCT USB4085-GF-A C7095263 as the rated in-stock part
    behind a footprint change.
    * BOM stock: JLC's not-buyable flag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
    [bom-alternates.csv]
2026-10-29 The project's per-PR check is fast: it re-runs a board's hwde gates only when that board's files change
    * Per-PR check gates only the boards whose files changed since main; --…
    …all or HWCHECK_ALL=1 gates every board
    * Merge main (PR #52: hwde lookup in /hive/tools, core EasyEDA cache)
2026-10-29 Plus/Ultra printed enclosures around core (+ ultra-front), and the Lite box re-fitted to the committed lite-main
    * Lite enclosure re-fitted to the committed, routed lite-main: fit 28/28
    * Plus and Ultra printed enclosures around core (+ ultra-front), built …
    …and fit-checked with hive-mech: 24/24 and 31/31
    * Merge remote-tracking branch 'origin/main' into hive/w-261028-192023-…
    …d7cc351011
    [base.stl, btn_FSW1.stl, btn_FSW2.stl, btn_FSW3.stl, btn_SW2.stl, btn_SW3.stl, enclosure.step, knob.stl]
2026-10-29 The manual matches the app, firmware and boards as built
    * The manual matches the Lite firmware, web app, board and enclosure as…
    … built
    * Merge branch 'main' of /hive/projects/hifi-receiver-2 into hive/w-261…
    …028-191739-cff2fece43
2026-10-29 Land the firmware PRs: #27, then #44, merged with main
    * Test API spec for the receiver firmware (docs/test-api.md)
    * Web app for the receiver: PWA, mock of its API, firmware pack and tests
    * Web app on the firmware's /api/v1: IR learn, volume limit, per-sub se…
    …ttings, input not source; docs/app.md with screenshots
    * Firmware core: PD contract, power sequencer, governor, test tones, te…
    …st API and console, with host tests
    * Test API: caps, name, eq, sub on/off, reboot and factory reset for th…
    …e web app
    * Firmware ESP side: board code, HTTP/console/mDNS, squeezelite hooks p…
    …atch, lite-main board defaults, fetch script
    * test-api.md: hifi-lite hostname, caps, e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
    [partitions.csv]
2026-10-29 The whole-product score, rebased on #45, with every piece checked against stubs
    * The score counts the whole product: every tier's boards with their re…
    …quired functions, and the firmware, app, bench, enclosure and manual pieces
    tools/product.json says what counts: each tier's boards (Plus and Ultra are
    core's two populations, Ultra adds ultra-front) and the functions product.md
    promises for it, matched on the BOM; and the pieces, each with its files and
    tests. A tier counts at its unit cost at 100 only when its boards pass their
    gates, are priced and carry every function, else 1000; a missing piece is
    100. A gate that only couldn't fetch EasyEDA models is 'couldn't run', not a
    fail.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
    [hwcheck.py, pieces.py, price_parts.py, test_hwcheck.py, test_pieces.py]
2026-10-29 goals.md carries the person's flow of 10-28 22:05: spec, design, order, plug in, leave it
    …n, order, plug in, leave it
2026-10-29 All receiver enclosures build through hive-mech; the private copies go
    …; its private reader, fit check and renderer go
    lite.py is now a mech build script (lite-main read by mech board) sharing
    core_box.py's pieces with Plus/Ultra: screws from below into lid pillars,
    RCA holes with a port per barrel, binding posts, the light pipe. The
    flexure-tongue buttons become mech's printed plungers. Fit: 23/23
    (mech's 22 + fit_md's added boxes). Plus/Ultra rebuild byte-identical.
    kicad_board.py, fit.py and render.py are deleted.
    [base.stl, btn_SW1.stl, btn_SW2.stl, btn_SW3.stl, enclosure.step, lid.stl, lite-base.step, lite-base.stl]
2026-10-29 Land the hands-off bring-up PR #41, merged with main
    * test-api.md: hifi-lite hostname, caps, eq/sub/name/reboot/reset, sque…
    …ezelite's own endpoints
    * Firmware docs: firmware/README.md (build, test, flash, patch) and doc…
    …s/firmware.md (design, power, governor, unchecked)
    * product.md and pl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
    [partitions.csv]
2026-10-29 An independent second read of #48's Lite and core fixes, plus hwde aa1ec48's new checks
    * Lite's amp waits for PVDD and needs a 15 V contract: #48's slower PVD…
    …D switch (R6 220k, C19 4.7 uF) ramps PVDD 80-210 ms after PVDD_EN and gives Q1 2.2 V of gate at 9 V
    The sequencer released SDZ 100 ms after PVDD_EN and allowed 9 V; with #48's
    gate RC that is before PVDD is up, and a max-Vth AO4485 doesn't turn on at
    9 V. soft_start_ms 400, v_min 14 V; tests, firmware.md and the manual follow.
    Safe on today's main board too (R6 47k ramps in ~5 ms, 10 V of gate at 15 V).
    * Second read of #48's Lite and core fixes and hwde aa1ec48's checks: d…
    …ocs/review-2/second-read.md, with its PVDD si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
    [hifi_power.c, run.py, test_power.c]
2026-10-29 hifi-receiver-2 main is green again: test_pieces reads the Lite enclosure's files under the names hive-mech writes
    Merged by the Hive.
2026-10-30 Plus and Ultra firmware: board configs for core, and the routes the app calls
    * Plus and Ultra firmware on the core board, and the five routes the ap…
    …p calls
    firmware/board/core and firmware/board/ultra select the new Kconfig boards
    HIFI_PLUS and HIFI_ULTRA, whose I2S, I2C, Ethernet and IR land on the core
    board's nets (tools/pieces.py passes both). The component's board code
    moves behind esp/hifi_bsp.h: board_lite.c is Lite's as it was, and
    board_core.c drives the core board's I/O expander (PVDD, both amps,
    DAC reset, Ethernet clock, DJ direct, LED, knob and buttons), the CH224Q
    voltage request, the INA186 and the sub DAC on I2S1. The API answers
    wifi/scan, wifi/forget, zone, update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
    [partitions.csv]
2026-10-30 On main, the project's test gates every board (#62 rebased on #64)
    * On main, the project's test gates every board: an empty diff from mai…
    …n re-gates them all
    * On main, the project's test gates every board: #62 merged with main (…
    …#64's score kept)
    * Merge main into this branch
2026-10-30 The project's check never calls a live outside service: board gates run offline from each board's committed EasyEDA cac…
    * The check's board gates run offline: dfm reads each board's committed…
    … EasyEDA cache and skips live stock lookups
    * Merge main (e8442f7) into the offline-gates branch: keep both OFFLINE…
    … and main's UNRUN
    [hwcheck.py]
2026-10-30 The enclosures print without support: teardrop the RCA holes, no 22 mm bridge over the Lite's label recess, no 0.4 mm r…
    …el recess roof, a 7.8 mm foot round each counterbore, and every button is one solid
    [base.stl, btn_FSW1.stl, btn_FSW2.stl, btn_FSW3.stl, btn_SW1.stl, btn_SW2.stl, btn_SW3.stl, enclosure.step]
2026-10-30 The score counts cost only above each tier's BOM budget, so contingencies under budget are free and 0 means every tier …
    * Score counts each tier's cost only above its BOM budget (retail / 4),…
    … so 0 means the product is complete
    * Keep the tracked pyc as on main
2026-10-30 hifi-receiver-2's tests run on its forge CI (GitHub Actions), not on this machine
    … not on this machine
    A standard ubuntu-latest runner of the public repo runs python3 tools/hwcheck.py test
    with the Hive's own tools: KiCad 10.0.6 (pkgforge-dev anylinux AppImage, extracted to an
    AppDir) and hive-hwde at aa1ec48 (the published hwde.version). forge_tests names the check.
2026-10-30 core's +5V is budgeted, and built, for what it now feeds (the 3V3 buck at the ESP32's radio peaks, TPA3221 VDD, 3V3A, +…
    * core's +5V is budgeted at 1.1 A for what it feeds, and its L9-to-U5 t…
    …runk is built 0.58-0.60 mm for it
    * Merge branch 'main' of /hive/run/main.bundle into hive/w-261030-06434…
    …1-9ee1404be2
    * CI fetches KiCad again when its cache holds no runnable AppDir (the f…
    …irst key cached an empty folder), and checks kicad-cli runs
    [core-B_Cu.gbl, core-B_Mask.gbs, core-B_Paste.gbp, core-B_Silkscreen.gbo, core-Edge_Cuts.gm1, core-F_Cu.gtl, core-F_Mask.gts, core-F_Paste.gtp]
2026-10-30 The hifi boards' +3V3 is budgeted, and built, for the ESP32 module's 500 mA radio peaks
    * The hifi boards' +3V3 is budgeted and built for the ESP32 module's 50…
    …0 mA radio peaks
    core: +3V3 budget 0.3 -> 0.8 A (the module's 500 mA plus everything else on
    the rail); the In2 plane gives 2.4 mV at the module (check_irdrop), SY8089
    2 A and its inductor carry it.
    lite-main: +3V3 budget 0.35 -> 0.55 A at dT 20 C (as the board's other
    rails), vias rated 1 A like VBUS's; the 95 mm track path from L6 to the
    module widened from 0.2 mm (0.3 mm where clearance allows, 0.204-0.25 mm
    elsewhere), second vias at three of four layer changes, via hwde route_edit;
    IR drop at the peak 114 -> 85 mV. Gerber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
    [lite-main-B_Cu.gbl, lite-main-B_Mask.gbs, lite-main-B_Paste.gbp, lite-main-B_Silkscreen.gbo, lite-main-Edge_Cuts.gm1, lite-main-F_Cu.gtl, lite-main-F_Mask.gts, lite-main-F_Paste.gtp]
2026-10-30 Lite firmware confirms PVDD from PVDD_SENSE, and the check cross-checks firmware pins against the board
    * Lite firmware confirms PVDD from PVDD_SENSE (GPIO39) before the amp runs
    - hifi_board.h: ADC_PVDD = ADC1_CHANNEL_3 (GPIO39, U5 pad 5 on net
    PVDD_SENSE), PVDD/11 through R17 100k over R18 10k
    - the sequencer takes pvdd_v (NaN where a board has no sense): soft_start
    goes on only once PVDD reads >= 85 % of VBUS; still down 1 s after
    PVDD_EN, or under it for 50 ms while on, is the new no_pvdd state
    (everything off, retry after 1 s, three inside a minute hold it until
    POST /api/v1/amp reset or a re-plug)
    - power task reads PVDD, logs it on state changes; /api/v1/state power.pvdd_v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
    [C17168.json, C25798.json, C2856803.json]
2026-10-30 Ultra's enclosure prints without support: the three base faults fixed
    … the control pocket's roof sloped 45 degrees and open under the lid, the LCD window a slot closed by a lid tab (no mid-air roof, no sliver)
    [base.stl, enclosure.step, lid.stl]
2026-10-30 The boards will work on the first spin: independent engineering reviews of Lite and core, fixes and contingencies built…
    * First-spin review: the brief each domain reviewer works from
    * First-spin review: partial drafts saved before the reviewers' login d…
    …ropped
    * First-spin review: power, audio, digital and thermal reviews of lite-…
    …main and core, with their sims
    * core carries its EasyEDA CPL model cache, so its dfm gate runs withou…
    …t EasyEDA (red on 403 otherwise); DFM review
    * First-spin review: parts pin-to-pad audit of both boards
    * Lite board after the first-spin review: amp SDZ, PVDD switch hold-off…
    … and soft start, line-in headroom, 5 V loop, RCA sl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
    [BOM-full.csv, BOM.csv, C107671.json, C11133.json, C113998.json, C11702.json, C12074.json, C131972.json]
2026-10-30 No compiled Python in the repo: the tracked .pyc files go, so PRs stop conflicting on them
    * Stop tracking compiled Python: drop the 15 .pyc files under __pycache…
    …__/ and ignore *.py[co]
    …030-010051-36ff99b615
    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
2026-10-30 goals.md carries the person's 10-29 13:42 and 13:45 words: every tier done and working, with speakers in general
    * goals.md carries the person's 10-29 17:41-17:45Z words: every tier do…
    …ne and working, speakers in general
    …029-174217-353a48d416
    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
2026-10-30 Ultra front board (ultra-front) on main: fab package mated to the reworked core
    * ultra-front: hwde board through routed layout, verify and JLC DFM; FF…
    …C pinout, product.md and BOM estimate updated
    * ultra-front: fix LCD tail seating and keepouts from board review, re-…
    …route (GND as a net, edge keepout), docs and learnings
    * Merge main; ultra-front: J2 tail declared in placement.mates (waivers…
    … dropped), gates re-run on hive-hwde aa1ec48, FFC type-B cable and core CS note, BOM rows settled
    * ultra-front: record the lead's H1/H2/H4 approvals in state.json
    * Merge main into the ultra-front branch
    * ultra-front landed: docs and the enclosure stop calling it off-main;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
    [BOM-full.csv, BOM.csv, C14663.json, C15850.json, C19666.json, C20917.json, C21190.json, C22396388.json]
2026-10-30 The Plus/Ultra box breathes: ~1500 mm2 of low inlet, edge riser and high outlet, and Plus's R posts wire to zone B (J11)
    * The Plus/Ultra box breathes: ~1500 mm2 each of low inlet, edge riser …
    …and lid outlet; Plus's R posts wire to zone B (J11)
    core_box.vent_plan: low wall slots and floor slots beside the board, 7 mm
    riser strips past the board's S and E edges (Ultra: E 10 mm + behind its front
    board), a lid grille over both amps. Plus 1730/1565/1598 mm2, Ultra
    1516/1578/1736. check_thermal's box model: Plus air ~49 C at 5 W, 30 C room
    (was ~64 C). Ultra also passes hive-mech's new print checks (knob teardrop,
    45-degree pocket roof, LCD lintel on the lid).
    * Merge branch 'main' of /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
    [base.stl, btn_SW2.stl, btn_SW3.stl, enclosure.step, lid.stl]
2026-10-30 CI runs boards against current hwde, not a pinned aa1ec48
    * CI gates the boards with hive-hwde's current main, not a pinned aa1ec…
    …48 (#107)
    * Merge branch 'main' of /hive/run/main.bundle into ci-hwde-current
2026-10-30 Lite is order-ready under today's hwde: D1's TVS rated for a 21 V PD rail, then an order-time re-check and the person t…
    * Lite's VBUS TVS D1 holds the 21 V PD rail: SMBJ22A (22 V standoff) in…
    … place of SMBJ20A, fab and order files regenerated
    D1 BORN SMBJ22A C151920, same SMB footprint and pin 1 = K as the MDD SMBJ20A C364296.
    Fab BOM/CPL/prebuy and the Digi-Key/Mouser BOMs (stale since the 10-29 ECO) rebuilt
    under today's hwde; dfm gate PASS. Ledger: D1 rating verified from BORN's table.
    Known unknowns: power:10, thermal:30, parts:45 updated; --check --tier lite 0 open.
    * Lite README: cost at 100 after the SMBJ22A (+$0.01)
    * Merge remote-tracking branch 'origin/main' into hive/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
    [BOM-full.csv, BOM.csv, C151920.json, bom-alternates.csv, bom-estimate.csv, lite-main.kicad_pcb, lite-main.kicad_sch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]
2026-10-30 TPA3221 heatsink the person doesn't have to fit: a JLC-fittable board-mount part or a pad-down amp
    … and soft start, line-in headroom, 5 V loop, RCA slots, HRO USB-C and CH340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
    [BOM-full.csv, BOM.csv, C2879306.json, C83572.json, C99382.json, amp_a.kicad_sch, amp_b.kicad_sch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]
2026-10-30 The score's 0 means order-ready: open board-stopping facts count, and CI gates with the hwde the Hive runs
    * The score's 0 means order-ready: each open board-stopping fact costs …
    …100, and CI gates with the hwde tools/hwde.ref pins, bumped once every board passes under it
    * Merge main: CI follows hive-hwde main (#109), so tools/hwde.ref goes;…
    … the score's open facts and the hwde line stay
2026-10-30 core's open order-stoppers that need no new design: FFC J3 against ultra-front, the TOSLINK pinout and fit, the USB4085…
    * core U19 gets the TOSLINK T8BK's post holes; J1 USB4085, U19 pinout a…
    …nd J3 FFC checked against the makers' drawings and ultra-front
    * Merge main into task branch
    * resolutions.json: finish the merge with main (both sides' resolutions…
    … kept)
    * Merge main (TPA3220, +5V budget) into the U19 branch: main's core boa…
    …rd with U19's post holes re-applied by u19_posts.py, fab re-exported
    [core-B_Cu.gbl, core-B_Mask.gbs, core-B_Paste.gbp, core-B_Silkscreen.gbo, core-Edge_Cuts.gm1, core-F_Cu.gtl, core-F_Mask.gts, core-F_Paste.gtp]
2026-10-30 core carries its real 5 A VBUS/PVDD current in every layer's pour, and +5V's layer changes get two vias
    * core carries its real 5 A VBUS/PVDD current in every layer's pour, an…
    …d +5V's trunk layer changes get two vias
    Budgets at real currents (VBUS_IN/VBUS/PVDD 5 A, +5V 0.65 A); check_current
    passes with each layer's pour judged alone. In1/In2 to 1 oz; kicad/gen/power_trunk.py
    clears the GND stitch grid from the In2 power planes, reshapes their zones, moves
    three vias, gives each PVDD finger five plane vias and +5V's trunk two vias per
    layer change. Gerbers regenerated.
    * core: power_trunk's new stubs on the 45-degree grid (verify's route s…
    …tyle)
    * Merge main into 261030-0541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
    [core-B_Cu.gbl, core-B_Mask.gbs, core-B_Paste.gbp, core-B_Silkscreen.gbo, core-Edge_Cuts.gm1, core-F_Cu.gtl, core-F_Mask.gts, core-F_Paste.gtp]
2026-10-30 The score counts the banana outputs the person asked for: speaker terminals must be board-mounted 4 mm binding posts or…
    …puts must be board-mounted 4 mm binding posts or banana jacks, read from MPN and LCSC description only
    [test_hwcheck.py]
2026-10-30 Banana/binding-post speaker outputs mounted on the boards, fitted by JLC, with no hand wiring
    * Lite's speaker outputs are four board-mounted 4 mm banana sockets (Am…
    …ass 24.243, JLC-fitted): J4-J7 on a 118 mm wide board, L1-L4 2.2 mm toward U8, caps and taps re-placed, speaker copper re-routed
    * Lite's box takes the board's banana sockets through square holes in t…
    …he rear wall: no binding posts or wiring, 124 x 96 x 40 mm; heights for J1 and the sockets; docs, manual and BOM estimate follow
    * Merge branch 'main' of /hive/run/main.bundle into hive/w-261030-14010…
    …2-8c057eef45
    [BOM-full.csv, BOM.csv, C7437321.json, C7437322.json, base.stl, bom-estimate.csv, btn_SW1.stl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]
2026-10-30 Lite and core converge: review rounds against app notes, reference designs and known field issues until a round finds n…
    * Review round 2: the brief each reviewer works from (app notes, refere…
    …nce designs, field issues)
    * Review round 2: partial drafts (power, amp, audio, system, layout) an…
    …d their tests, saved before the session dropped
    * Review round 2: amp review (2 majors on core: bootstrap and PVDD HF c…
    …ap placement) and its tests
    * Review round 2: audio-chain review (3 majors: core VREF filtering, Li…
    …te sub-out power-loss thump, core DJ-direct subs silent) and its sims
    * Review round 2: power review (4 majors: core PVDD turn-on SOA regress…
    …ion,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
    [BOM-full.csv, BOM.csv, C107671.json, C11133.json, C113998.json, C11702.json, C12074.json, C131972.json]
2026-10-30 core firmware: line in through the ADC and DSP (subs play, governed DJ input), and Ultra's front board driven
    * core firmware: line in through the ES7243E and the DSP, DJ direct's s…
    …ubs and thermal guard, Ultra's front board driven
    Base: task 261030-151656's firmware commits (60d2c3f, 6db7273) and its review-3 checks.
    - I2S0 in 32-bit slots on core (DAC_CONFIG bits=32, patch): BCLK 64 fs, the least the
    ES7243E takes as MCLK (R3-AUDIO-3); ES7243E set up per Everest's driver (MCLK from BCLK, x8).
    - input 'line': the ADC through squeezelite's output as a source (volume, EQ, governor, subs).
    - DJ direct: subs fed from the ADC (inverted, C5) through a ~5 ms I2S1 queue; a guard
    (60 s i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
    [board_core.c, board_lite.c, fw_pinmap.py, hifi_api.c, hifi_api.h, hifi_board_core.h, hifi_bsp.h]
2026-10-30 hifi's score runs on the forge: a 'score' CI job using the KiCad and hwde CI already installs
    * hifi's score runs on the forge: a 'score' CI job on push to main, sha…
    …ring the test's KiCad and hwde setup through .github/actions/tools (issue #127)
    * score job runs on a dispatch too, so it can be tried on a branch
2026-10-31 The boards' 3D models sit on their footprints: Lite's USB-C and core's FFC fixed
    …e J3 and ultra-front J1 FFC offset 0.45 mm (hwde check_model_fit passes on all three)
    Lite J1 (HRO TYPE-C-31-M-12): EasyEDA model was 2.15 mm off, legs missing every hole;
    (offset (xyz 0 -2.15 0)) (rotate 180 kept) in the lib and the board.
    XUNPU FPC-05F-20PH20 on core J3 and its mate ultra-front J1: model 0.45 mm short;
    (offset (xyz 0 0.45 0)) in both libs and boards. Core gains its missing C0603 model.
    Lite's enclosure fit re-run: board read unchanged, 43/43.
    Task 261030-234316-17ac2c34e3, issue #129
    [core.kicad_pcb, lite-main.kicad_pcb, ultra-front.kicad_pcb]
2026-10-31 Revert: hifi's score runs on the forge: a 'score' CI job using the KiCad and hwde CI already installs
    …Cad and hwde CI already installs"
    This reverts commit e84b8eeeb4cdc0f8a762b59f6fad52cfb6be6020.
2026-10-31 core amp-area layout ECO: TPA3220 bootstrap and PVDD HF caps at their pins, input caps at the IN pins
    * core amp-area ECO (#121): TPA3220 PVDD HF pairs under the pins and BS…
    …T caps at the row ends (R3-AMP-1/2), U15's input caps at the IN pins (R3-LAYOUT-1); two-sided build, every gate passes
    * Merge remote-tracking branch 'origin/main' into hive/w-261030-215553-…
    …2ced984b7b
    * core amp ECO: drop j3_model.py (main's 56f192c sets the same J3 offset)
    [BOM-full.csv, BOM.csv, C282823.json, amp_a.kicad_sch, amp_b.kicad_sch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]
2026-10-31 hifi main is green on the forge again: test_pieces reads the Lite config from the patch that holds it, and the forge sc…
    * test_pieces reads the Lite config from the patch that holds it, not t…
    …he first the filesystem lists (the forge listed 0002 first)
    * Revert "Revert: hifi's score runs on the forge: a 'score' CI job usin…
    …g the KiCad and hwde CI already installs"
    This reverts commit 3dce4119e51f28c12d2b676f3b399ce96895ffab.
    * Keep the lesson from the score job's revert
    [test_pieces.py]
2026-10-31 Revert: core amp-area layout ECO: TPA3220 bootstrap and PVDD HF caps at their pins, input caps at the IN pins
    …at their pins, input caps at the IN pins"
    This reverts commit f0eb13530c5fd08d8df6501fd36629fa8401f02f.
    [BOM-full.csv, BOM.csv, C282823.json, amp_a.kicad_sch, amp_b.kicad_sch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]
2026-10-31 Revert "Revert: core amp-area layout ECO: TPA3220 bootstrap and PVDD HF caps at their pins, input caps at the IN pins"
    This reverts commit e383748a214686f7baf3875bd05f91347991511f.
    [BOM-full.csv, BOM.csv, C282823.json, amp_a.kicad_sch, amp_b.kicad_sch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]
2026-10-31 core's class-D outputs are damped with no speaker: the 4.7R snubbers get 470nF Zobel caps (#137)
    The 8 per-leg snubber caps C228/C231/C234/C237/C326/C329/C332/C335 go from
    1nF to 470nF/50V X7R 0603 (Yageo CC0603KRX7R9BB474, LCSC C513577). Same
    footprints: board_update changed only value and LCSC fields, no copper.
    Open-load peak +39.7 dB -> +15.8 dB (ngspice, docs/boards/sims/zobel_sweep.py);
    4/6/8 ohm responses move under 0.6 dB. Test tones refuse a sine above 5 kHz
    louder than -16 dBFS without force, so the 0603 resistors stay in rating.
    Lite checked the same way and left as it is (docs/boards/core-zobel.md).
    [amp_a.kicad_sch, amp_b.kicad_sch, core.kicad_pcb]
2026-10-31 core fab regenerated for the 470nF Zobel caps (#137): drc_routed, verify, dfm pass
    Gerbers change only in their timestamps; BOM/CPL/prebuy carry C513577.
    [BOM-full.csv, BOM.csv, C513577.json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]
2026-10-31 core: ESD clamps at the USB-C CC pins and both RCA jacks; speaker and Ethernet lines exempt with reasons (#133)
    D6/D9 (NUP2105L) on CC1/CC2, D7/D8 (PESD5V0S2BT) on sub out and line in,
    all on B.Cu at their connectors with their own ground vias. KiCad DRC with
    schematic parity is clean; check_esd has 0 errors and 4 warnings, judged in
    docs/boards/core-esd.md.
    [core.kicad_pcb, dac.kicad_sch, linein.kicad_sch, power_in.kicad_sch]
2026-10-31 core fab regenerated for the ESD clamps (#133): drc_routed and dfm pass; D6-D9 bottom-side waivers
    [BOM-full.csv, BOM.csv, C14486.json, C49338.json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]
2026-10-31 core ESD routes back on the 45-degree grid (verify's check_route_style); fab regenerated
    [core-B_Cu.gbl, core-B_Mask.gbs, core-B_Paste.gbp, core-B_Silkscreen.gbo, core-Edge_Cuts.gm1, core-F_Cu.gtl, core-F_Mask.gts, core-F_Paste.gtp]
2026-10-31 lite-main: ESD clamps at the USB-C, line-in and sub-out; speaker posts exempt with reasons (#133)
    D3/D4 NUP2105L on CC2/CC1, U10 USBLC6-2SC6 on D+/D-, D5/D6 PESD5V0S2BT on
    the two RCA jacks, all on B.Cu by their connectors (kicad/gen/esd_eco.py).
    The USB pair's first 2-3 mm under J1 is redone so CC2 and the clamps can
    reach the pins. Fab regenerated; DRC with parity clean; dfm passes with
    bottom-side waivers.
    [BOM-full.csv, BOM.csv, C14486.json, C2687116.json, C49338.json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]
2026-10-31 docs: Lite ESD clamps (#133): lite-esd.md, README part counts
2026-10-31 lite-main ESD: top-side only (the person: Lite stays cheap); L1-L4 attr fix
    Replaces the bottom-side clamps. Six PESDNC2FD5VB (C110694, DFN1006) on F.Cu:
    D3/D4 at line-in J2, D5/D6 at sub-out J3, D7/D8 on USB D+/D- left of J1.
    CC1/CC2 exempt: no top-side spot ahead of the CH224A, 2 mm from J1.
    L1-L4 XR0850 (attr through_hole -> smd) via fpfix, board and lib, so
    bom-cpl keeps them on the SMT line (hive-hwde #415 check_fp_attr).
    check_esd 0 errors / 2 warnings (USB_DM: 2 vias, 13.8 mm); DRC with parity
    0/0/0; fab regenerated with no Bottom CPL rows; hwcheck test passes.
    [BOM-full.csv, BOM.csv, C110694.json, C14486.json, C2687116.json, C49338.json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]
2026-10-31 Lite README: 20 V contract caps Lite at 60-65 W whatever the charger (#136); review round 4 brief
2026-10-31 Review round 4, ultra-front: knob turned the volume backwards (R5-UF-1) fixed; LCD SPI 16 MHz (R5-UF-3); ENIG for ultra-front (R5-UF-6); backlight is on/off (R5-UF-4)
    Alps EC11E: A leads clockwise; the decoder counts + when its enc_b leads, so
    board_core.c feeds Alps A in as enc_b. test_core.c now models the Alps
    waveform; docs/review-5/sims/uf/enc_rev.c passes.
    [board_core.c, gen.py, netlib.py]
2026-11-01 WIP core banana: schematic, parts, stage-1 ECO, sockets placed
    [C7437321.json, C7437322.json, amp_a.kicad_sch, amp_b.kicad_sch, core.kicad_pcb]
2026-11-01 Review round 4 firmware: DJ direct hands over on the charger contract in 20 ms (R5-PA-2, R5-DAL-4); OTW step-down needs 200 ms held (R5-DAL-5)
2026-11-01 FFC cable: 50 mm type B named in the order docs, type A's failure spelled out (R5-UF-5)
    [bom-estimate.csv]
2026-11-01 ultra-front: ESD clamps at the switches (R5-UF-2)
    D2/D3 PESD5V0S2BT (C49338, as on core): D2 on BTN2/BTN1 between SW1 and
    SW2, D3 on BTN3/ENC_SW between SW2 and SW3, each GND pin on its own via.
    Schematic generator, parts, PCB (board_update + kicad/gen/esd_eco.py), fab
    regenerated, README, bom-estimate and product.md totals updated.
    docs/boards/ultra-front-esd.md has the layout reasoning.
    [BOM-full.csv, BOM.csv, C49338.json, bom-estimate.csv, prebuy.csv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]
2026-11-01 WIP core banana: speaker pours as one staircase polygon per net, In2 pin links, C4/C8 (R5-PA-1), DAL-7, stubs ripped
    [core.kicad_pcb, power_in.kicad_sch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]
2026-11-01 lite-main: EP paste windows off the vias (U1, U7), U8 thermal-via ring 0.20 mm
    hive-hwde 9ad982e flags vias under exposed-pad paste (check_ep_paste) and
    PTH annular rings under JLC's 0.18 mm (dfm). U1 pad 11 and U7 pad 29 drop
    their own paste for four window-pane apertures each, clear of the GND vias
    (as U8 already does). U8's 16 thermal-via pads go from 0.61 to 0.70 mm on
    the 0.30 mm drill. Board (kicad/gen/ep_paste.py) and lib both, fab
    regenerated (BOM/CPL unchanged). DRC with parity clean.
    [lite-main-B_Cu.gbl, lite-main-B_Mask.gbs, lite-main-B_Paste.gbp, lite-main-B_Silkscreen.gbo, lite-main-Edge_Cuts.gm1, lite-main-F_Cu.gtl, lite-main-F_Mask.gts, lite-main-F_Paste.gtp]
2026-11-01 WIP core banana: all nets routed (RCA/TOSLINK relayed, snubbers rehooked), EP paste windows (U9/U10), LCSC fields from parts.json
    [core.kicad_pcb]
2026-11-01 core banana: DRC clean (0 violations, parity clean): socket silk off, U13 EP paste windows, stale stubs ripped
    [core.kicad_pcb]
2026-11-01 core banana: docs (README, manual, product, bom-estimate), enclosure banana holes
    [bom-estimate.csv]
2026-11-01 core banana: fab regenerated (Plus and Ultra), drc_routed and dfm pass; LIN_R end at D8 tidied (dfm inner-layer gap)
    [BOM-full.csv, BOM.csv, C344195.json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]
2026-11-01 core banana: constraints (edge/fixed refs J20-J27, enclosure box numbers), anchors note, README counts
2026-11-01 enclosures for the banana core: Plus 46/46 and Ultra 56/56 fit, banana holes in the rear wall, README
    [base.stl, enclosure.step, lid.stl]
2026-11-01 enclosure README: board reference
2026-11-01 restore enclosure/out/lite/slice.json (deleted by mistake)
2026-11-01 core banana: route ends back on the 45-degree grid (check_route_style)
    [core.kicad_pcb]
2026-11-01 core banana: fab regenerated
    [core-B_Cu.gbl, core-B_Mask.gbs, core-B_Paste.gbp, core-B_Silkscreen.gbo, core-Edge_Cuts.gm1, core-F_Cu.gtl, core-F_Mask.gts, core-F_Paste.gtp]
2026-11-01 product: record person's acceptance of the Plus cost (38.63 at 100)
    Person signed off the banana-socket core's Plus overrun (thread
    hifi-core-banana). Tiers may carry accepted {cost, by, at, why};
    hwcheck score counts only cost above accepted.cost.
2026-11-01 core ORDERING: 1 oz inner copper on the quote page, U16 on Plus too, socket orientation (R6-M1, R6-m1)
2026-11-01 core pre-order fixes: filled and capped vias, LIN_L off DOUT, socket clearance, C229's path (review 6)
    POFV in the board setup and ORDERING.md, with an order remark that keeps J1's 0.4 mm pin holes open.
    LIN_L re-routed: worst I2S crosstalk 110 mV -> 2.96 mV simulated (budget 33 mV).
    0.3 mm GND pour clearance at J20-J27; C229 gets a via into the A L+ column.
    C5/C6 judged: 62 % of rating governed, 118 % only for seconds in DJ direct; part kept.
    Fab regenerated for Plus and Ultra. docs/review-6/fixes.md has the numbers.
    [CPL.csv, core-B_Cu.gbl, core-B_Mask.gbs, core-B_Paste.gbp, core-B_Silkscreen.gbo, core-Edge_Cuts.gm1, core-F_Cu.gtl, core-F_Mask.gts]
2026-11-01 lite-main pre-order round: vias off pads, I2S respaced, VBUS stubs, box hole axis
    check_wicking 15 -> 0; I2S crosstalk now inside the noise margin; VBUS out of J1
    widened; banana holes use the part's x in every box (R6-M2); the stale
    architecture/constraints.json is gone. See docs/boards/lite-preorder.md.
    [base.stl, enclosure.step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]
2026-11-01 core: C229's B.Cu stub on the 45-degree grid (verify's check_route_style); fab regenerated
    [core-B_Cu.gbl, core-B_Mask.gbs, core-B_Paste.gbp, core-B_Silkscreen.gbo, core-Edge_Cuts.gm1, core-F_Cu.gtl, core-F_Mask.gts, core-F_Paste.gtp]
2026-11-01 lite-main: keep the second +5V vias at L5 and C25, off the pads
    check_current needs 2 vias at both layer changes (0.8 A).
    [lite-main-B_Cu.gbl, lite-main-B_Mask.gbs, lite-main-B_Paste.gbp, lite-main-B_Silkscreen.gbo, lite-main-Edge_Cuts.gm1, lite-main-F_Cu.gtl, lite-main-F_Mask.gts, lite-main-F_Paste.gtp]
2026-11-01 lite-main: put the new stubs on the 45-degree grid (check_route_style)
    [lite-main-B_Cu.gbl, lite-main-B_Mask.gbs, lite-main-B_Paste.gbp, lite-main-B_Silkscreen.gbo, lite-main-Edge_Cuts.gm1, lite-main-F_Cu.gtl, lite-main-F_Mask.gts, lite-main-F_Paste.gtp]
2026-11-01 core: RCA jacks clear their side ears: J4, J5, U19 move along the rear edge, H2 south; courtyard holds the ear
    J4 ran 2.0 mm into J27 and J5 about 0.4 mm into J4 at ear height. clash.py now finds none.
    LIN_L, LIN_R and OPT_SPDIF re-routed; fab regenerated for Plus and Ultra. docs/review-6/fixes.md has the numbers.
    [CPL.csv, core-B_Cu.gbl, core-B_Mask.gbs, core-B_Paste.gbp, core-B_Silkscreen.gbo, core-Edge_Cuts.gm1, core-F_Cu.gtl, core-F_Mask.gts]
2026-11-01 core: jack courtyard holds the flange and ear in full; J5 x 166.3, U19 x 180.5, FB3/C126 alongside
    check_body_clash had J5 and U19 0.1 mm apart, and J4/J5 0.85 mm past their courtyards. Both gone now.
    [CPL.csv, core-B_Cu.gbl, core-B_Mask.gbs, core-B_Paste.gbp, core-B_Silkscreen.gbo, core-Edge_Cuts.gm1, core-F_Cu.gtl, core-F_Mask.gts]
2026-11-01 review-6 fixes: GND via count
2026-11-01 Plus/Ultra box follows core's RCA ear move: rear holes at J4/J5, U19's opening, H2's standoff and pillar
    core.board.json re-read from ea029b9; plus 46/46, ultra 56/56 fit checks. Hole centres fitted from the STLs match the board.
    [base.stl, enclosure.step, lid.stl]
2026-11-01 lite-main and ultra-front keep their .wrl models so check_body_clash can judge them; banana socket numbers from Multicomp's 24.243 sheet
    Models come from lib_pull on scratch copies (no footprint, board or fab change). C58, C59, U1, U7, U8, Q1, D3-D8, L5, L6 and front J2, D1 are judged now.
    README: round collar, axis 8.1, what a too-wide body stops. Same stale square-hole text fixed in docs/boards/lite-main.md and enclosure/README.md.
2026-11-02 Core's open facts: FFC land pattern, EC11 tabs and U19 rotation closed from makers' drawings; stale 5 A note removed
    dfm:24 against XunPu's FPC-05F-NPH20 drawing, parts:57 against Alps' EC11E drawing, dfm:33 by the footprint's asymmetry. The power note still said the 5 A budgets failed and stayed at 0.5 A, and the README gave +5V as 0.65 A; neither is true of the board. No copper or fab change.
2026-11-02 hwcheck: fw constraints, ESP-IDF build and QEMU boot per tier (#84, #141)
    When firmware/ or a netlist changed, on main, or with --all: fw constraints
    then fw check-all for hifi-lite, -plus, -ultra. No fw, ESP-IDF or QEMU exits
    127 (couldn't run), never a pass. CI has none of them, so it sets
    HWCHECK_FW=skip and its log says the part did not run.
    [hwcheck.py, test_hwcheck.py]
2026-11-03 core: CPL from current hwde (D8, D9 turned 180), check_kelvin waived with a bring-up gain
    hwde 0368846 gets bottom-side rotation right: the old CPL had clamps D8 and
    D9 wrong_rotation in cpl_verify. Regenerated Plus and Ultra CPL: D8, D9 and
    four non-polar MLCCs turn 180; J4, J5 Mid Y move 0.79 mm to offset 0 on their
    pads. BOM and Gerbers unchanged. The 14 cpl_no_model waivers are gone and dfm
    passes without them.
    U3 reads R1 about 5.6% high. It errs on the safe side, a bring-up gain removes
    it, and moving the taps would change the Gerbers: waived, recorded.
    [CPL.csv]
2026-11-03 hwcheck: main itself gates every board despite stray files; CI gates main daily
    Main's test job gated none: .ci/ and build output counted as changes, so
    "nothing differs" never held and core's check_kelvin failure stayed hidden.
    hwde isn't pinned, so a daily run catches a new gate with no push here.
    [hwcheck.py, test_hwcheck.py]
2026-11-03 core: C43 reaches U9.19 under ETH_TXN (decoupler_copper); Gerbers regenerated
    hwde #668 failed verify on C43 to U9 pin 19 (LAN8720A VDD1A): 20.3 mm of
    +3V3E copper, out through J2.4 and back, against a 15 mm error limit. The walk
    was real, so this fixes the copper rather than setting max_copper_mm: two
    0.6/0.3 mm vias and 1.8 mm of B.Cu under ETH_TXN. The walk is now 6.55 mm.
    Changes the Gerbers and core_gerbers.zip. Parts, BOM and CPL are unchanged.
    [core-B_Cu.gbl, core-B_Mask.gbs, core-B_Paste.gbp, core-B_Silkscreen.gbo, core-Edge_Cuts.gm1, core-F_Cu.gtl, core-F_Mask.gts, core-F_Paste.gtp]
2026-11-04 core: explain the C53 and C55 decoupling warnings on U10
    C53 is a fifth cap on the strapped AVCC_L/AVCC_R/VCCA group, which
    C50, C51, C52 and C54 already reach inside 10 mm. C55's loop to DVCC
    is 11.3 nH against 10 nH; the regulator output has its own 4.7 uF.
2026-11-04 docs: bring-up plan for the Ultra front board
    Bench steps with no core (resistance checks, current-limited power through
    a J1 breakout, the backlight current), then steps on an Ultra core (front_i2c,
    buttons and knob, LED, IR, LCD), the open items to measure, and the firmware
    gaps. Values come from the netlist, BOM, README and firmware. Estimates are
    marked as estimates. Nothing has been on hardware.
2026-11-04 docs: bring-up plan for lite-main
    Step-by-step bring-up for a freshly assembled Lite board: unpowered
    resistances, current-limited first power, flash and console, PD and the
    PVDD soft start, codec, amp into dummy loads, extras, and the open items
    the README and known-unknowns leave for bring-up. Values come from the
    netlist, firmware and known-unknowns; estimates are marked. Nothing has
    been on hardware.
2026-11-04 Add core (Plus/Ultra) board bring-up plan
    docs/bringup/core.md: no-power checks, current-limited first power,
    rails in order, ESP32 flash and console, each block (PD/PVDD, INA186,
    DAC/ADC, amps into dummy loads, Ethernet/Wi-Fi, IR/buttons), the open
    items, a firmware-gap list and a record sheet. Values come from the
    netlist, reviews and datasheets; estimates are marked. Not run on
    hardware.
2026-11-04 Add pre-order simulations for lite-main, core and ultra-front
    docs/sims.md: one table per board (power switch, rails, thermal estimates,
    amp output filter stability, SI/PI, ultra-front power), each row with deck,
    numbers, limit, margin and pass/fail. Decks under docs/sims/ assert their
    values against the current netlists. No copper, schematic or fab change.
    [gen.py, netlib.py]
2026-11-04 bench: bring-up stage 1 passes on a correct core at 5 V
    The bench read state.pd.{source,contract_v}, the mock's old shape; the
    firmware writes state.power.contract. run.supply() reads both, and
    selftest and sweep use it.
    On a laptop port the items that need a contract (pd_contract, pvdd_on,
    pvdd_sensed, amp_no_fault) are marked expected, and network too before
    --wifi (stage 1 sets it after the self-test). The amp-refused check no
    longer needs a 403/409: the firmware answers 200 and its sequencer keeps
    PVDD off, so the bench reads state for 0.5 s and passes if PVDD and the
    amp stay off.
    The checklist's controls item is the model's own (run.streaming): Lite's
    buttons, Plus's knob and two but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
    [cli.py, run.py]
2026-11-04 lite-main CPL: J2/J3 placement offset after hwde 7f65e45 (fab, CPL only)
    Fab change, CPL only. No copper, Gerbers, BOM or prebuy change.
    hwde 7f65e45 (2026-11-02) now takes the placement offset from pads that
    match, instead of a mean over split thermal pads. Under current hwde,
    cpl_verify puts the committed J2/J3 (RCA jack) rows 0.793 mm off; the
    regenerated rows are 0.0 mm off. Y goes from -74.7297 to -75.5230,
    which is the footprint position.
    Also:
    - The distributor BOMs are renamed to the PCB-stem names the report
    now points at. Their content is byte-identical.
    - reports/bom-cpl.json and the ledger are refreshed at build qty 10,
    the same qty as the committed prebuy. Status pass, no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
    [lite-main_BOM_digikey.csv, lite-main_BOM_mouser.csv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]
2026-11-04 bringup: bench gates for the SI sim findings (docs only)
    - core 6.8: PVDD spike at U15/U16 pins, peak <= 35 V (R5-PA-3), fallback
    20 V contract.
    - core 6.9: ETH_CLK edge at U9 pin 5 (CLKIN) slower than 1.45 ns, ring-back
    under 0.8 V.
    - lite 9.9: U8 PVDD spike, peak <= 27 V at 20 V into 4 ohm; fallback 15 V
    (R1 strap or a new CH224A request write; Lite firmware doesn't request
    a voltage today).
    From docs/sims.md (PR 164). No copper, fab or firmware change.
2026-11-04 Ultra LCD SPI at 13.33 MHz; backlight's first minute by the clock; docs match
    The ST7789's write cycle is at least 66 ns and the ultra-front README sets
    15 MHz as the limit; sdkconfig had 16 MHz and firmware.md said 20 MHz.
    80 MHz / 6 = 13.33 MHz (75 ns). The backlight's after-boot hold was a loop
    count (tick < 6000: up to 60 s at the 10 ms poll, less when INT fires); it
    is now now < FRONT_DIM_MS, the first minute, as firmware.md says.
2026-11-04 core: I2S BCK, LRCK and sub DOUT at drive cap 1 (R5-DAL-N1)
    BCK is unterminated over 61.9 mm to three loads, and review-5's 33R
    series resistor never reached the board. At the default drive the i2sbck
    benches put the overshoot at 3.89 V, 0.01 V under the 3.9 V warning.
    CAP_1 (~10 mA, modelled as 60 ohm) gives 3.31 V with clean edges.
    CAP_0 was checked and rejected because its first step stalls in the
    threshold band. This adds the two CAP_1 benches.
    [board_core.c, gen.py]
2026-11-04 Console tools: hifi i2c, led test, Ultra backlight, controls in state
    - hifi i2c <addr> <reg> [val] (console only) reads or writes one register
    on the shared bus; writes are refused while a tone or source plays,
    audio runs or the amps are on.
    - hifi led test|auto, POST /api/v1/led: 30 s LED test on Plus/Ultra
    (Ultra's front LED steps R, G, B, white); 404 on Lite (squeezelite's).
    - hifi backlight on|off|auto, POST /api/v1/backlight: Ultra only.
    - state.controls: core expander inputs, Ultra front port 0, the last
    button, knob step or remote action and its age, the backlight mode.
    - Bring-up docs: core G4/G7, ultra-front gaps 1-4 and lite-main gaps 2-3
    closed, steps use the new comman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
2026-11-04 docs: record the 2026-11-04 hand checks, and fix the Lite PD fallback
    Hand checks (check_esd, check_body_clash, 3D clash) on main 5b7f956 found
    no errors. The new warnings are now accepted, with the reasons written down:
    - core-esd.md: ISNS_P beside the D+ stretch. It sits at VBUS, and the
    INA186's IN+ is rated for a 40 V common mode.
    - lite-esd.md: 8 corridor warnings. CC1/CC2 are covered by the existing CC
    exemption. The rest see a pulse about 0.8 ns long, around 1 nC against
    the ESP32's 200 nC HBM rating.
    - Both READMEs: the banana sockets 0.20 mm apart, the IR receivers and the
    WROVER antenna standing past the edge on purpose, core U3's broken 3D
    model path (3D only), and Lite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
2026-11-04 hifi: valueless HIFI_HAS_* flags so the pinmap check doesn't read them as GPIOs
    [hifi_board_core.h]
2026-11-04 Fix stale docs and comments against netlist/BOM (lite and core)
    [hifi_board_lite.h]
2026-11-04 docs: order readiness per board (lite-main, core, ultra-front)
    Gates, fab pack, sims, decisions, the three Opus reviews with every
    finding dispositioned, hand checks, firmware (QEMU/host only), bring-up
    plans, and one readiness table per board with what needs the person.
    Docs only; no copper or fab change.
2026-11-04 core: fix U3 3D model path (SC-70-6 wrl existed under a different name); 3D only
    [core.kicad_pcb]
2026-11-05 lite: add JLC-fitted spare header J8 and 5 more GND stitching vias (#173)
    J8 is an 8-pin SMD header (C2883765) with UART0, I2C, GPIO5, GPIO15, 3V3
    and GND, so a Lite whose audio side fails still works as an ESP32 board.
    C5160791 was the first choice but shows quantity 0 in JLC's BOM step.
    Pinout and limits: docs/boards/lite-header.md. Fab files regenerated for
    10 boards; they match the Lite item in the JLC cart.
    [BOM-full.csv, BOM.csv, C2883765.json, enclosure.step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]
2026-11-05 lite box: keep the case off the antenna, slice for the A1 mini, plan the build film
    Box: 1.2 mm wall beside the ESP32 module, no lid lip there, and the build fails
    if a part enters the antenna zone. The zone follows U5.
    Print files: two 3MF plates sliced in PETG for the A1 mini, replacing the stale
    PrusaSlicer slice.json. The button note had the wrong height.
    Plan: docs/lite-build-replay-plan.md, not rendered yet.
    [base.stl, enclosure.step, lid.stl, lite-base.3mf, lite-lid-buttons.3mf]
2026-11-05 test_pieces: the stub-box test leaves the new print-files folder alone
2026-11-05 lite-main: clear the antenna side bands, ease I2S crosstalk, OSP finish
    Antenna: ANT_KEEPOUT now runs from 15 mm above the antenna to the bottom
    edge, and H4 is a bare NPTH in the same place, so check_antenna no longer
    warns (was 2.2 mm). keepout.py read NPTH pads after b.Remove(zone), which
    breaks on KiCad 10; it now reads them first.
    I2S: DOUT and LRCK pulled apart on F.Cu at the ESP32 end. LRCK -> DOUT
    344 to 310 mV, under the 396 mV margin and still over the 165 mV budget.
    Finish: OSP in the board file, Gerber job, README and stackup.
    [lite-main-B_Cu.gbl, lite-main-B_Mask.gbs, lite-main-B_Paste.gbp, lite-main-B_Silkscreen.gbo, lite-main-Edge_Cuts.gm1, lite-main-F_Cu.gtl, lite-main-F_Mask.gts, lite-main-F_Paste.gtp]
2026-11-05 lite-main: full GND stitching pass (130 to 403 vias)
    Ran stitch_vias at the auto pitch (4.28 mm) on top of #176 and re-exported
    the fab package. No via lands in a keep-out. Added `sh build.sh stitch`.
    [lite-main-B_Cu.gbl, lite-main-B_Mask.gbs, lite-main-B_Paste.gbp, lite-main-B_Silkscreen.gbo, lite-main-Edge_Cuts.gm1, lite-main-F_Cu.gtl, lite-main-F_Mask.gts, lite-main-F_Paste.gtp]
2026-11-05 core: full GND stitching pass (385 to 657 vias)
    Ran stitch_vias at the auto pitch (4.28 mm) and re-exported the fab package.
    Six of the 278 planned vias pinched the 5 A pours on In2.Cu, so
    kicad/gen/stitch_necks.py dropped them. DRC, verify and DFM pass.
    BOM and CPL are unchanged.
    [core-B_Cu.gbl, core-B_Mask.gbs, core-B_Paste.gbp, core-B_Silkscreen.gbo, core-Edge_Cuts.gm1, core-F_Cu.gtl, core-F_Mask.gts, core-F_Paste.gtp]
2026-11-08 Drop the 9 stand-in scripts hwde now replaces
    hwde's own commands do these jobs now (hive-hwde #848 #849 #860):
    - core pad_zone_full.py, lite-main j1_shell_solid.py: place_edit set_pad zone_connection
    - core silk_clean.py, silk_edge.py, silk_clear.py, lite-main silk_clear.py:
    silk_fix and place_edit silk_clear (over_pads, near_edge)
    - core via_array.py, patch_outline.py, drop_patch.py: zone_patch
    Checked on copies of main's boards: each job redone with the hwde command
    gives back the same zone fills and the same DRC counts.
2026-11-08 lite-main: waive J1's 20 V rating at the 21 V PD tolerance (#181)
    hwde #836 gave check_ratings the HRO TYPE-C-31-M-12 drawing (VOLTAGE
    RATING 20V), and VBUS is 21 V (20 V PD +5 %), so lite-main verify
    failed. Keep the part and the 20 V contract: the rating is the standard
    Type-C class for 20 V PD; 15 V costs amp power and a 48 V receptacle is
    a copper change. No copper or fab change.
    Closes #181
